GuillermoAladro/Alcoholimetro/historico/README.md

# Histórico

Documentos que ya no mandan. Se conservan porque tienen detalle que todavía sirve (hojas de datos leídas, respuestas a las auditorías, pruebas de banco) y porque otros documentos los citan.

| Documento | Qué era | Qué manda ahora |
|---|---|---|
| [MONTAJE-GENERAL.md](MONTAJE-GENERAL.md) | Cableado del diseño del 20-10-2026, con las figuras de [`montaje-general/`](../montaje-general/) | [CABLEADO.md](../CABLEADO.md) |
| [MONTAJE-PASO-A-PASO.md](MONTAJE-PASO-A-PASO.md) | Montaje por fases y pruebas de banco del diseño del 20-10-2026 | [CABLEADO.md](../CABLEADO.md) y la [revisión de componentes](../componentes/REVISION-13-11-2026.md), apartado 9. Sus pruebas siguen de referencia hasta que se rehaga sobre el diseño A |
| [LISTA-DE-COMPRA-20-10-2026.md](LISTA-DE-COMPRA-20-10-2026.md) | Lista de compra del diseño del 20-10-2026 | [LISTA-DE-COMPRA.md](../LISTA-DE-COMPRA.md) |

Movidos aquí el 13-11-2026 ([DECISIONES](../DECISIONES.md)).
