GuillermoAladro/Alcoholimetro/Animaciones 2D/revision/00032.2-revision.md

# 00032.2 · La guindilla

En los dos primeros mordiscos de Ander y en el último crujido, el tamaño de la guindilla y la posición de su mano cambian progresivamente. El rabito conserva la inclinación al quedar en el plato. Guillermo puede enseñar su guindilla y llevársela entera a la boca sin que se desprenda la mano del antebrazo.

El vaso de leche se ve desde el principio, delante de la manga de Ander. Se desliza por el borde delantero de la mesa, por delante del plato. La mano lo acelera y lo suelta sin el salto hacia atrás de unos 18 píxeles que se producía en el original. El vaso sigue con la velocidad que llevaba y se frena al llegar a Guillermo.

El pico de la jarra y el borde del vaso se apoyan en el labio. En el último trago de agua Guillermo inclina la cabeza para alcanzar el pico. Al devolver el vaso, acompaña el brazo con el torso y mantiene los pies apoyados. La secuencia de color de la cara, la llamarada, el bigote de leche y el último mordisco conservan el orden del guion. Se revisaron las poses con los dos avatares originales.

Las comprobaciones cubren 1.753 poses a 120 Hz, siete cambios de apoyo, los volúmenes de ambas bebidas y el giro de muñeca durante el trago. La vista previa tiene 876 fotogramas a 60 fps, en 1024 × 600, durante 14,6 segundos. Se probaron el rebobinado, las cadencias de reproducción, los extremos negros y la decodificación del MP4 completo. La reproducción se verificó en Canvas/Skia de Node. Quedan por probar los controles HTML en navegador y la Raspberry Pi física.
