GuillermoAladro/Alcoholimetro/carcasa/diseno-A/modelo/visor_plantilla.html

# Alcoholímetro · cajón de componentes

3D Frente Lado Arriba Detrás

## Mover

Sacar todoCerrar todo

Sacar cajón de pajitas ←0 mm

Abrir tapacerrada

Sacar tapa interior →puesta

Subir cajón de componentes ↑0 mm

## Transparencia

Carcasa transparente0 %

Cajón transparente0 %

Para sacar el cajón de componentes: se desenchufa, se abre la tapa, se saca la tapa interior deslizándola hacia la derecha por su ranura y se sueltan el puente de tierra y la antena. Para sacar el de pajitas se quitan antes los dos candados.

## Ver

Componentes eléctricos Cables y tubos Números de pieza Mostrar todo

Toca una pieza en el 3D o en la lista para ver su número, medidas, material y archivo de fabricación.
