GuillermoAladro/Alcoholimetro/carcasa/diseno-A/estudio-termico/Estudio_termico_alcoholimetro.pdf

ALCOHOLÍMETRO · DISEÑO A (COMPACTA) · REVISIÓN 2 · 13- 1 1 -2026

# Estudio térmico con el myPOS Sigma

## Qué cambia en el calor de la máquina al sustituir el SumUp Solo por un terminal de cobro para máquinas y pasar a una

fuente de 12 V.

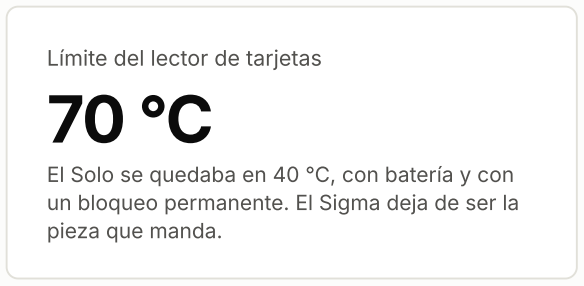
[picture p2: figure]
Límite del lector de tarjetas 70 °C; pieza que manda.

El Solo se quedaba en 40 °C, con batería y con un bloqueo permanente. El Sigma deja de ser la

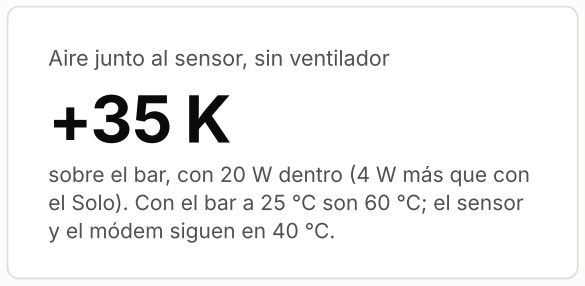
[picture p3: figure]
Aire junto al sensor, sin ventilador +35 K; y el módem siguen en 40 °C.

sobre el bar, con 20 W dentro (4 W más que con el Solo). Con el bar a 25 °C son 60 °C; el sensor

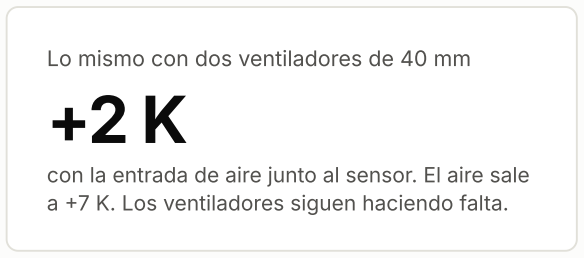
[picture p4: figure]
Lo mismo con dos ventiladores de 40 mm +2 K

con la entrada de aire junto al sensor. El aire sale a +7 K. Los ventiladores siguen haciendo falta.

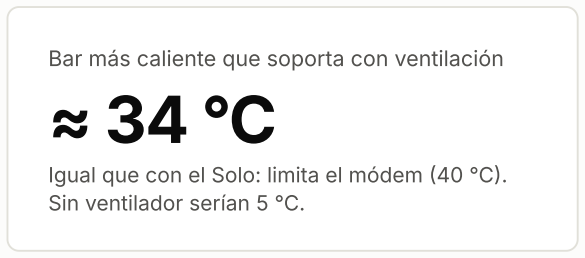
[picture p5: figure]
Sin ventilador serían 5 °C.

Bar más caliente que soporta con ventilación

Igual que con el Solo: limita el módem (40 °C).

Preparado para Guillermo Aladro Abad · cálculo de Claude sobre el CAD del 04-11-2026, las cargas de la revisión de componentes y la opción 3 del estudio de cobro (13-11-2026).
Todo es cálculo: no hay nada montado ni medido. El consumo del Sigma no está publicado y va estimado. Sustituye a la revisión 1 (con el Solo), que se conserva en historico-solo/.

Estudio térmico del alcoholímetro · diseño A · revisión 2 (myPOS Sigma) · 13-11-2026 | 2 / 35

# Resumen

Lectura que he tomado del encargo: rehacer el estudio térmico con lo que hablamos por voz, es decir, con el myPOS Sigma (la opción 3 del estudio de cobro) en lugar del SumUp Solo y con una fuente de 12 V. Como caso base pongo el Sigma en un hueco del frente, arriba a la derecha, una Mean Well LRS-50-12 en el sitio de la LRS-50-5 y un convertidor de 12 a 5 V para todo lo demás. El resto del diseño es el del CAD del 04-11-2026.

### Lo que sale del estudio

1. El Sigma quita de en medio la pieza más frágil. Trabaja de −20 a 70 °C, no lleva batería y no tiene el bloqueo permanente del Solo hoja . En ningún caso de este estudio se sale de su ficha.
2. Pero la máquina no se enfría: se calienta más. Pasa de 15,7 a 20 W. El Sigma es un terminal Android con pantalla propia y gasta unos 3 W estimación , frente a 1 W del Solo; y convertir de 12 a 5 V cuesta otros 2 W. En el mejor de los casos, con un Sigma de 1,5 W y la fuente que menos pierde, serían 16 W: lo mismo que con el Solo, no menos.
3. Dentro siguen dos piezas de 40 °C: el sensor y el módem. El sensor está arriba, a la misma altura que estaba el Solo. Sin ventilador, el aire a su lado queda a +35 K sobre el bar (entre +30 y +40 K en el 80 % de los casos); con el Solo eran +31 K.
4. Corrijo dos cosas que te adelanté por voz sin hacer la cuenta. Dije que el calor total apenas cambiaría y que, sin ventilación, el bar máximo subiría de 8 a unos 12 °C. Hecho el cálculo, el calor sube 4 W y el bar máximo sin ventilación baja de 8 a 5 °C. En el mejor caso serían 9 °C: prácticamente igual.
5. Los dos ventiladores de 40 mm siguen siendo imprescindibles, y siguen bastando. Con unos 5 m³/h reales el aire sale a +7,5 K (con el Solo, +6,3 K). El sensor ve +2 K y el módem +5 K. La máquina soporta bares de hasta unos 34 °C, lo mismo que con el Solo.
6. La entrada de aire cambia de sitio. Con el Solo iba arriba a la derecha, junto a él. Ahora el aire fresco hay que dárselo al sensor y al módem: entrada arriba a la izquierda, junto al sensor (apartado 8.3). El Sigma queda en la zona templada y le sobra margen.
7. Si la ventilación se para, el aire junto al sensor pasa de 40 °C en unos 9 minutos (bar a 25 °C) y se estabiliza en 59 °C. La diferencia es qué se pierde: con el Solo, un lector bloqueado para siempre; con el Sigma, nada irreversible. El sensor sale de su rango y la máquina debe dejar de vender pruebas hasta que baje.
8. La fuente se puede resolver de cuatro maneras y entre ellas hay menos de 2 W. La que menos calienta es dejar la LRS-50-5 como está y añadir una fuente pequeña de 12 V solo para el Sigma: 18,2 W en vez de
20,0 (apartado 3.2).
9. En el frente de hoy el Sigma no cabe de pie. Su marco mide 146 mm de alto y encima de la ventana de la pantalla quedan unos 120 mm. Tumbado cabe (101 mm). Es trabajo del bloque 3; para el calor da igual cómo vaya.
10. Nunca al sol directo, igual que antes. El Sigma lo aguantaría; la pantalla de 7″ (+46 K sobre el bar con ventiladores) y el sensor, no.

Estudio térmico del alcoholímetro · diseño A · revisión 2 (myPOS Sigma) · 13-11-2026 | 3 / 35

### Temperatura soportada, por configuración

Configuración (todas con el Sigma) | Calor dentro | Aire interior (media) | Aire junto al sensor | Aire junto al módem | Bar máximo con todo en ficha Pieza que limita
Sin ventilador (rejillas de hoy, cajón sin pintar) | 20,0 W | +29,7 K | +34,8 K | +30,8 K | 5 °C Sensor ZE29A
Sin ventilador, interior pintado | 20,0 W | +24,6 K | +28,8 K | +25,5 K | 11 °C Sensor ZE29A
1 ventilador de 40 × 10 mm | 20,7 W | +8,9 K | +2,7 K | +6,2 K | 33 °C Módem 4G
2 ventiladores de 40 × 10 mm | 20,7 W | +7,5 K | +2,2 K | +5,2 K | 34 °C Módem 4G
1 ventilador de 60 × 25 mm (no cabe en los laterales) | 21,4 W | +3,3 K | +1,0 K | +2,3 K | 37 °C Módem 4G

«Bar máximo» es la temperatura del aire del local con la que la primera pieza llega justo a su límite de ficha. Calentamientos cálculo con el modelo del apartado 5; límites hoja .

### Qué cambia respecto a la revisión 1, con el Solo

Punto | Con el SumUp Solo (revisión 1) | Con el myPOS Sigma (esta revisión)
Límite del lector | 0 a 40 °C; batería de litio; bloqueo permanente posible por calor | −20 a 70 °C; sin batería; se alimenta a 12–48 V
Calor dentro, sin ventiladores | 15,7 W | 20,0 W (de 15 a 27 W según lo que gaste el Sigma y el convertidor)
Sin ventilador: aire interior, media | +26,5 K | +29,7 K
Sin ventilador: aire junto a la pieza de 40 °C que está arriba | +31,1 K (Solo y sensor) | +34,8 K (sensor)
Sin ventilador: bar máximo con todo en ficha | 8 °C | 5 °C
Dos ventiladores: aire que sale | +6,3 K | +7,5 K
Dos ventiladores: entrada de aire | Arriba a la derecha, junto al Solo | Arriba a la izquierda, junto al sensor
Dos ventiladores: sensor y módem | +3,2 K y +5,4 K | +2,2 K y +5,2 K
Dos ventiladores: bar máximo con todo en ficha | 34 °C (limita el módem) | 34 °C (limita el módem)

Si se paran los dos ventiladores El Solo pasa de 40 °C en unos 12

| minutos y puede bloquearse para siempre | El sensor pasa de 40 °C en unos 9 minutos. Nada se rompe: se deja de vender hasta que baje
Vida a dos años | La batería del Solo, siempre cargada, es lo que antes envejece | Ya no hay batería. Mandan los condensadores de la fuente y la celda del sensor

Las dos columnas salen del mismo modelo y de las mismas cargas en 5 V. La de la izquierda repite los números de la revisión
1.

### Lo que haría, por orden

1. Mantener la decisión de la ventilación forzada. Cambiar el Solo por el Sigma no la ahorra.
2. Llevar al CAD el hueco del Sigma y la entrada de aire arriba a la izquierda, junto al sensor, y comprobar el fondo que queda detrás del terminal (apartados 2.3 y 8.3).
3. Poner la sonda de temperatura junto al sensor, no junto al lector, y que el programa deje de vender pruebas a 40 °C (apartado 13).

Estudio térmico del alcoholímetro · diseño A · revisión 2 (myPOS Sigma) · 13-11-2026 | 4 / 35
4. Medir en el banco lo que gasta el Sigma en reposo, con un vatímetro o una pinza en sus 12 V. Es la incógnita nueva: entre 1,5 y 6 W cambian 6 K sin ventilador.
5. Decidir la fuente con el bloque 1 delante. Por calor, la mejor es dejar los 5 V como están y dar los 12 V al Sigma con una fuente pequeña aparte.
6. Pintar el cajón y el interior de la carcasa: 6 K menos el día que falle la ventilación.

### Contenido

1 Alcance y método
2 El diseño visto como problema térmico 3 Cuánto calor hay que sacar
4 Qué temperatura aguanta cada pieza 5 Modelo de cálculo
6 Resultados sin ventilador
7 ¿Se arregla sin ventilador?
8 Ventilación forzada
9 Temperatura de cada pieza y del bar

10 Arranque, averías y cortes de luz 11 Sol, funda y frío
12 Calor y vida útil
13 Cambios recomendados
14 Plan de ensayo
15 Conclusiones
A Anexo: parámetros del modelo B Anexo: cómo repetir el cálculo Fuentes

# 1 Alcance y método

### 1.1 Qué versión he estudiado

Carcasa: diseño A (Compacta) del 04-11-2026, tal como lo generan los scripts de carcasa/diseno-A/modelo/: 220 × 100 × 442,5 mm, carcasa de chapa de 3 mm, cajón de componentes y tapa interior de 1,5 mm, dos policarbonatos de 5 mm en el frente y antena por dentro.
Cobro: myPOS Sigma, la opción 3 del estudio de alternativas de cobro del 13-11-2026, en lugar del SumUp Solo. Va en un hueco del frente con su cara al bar, no detrás del policarbonato. No está en el CAD ni en DECISIONES.md: es lo que planeas hacer, y lo calculo como si ya estuviera.
Fuente: una Mean Well LRS-50-12 (12 V) en el sitio de la LRS-50-5, que mide lo mismo, y un convertidor de 12 a 5 V para la Pi, la pantalla, el módem, el sensor y los ventiladores supuesto . En el apartado 3.2 comparo las otras tres formas de dar los 12 V.
Resto de la electrónica: las cargas en 5 V de la revisión de componentes (Bloque 1, 13-11-2026), sin el Solo. Acabado: carcasa con pintura en polvo por fuera. Del cajón de componentes ningún documento dice el acabado; como caso base lo tomo sin pintar o galvanizado supuesto , que es el peor para el calor, y calculo también el caso pintado.

### 1.2 Qué he hecho

1. Reunir los datos del Sigma que importan para el calor: medidas, hueco, alimentación y rango de temperatura hoja . Su consumo no está publicado.
2. Rehacer el inventario del calor: sale el Solo, entran el Sigma, la fuente de 12 V y el convertidor.
3. Añadir el terminal al modelo de la revisión 1 como un nodo más (58 en total): recibe sus vatios, da calor al aire del cajón por detrás y al bar por su cara.
4. Volver a resolver todos los casos: sin ventilador, pintado, con uno y dos ventiladores, averías, suciedad, arranque, corte de luz, sol, funda y frío.
5. Repetir los 1 500 casos al azar por configuración y la sensibilidad a cada parámetro, con el consumo del Sigma y el rendimiento del convertidor entre las incógnitas.
6. Recalcular con el mismo modelo la versión del Solo, para comparar las dos sin cambiar de regla.
7. Mirar en las cotas del CAD si el Sigma y la nueva entrada de aire caben.

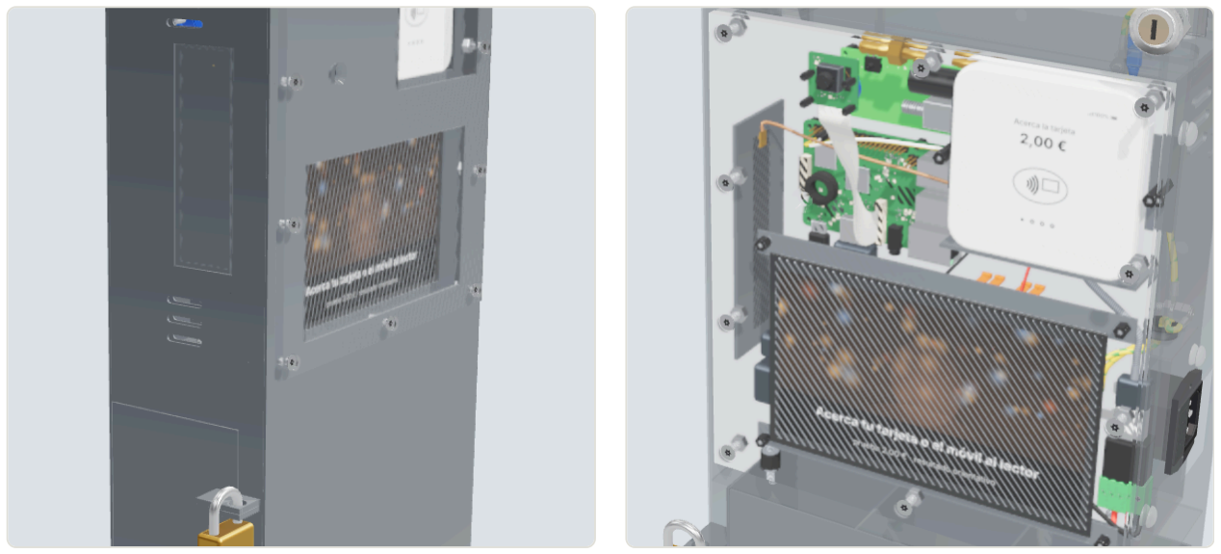
[picture p6: figure]

Estudio térmico del alcoholímetro · diseño A · revisión 2 (myPOS Sigma) · 13-11-2026 | 5 / 35

### 1.3 Cómo leer las cifras

hoja leído en la hoja de datos, en la ficha del repositorio o en la web del fabricante.
cálculo sale del modelo o de una cuenta que está en el informe. Se puede repetir con los scripts del anexo
B.
estimación cifra razonada, sin dato de fabricante.
supuesto lo doy por cierto sin poder comprobarlo.
dato general valor de manual o de práctica habitual.

Las diferencias de temperatura van en kelvin (K), que valen lo mismo que los grados: +10 K sobre un bar a 25 °C son 35 °C.

Lo que este estudio no es
No es una medida. El modelo acierta el orden de magnitud y el sentido de cada cambio. En el calentamiento sin ventilador la horquilla razonable es de ±5 K.
La potencia no está medida, y la del Sigma ni siquiera está publicada. Los 3 W que le pongo salen de lo que gasta un terminal de su clase. Sin ventilador, cada vatio de más son 1,5 K junto al sensor.
No hay plano del Sigma. myPOS publica las medidas exteriores y el hueco, no cuánto entra por detrás del panel. Lo estimo en unos 30 mm dentro del cajón.
No es una simulación de fluidos. El aire interior es un solo nodo con un reparto en altura supuesto. Los puntos calientes locales, como el chip de la Pi, van estimados aparte.

# 2 El diseño visto como problema térmico

Figura 1. El diseño A según el CAD del repositorio, que todavía lleva el Solo. A la izquierda, por fuera: en el lateral izquierdo se ven las dos rejillas de tres ranuras, los agujeros del escape del soplido y la ventana de la antena. A la derecha, el frente con el policarbonato: pantalla, Solo, cámara y, detrás, la Pi y el sensor. El Sigma iría donde está el Solo, atravesando el frente.

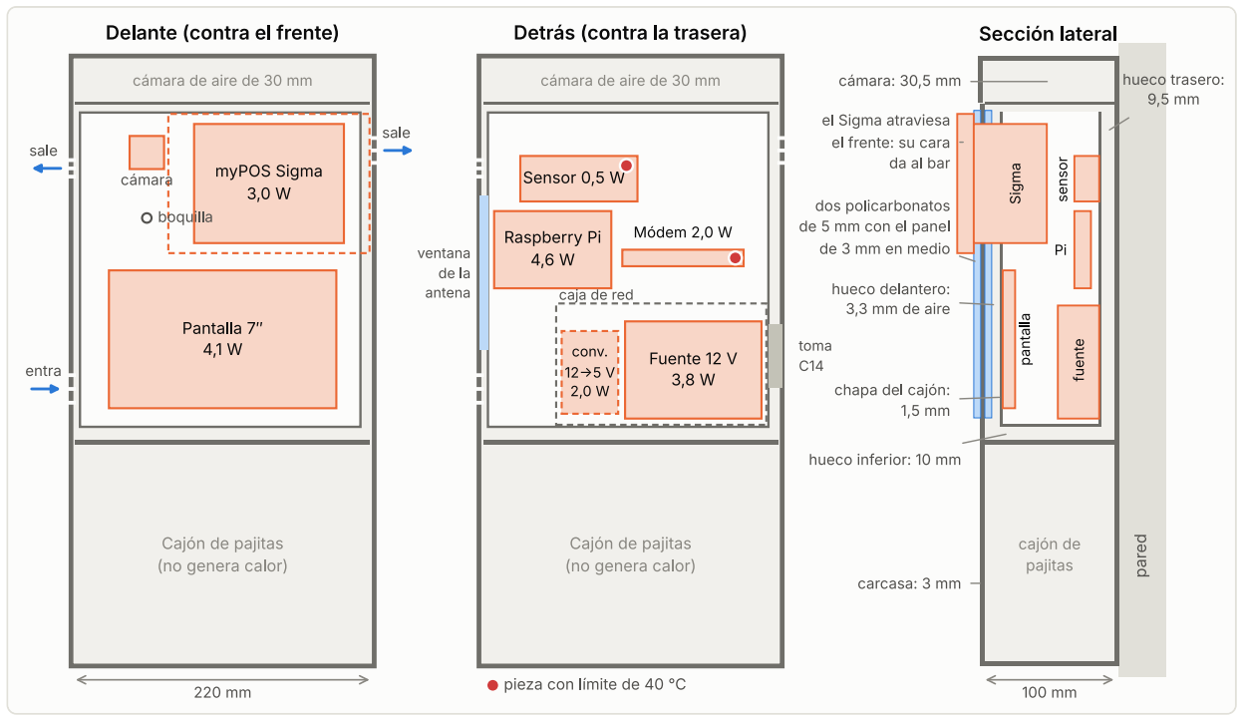
[picture p7: figure]

Estudio térmico del alcoholímetro · diseño A · revisión 2 (myPOS Sigma) · 13-11-2026 | 6 / 35

Figura 2. Lo que hay dentro y dónde, con el Sigma. Los rectángulos naranjas son las piezas que disipan, con su potencia de cálculo; el punto rojo marca las que tienen el límite en 40 °C. El Sigma va dibujado tumbado (en línea de trazos, su marco) y el convertidor, en un sitio supuesto de la caja de red. Las flechas azules son las rejillas actuales. A escala con las cotas del CAD.

### 2.1 Geometría que manda en el calor

Elemento | Medida | Por qué importa
Carcasa exterior | 220 × 100 × 442,5 mm, acero de 3 mm | Es la superficie que da calor al bar
Zona de componentes | Los 282 mm de arriba (desde la bandeja) | Todo el calor se genera aquí, en unos 3 litros de aire
Cajón de componentes | 203,5 × 73 × 228 mm, acero de 1,5 mm, abierto por arriba; 70 mm de fondo útil | Segunda pared entre la electrónica y la carcasa
Huecos cajón– carcasa | 3,5 mm (izquierda), 7 mm (derecha), 9,5 mm (detrás), 10 mm (debajo) | Capas de aire quieto: aíslan
Frente | Policarbonato de 5 mm + panel de 3 mm + policarbonato de 5 mm + 3,3 mm de aire | La cara más grande y despejada es la que peor conduce
Ventana de la pantalla | 159 × 91 mm: 145 cm² | Ahí no hay acero: policarbonato, aire y policarbonato
myPOS Sigma | 146 × 101 × 57 mm y 490 g; hueco de 108,7 × 86,4 mm hoja | Atraviesa el frente. Su cara, de 147 cm², da al bar sin policarbonato delante: es un camino de calor nuevo
Techo | Tapa interior de 1,5 mm, cámara de aire de 30,5 mm y tapa de 3 mm | Otra doble pared, justo encima de lo más caliente
Trasera | 220 × 440 mm contra la pared, con 18 tirafondos | No ve el aire; el calor sale por la pared
Rejillas | 3 rejillas de 3 ranuras de 22 × 4 mm: 2,5 cm² cada una, en la carcasa y repetidas en el cajón | Único paso de aire. Entrada a 201 mm de la base; salidas a 361 y 374 mm
Zona del cajón de pajitas | Los 160 mm de abajo, sin fuentes de calor | Hace de aleta: la chapa conduce calor hacia abajo y lo suelta

Medidas hoja del CAD (diseno.py, specs.py y geo.py) y de la ficha de myPOS.

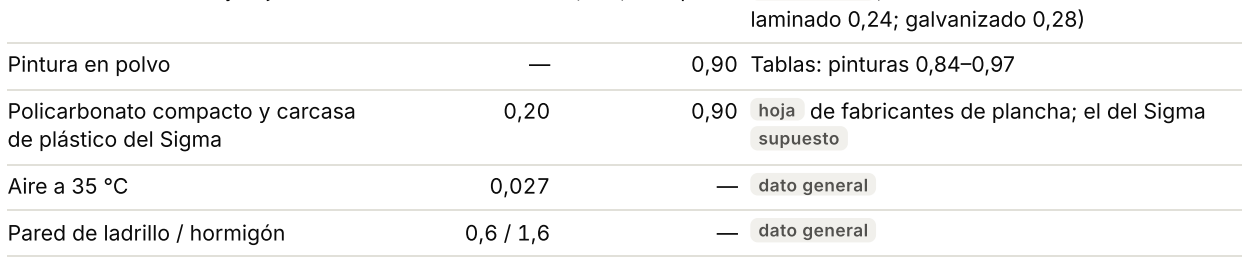
[picture p8: figure]
laminado 0,24; galvanizado 0,28); Pintura en polvo; 0,90 Tablas: pinturas 0,84–0,97; Policarbonato compacto y carcasa de plástico del Sigma; supuesto; Aire a 35 °C; — dato general; Pared de ladrillo / hormigón

Estudio térmico del alcoholímetro · diseño A · revisión 2 (myPOS Sigma) · 13-11-2026 | 7 / 35

### 2.2 Cinco rasgos que explican el resultado

1. Doble pared. El calor tiene que pasar del aire interior a la chapa del cajón, cruzar un hueco de aire y llegar a la carcasa antes de salir al bar. Son tres saltos de temperatura en serie donde un armario normal tiene uno.
2. Frente aislado, con una excepción nueva. El doble policarbonato deja pasar unos 3,4 W/m²K, frente a los 9 W/m²K de una chapa pintada al aire cálculo . El Sigma es lo único que cruza el frente: por su cara salen 2,9 W sin ventilador, casi tanto como gasta.
3. Lo delicado, arriba y a la izquierda. El sensor (40 °C) está en el tercio superior del cajón, detrás y a la izquierda. El módem (40 °C), a media altura, detrás. La Pi (50 °C), debajo del sensor. A la derecha quedan el Sigma y la fuente, que aguantan 70 °C.
4. Rejillas simbólicas. Tres ranuras de 22 × 4 mm en dos chapas seguidas dejan pasar 0,23 m³/h por tiro natural cálculo . Sacan 2,8 W de los 20.
5. Cajón sin acabado definido. Una chapa galvanizada o sin pintar emite y absorbe poca radiación (emisividad 0,2–0,3 frente a 0,9 de una pintada dato general ). En huecos tan estrechos, con las chapas pintadas la radiación lleva más de la mitad del calor; sin pintar, apenas un tercio.

### 2.3 Dónde cabe el Sigma

No es el objeto de este estudio, pero al situarlo para el cálculo salen tres cosas que el bloque 3 tiene que resolver:

Punto | Qué sale de las cotas | Consecuencia
De pie no cabe | El marco mide 146 mm de alto. Entre el borde de la ventana de la pantalla (a 282,5 mm de la base) y el borde de arriba de los policarbonatos (403 mm) hay 120 mm | O va tumbado (101 mm de alto, 146 de ancho), o baja la pantalla, o crece el frente. Así lo dibujo: tumbado, arriba a la derecha
El hueco crece | La ventana del Solo es de 85 × 85 mm en el panel y 81 × 81 mm en el cajón. El Sigma pide 108,7 × 86,4 mm | Hueco nuevo en el panel, en los dos policarbonatos y en el frente del cajón. Tumbado y arrimado al borde derecho, su marco queda a unos 10 mm de la boquilla
El fondo es justo | El Sigma tiene 57 mm de fondo total y el cajón, 70 mm útiles. Detrás, a esa altura, van el módem y un extremo de la Pi | Hay que comprobar con el aparato en la mano cuánto entra y cuánto piden sus conectores estimación . Si no cabe, el módem se va al montaje tras la ventana de la antena, que además le conviene (apartado 8.3)

Para el calor, que el Sigma vaya de pie o tumbado no cambia nada apreciable: cuentan su potencia, que su cara dé al bar y a qué altura queda.

### 2.4 Materiales

Material

Conductividad
W/m·K | Emisividad Origen
Acero DC01 (carcasa y cajón) | 50 0,2–0,3 sin pintar dato general ; emisividad de tablas (acero
0,20 | 0,90 | hoja de fabricantes de plancha; el del Sigma

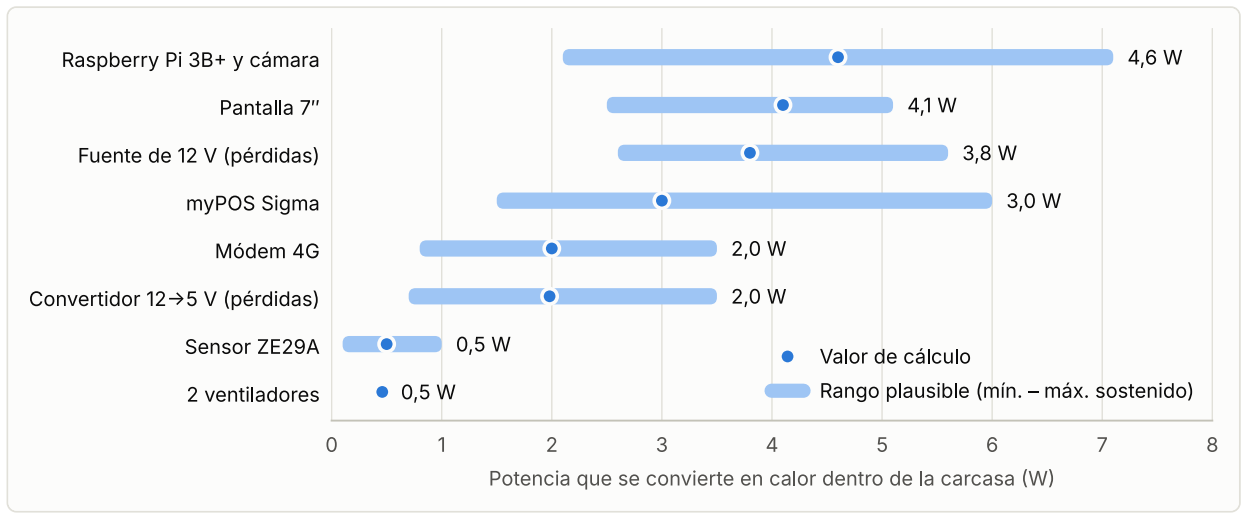
[picture p9: figure]

Estudio térmico del alcoholímetro · diseño A · revisión 2 (myPOS Sigma) · 13-11-2026 | 8 / 35

# 3 Cuánto calor hay que sacar

Todo lo que entra por el enchufe acaba como calor. Casi todo se queda dentro de la carcasa; una parte del que genera el Sigma sale directa al bar por su cara. Con el Sigma y la fuente de 12 V entran 20 W; con el Solo eran 15,7.

Figura 3. Calor que deja cada pieza. El punto es el valor de cálculo; la barra, lo que cabe esperar entre un reposo tranquilo y una carga alta sostenida. El Sigma tiene la barra más larga porque su consumo no está publicado.

### 3.1 Pieza a pieza

Pieza | Mínimo Cálculo Máximo De dónde sale

Raspberry Pi 3B+ y
cámara
| 2,1 W | 4,6 W | 7,1 W Raspberry Pi mide 1,9 W en reposo y 5,8 W a plena carga hoja . Reproducir vídeo queda entre los dos estimación
Pantalla de 7″ | 2,5 W | 4,1 W | 5,1 W 5 W según el anuncio; paneles parecidos, 2,4–2,6 W. Depende del brillo
Fuente de 12 V (pérdidas) | 2,6 W | 3,8 W | 5,6 W LRS-50-12: 86 % a plena carga hoja ; al 32 % de carga, 81 % estimación
myPOS Sigma | 1,5 W | 3,0 W | 6,0 W Sin dato de fabricante estimación . Es un terminal Android con pantalla de 5″, lector sin contacto y 4G. Un terminal de la misma clase, el PAX IM30, declara menos de 0,65 A a 12 V de pico, unos 8 W hoja
Módem 4G | 0,8 W | 2,0 W | 3,5 W Menos de 3,5 W hoja . Sube con mala cobertura
Convertidor de 12 a 5 V (pérdidas) | 0,7 W | 2,0 W | 3,5 W Mean Well RSD-30G-5, de 9–36 V a 5 V y 6 A: 84–85 % hoja . Un reductor no aislado llega al 90–93 % dato general
Sensor ZE29A | 0,1 W | 0,5 W | 1,0 W Menos de 500 mA de pico hoja ; reposo estimación
Dos ventiladores | 0,4 W | 0,5 W | 0,5 W 0,22 W típicos cada uno hoja

Total sin
ventiladores

≈ 15 W 20,0 W ≈ 27 W Suma, con la cadena de abajo

Total con dos ventiladores | | 20,7 W

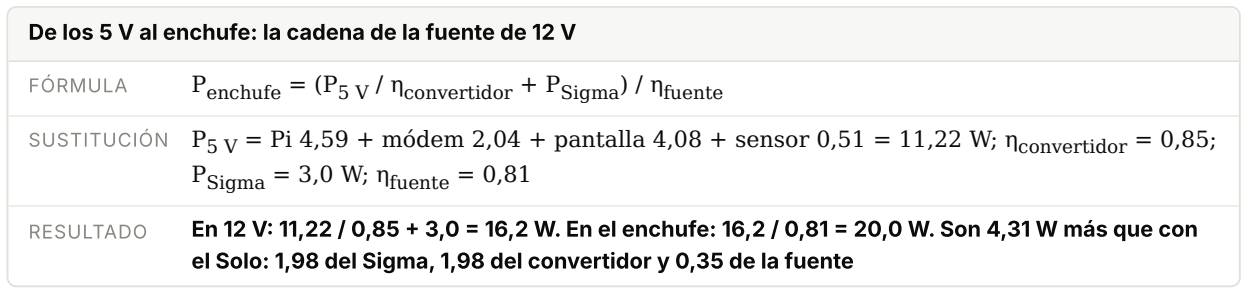
[picture p10: figure]
) / ηfuente; PSigma = 3,0 W; ηfuente = 0,81

Estudio térmico del alcoholímetro · diseño A · revisión 2 (myPOS Sigma) · 13-11-2026 | 9 / 35

De los 5 V al enchufe: la cadena de la fuente de 12 V

FÓRMULA | Penchufe = (P5 V / ηconvertidor + PSigma

SUSTITUCIÓN P5 V = Pi 4,59 + módem 2,04 + pantalla 4,08 + sensor 0,51 = 11,22 W; ηconvertidor = 0,85;

RESULTADO En 12 V: 11,22 / 0,85 + 3,0 = 16,2 W. En el enchufe: 16,2 / 0,81 = 20,0 W. Son 4,31 W más que con el Solo: 1,98 del Sigma, 1,98 del convertidor y 0,35 de la fuente

### 3.2 Qué fuente calienta menos

«Una fuente de 12 V» se puede montar de cuatro maneras. Para el calor cuentan las pérdidas de conversión:

Opción | Calor dentro

Sin ventilador:
junto al sensor

Dos ventiladores:
aire que sale Comentario

LRS-50-12 y
convertidor de 12 a 5 V
(caso base)
20,0 W | +34,8 K | +7,5 K Una sola fuente de red. Toda la parte de 5 V pasa por el convertidor, incluida la rama de la Pi que el Bloque 1 afinó

LRS-50-5, como hoy, y
una fuente pequeña de
12 V solo para el Sigma
18,2 W | +32,6 K | +6,9 K La que menos calienta y la que no toca los 5
V. Pide sitio y un fusible más en la caja de red

LRS-50-5 y un elevador
de 5 a 12 V para el
Sigma
18,8 W | +33,2 K | +7,1 K El cambio más pequeño: un módulo en la rama que hoy alimenta al Solo

Fuente de dos salidas
Mean Well RD-50A (5 V
y 12 V)
19,0 W | +33,5 K | +7,2 K Rinde un 78–79 % a plena carga y pide un mínimo de 0,3 A en cada salida hoja : el Sigma en reposo puede quedarse por debajo. Mide 99 × 97 × 36 mm, más que la LRS-50

Entre la mejor y la peor hay 1,8 W: 2 K sin ventilador y 0,6 K con ventiladores. La fuente se elige por fiabilidad, sitio y cableado; el calor solo desempata.
Sigo con la LRS-50-12 y el convertidor como caso base porque es lo que hablamos y porque es el caso más caliente de los cuatro: lo que cumpla con él cumple con los demás.
Rendimientos a carga parcial estimación : la hoja solo da el de plena carga, y a un tercio de la carga una fuente conmutada pierde unos 5 puntos.

### 3.3 Lo que hay que medir

El Sigma en reposo, lo primero. Entre 1,5 y 6 W, el aire junto al sensor sin ventilador va de +33 a +39 K, y con ventiladores el aire sale entre +7,0 y +8,5 K. Se mide con una pinza o un medidor en línea en sus 12 V. El terminal sabe dormirse. El Nexgo UN20, del que el Sigma parece ser la versión de myPOS (mismas medidas, hueco, alimentación y puertos), lleva sensores de proximidad y de luz que lo despiertan cuando alguien se acerca hoja . Si la app de myPOS lo aprovecha, el consumo medio estará en la parte baja del rango.
El total, con un vatímetro de enchufe. Con esa cifra, la figura 9 da el calentamiento sin más cuentas.
La Pi, la pantalla y las dos conversiones suman tres cuartas partes del calor, y todas están por debajo del sensor.

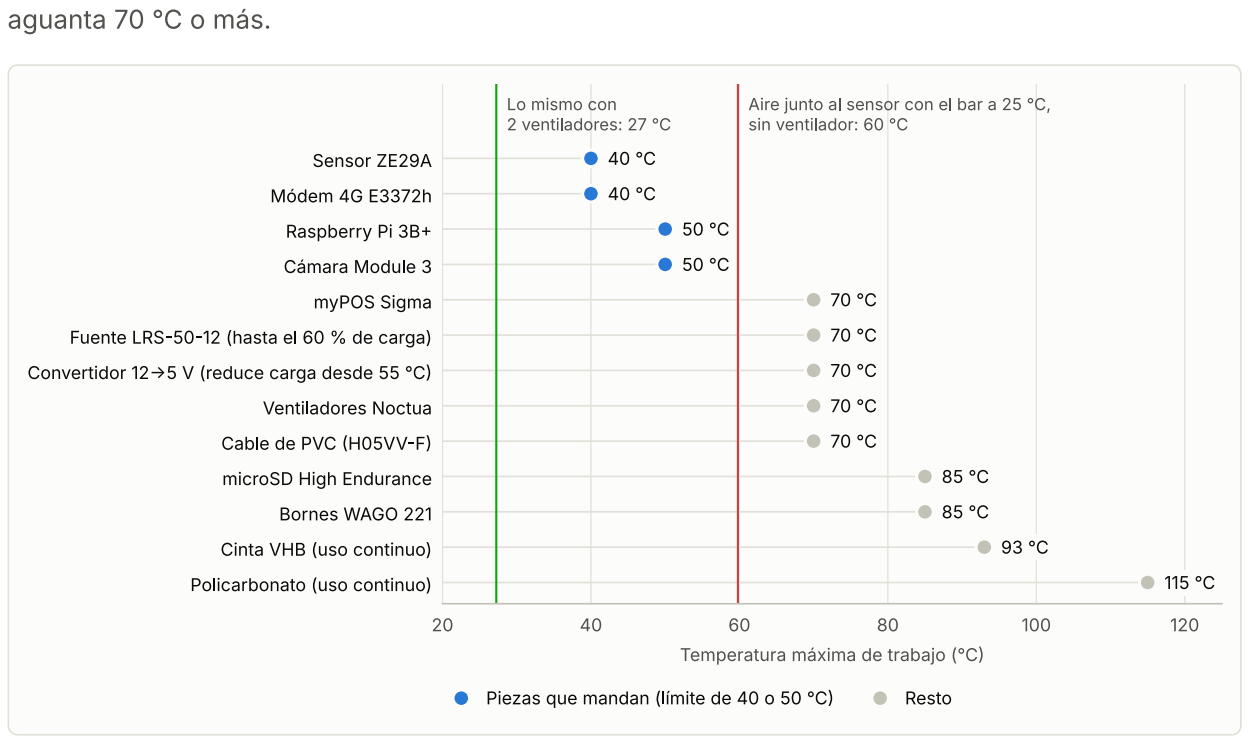
[picture p11: figure]
aguanta 70 °C o más.
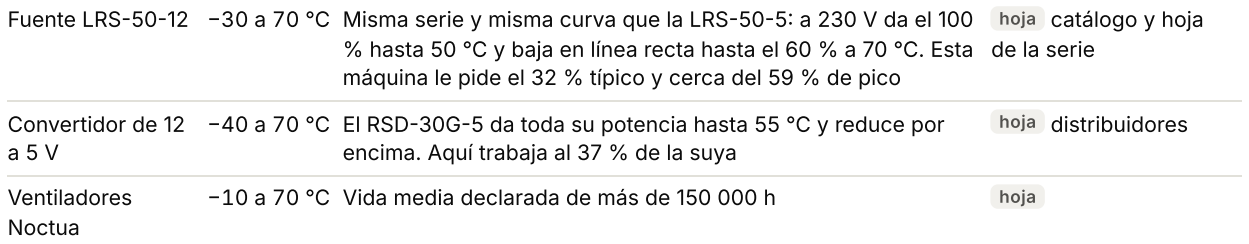
[picture p12: figure]
hoja catálogo y hoja de la serie; Convertidor de 12 a 5 V; encima. Aquí trabaja al 37 % de la suya; hoja distribuidores; Ventiladores Noctua

Estudio térmico del alcoholímetro · diseño A · revisión 2 (myPOS Sigma) · 13-11-2026 | 10 / 35

# 4 Qué temperatura aguanta cada pieza

Siguen los tres escalones, con una pieza menos en el primero: dos que no pueden pasar de 40 °C (sensor y módem), dos de 50 °C (Pi y cámara) y todo lo demás, ahora también el lector, que

Figura 4. Temperatura máxima de trabajo de cada pieza, según su hoja o su ficha. Las dos líneas verticales son la temperatura del aire junto al sensor que da el modelo con el bar a 25 °C.

Pieza | Trabajo | Qué pasa si se sale | Origen
myPOS Sigma | − | 20 a 70 °C Guardado, de −30 a 80 °C; humedad del 10 al 95 % sin
| | condensar; IP65 e IK08. Sin batería. Una tienda húngara lo cataloga como «interior, 10–40 °C»: conviene que myPOS confirme el rango por escrito al comprarlo | hoja ficha de myPOS; coincide con la del Nexgo UN20
Sensor ZE29A | 10 a 40 °C Fuera de rango la lectura deja de estar garantizada. El calor
| | acorta la vida de la celda electroquímica. Por abajo también tiene límite: 10 °C | hoja manual V1.1

Módem 4G
E3372h

− 10 a 40 °C Reinicios y caídas de conexión. Él mismo disipa hasta 3,5 W en un cuerpo muy pequeño

hoja ficha de Huawei

Raspberry Pi 3B+ | 0 a 50 °C | El procesador baja de 1,4 a 1,2 GHz al llegar a 60 °C y recorta más a partir de 80 °C. No se rompe, pero va lenta | hoja ficha de producto
Cámara Module 3 | 0 a 50 °C | Ruido en la imagen y enfoque menos fiable | hoja ficha de producto
Pantalla GeeekPi de 7″ | sin dato | El fabricante no publica la temperatura. Paneles parecidos dan 0–60 °C o −20–70 °C. Tomo 50 °C supuesto | Ficha del repositorio
Fuente LRS-50-12 − | 30 a 70 °C Misma serie y misma curva que la LRS-50-5: a 230 V da el 100
| | % hasta 50 °C y baja en línea recta hasta el 60 % a 70 °C. Esta máquina le pide el 32 % típico y cerca del 59 % de pico
− | 40 a 70 °C El RSD-30G-5 da toda su potencia hasta 55 °C y reduce por
− | 10 a 70 °C Vida media declarada de más de 150 000 h | hoja

Estudio térmico del alcoholímetro · diseño A · revisión 2 (myPOS Sigma) · 13-11-2026 | 11 / 35
Pieza | Trabajo | Qué pasa si se sale | Origen

microSD, bornes
WAGO, cable de
PVC
70 a 85 °C Ver la figura. No limitan | hoja y dato general

Lo que desaparece con el Solo
El límite de 40 °C del lector y el aviso de SumUp de que su bloqueo antimanipulación, que es permanente, puede saltar por calor.
La batería de litio siempre cargada, que a 60 °C se agota en meses y puede hincharse.
La prueba del pago a través del policarbonato y el arranque del lector tras un corte, que eran riesgos del Bloque 1 ajenos al calor.

### 4.1 La carcasa y los materiales

Material | Aguanta | Origen
Acero y pintura en polvo | Muy por encima de 100 °C. La pintura se cura a 180–200 °C | dato general
Policarbonato de 5 mm y de 2 mm | 115 °C en uso continuo y 135 °C en ratos cortos. Se deforma con carga a 135 °C | hoja de plancha extruida
Cinta VHB de la ventana de la antena | 93 °C a largo plazo y 149 °C en ratos cortos | hoja de 3M
Silentblocks, topes de goma, separadores de nailon, tubo de silicona | 70 °C o más | dato general

Conclusión: por temperatura, la estructura no es el problema en ningún caso de este estudio. El caso más caliente que calculo, con sol directo y el bar a 25 °C, deja la chapa a 52 °C.

### 4.2 Al tacto

La chapa exterior se queda a +8 K sobre el bar de media y a +11 K en su punto más caliente cálculo . Con el bar a 30 °C son 41 °C como mucho, y con ventiladores, 35 °C.
Por debajo de 44 °C un metal no quema aunque se toque durante horas, según los datos que recogen ASTM C1055 e ISO 13732-1. No hay riesgo de quemadura, salvo con sol directo (apartado 11).
La cara del Sigma, que es lo que toca el cliente, queda unos 13 K sobre el bar con ventiladores, templada, y unos 22 K sin ellos, caliente al tacto sin llegar a quemar estimación .
Consecuencia práctica: tocar la chapa por fuera no dice nada de lo que pasa dentro. Con el interior a 55 °C, la chapa está apenas templada.

# 5 Modelo de cálculo

Es el modelo de la revisión 1 con un nodo más. Una red de resistencias térmicas: cada chapa y cada masa de aire es un nodo con su temperatura, y entre nodos pasa calor por convección, radiación o conducción. Se resuelve el equilibrio de los 58 nodos a la vez.

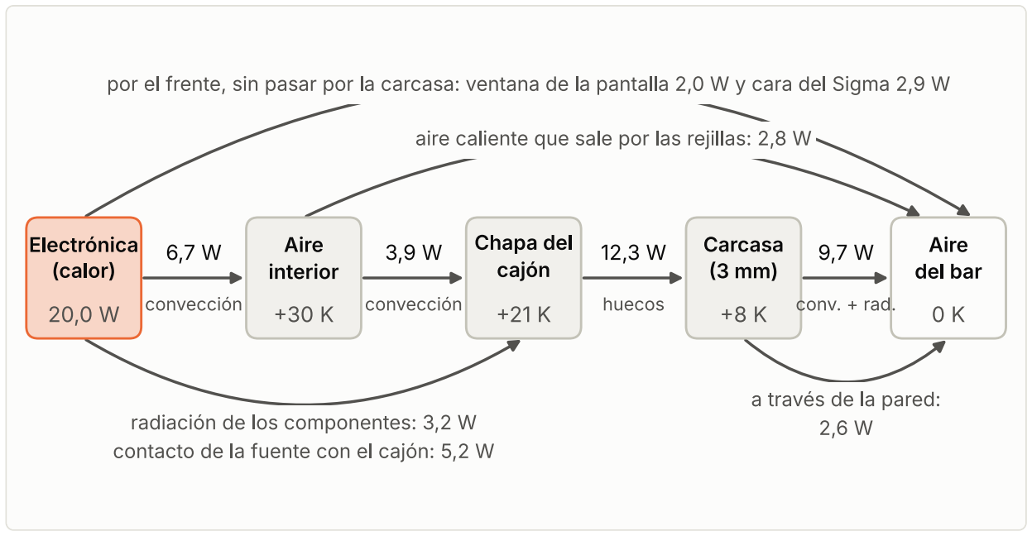
[picture p13: figure]
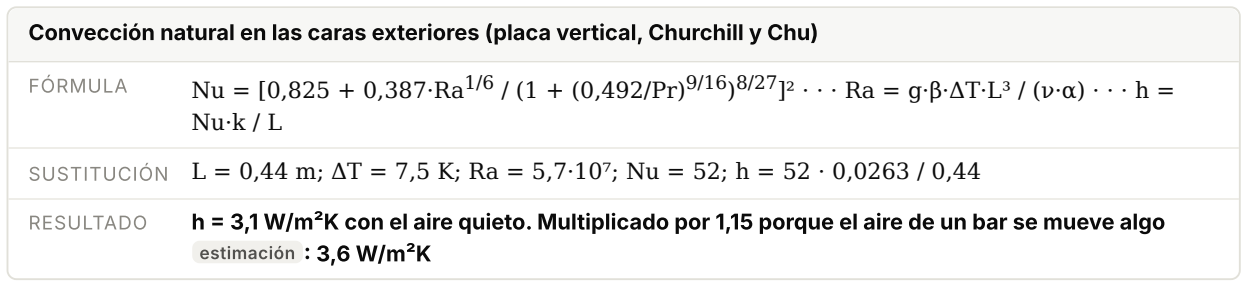
[picture p14: figure]
FÓRMULA; estimación : 3,6 W/m²K
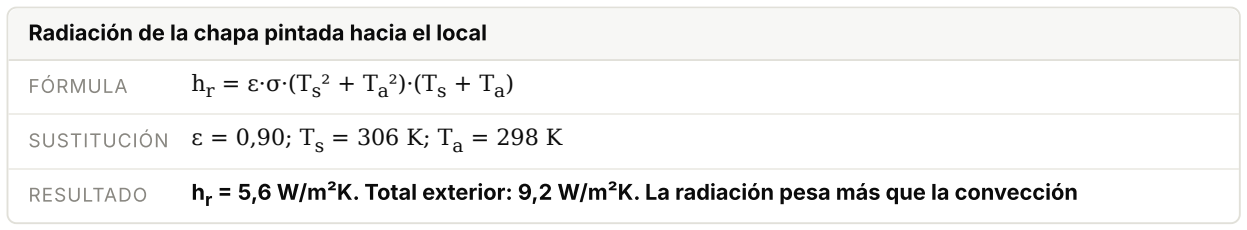
[picture p15: figure]
FÓRMULA

Estudio térmico del alcoholímetro · diseño A · revisión 2 (myPOS Sigma) · 13-11-2026 | 12 / 35

Figura 5. El camino del calor sin ventilador, con el resultado del caso base (bar a 25 °C, 20,0 W). Cada caja es un grupo de nodos con su calentamiento sobre el bar; sobre cada flecha, los vatios que pasan.

### 5.1 Qué nodos tiene

Dentro: el aire interior, las piezas que disipan (un nodo), la pantalla y la fuente con el convertidor y su caja de red.
El terminal: un nodo propio. Recibe sus 3 W, cede calor al aire del cajón por su parte trasera y al bar por su cara, y radia hacia las paredes del cajón.
Cajón de componentes: frente, laterales, trasera, base y la tapa interior, cada uno con su temperatura. Carcasa: cada una de las cuatro caras partida en 11 franjas de 40 mm de alto, más la tapa, el suelo y la bandeja. Así el modelo ve cómo baja el calor por la chapa hacia la zona del cajón de pajitas.
Fuera: el aire del bar y la pared.

### 5.2 Los coeficientes, paso a paso

Convección natural en las caras exteriores (placa vertical, Churchill y Chu)

]² · · · Ra = g·β·ΔT·L³ / (ν·α) · · · h =

SUSTITUCIÓN L = 0,44 m; ΔT = 7,5 K; Ra = 5,7·10⁷; Nu = 52; h = 52 · 0,0263 / 0,44

RESULTADO h = 3,1 W/m²K con el aire quieto. Multiplicado por 1,15 porque el aire de un bar se mueve algo

Radiación de la chapa pintada hacia el local

SUSTITUCIÓN ε = 0,90; Ts = 306 K; Ta = 298 K

RESULTADO hr = 5,6 W/m²K. Total exterior: 9,2 W/m²K. La radiación pesa más que la convección

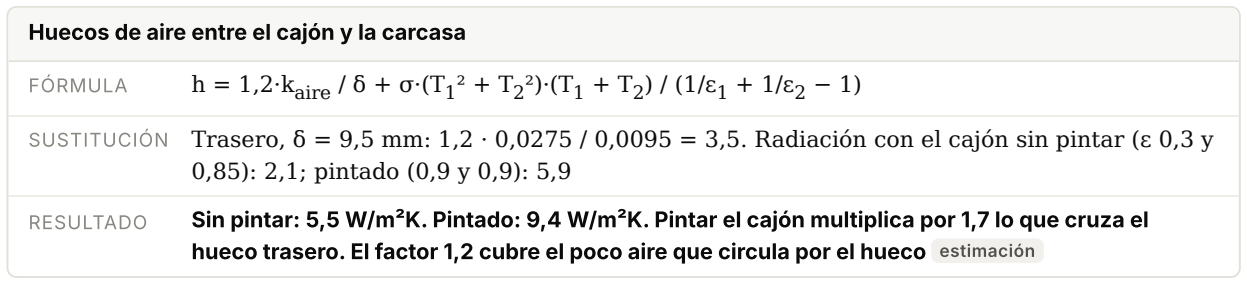
[picture p16: figure]
FÓRMULA; h = 1,2·kaire; 0,85): 2,1; pintado (0,9 y 0,9): 5,9
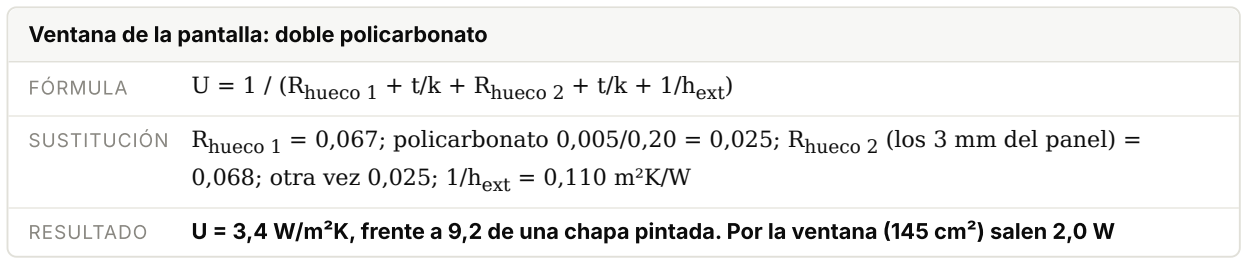
[picture p17: figure]
(los 3 mm del panel) =
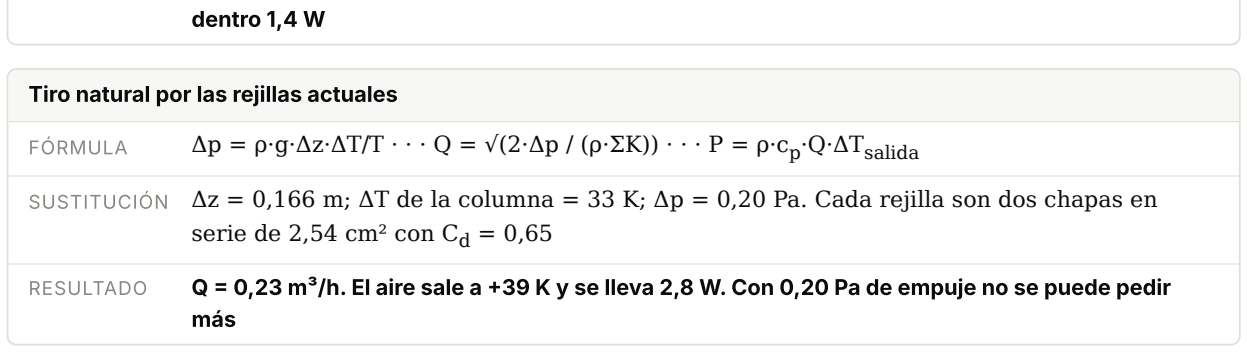
[picture p18: figure]
dentro 1,4 W; Tiro natural por las rejillas actuales; ·Q·ΔTsalida; serie de 2,54 cm² con Cd = 0,65; más
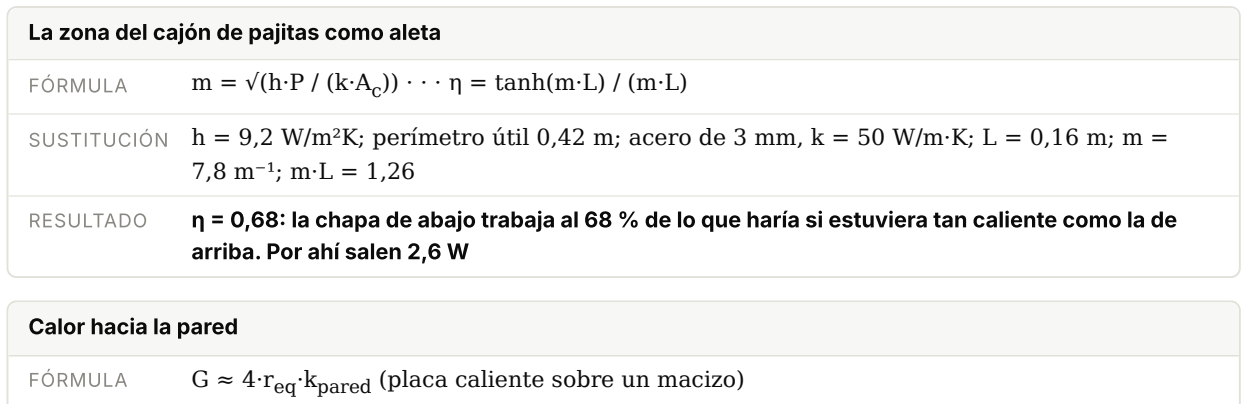
[picture p19: figure]
La zona del cajón de pajitas como aleta; FÓRMULA; )) · · · η = tanh(m·L) / (m·L); arriba. Por ahí salen 2,6 W; Calor hacia la pared; G ≈ 4·req; ·kpared; (placa caliente sobre un macizo)
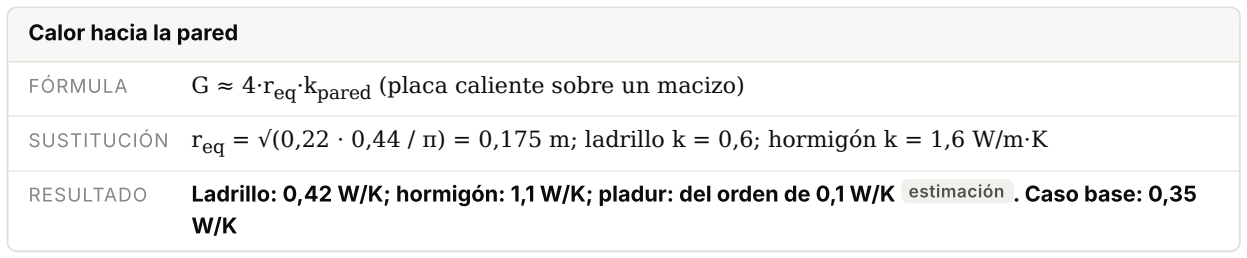
[picture p20: figure]

Estudio térmico del alcoholímetro · diseño A · revisión 2 (myPOS Sigma) · 13-11-2026 | 13 / 35

Huecos de aire entre el cajón y la carcasa

SUSTITUCIÓN Trasero, δ = 9,5 mm: 1,2 · 0,0275 / 0,0095 = 3,5. Radiación con el cajón sin pintar (ε 0,3 y

RESULTADO Sin pintar: 5,5 W/m²K. Pintado: 9,4 W/m²K. Pintar el cajón multiplica por 1,7 lo que cruza el hueco trasero. El factor 1,2 cubre el poco aire que circula por el hueco estimación

Ventana de la pantalla: doble policarbonato

FÓRMULA | U = 1 / (Rhueco 1 + t/k + Rhueco 2 + t/k + 1/hext

SUSTITUCIÓN Rhueco 1 = 0,067; policarbonato 0,005/0,20 = 0,025; Rhueco 2
| 0,068; otra vez 0,025; 1/hext = 0,110 m²K/W
RESULTADO | U = 3,4 W/m²K, frente a 9,2 de una chapa pintada. Por la ventana (145 cm²) salen 2,0 W

El terminal: cuánto de su calor sale por su cara y cuánto se queda dentro

FÓRMULA G = A / (Rint + 1/h) por cada lado · · · ΔTSigma ≈ (P + Gdentro ·ΔTaire ) / (Gdentro + Gfuera ) · · · Pfuera = Gfuera ·ΔTSigma

SUSTITUCIÓN Cara al bar: 146 × 101 mm = 147 cm², h = 9,1 W/m²K. Cuerpo dentro del cajón: 220 cm²,
| h = 6 W/m²K. Rint = 0,03 m²K/W por lado (3 mm de plástico y el aire de dentro) estimación . Gfuera = 0,105 y Gdentro = 0,112 W/K
RESULTADO | Sin ventilador (aire interior a +29,7 K): el Sigma queda a +28 K y echa al bar 2,9 W de sus 3: casi no calienta el cajón. Con ventiladores (aire a +7,5 K): queda a +16 K, echa fuera 1,6 W y deja
FÓRMULA | Δp = ρ·g·Δz·ΔT/T · · · Q = √(2·Δp / (ρ·ΣK)) · · · P = ρ·cp

SUSTITUCIÓN Δz = 0,166 m; ΔT de la columna = 33 K; Δp = 0,20 Pa. Cada rejilla son dos chapas en

RESULTADO Q = 0,23 m³/h. El aire sale a +39 K y se lleva 2,8 W. Con 0,20 Pa de empuje no se puede pedir

SUSTITUCIÓN h = 9,2 W/m²K; perímetro útil 0,42 m; acero de 3 mm, k = 50 W/m·K; L = 0,16 m; m =

RESULTADO η = 0,68: la chapa de abajo trabaja al 68 % de lo que haría si estuviera tan caliente como la de

SUSTITUCIÓN req = √(0,22 · 0,44 / π) = 0,175 m; ladrillo k = 0,6; hormigón k = 1,6 W/m·K

RESULTADO Ladrillo: 0,42 W/K; hormigón: 1,1 W/K; pladur: del orden de 0,1 W/K estimación . Caso base: 0,35

Estudio térmico del alcoholímetro · diseño A · revisión 2 (myPOS Sigma) · 13-11-2026 | 14 / 35

### 5.3 Comprobaciones del modelo

Comprobación | Resultado

Balance de energía: lo que sale por todos los caminos frente a lo
que se genera

20,00 W frente a 20,00 W

Independencia de la malla: 11, 22 y 44 franjas por cara | +29,67, +29,71 y +29,71 K
Contraste con la regla de los armarios eléctricos (k = | 5,5 W/m²K
sobre el área eficaz, montaje en pared), aplicada a la zona de
componentes. Lo hago con la versión del Solo, que es una caja
cerrada sin nada que cruce el frente
Regla: A = | 1,4·0,22·(0,282 + 0,10) + 1,8·0,10·0,282 =
0,168 m²; ΔT = | 15,7 / (5,5 · 0,168) = | +16,9 K. Modelo
con el cajón «transparente» (huecos muy conductores y todo pintado): +16,6 K

Lo que añade la doble pared con el cajón sin pintar, ya con el
Sigma

De +19,0 a +29,7 K: unos 11 K

La versión del Solo, recalculada con el código de esta revisión +26,5 K de media y +31,1 K junto al Solo: los mismos números de la revisión 1

La tercera fila es la que da confianza: quitando lo que este diseño tiene de particular, el modelo cae sobre la regla empírica que usa la industria para armarios de chapa pintada.

### 5.4 Dónde puede fallar

Convección dentro del cajón. Es el coeficiente peor conocido: 3,5 W/m²K entre el aire y las paredes (rango 2,5–5). Un cajón lleno de cables y placas no se parece a una placa lisa.
Reparto del aire en altura. Supongo que el aire de arriba está un 30 % más caliente que la media (rango 15– 45 %), del orden de lo que maneja la IEC TR 60890 para armarios cerrados. Hay que medirlo con tres sondas a distinta altura.
El terminal por dentro. No sé cómo reparte su calor entre la cara y la trasera. En los casos al azar varío su resistencia interior entre la mitad y el doble; eso mueve el aire interior 0,8 K sin ventilador.
La pared. Tomo una conductancia fija. Una pared real tarda horas en calentarse, así que las primeras horas se lleva algo más.
Con ventilador, el aire interior es un solo nodo bien mezclado. Lo que ve cada pieza depende de por dónde pase la corriente; lo trato con un factor por pieza (apartado 8.2).

# 6 Resultados sin ventilador

Caso base: bar a 25 °C, 20,0 W dentro, Sigma en el frente, rejillas actuales, carcasa pintada, cajón sin pintar y pared de ladrillo.

Punto | Sobre el bar Con el bar a 25 °C | Con el bar a 30 °C

Con el Solo
(revisión 1)
Chapa exterior, zona de componentes (media) | +7,5 K | 33 °C | 38 °C | +6,3 K
Chapa del cajón de componentes (media) | +20,6 K | 46 °C | 51 °C | +17,3 K
Aire interior, media | +29,7 K | 55 °C | 59 °C | +26,5 K
Aire junto al sensor | +34,8 K | 60 °C | 64 °C | +31,1 K
Aire junto a la Pi y al módem | +30,8 K | 56 °C | 61 °C | +27,5 K
Aire detrás del Sigma | +34,5 K | 60 °C | 64 °C | —
El Sigma por dentro | +28 K | 53 °C | 58 °C | —
Superficie de la pantalla | +41 K | 66 °C | 71 °C | +39 K

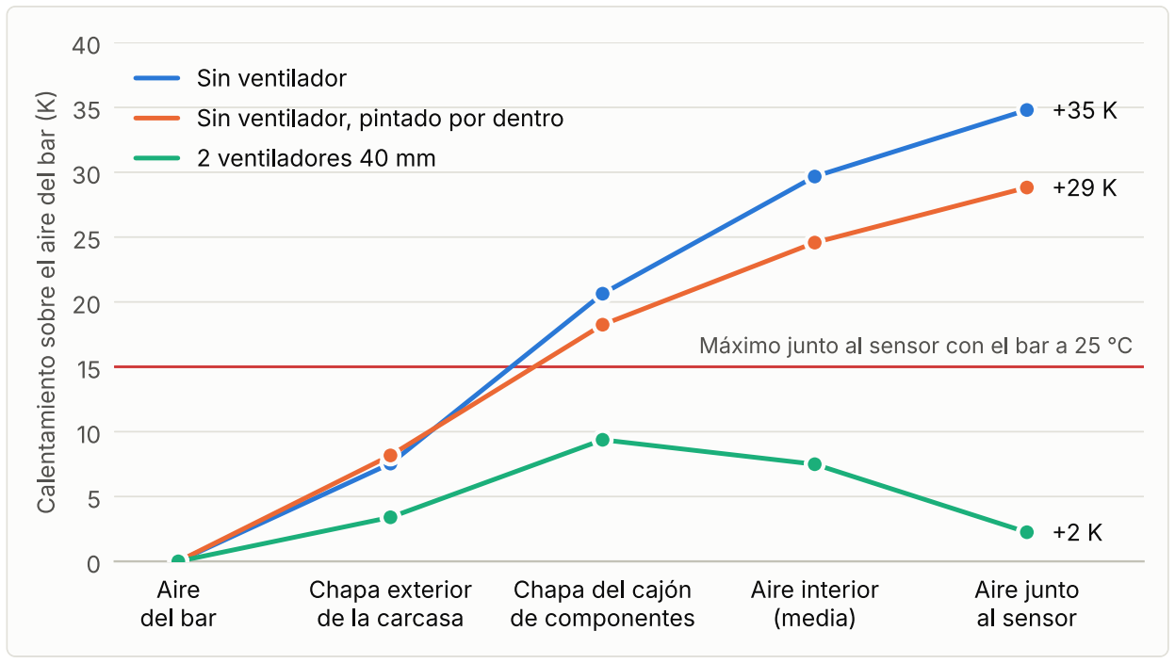
[picture p21: figure]
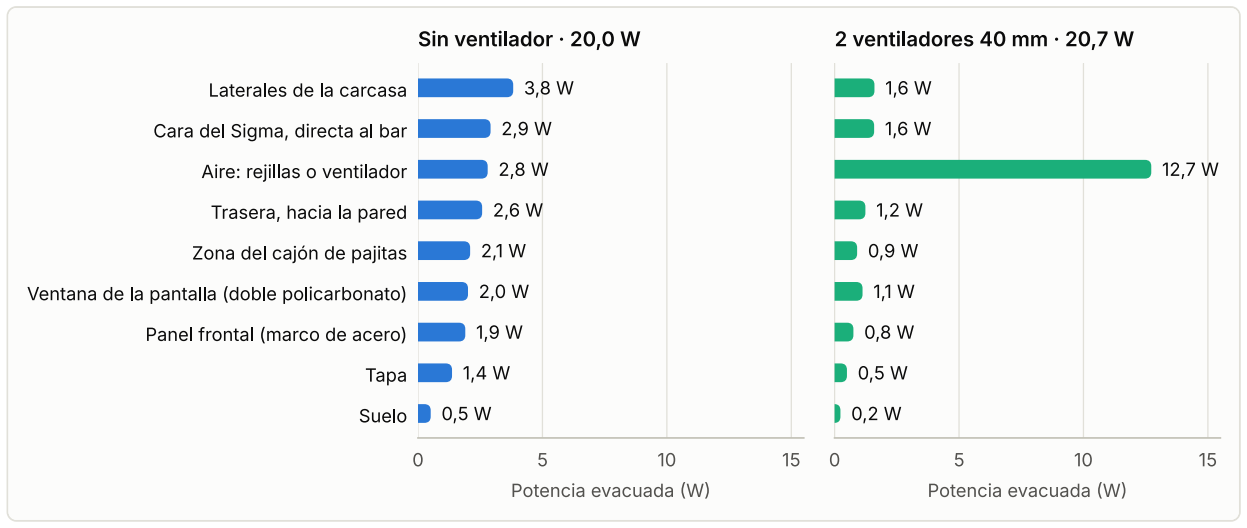
[picture p22: figure]

Estudio térmico del alcoholímetro · diseño A · revisión 2 (myPOS Sigma) · 13-11-2026 | 15 / 35

Figura 6. De fuera a dentro: cuánto sube la temperatura en cada salto. La chapa exterior apenas se entera (+8 K); los dos saltos grandes están dentro, entre la carcasa y el cajón y entre el cajón y el aire.

### 6.1 Dónde se pierde la temperatura

Del bar a la chapa exterior: +8 K. La carcasa de 3 mm reparte bien el calor y por fuera está casi fría. De la carcasa al cajón: +13 K. Es el precio de los huecos de aire.
Del cajón al aire interior: +9 K. Poca superficie (0,14 m²) y aire casi quieto.
De la media a la zona del sensor: +5 K. El aire caliente sube.
Con el interior pintado, el segundo y el tercer salto se reducen y el total baja 6 K.
Respecto al Solo, todo sube unos 3 K. Entran 4,3 W más, pero 2,9 W salen directos por la cara del Sigma. Por las paredes del cajón tienen que salir 12,3 W, frente a 10,5 W con el Solo.

### 6.2 Por dónde sale el calor

Figura 7. Reparto de la potencia por camino de salida. A la izquierda, sin ventilador: ningún camino destaca, todos son malos; la cara del Sigma es el segundo. A la derecha, con dos ventiladores: seis de cada diez vatios se van con el aire.

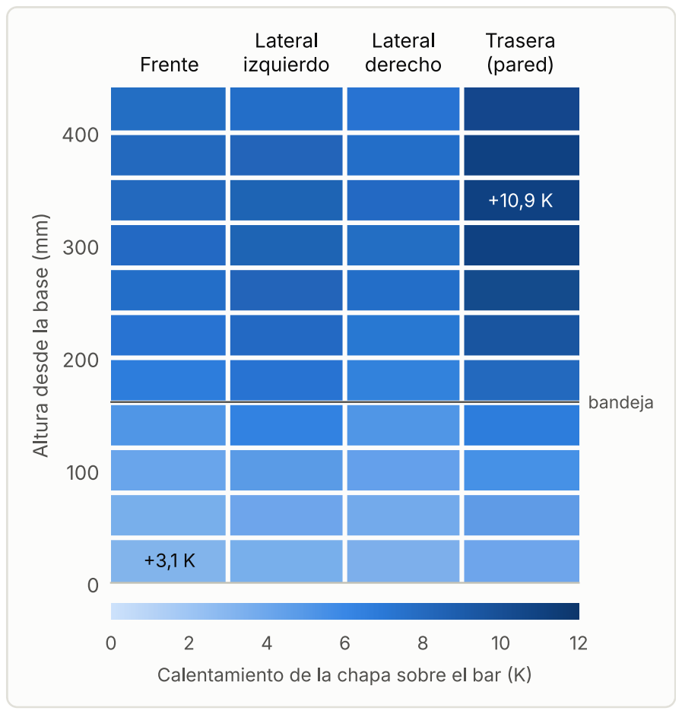
[picture p23: figure]
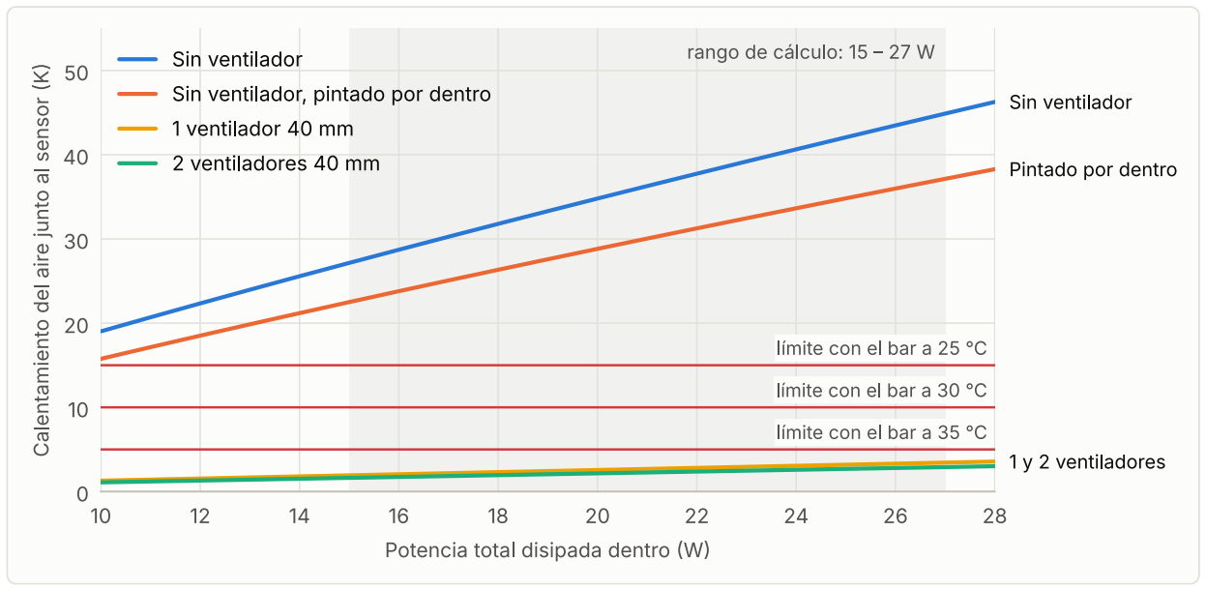
[picture p24: figure]

Estudio térmico del alcoholímetro · diseño A · revisión 2 (myPOS Sigma) · 13-11-2026 | 16 / 35

Los laterales son la mejor superficie, pero son estrechos: 3,8 W.
La cara del Sigma saca 2,9 W con 147 cm²: más que la ventana de la pantalla y el marco de acero del frente, que suman 3,9 W.
La pared se lleva 2,6 W. En pladur baja a la cuarta parte.
La zona del cajón de pajitas y el suelo, que no generan calor, sacan 2,6 W gracias a la chapa de
3 mm.
La tapa, con su cámara de aire, solo 1,4 W.

Figura 8. Calentamiento de la chapa exterior por cara y altura, sin ventilador. La trasera es la más caliente porque detrás van la fuente y la Pi y porque la pared evacua poco.

### 6.3 Con otra potencia

Figura 9. Calentamiento del aire junto al sensor según la potencia. Las líneas rojas marcan cuánto puede calentarse como mucho para no pasar de 40 °C con el bar a 25, 30 y 35 °C. Sin ventilador se pasa siempre; con ventilador sobra margen en todo el rango.

Sin ventilador, cada vatio de más son 1,5 K junto al sensor. Con ventiladores, 0,11 K.
Para cumplir sin ventilador con el bar a 25 °C habría que disipar menos de 7 W. No es realista: solo la pantalla y la Pi en reposo ya suman 4,5 W, sin contar el Sigma ni la fuente.
Aunque el Sigma gastara 1,5 W y se montara la fuente que menos pierde, quedarían 16,3 W y +30 K junto al sensor: prácticamente lo mismo que con el Solo (+31 K).

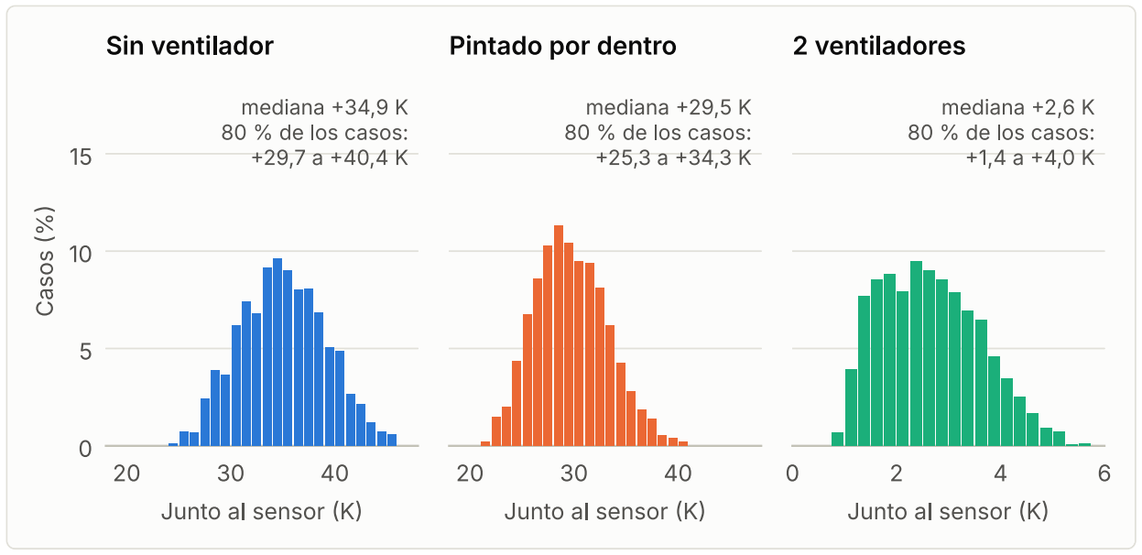
[picture p25: figure]
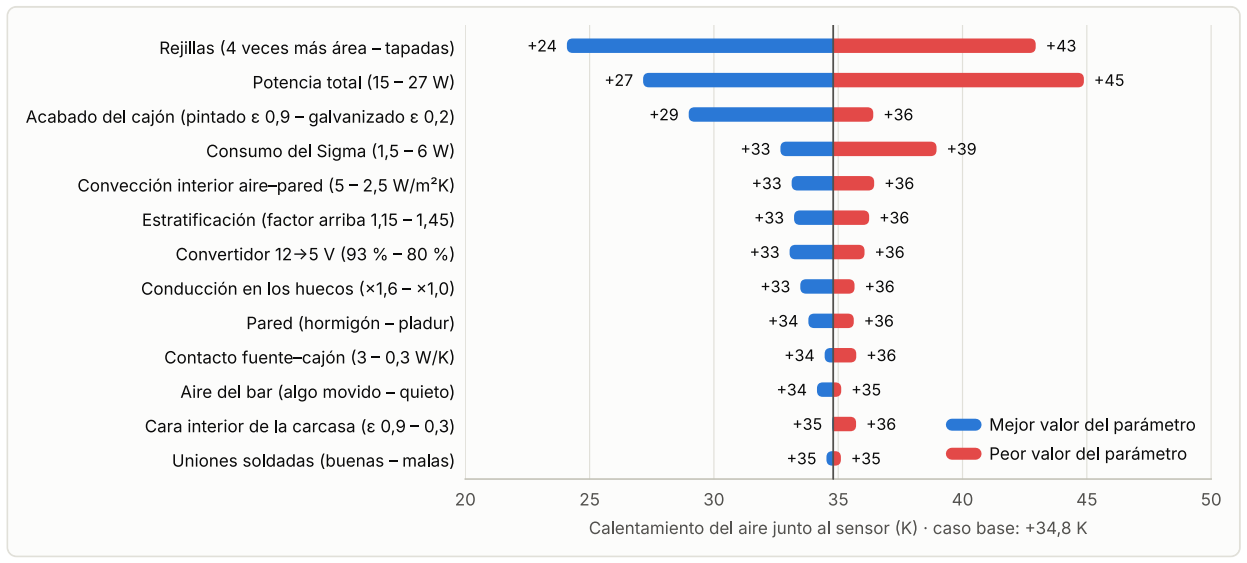
[picture p26: figure]

Estudio térmico del alcoholímetro · diseño A · revisión 2 (myPOS Sigma) · 13-11-2026 | 17 / 35

### 6.4 Cuánto me puedo estar equivocando

He repetido el cálculo 1 500 veces por configuración, sacando cada parámetro incierto de su rango (anexo A): potencia entre 15 y 27 W, convección interior, emisividades, tipo de pared, aire del bar, calidad de las soldaduras, fugas, reparto en altura y resistencia interior del terminal.

Figura 10. Resultado de los 1 500 casos por configuración. Sin ventilador, ningún caso baja de +24 K; con ventiladores, ningún caso pasa de +7 K junto al sensor.

Figura 11. Efecto de cada parámetro por separado, sin ventilador. Lo que más mueve el resultado es lo que se puede decidir o medir: las rejillas, la potencia, el acabado del cajón y el consumo del Sigma. Lo que no se controla (pared, aire del bar, soldaduras) apenas pesa.

Lectura
Sin ventilador, el aire junto al sensor queda entre +30 y +40 K sobre el bar en el 80 % de los casos, con mediana de +35 K.
Para no pasar de 40 °C con el bar a 25 °C harían falta menos de +15 K. No lo cumple ninguno de los 1 500 casos. La conclusión no depende de cómo afine los parámetros ni de lo que acabe gastando el Sigma.

Estudio térmico del alcoholímetro · diseño A · revisión 2 (myPOS Sigma) · 13-11-2026 | 18 / 35

# 7 ¿Se arregla sin ventilador?

Era la pregunta natural al cambiar de lector: si el Sigma aguanta 70 °C, quizá sobren los ventiladores. No sobran, porque el sensor y el módem siguen dentro.

Medida pasiva | Aire junto al sensor Bar máximo para el sensor Pega
Sigma, rejillas de hoy, cajón sin pintar | +34,8 K | 5 °C
Pintar el cajón y el interior de la carcasa (mate, cualquier color) | +28,8 K | 11 °C Ninguna. Hay que hacerlo de
todos modos
Rejillas 4 veces mayores (10 cm² cada una) | +24,1 K | 15 °C 12 ranuras por rejilla
Rejillas 16 veces mayores (40 cm² cada una) | +12,9 K | 27 °C Medio lateral abierto: entran
líquidos, dedos y palillos
Las dos cosas: 40 cm² por rejilla e interior pintado | +11,6 K | 28 °C Lo mismo, y aun así se queda
corta en verano
La fuente que menos pierde (LRS-50- 5 y una pequeña de 12 V) | +32,6 K | 7 °C Ayuda poco

Un Sigma que gaste 1,5 W en vez de

3 | +32,7 K | 7 °C No se elige: es lo que gaste

Con el tiro natural no hay fuerza: 17 cm de desnivel y 33 K de diferencia dan 0,20 Pa. Un ventilador de 40 mm da 17 Pa, casi cien veces más.
La única pasiva que llegaría es abrir del orden de 40 a 80 cm² arriba y otro tanto abajo. En una máquina de bar «a prueba de balas» eso es peor que un ventilador.
Sacar de la caja lo que queda de 40 °C es la otra salida, y con el Sigma ya solo son dos piezas. El módem se puede cambiar por uno de rango industrial, que los hay hasta 70 °C o más dato general ; el sensor, no: tiene que estar donde llega el soplido. Mientras el sensor esté dentro, hace falta aire.
Las medidas pasivas sí valen como red de seguridad: con el interior pintado, una avería de los ventiladores deja la máquina 6 K más fría.

# 8 Ventilación forzada

Los ventiladores son los mismos de la revisión 1: dos Noctua NF-A4x10 5V, uno metiendo aire y otro sacándolo. Cambian dos cosas: hay más calor que sacar y el aire fresco ya no hay que dárselo al lector, sino al sensor y al módem.

### 8.1 Cuánto aire mueven

Punto de trabajo: curva del ventilador contra la resistencia de las aberturas

FÓRMULA | n·Δpmáx

·(1 − Q/Qmáx

) = K·(ρ/2)·(Q/A)²

SUSTITUCIÓN NF-A4x10 5V: Qmáx = 8,2 m³/h y Δpmáx = 1,78 mm H₂O = 17,5 Pa. Abertura de Ø38 mm: A = 11,3 cm². K = 14. Con dos en serie (n = 2) y Q = 5,2 m³/h: velocidad 1,27 m/s; lado derecho 14 · 0,93 = 13,1 Pa; lado izquierdo 2 · 17,5 · (1 − 5,2/8,2) = 12,8 Pa

RESULTADO Un ventilador: 4,2 m³/h (51 % de su caudal libre). Dos en serie: 5,2 m³/h (63 %)

K es la suma de las pérdidas de todo el recorrido, referida a la abertura de Ø38: dos mallas de protección (unas 3 cada una), dos entradas y salidas bruscas (1,5 cada una), el paso por las dos chapas y los

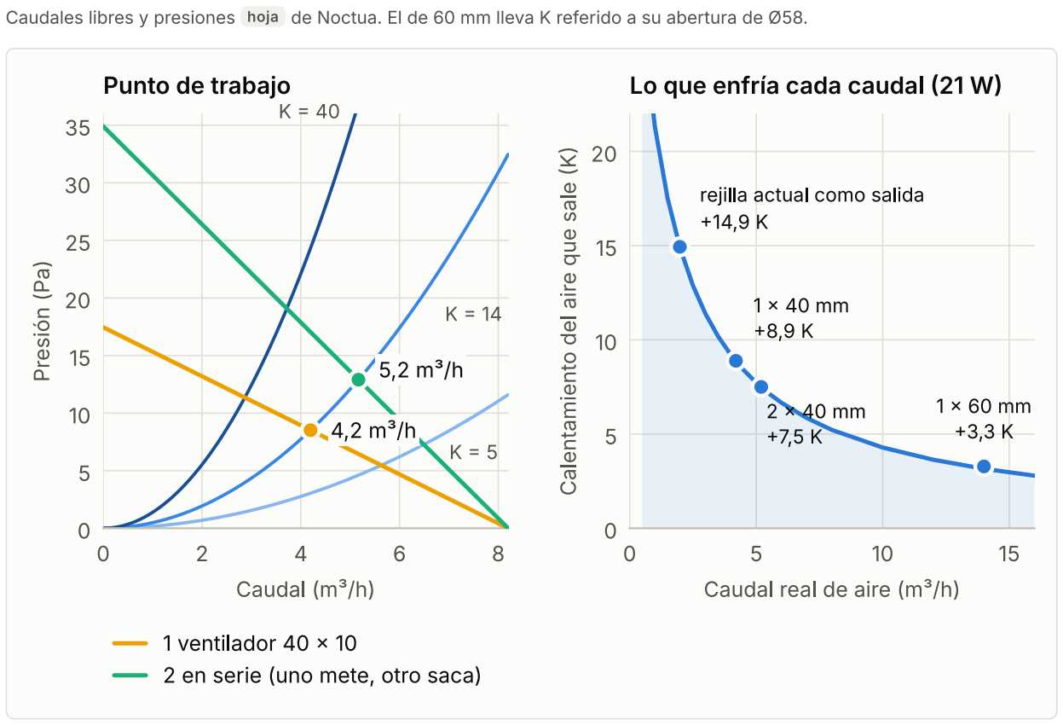
[picture p27: figure]
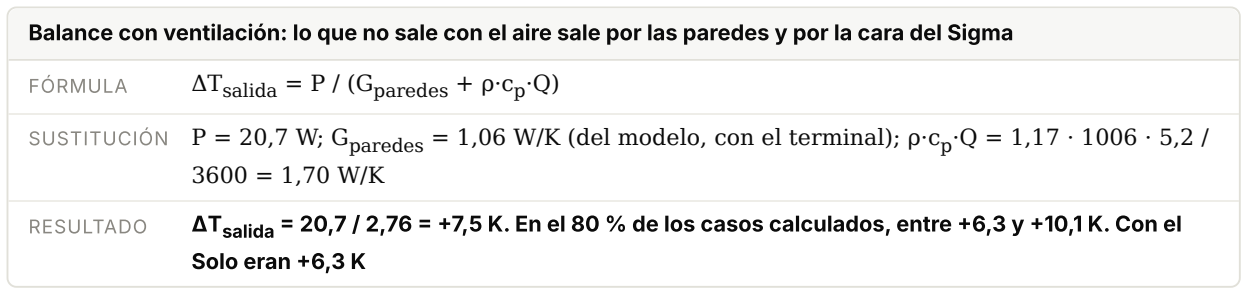
[picture p28: figure]
FÓRMULA; ΔTsalida = P / (Gparedes + ρ·cp; Solo eran +6,3 K

Estudio térmico del alcoholímetro · diseño A · revisión 2 (myPOS Sigma) · 13-11-2026 | 19 / 35

obstáculos de dentro (de 3 a 5). En total, entre 10 y 20; tomo 14 estimación . Con el cuerpo del Sigma dentro del cajón hay un obstáculo más; cabe en ese margen.
La curva del ventilador la tomo recta entre sus dos datos de catálogo estimación . La real tiene una panza a medio caudal, así que estos caudales son algo optimistas.
Con 12 V en la máquina se podría montar la versión de 12 V del mismo ventilador. Mueve el mismo aire; no cambia nada de lo que sigue.
Caudal real (m³/h) según lo limpio que sea el paso | K = | 10 | K = 20 | K = 40 | K = 80 | Catálogo, caudal libre
1 × 40 × 10 mm | | 4,7 | 3,7 | 2,9 | 2,2 | 8,2
2 × 40 × 10 en serie mm | | 5,6 | 4,7 | 3,7 | 2,9 | 8,2
2 × 40 × 20 en serie mm | | 6,4 | 5,3 | 4,2 | 3,2 | 9,4
1 × 60 × 25 mm | 13,5 | 10,4 | 7,8 | 5,8 | 29,2

Caudales libres y presiones hoja de Noctua. El de 60 mm lleva K referido a su abertura de Ø58.

Figura 12. Izquierda: curvas de uno y de dos ventiladores de 40 × 10 mm contra tres resistencias del recorrido; los puntos son el caso de cálculo. Derecha: calentamiento del aire que sale según el caudal real, con 21 W dentro.

### 8.2 Cuánto enfría

Balance con ventilación: lo que no sale con el aire sale por las paredes y por la cara del Sigma

SUSTITUCIÓN P = 20,7 W; Gparedes = 1,06 W/K (del modelo, con el terminal); ρ·cp

RESULTADO ΔTsalida = 20,7 / 2,76 = +7,5 K. En el 80 % de los casos calculados, entre +6,3 y +10,1 K. Con el

Estudio térmico del alcoholímetro · diseño A · revisión 2 (myPOS Sigma) · 13-11-2026 | 20 / 35

Lo que ve cada pieza depende de dónde esté respecto a la corriente. Con la entrada arriba a la izquierda, junto al sensor, y la salida abajo:

Pieza

Fracción del calentamiento de salida que ve Aire a su lado Por qué

Sensor ZE29A | 0,30 (0,15–0,50) | +2,2 K Recibe el chorro de entrada, apenas mezclado
Cámara | 0,45 | +3,4 K Arriba a la izquierda, al lado del chorro
Módem 4G | 0,70 (0,50–0,90) | +5,2 K A media altura, en el camino de bajada del aire
Raspberry Pi | 0,75 | +5,6 K Debajo del sensor, con el aire ya algo calentado
Pantalla | 1,00 | +7,5 K Abajo, hacia la salida
myPOS Sigma (por detrás) | 1,00 | +7,5 K Arriba a la derecha, fuera de la corriente
Fuente y convertidor | 1,00 más 6 K | +13,5 K Dentro de la caja de red, sin corriente directa

Fracciones estimación ; son lo que el ensayo del apartado 14 tiene que confirmar con una sonda en cada punto.

### 8.3 Dónde van la entrada y la salida

El principio no cambia: el aire fresco entra por donde está lo que menos aguanta. Lo que cambia es qué es lo que menos aguanta. Con el Solo era el lector, arriba a la derecha. Con el Sigma, todo lo delicado queda en la mitad izquierda y detrás: el sensor arriba, la Pi debajo y el módem a media altura. A la derecha quedan el Sigma y la fuente, que aguantan 70 °C.

Punto | Qué he comprobado en el CAD | Qué propongo
Entrada | En el lateral izquierdo, encima de la ventana de la antena, está
hoy la rejilla de arriba (a 351–371 mm de la base). Entre la placa de la antena, que llega a 349 mm, y el borde del cajón, a 401 mm, quedan 52 mm de alto, y hay 49 mm de fondo entre pestañas. El sensor empieza a unos 20 mm del lateral del cajón

Entrada ahí, soplando hacia el sensor. Cabe un 40 × 10 mm, justo; hay que mover los dos topes de goma de arriba a la izquierda. A confirmar en el bloque 3

Salida | Como en la revisión 1: junto a la toma C14 no cabe una abertura
de Ø38 (quedan 33 mm) y las 4 ranuras de la caja de red (3,1 cm²) bajarían el caudal de 5,2 a 3,6 m³/h

Salida abajo a la izquierda, donde hoy está la rejilla de entrada: 49 mm de fondo y 46 mm de alto bajo la placa de la antena. El aire baja por el lado de la Pi y el módem

El módem Hoy va en el USB de abajo de la Pi, detrás y hacia el centro, a media altura. Es la pieza que limita con ventilación. Además está justo detrás de donde entraría el cuerpo del Sigma

Pasarlo al montaje (b) del Bloque 1, tras la ventana de la antena: queda debajo de la entrada de aire y libera el fondo detrás del Sigma. El bar máximo sube de 34 a
36 °C estimación

El lado
derecho

Con entrada y salida a la izquierda, el Sigma y la fuente quedan en la zona menos barrida

No importa: los dos admiten 70 °C y el Sigma echa parte de su calor por la cara. Sí conviene abrir 10 cm² o más de ranuras en la caja de red para que la fuente y el convertidor respiren

Ventilador
de 60 mm

En los laterales hay 49 mm de fondo entre las pestañas del cajón: un 60 mm no cabe

Dos de 40 mm. Si el fondo interior lo permite, el de salida de 40 × 20 mm

Si la entrada se quedara donde iba con el Solo (arriba a la derecha), el aire fresco se lo llevaría el Sigma, que no lo necesita: el sensor vería +3,7 K, el módem +6,4 K y el bar máximo bajaría a 33 °C estimación . Funciona, pero desperdicia el mejor sitio.
Las rejillas actuales no valen como salida de un ventilador. Tres ranuras en dos chapas son un K de 94: el caudal se queda en 2,0 m³/h. Hacen falta aberturas de verdad, de Ø38 o equivalentes.
Burlete entre cajón y carcasa en cada abertura, como ya dice el Bloque 1. Sin él, el ventilador de entrada sopla al hueco entre las dos chapas y el aire vuelve a salir sin pasar por dentro.

Estudio térmico del alcoholímetro · diseño A · revisión 2 (myPOS Sigma) · 13-11-2026 | 21 / 35

Aberturas con lamas hacia abajo o con un deflector por dentro, para que una copa tirada de lado no entre. Esa protección es parte del K = 14.
El hueco del Sigma no es una entrada de aire. El terminal es IP65 por delante; el marco tiene que sellar contra el frente con su junta para que no entre líquido ni se escape el aire de los ventiladores.

### 8.4 Averías y suciedad

Situación | Caudal | Aire que sale | Junto al sensor, bar a 30 °C | Junto al módem, bar a 30 °C Valoración
Dos ventiladores, mallas limpias | 5,2 m³/h | +7,5 K | 32 °C | 35 °C Normal
Un ventilador parado (el otro tira a través de él) | 3,9 m³/h | +9,5 K | 34 °C | 37 °C Sigue en ficha. Avisar y cambiarlo en la siguiente visita
Mallas tapadas al 50 % | 4,2 m³/h | +8,9 K | 33 °C | 36 °C Sigue en ficha
Mallas tapadas al 75 % | 2,6 m³/h | +12,5 K | 36 °C | 40 °C El módem, en su límite. La sonda lo ve; los tacómetros no
Mallas tapadas al 90 %, o una funda encima | 1,2 m³/h | +19,6 K | 44 °C | 48 °C Fuera de ficha
Los dos parados | tiro natural +29 K de media | 64 °C | 60 °C Como sin ventilador. Hay
| | | | que dejar de vender pruebas

Con poco caudal la corriente deja de barrer y cada pieza ve una fracción mayor del calentamiento; por eso en las filas degradadas uso fracciones de 0,35 a 0,7 para el sensor y de 0,72 a 0,9 para el módem estimación .

### 8.5 Los ventiladores siguen siendo una pieza crítica, pero menos

Con el Solo, quedarse sin ventilación podía costar un lector. Con el Sigma no se rompe nada: el sensor y el módem trabajan fuera de rango y la máquina tiene que dejar de vender hasta que se enfríe. Sigue siendo una avería que hay que detectar; ya no es una que no tenga vuelta atrás.
Hoy los dos ventiladores cuelgan del mismo fusible (W31 del Bloque 1, MINI de 2 A). Un fusible, un empalme o un cable dejan la máquina sin ventilación de golpe. Sigo proponiendo un fusible por ventilador. Los tacómetros no bastan. Un ventilador puede girar a sus vueltas con la malla tapada o con una funda encima. Hace falta una sonda de temperatura junto al sensor (una DS18B20 al GPIO4, unos 3 €), que mide lo que de verdad importa. En la revisión 1 iba junto al Solo.
Dos fuentes de temperatura para el programa: la sonda y la del procesador de la Pi (vcgencmd measure_temp). La battery_temperature del Solo desaparece con él. Umbrales en el apartado 13. Dejar de vender exige poder parar el cobro. Con la app Pulse el Sigma cobra por su cuenta y manda un pulso; la Pi no interviene. La documentación de myPOS describe tres entradas para señales de la máquina hoja , y el estudio de cobro habla de «opciones de inhibición», pero en la página de Pulse que he leído esas entradas solo aparecen como señales de confirmación: hay que preguntárselo a myPOS. Si no se puede, se le cortan los 12 V con un transistor.
Polvo. Malla metálica y no filtro de espuma. Con malla, lo que se tapa se ve desde fuera y se limpia con la mano.

# 9 Temperatura de cada pieza y del bar

Las dos tablas dan la temperatura del aire junto a cada pieza según la temperatura del bar. Verde: dentro de ficha con 5 K o más de margen. Amarillo: dentro, con menos de 5 K. Rojo: fuera.

Estudio térmico del alcoholímetro · diseño A · revisión 2 (myPOS Sigma) · 13-11-2026 | 22 / 35

### 9.1 Sin ventilador

Pieza | Límite Bar a 15 °C Bar a 20 °C Bar a 25 °C Bar a 27 °C Bar a 30 °C Bar a 35 °C Bar a 40 °C
Sensor ZE29A | 40 °C | ✗ 50 | ✗ 55 | ✗ 60 | ✗ 62 | ✗ 64 | ✗ 69 | ✗ 74
Módem 4G | 40 °C | ✗ 46 | ✗ 51 | ✗ 56 | ✗ 58 | ✗ 61 | ✗ 65 | ✗ 70
Cámara | 50 °C | ✗ 52 | ✗ 57 | ✗ 61 | ✗ 63 | ✗ 66 | ✗ 71 | ✗ 75
Raspberry Pi 3B+ | 50 °C | ! 46 | ✗ 51 | ✗ 56 | ✗ 58 | ✗ 60 | ✗ 65 | ✗ 70
Pantalla 7″ | 50 °C | ✓ 41 | ! 46 | ✗ 51 | ✗ 53 | ✗ 55 | ✗ 60 | ✗ 65
myPOS Sigma | 70 °C | ✓ 50 | ✓ 55 | ✓ 60 | ✓ 61 | ✓ 64 | ! 69 | ✗ 73
Convertidor 12→5 V 70 °C | ✓ 46 | ✓ 51 | ✓ 55 | ✓ 57 | ✓ 60 | ✓ 65 | ! 70
Fuente LRS-50-12 | 70 °C | ✓ 46 | ✓ 51 | ✓ 55 | ✓ 57 | ✓ 60 | ✓ 65 | ! 70

### 9.2 Con dos ventiladores de 40 mm

Pieza | Límite Bar a 15 °C Bar a 20 °C Bar a 25 °C Bar a 27 °C Bar a 30 °C Bar a 35 °C Bar a 40 °C
Sensor ZE29A | 40 °C | ✓ 17 | ✓ 22 | ✓ 27 | ✓ 29 | ✓ 32 | ! 37 | ✗ 42
Módem 4G | 40 °C | ✓ 20 | ✓ 25 | ✓ 30 | ✓ 32 | ! 35 | ✗ 40 | ✗ 45
Cámara | 50 °C | ✓ 18 | ✓ 23 | ✓ 28 | ✓ 30 | ✓ 33 | ✓ 38 | ✓ 43
Raspberry Pi 3B+ | 50 °C | ✓ 21 | ✓ 26 | ✓ 31 | ✓ 33 | ✓ 36 | ✓ 41 | ! 46
Pantalla 7″ | 50 °C | ✓ 22 | ✓ 27 | ✓ 32 | ✓ 35 | ✓ 38 | ✓ 43 | ! 48
myPOS Sigma | 70 °C | ✓ 22 | ✓ 27 | ✓ 32 | ✓ 35 | ✓ 38 | ✓ 43 | ✓ 48
Convertidor 12→5 V 70 °C | ✓ 28 | ✓ 33 | ✓ 38 | ✓ 41 | ✓ 44 | ✓ 49 | ✓ 54
Fuente LRS-50-12 | 70 °C | ✓ 28 | ✓ 33 | ✓ 38 | ✓ 41 | ✓ 44 | ✓ 49 | ✓ 54
✓ en ficha, | margen ≥ 5 K | ! en ficha, | margen < 5 K | ✗ fuera de ficha | Temperaturas en °C cálculo | . Pantalla: límite de
50 °C supuesto | . Fuente y convertidor: aire dentro de la caja de red.

### 9.3 Temperatura máxima del bar, pieza a pieza

Pieza | Sin ventilador | Interior pintado | 1 ventilador | 2 ventiladores
Sensor ZE29A (40 °C) | 5 °C | 11 °C | 37 °C | 37 °C
Módem 4G (40 °C) | 9 °C | 14 °C | 33 °C | 34 °C
Cámara (50 °C) | 13 °C | 19 °C | 46 °C | 46 °C
Raspberry Pi 3B+ (50 °C) | 19 °C | 24 °C | 43 °C | 44 °C
Pantalla 7″ (50 °C) | 24 °C | 28 °C | 41 °C | 42 °C
myPOS Sigma (70 °C) | 35 °C | 41 °C | 61 °C | 62 °C
Convertidor 12→5 V (70 °C) | 39 °C | 43 °C | 55 °C | 56 °C
Fuente LRS-50-12 (70 °C) | 39 °C | 43 °C | 55 °C | 56 °C
Todo en ficha | 5 °C | 11 °C | 33 °C | 34 °C
Todo en ficha, con el Solo (revisión 1) | 8 °C | 14 °C | 33 °C | 34 °C

Sin ventilador el Sigma aguantaría un bar a 35 °C; el sensor, uno a 5 °C. El cambio de lector quita un límite de la lista, no el primero.
Con ventilación limita el módem, igual que antes: 40 °C y a media altura. En el 80 % de los casos calculados el bar máximo queda entre 32 y 36 °C. Con el módem tras la ventana de la antena, bajo la entrada de aire, sube a unos 36 °C.

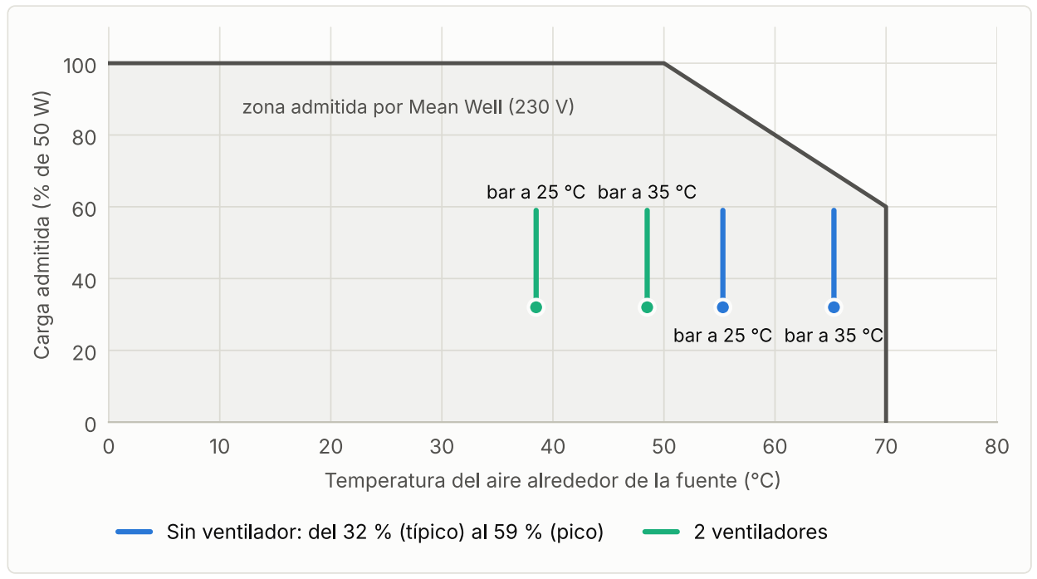
[picture p29: figure]

Estudio térmico del alcoholímetro · diseño A · revisión 2 (myPOS Sigma) · 13-11-2026 | 23 / 35

Un bar climatizado está entre 21 y 26 °C: el reglamento español de instalaciones térmicas no deja calentar por encima de 21 °C ni enfriar por debajo de 26 °C. Con ventilación quedan de 9 a 14 K de margen. Un bar sin aire acondicionado en agosto puede pasar de 30 °C, y ahí el margen es de 5 K.

### 9.4 La Pi por dentro

El límite de 50 °C es del aire que la rodea. Lo que la frena es el procesador: a 60 °C baja de 1,4 a 1,2 GHz y a partir de 80 °C recorta más hoja .
En las pruebas publicadas, la 3B+ gasta 1,9 W en reposo y 5,8 W a plena carga, y a plena carga llega enseguida a sus 60 °C en una mesa. De ahí saco unos 9–11 K por vatio entre el procesador y el aire

estimación .
Con unos 3 W reproduciendo vídeo, el procesador va de 27 a 33 K por encima del aire que lo rodea:
Caso | Aire junto a la Pi | Procesador (estimado) Efecto
Sin ventilador, bar a 25 °C | 56 °C | 83–89 °C Recorte fuerte: vídeo a saltos
Dos ventiladores, bar a 25 °C | 31 °C | 58–64 °C En el umbral de los 60 °C
Dos ventiladores, bar a 35 °C | 41 °C | 68–74 °C A 1,2 GHz casi siempre

Dos medidas baratas: un disipador de aluminio pegado al procesador (unos 3 €; de 5 a 10 K menos estimación ) y temp_soft_limit=70 en config.txt, que sube el primer umbral de 60 a 70 °C y es el máximo que admite ese ajuste.
Con el cobro por pulsos la Pi trabaja menos: ya no pregunta a SumUp cada 3 segundos ni hace de punto de acceso Wi-Fi para el lector. Algo bajará su consumo; no lo descuento estimación .

### 9.5 La fuente y el convertidor

Figura 13. Curva de reducción de carga de la serie LRS-50 a 230 V, leída en la hoja de Mean Well, con los puntos de trabajo de la LRS-50-12 en esta máquina. Cada trazo vertical va del consumo típico (32 %) al pico (59 %). La fuente queda dentro de su zona en todos los casos.

La LRS-50-12 no limita. A 12 V la máquina le pide 16 W de sus 50: un tercio. El pico, con la Pi, el módem, la pantalla y el Sigma a tope a la vez, ronda el 59 % estimación .

Estudio térmico del alcoholímetro · diseño A · revisión 2 (myPOS Sigma) · 13-11-2026 | 24 / 35

Sin ventilador y con el bar a 35 °C el aire de la caja de red llega a 65 °C. La fuente lo admite hasta el 69 % de carga; el convertidor ya estaría reduciendo. Es otro motivo para ventilar.
Con ventiladores y el bar a 35 °C son 48 °C: los dos trabajan sin reducción.
Lo que sí cambia con el calor es su vida (apartado 12).

### 9.6 El Sigma por dentro

Los 70 °C son del aire que lo rodea. Aquí tiene dos aires: el del bar por delante y el del cajón por detrás. Como criterio prudente comparo sus 70 °C con el aire de detrás.
Con ventiladores el aire de detrás va +7 K sobre el bar y el terminal, por dentro, unos +16 K cálculo . Con el bar a 35 °C son 42 °C alrededor y unos 51 °C dentro. Le sobran más de 25 K.
Sin ventiladores el aire de detrás va +35 K sobre el bar: llega a 70 °C con el bar a 35 °C. Es el único caso en el que el Sigma se acerca a su límite, y antes ya han fallado el sensor, el módem, la Pi y la pantalla.
Si gasta 6 W en vez de 3, por dentro sube a +28 K con ventiladores. Sigue holgado.

Respuesta a «qué temperatura soporta», con el Sigma
La carcasa, los materiales y ahora también el lector: 70 °C o más. No limitan.
La máquina sin ventilador: un bar a 5 °C con todo en ficha. En un bar normal, a 22–26 °C, el sensor trabajaría a 57–61 °C.
La máquina con dos ventiladores: hasta unos 34 °C de bar con todo en ficha, y 37 °C si solo se mira el sensor. Mantengo la especificación de instalación de la revisión 1: bares de 10 a 32 °C.
Por abajo: 10 °C en el sensor. Con los ventiladores parados en frío, la máquina se calienta sola y admite bares de hasta unos 0 °C (apartado 11).
Al sol directo: no, en ningún caso.

# 10 Arranque, averías y cortes de luz

El mismo modelo, ahora con la masa de cada pieza: la máquina almacena unos 6,9 kJ por kelvin, casi todo en la chapa.

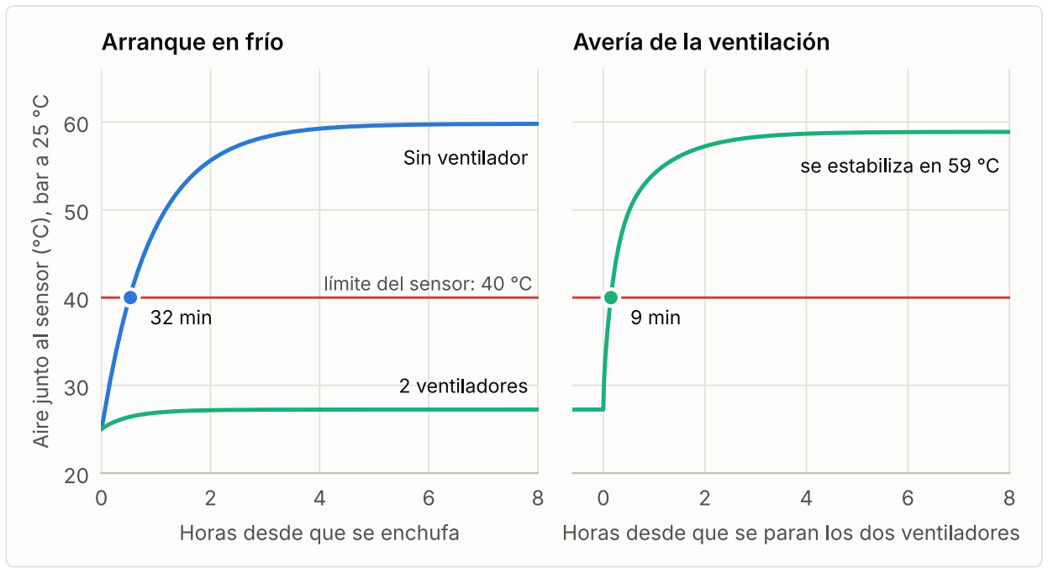
[picture p30: figure]

Estudio térmico del alcoholímetro · diseño A · revisión 2 (myPOS Sigma) · 13-11-2026 | 25 / 35

Figura 14. Temperatura del aire junto al sensor con el bar a 25 °C. Izquierda: desde que se enchufa en frío. Derecha: desde que se paran los dos ventiladores estando en régimen.

### 10.1 Arranque en frío

Sin ventilador: el aire junto al sensor pasa de 40 °C a los 32 minutos de enchufar. Llega al 63 % de su subida en 56 minutos y al 95 % en 2,9 horas.
Con ventiladores: se estabiliza en menos de 1,7 horas, a 27 °C.
El aire interior responde rápido porque dentro hay poca masa: placas, cables y un cajón de 1,9 kg. La chapa exterior tarda más, pero solo aporta 8 de los 35 K.
Para el ensayo, 4 horas bastan: a las 4 h el modelo está al 98 % del valor final.

### 10.2 Avería de la ventilación

Si se paran los dos ventiladores con el bar a 25 °C, el aire junto al sensor pasa de 27 a 40 °C en unos 9 minutos y se estabiliza en 59 °C. Junto al módem, que parte de 30 °C, son unos 6 minutos.
Con el bar a 30 °C son unos 4 minutos para el sensor y 1 para el módem.
La subida es tan rápida porque las piezas ya están calientes: con ventilación la Pi y la pantalla trabajan de 25 a 35 K por encima del bar y es el aire quien las enfría. Al pararse el aire, ese calor se queda dentro en minutos. El modelo supone que el aire caliente tarda unos 10 minutos en acumularse arriba supuesto .
Qué se pierde: con el Solo, a partir de 40 °C empezaba el riesgo de un bloqueo sin vuelta atrás. Con el Sigma, el aire de detrás del terminal se estabiliza en 59 °C con el bar a 25 °C y en 69 °C con el bar a 35 °C: dentro de sus 70 °C, justo en el segundo caso. El sensor y el módem trabajan fuera de ficha mientras dure, y se recuperan al enfriarse.
Consecuencia: el programa sigue teniendo minutos, no horas. Tiene que leer la sonda cada pocos segundos, bajar el consumo en el primer umbral y dejar de vender pruebas en el segundo. Lo que cambia es que llegar tarde ya no cuesta un aparato.

### 10.3 Corte de luz nocturno

Apagada, la máquina se enfría sola: en 3,6 horas el aire interior está a menos de 2 K del bar.
Un corte de 7 horas la deja a la temperatura del local. Cada mañana arranca en frío y repite la curva de la figura.

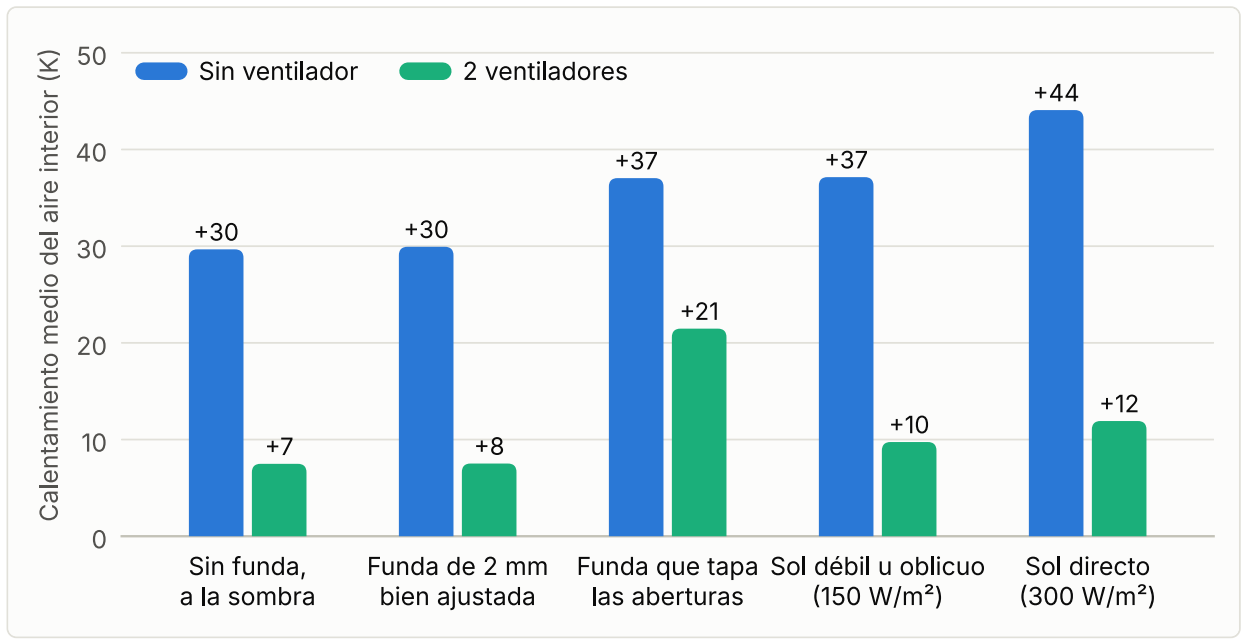
[picture p31: figure]
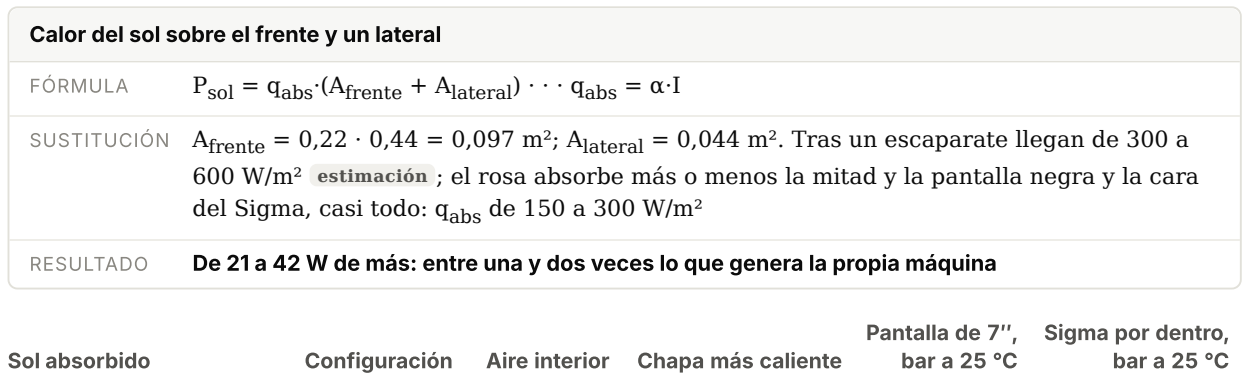
[picture p32: figure]
FÓRMULA; Psol = qabs; ·(Afrente + Alateral; ) · · · qabs = α·I; Sol absorbido; Configuración; Aire interior Chapa más caliente; Pantalla de 7″, bar a 25 °C; Sigma por dentro, bar a 25 °C

Estudio térmico del alcoholímetro · diseño A · revisión 2 (myPOS Sigma) · 13-11-2026 | 26 / 35

Para el calor esto es bueno: las noches apagada son horas a temperatura ambiente para los condensadores de la fuente y para el sensor.
El arranque del Solo tras un corte era la prueba A1 del Bloque 1. Con el Sigma hay que comprobar lo equivalente en el banco: que al volver la corriente arranque solo y vuelva a la app Pulse sin que nadie lo toque.

# 11 Sol,funda y frío

Figura 15. Calentamiento medio del aire interior en cinco situaciones. «Funda que tapa las aberturas»: sin ventilador equivale a sellar las rejillas; con ventiladores supongo que el caudal cae a 1 m³/h.

### 11.1 Sol directo

Calor del sol sobre el frente y un lateral

SUSTITUCIÓN Afrente = 0,22 · 0,44 = 0,097 m²; Alateral = 0,044 m². Tras un escaparate llegan de 300 a 600 W/m² estimación ; el rosa absorbe más o menos la mitad y la pantalla negra y la cara del Sigma, casi todo: qabs de 150 a 300 W/m²

RESULTADO | De 21 a 42 W de más: entre una y dos veces lo que genera la propia máquina
150 W/m² (débil u oblicuo) | Sin ventilador | +37 K | +18 K | 81 °C | 64 °C
| 2 ventiladores | +10 K | +13 K | 60 °C | 49 °C
300 W/m² (directo) | Sin ventilador | +44 K | +27 K | 96 °C | 74 °C
| 2 ventiladores | +12 K | +21 K | 71 °C | 57 °C

El Sigma aguanta el sol; la pantalla de 7″, no. El terminal está hecho para ir a la intemperie y da su calor al bar por la cara. La pantalla sigue detrás de dos policarbonatos que no dejan salir lo que entra: 71 °C con ventiladores, la zona en la que un LCD empieza a oscurecerse dato general .

Estudio térmico del alcoholímetro · diseño A · revisión 2 (myPOS Sigma) · 13-11-2026 | 27 / 35

Con sol directo y ventiladores el aire interior sube a +12 K: el módem pasaría de 40 °C con el bar a 31 °C. La chapa llega a 52 °C: por encima del umbral de quemadura por contacto prolongado.
Regla de instalación, la misma: ninguna hora de sol directo sobre la máquina, tampoco a través de un cristal. Si un local solo tiene ese sitio, no se instala.

### 11.2 La funda de plástico

Bien hecha no molesta. Una funda de 2 mm ajustada a los laterales y la tapa añade unos 0,02 m²K/W: +0,3 K sin ventilador y nada apreciable con ventiladores. Por la chapa sale poco calor; taparla cambia poco. Mal hecha es una avería. Si tapa las aberturas, la máquina ventilada se va a +21 K. La funda tiene que dejar libres la entrada, la salida, la rejilla que quede y la ventana de la antena, con margen alrededor.
Y ahora, la cara del Sigma. No puede quedar detrás de ningún plástico: es por donde se paga y por donde el terminal echa su calor.
Material. El PLA de impresión 3D empieza a ablandarse hacia 55–60 °C dato general . En condiciones normales la chapa no llega, pero con sol sí. Mejor PETG o ABS.

### 11.3 Fuentes de calor cercanas

El modelo toma como «bar» el aire que rodea la máquina, no el del termostato del local.
Encima de un radiador, junto a la salida de aire de un botellero o una nevera, al lado de la cafetera o bajo un foco halógeno, ese aire puede estar de 5 a 15 K por encima del resto estimación . Cada kelvin ahí es un kelvin dentro.
Regla de instalación: a más de un metro de cualquier salida de aire caliente y nunca encima de un radiador.

### 11.4 Frío

Bar | Sensor, ventiladores en marcha Sensor, ventiladores parados Aire detrás del Sigma, ventiladores en marcha
0 °C | 2 °C (bajo su mínimo de 10 °C) | 36 °C | 7 °C
5 °C | 7 °C (bajo su mínimo de 10 °C) | 41 °C | 12 °C
10 °C | 12 °C | 46 °C | 17 °C
15 °C | 17 °C | 50 °C | 22 °C

Con los ventiladores siempre en marcha, el sensor baja de sus 10 °C cuando el bar baja de unos 7 °C. Con los ventiladores parados, la máquina se calienta sola y el sensor está a más de 30 °C aunque el bar esté a 0 °C.
El Sigma trabaja desde −20 °C: el frío no le afecta en ningún local.
Propuesta, la de la revisión 1: que los ventiladores no giren siempre. Parados por debajo de unos 25 °C en la sonda interior y en marcha por encima de 30 °C. Hace falta un transistor o un relé en su rama, o la versión PWM del mismo ventilador.
Ventajas: el sensor trabaja templado, que es como mejor mide y como menos condensa el aliento en el tubo; los ventiladores duran más; y entra menos polvo.
Tras una noche apagada en un local frío, la máquina arranca a la temperatura del bar. Si está por debajo de 10 °C, el programa tiene que esperar a que la sonda suba antes de dar una prueba por válida.

# 12 Calor y vida útil

Estar dentro de ficha no basta para dos años. Con el Solo, la pieza que antes envejecía era su batería. Con el Sigma esa preocupación desaparece y quedan dos: los condensadores de la fuente y la celda del sensor.

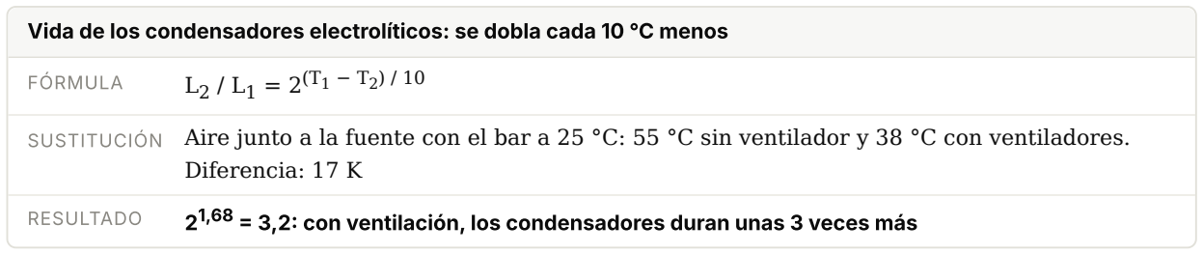
[picture p33: figure]
FÓRMULA; Diferencia: 17 K; RESULTADO

Estudio térmico del alcoholímetro · diseño A · revisión 2 (myPOS Sigma) · 13-11-2026 | 28 / 35

### 12.1 Lo que ya no envejece: la batería del lector

Temperatura de una batería de litio siempre al 100 % de carga | Capacidad que queda al cabo de un año
25 °C | 80 %
40 °C | 65 %
60 °C | 60 % a los 3 meses

Datos de Battery University para celdas de litio corrientes hoja . Era el caso del Solo, siempre enchufado.

En la revisión 1 esta tabla decidía la visita de los dos años: el Solo era una pieza que había que cambiar, y sin ventilación su batería se agotaba en meses.
El Sigma se alimenta de la máquina y no lleva batería. Esa partida sale del mantenimiento.

### 12.2 Condensadores de la fuente y del convertidor

Vida de los condensadores electrolíticos: se dobla cada 10 °C menos

SUSTITUCIÓN Aire junto a la fuente con el bar a 25 °C: 55 °C sin ventilador y 38 °C con ventiladores.

1,68 = 3,2: con ventilación, los condensadores duran unas 3 veces más

Los electrolíticos son la única pieza de una fuente que se desgasta, y su vida depende casi solo de la temperatura dato general .
Ahora hay dos aparatos con electrolíticos en la caja de red, la fuente y el convertidor, y disipan entre los dos 5,8 W en vez de 3,5. Es el argumento de vida útil a favor de dejar la LRS-50-5 y añadir una fuente pequeña: menos calor en el rincón sin corriente.
Con ventiladores la caja de red queda a 38 °C con el bar a 25 °C: temperatura cómoda para cualquier fuente industrial.

### 12.3 El resto

Pieza | Qué le hace el calor | Qué hacer

Sensor ZE29A Las celdas electroquímicas pierden electrolito más deprisa

| con calor y aire seco dato general . El manual no da vida. Pasa a ser la pieza que más sufre el calor | Tenerlo entre 15 y 35 °C: en el chorro de entrada en verano y con los ventiladores parados en invierno
Pantalla de 7″ | La retroiluminación pierde brillo antes cuanto más caliente trabaja. Paneles parecidos dan 20 000 h a mitad de brillo; dos años encendida son 17 500 h | Brillo al mínimo útil y apagarla en las horas de cierre: menos calor y menos horas

myPOS Sigma Su pantalla envejece como cualquier LCD. Trabaja unos 41 °C

| por dentro con el bar a 25 °C, lejos de su límite | Si la app lo permite, que apague la pantalla cuando no haya nadie delante
Ventiladores | Más de 150 000 h de vida media declarada y trabajo hasta 70 °C hoja . Dos años son 17 500 h | No giran siempre (apartado 11.4)
microSD, Pi, módem | Dentro de ficha no hay un mecanismo de desgaste claro | —

Estudio térmico del alcoholímetro · diseño A · revisión 2 (myPOS Sigma) · 13-11-2026 | 29 / 35

# 13 Cambios recomendados

Por orden de importancia. Los cuatro primeros son los que cambian el resultado; el resto son baratos y quitan riesgos. Lo que cambia respecto a la revisión 1 va marcado como nuevo.

N.º Cambio | Efecto | Coste | Dónde se hace
1 | Ventilación forzada con dos
ventiladores de 40 mm. Nuevo: la entrada va arriba a la izquierda, junto al sensor; la salida, abajo a la izquierda. Aberturas de Ø38 con malla y lamas, y burlete entre cajón y carcasa | Aire junto al sensor de +35 a +2 K. Bar máximo de 5 a 34 °C | Unos 40 € por máquina | CAD (bloque 3) y compras
2 | Nuevo: hueco del Sigma en el frente,
de 108,7 × 86,4 mm, con su junta. Tumbado, o recolocando la pantalla. Comprobar el fondo con el aparato en la mano

Es la condición del cambio de lector. De paso, su cara saca de 1,6 a 2,9 W directos al bar

El del terminal | CAD (bloque 3)
3 | Sonda de temperatura (DS18B20).
Nuevo: junto al sensor, no junto al lector. Umbrales en el programa: a 36 °C baja el brillo y avisa; a 38 °C avisa como avería; a 40 °C deja de vender pruebas hasta que baje de 37 °C

La máquina se protege sola en los minutos que tiene. Detecta mallas tapadas, fundas y sol, que los tacómetros no ven

Unos 3 € | Compras y
programa (bloque 4)

4 Nuevo: poder parar el cobro desde la Pi. Preguntar a myPOS si una entrada del Sigma lo inhibe; si no, cortarle los 12 V con un transistor

Sin esto, el Sigma seguiría cobrando pruebas que la máquina no puede dar

Un transistor Cableado (bloque 1) y programa

5 Un fusible por ventilador en vez de uno para los dos

Un fallo eléctrico ya no deja la máquina sin ventilación

Un
portafusibles

Tabla de cableado
(W31)

6 Nuevo: módem tras la ventana de la antena (montaje (b) del Bloque 1)

Queda bajo la entrada de aire: bar máximo de 34 a unos 36 °C. Libera el fondo detrás del Sigma

Un alargador
USB

CAD y cableado

7 Nuevo: decidir la fuente. Por calor, dejar la LRS-50-5 y añadir una fuente pequeña de 12 V solo para el Sigma

1,8 W menos que con LRS-50-12 y convertidor, y los 5 V del Bloque 1 no se tocan

Parecido | Bloque 1
8 | Cajón de componentes e interior de la carcasa pintados en mate, de cualquier color. Nunca galvanizado brillante sin pintar

6 K menos cuando la ventilación falla. De paso resuelve el óxido del cajón

El de pintar por
dentro

Pedido al taller

9 Ventiladores con control: parados por debajo de 25 °C en la sonda, en marcha por encima de 30 °C

Sensor templado en invierno, menos polvo y más vida

Un transistor, o
la versión PWM

Cableado y
programa

10 Reglas de instalación: nunca al sol, a más de un metro de salidas de aire caliente, bares de 10 a 32 °C, aberturas y cara del Sigma despejadas

Evita los casos que ningún ventilador arregla

Ninguno | Hoja de instalación
11 | Medir el consumo real. Nuevo: el del
Sigma en sus 12 V, en reposo y cobrando; y el total en el enchufe

Sustituye las dos mayores
incógnitas del estudio por datos
Unos 15 € | Banco
12 | Disipador en el procesador de la Pi y
temp_soft_limit=70

La Pi no baja de velocidad en verano

Unos 3 € | Compras y sistema
13 | Más ranuras en la caja de red (10 cm² o
más entre frente y base)

La fuente y el convertidor respiran aunque no reciban corriente directa

Ninguno | CAD

Estudio térmico del alcoholímetro · diseño A · revisión 2 (myPOS Sigma) · 13-11-2026 | 30 / 35
N.º Cambio | Efecto | Coste | Dónde se hace
14 | Menos vatios: brillo al mínimo útil,
pantalla apagada en el cierre, módem fijado en 4G y, si la app lo permite, el Sigma en reposo cuando no hay nadie | De 1 a 4 W menos. Con ventilación son décimas de kelvin, pero dan margen si falla | Ninguno | Programa

Lo que no cambiaría
Los ventiladores. Es la tentación al cambiar de lector, y el cálculo dice que no: sin ellos el sensor queda a +35 K.
La doble pared y el cajón extraíble. Cuestan unos 11 K sin ventilación, pero con ventilación dejan de importar: el calor se va con el aire.
El doble policarbonato de la pantalla. Aísla el frente, pero protege lo más frágil que queda a la vista y con ventilación tampoco limita.
La chapa de 3 mm. Reparte muy bien el calor: la zona del cajón de pajitas saca 2,6 W sin generar ninguno.

# 14 Plan de ensayo

Es el ensayo E1 del Bloque 1, ampliado para que además diga si este modelo acierta. Necesita una carcasa de prototipo con el cajón montado y el Sigma puesto en su hueco.

### 14.1 Instrumentación

Sonda | Dónde | Para qué
T0 | Aire de la sala, a 1 m de la máquina y a su altura, a la sombra | Referencia
T1 | Aire junto al sensor ZE29A | El dato que decide
T2 | Aire junto al módem | Segunda pieza de 40 °C; la que limita con ventilación
T3 | Aire a 1 cm de la trasera del Sigma | Comprobar que el terminal va holgado
T4, T5, T6 | Aire en el eje del cajón, a 20, 110 y 210 mm de su base | Media y reparto en altura
T7 | Aire dentro de la caja de red | Fuente y convertidor
T8 | Chapa exterior, centro del lateral derecho, pegada con cinta | Comprobar que por fuera apenas se nota
T9 | Aire en la boca de salida | Caudal real, por balance
— | vcgencmd measure_temp, registrada cada minuto | Procesador de la Pi
— | Vatímetro de enchufe y un medidor en los 12 V del Sigma Potencia real, total y del terminal

Valen termopares tipo K con un registrador o diez DS18B20 en un mismo bus leídas por la propia Pi.

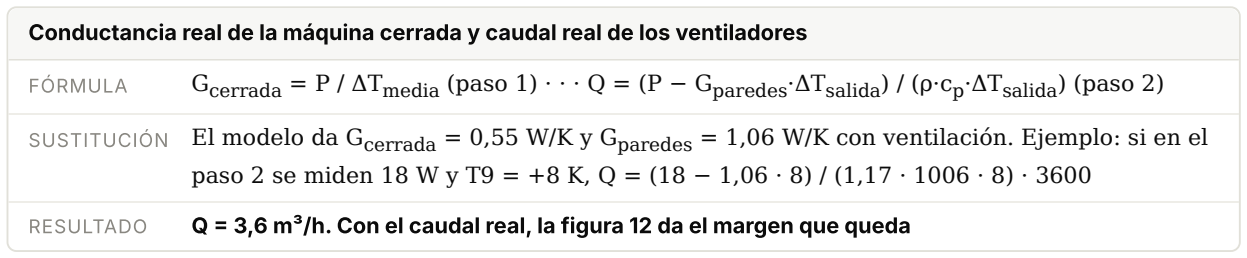
[picture p34: figure]
FÓRMULA; Gcerrada = P / ΔTmedia; (paso 1) · · · Q = (P − Gparedes; ·ΔTsalida; ) (paso 2)

Estudio térmico del alcoholímetro · diseño A · revisión 2 (myPOS Sigma) · 13-11-2026 | 31 / 35

### 14.2 Pasos

Paso Qué se hace | Duración Lo que predice el modelo (sobre T0)
1 | Máquina cerrada en la pared, programa en espera con vídeo, Sigma encendido, ventiladores parados y todas las aberturas tapadas con cinta. Sin el sensor ni el módem: en su sitio, resistencias de 0,5 y 2 W. Son las dos piezas a las que este paso sacaría de ficha | 3 h | T1 ≈ +43 K; media de T4–T6 ≈ +37 K; T3 ≈ +43 K; T8 ≈ +9 K. Parar si T3 pasa de 65 °C: con la sala a más de 22 °C ocurrirá antes de estabilizar, y vale igual
2 | Quitar la cinta, poner el sensor y el módem, ventiladores en marcha | 2 h | T9 ≈ +7 K (de +6 a +10); T1 ≈ +2 K; T2 ≈ +5 K; T3 ≈ +7 K
3 | Desenchufar un ventilador | 1 h | T9 ≈ +9 K
4 | Tapar media malla de entrada y media de salida | 1 h | T9 ≈ +9 K
5 | Parar los dos ventiladores con las aberturas libres y cronometrar | 30 min | T1 llega a T0 + 15 K en unos 9 minutos
6 | Cobros reales de prueba con el Sigma cada 2 minutos durante 30 minutos, anotando lo que gasta | 30 min | Sin cambio apreciable sobre el paso 2

### 14.3 Criterio de aceptación

Paso 2: T1 a menos de 5 K sobre la sala y T2 a menos de 8 K. Es el criterio del Bloque 1, con el módem añadido y sin el lector, que ya no decide.
Paso 3: T1 a menos de 8 K sobre la sala con un ventilador parado.
Procesador de la Pi por debajo de 70 °C en el paso 2 con la sala a 25 °C.
Sigma: T3 a menos de 15 K sobre la sala en el paso 2.
Si el paso 2 no cumple: revisar el burlete y las mallas antes que nada. Después, ventilador de salida de 40 ×
| 20 mm.

### 14.4 Cómo corregir el modelo con las medidas

Conductancia real de la máquina cerrada y caudal real de los ventiladores

SUSTITUCIÓN El modelo da Gcerrada = 0,55 W/K y Gparedes = 1,06 W/K con ventilación. Ejemplo: si en el paso 2 se miden 18 W y T9 = +8 K, Q = (18 − 1,06 · 8) / (1,17 · 1006 · 8) · 3600

RESULTADO Q = 3,6 m³/h. Con el caudal real, la figura 12 da el margen que queda

Con la potencia medida y esos dos números se rehacen las tablas del apartado 9 en una tarde. Los scripts están preparados para ello (anexo B).

# 15 Conclusiones

1. Cambiar el Solo por el Sigma es una buena decisión para el calor, pero no por lo que parece. No enfría la máquina: la calienta unos 4 W más. Lo que hace es sacar de la lista la pieza que se rompía para siempre.
2. El problema térmico de fondo sigue igual. Doble pared, frente aislado, rejillas mínimas y dos piezas de 40 °C dentro, una de ellas arriba. Sin ventilador el sensor queda unos 35 K por encima del bar, y eso aguanta cualquier combinación razonable de parámetros.
3. La ventilación forzada lo sigue resolviendo: 5 m³/h dejan el sensor a +2 K, el módem a +5 K y el aire de salida a +7 K, con la entrada junto al sensor.
4. La temperatura que soporta la máquina ventilada no cambia: bares de 10 a 32 °C como especificación, con el límite real hacia 34 °C. Ahora mandan el módem y el sensor; el lector, con 70 °C, ya no.

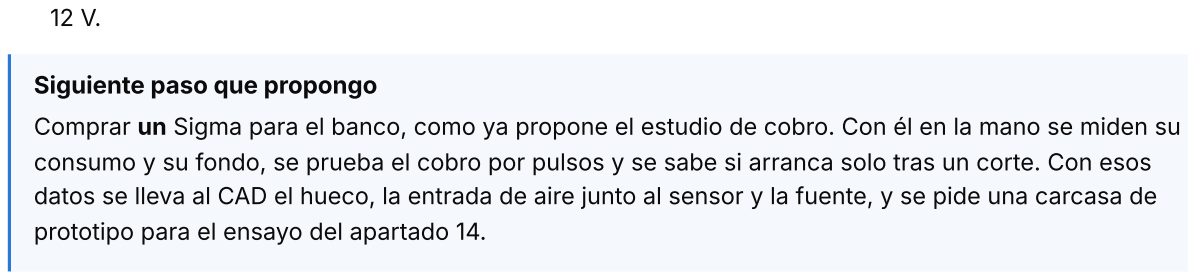
[picture p35: figure]
Siguiente paso que propongo

Estudio térmico del alcoholímetro · diseño A · revisión 2 (myPOS Sigma) · 13-11-2026 | 32 / 35
5. Una avería de la ventilación deja de ser irreversible. Sigue habiendo unos 9 minutos antes de que el sensor salga de rango, y el programa tiene que dejar de vender; pero nada se pierde.
6. Aparecen tres trabajos nuevos fuera del calor: el hueco del Sigma, que no cabe de pie en el frente de hoy; la fuente; y cómo para la Pi un cobro que ya no controla.
7. Y una incógnita nueva: lo que gasta el Sigma. Se resuelve con el aparato en el banco y un medidor en sus

Comprar un Sigma para el banco, como ya propone el estudio de cobro. Con él en la mano se miden su consumo y su fondo, se prueba el cobro por pulsos y se sabe si arranca solo tras un corte. Con esos datos se lleva al CAD el hueco, la entrada de aire junto al sensor y la fuente, y se pide una carcasa de prototipo para el ensayo del apartado 14.

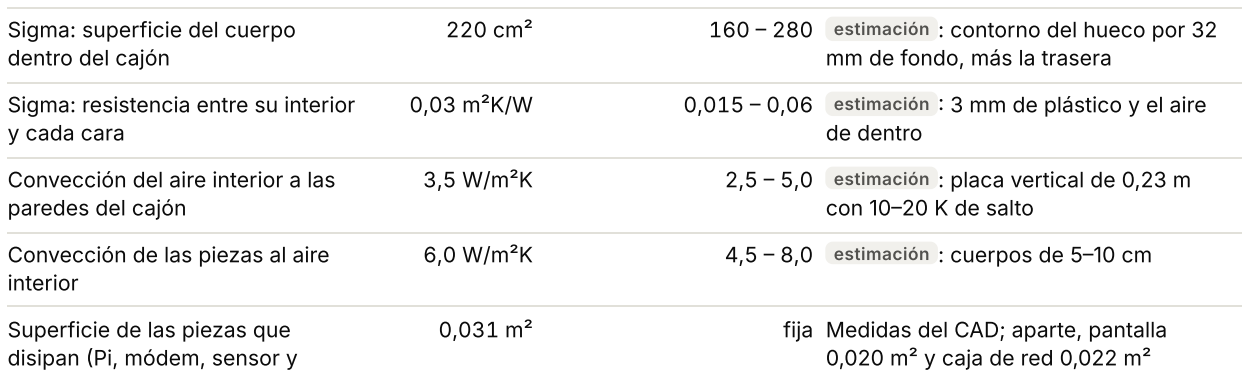
[picture p36: figure]
Sigma: superficie del cuerpo dentro del cajón; mm de fondo, más la trasera; Sigma: resistencia entre su interior y cada cara; de dentro; Convección del aire interior a las paredes del cajón; con 10–20 K de salto; Convección de las piezas al aire interior; Superficie de las piezas que disipan (Pi, módem, sensor y; 0,020 m² y caja de red 0,022 m²

Estudio térmico del alcoholímetro · diseño A · revisión 2 (myPOS Sigma) · 13-11-2026 | 33 / 35

# A Anexo: parámetros del modelo

Parámetro | Caso base Rango en los 1 500 casos Origen

Potencia total sin ventiladores
(con dos ventiladores, 0,7 W más)
20,0 W | 15 – | 27 W Apartado 3; reparto: fuente y
convertidor 5,78, pantalla 4,08, Pi, módem y sensor 7,14 y Sigma 3,00 W
220 cm² | 160 – | 280 | estimación : contorno del hueco por 32
0,03 m²K/W | 0,015 – | 0,06 | estimación : 3 mm de plástico y el aire
3,5 W/m²K | 2,5 – | 5,0 | estimación : placa vertical de 0,23 m
6,0 W/m²K | 4,5 – | 8,0 | estimación : cuerpos de 5–10 cm

cámara)

0,031 m² | fija Medidas del CAD; aparte, pantalla

Factor de visión de las piezas hacia las paredes

0,7 | 0,5 – | 0,9 | estimación

Emisividad exterior (pintura en polvo y policarbonato)

0,90 | 0,85 – | 0,95 Tablas de emisividad

Emisividad de la cara interior de la carcasa

0,85 | 0,60 – | 0,92 | supuesto : la pintura entra en la carcasa
abierta
Emisividad del cajón, sin pintar | 0,30 | 0,20 – | 0,45 Tablas: acero laminado 0,24;
galvanizado 0,28
Emisividad del cajón, pintado | 0,90 | 0,80 – | 0,95 Tablas

Conducción en los huecos de aire
(multiplicador)
1,2 | 1,0 – | 1,6 | estimación : 1,0 es aire quieto

Convección exterior (multiplicador
por el aire del bar)
1,15 | 1,0 – | 1,5 | estimación
Conductancia hacia la pared | 0,35 W/K | 0,1 – | 1,0 | cálculo : pladur, ladrillo y hormigón

Conductividad del acero y calidad
térmica de las uniones por puntos
50 W/m·K; 0,5 | 45 – | 55; 0,3 – | 1,0 | dato general ; estimación : 1 sería chapa
continua

Contacto de la fuente con la trasera del cajón

1,0 W/K | 0,3 – | 3,0 | estimación : 81 cm² de contacto seco

Contacto de la tapa y de la tapa interior con la carcasa

0,10 W/K | 0,03 – | 0,30 | estimación

Rejillas: área de cada una y coeficiente de descarga

2,54 cm²; 0,65 | 0,55 – | 0,75 CAD; dato general

Fugas de aire por arriba (holgura de la tapa interior)

0,5 cm² | 0 – | 2 cm² estimación

Reparto en altura: aire de arriba respecto a la media

1,30 | 1,15 – | 1,45 | estimación ; a la altura del sensor
resulta 1,17

Caudal con dos ventiladores, y mejora de la convección interior con aire forzado

5,2 m³/h; × 1,25 | 3,5 – | 6,5; fija cálculo , apartado 8.1; estimación

Fracción del calentamiento de salida que ven el sensor y el módem

0,30 y 0,70 | 0,15 – | 0,50 y 0,50 – | 0,90 | estimación

Estudio térmico del alcoholímetro · diseño A · revisión 2 (myPOS Sigma) · 13-11-2026 | 34 / 35

# B Anexo: cómo repetir el cálculo

Todo el estudio sale de unos scripts de Python (NumPy y Matplotlib). Están en el repositorio, en carcasa/diseno-A/estudio-termico/codigo/.

Archivo | Qué hace
termico.py | El modelo: propiedades del aire, correlaciones, la red de nodos, el estado estacionario y el transitorio. Todos los parámetros están en la clase P. Con sigma=True añade el terminal; con sigma=False es el modelo de la revisión 1
analisis_conf.py | Las cargas y las configuraciones: con el Sigma (sin ventilador, pintado, sellado y las tres con ventilador), las cuatro fuentes y la versión del Solo para comparar
analisis.py | Corre todos los casos: configuraciones, potencia, caudal, sensibilidad, los 1 500 casos al azar, márgenes, sol, funda, frío y transitorios. Escribe resultados.json
calc.py | Las cuentas paso a paso que aparecen en los recuadros
fig_*.py, estilo.py | Las figuras
informe.py, estilo.css | Montan este documento con los números de resultados.json

Para rehacerlo con datos medidos basta cambiar en analisis_conf.py el consumo del Sigma (P_SIGMA), las cargas en 5 V (C5), los rendimientos y el caudal (Q_fan), y en termico.py los coeficientes que el ensayo corrija. Después: python3 analisis.py, python3 calc.py, los fig_*.py y python3 informe.py.

Si cambia la geometría (aberturas, huecos, espesores, posición del Sigma), las cotas están al principio de la clase P, con los mismos valores que en carcasa/diseno-A/modelo/diseno.py.

La revisión 1, con el Solo, está en historico-solo/: su informe en PDF y la referencia al commit con su código y sus resultados.

# Fuentes

### Del proyecto

CAD del diseño A (04-11-2026): carcasa/diseno-A/modelo/diseno.py, specs.py, geo.py y comp.py; carcasa/diseno-A/README.md; vistas de carcasa/diseno-A/FreeCAD/.
Alternativas al SumUp Solo para el cobro (13-11-2026): componentes/alternativas-cobro/ en la rama claude/alternativas-cobro (PR n.º 3), opción 3, myPOS Sigma.
Revisión de componentes eléctricos, Bloque 1 (13-11-2026): componentes/REVISION-13-11-2026.md y componentes/cuentas.py.
DECISIONES.md, entradas del 27-10 al 13-11-2026.
Fichas de componentes/: Winsen ZE29A, módem Huawei E3372h, Raspberry Pi 3B+, Camera Module 3, pantalla GeeekPi, Mean Well LRS-50-5 y SumUp Solo.
Revisión 1 de este estudio, con el Solo: historico-solo/.

### Del Sigma y de las fuentes, consultadas el 13-11-2026

myPOS, ficha del Sigma (12–48 V en continua; 146 × 101 × 57 mm; hueco de 108,7 × 86,4 mm; 490 g; de −20 a 70 °C; IP65 e IK08): mypos.com/en-gb/buy-card-machine/unattended-payment-solution; folleto: merkato.com, Sigma Device Brochure (https://merkato.com/wp-content/uploads/2024/07/Sigma-Device-Brochure-EN.pdf)
myPOS Developers, comunicación por pulsos (patillas de alimentación, salidas de pulso y entradas): developers.mypos.com/in-person-payments/unattended-solutions/pulse-communication
Nexgo UN20, hoja de producto (mismas medidas, hueco, alimentación y puertos que el Sigma; sensores de proximidad y de luz): nexgoglobal.com, UN20 versión 5.2; (https://www.nexgoglobal.com/static/upload/file/20240516/1715846950543668.pdf) reposo hasta que se acerca alguien: paytec.ch/en/products/unattended-payment-terminals/un20 (https://www.paytec.ch/en/products/unattended-payment-terminals/un20)

Estudio térmico del alcoholímetro · diseño A · revisión 2 (myPOS Sigma) · 13-11-2026 | 35 / 35

Tienda que cataloga el Sigma como «interior, 10–40 °C»: kiosk.novoparts.hu (https://kiosk.novoparts.hu/en/spd/MyPOS_SIGMA/MyPOS-Sigma-unattenden-POS-terminal-with-MDB-inter)
PAX IM30, consumo de un terminal de la misma clase (menos de 650 mA de pico a 12 V): computop.com/en/point-of-sale/im30-pos-terminal (https://computop.com/en/point-of-sale/im30-pos-terminal/)
Mean Well, catálogo de la serie LRS (LRS-50-5: 83 %; LRS-50-12: 86 %; de −30 a 70 °C): meanwell.com/catalog, página
4 (https://www.meanwell.com/catalog/product/files/basic-html/page4.html)
Mean Well RD-50A (5 V y 6 A, 12 V y 2 A; 79 %; 99 × 97 × 36 mm): meanwellaustralia.com.au/products/RD-50; carga mínima de 0,3 A por salida: communica.co.za/products/rd-50a
Mean Well RSD-30G-5 (de 9–36 V a 5 V y 6 A; 84–85 %; sin reducción de − 40 a 55 °C): farnell.com, RSD-30G-5 (https://jp.farnell.com/en-JP/mean-well/rsd-30g-5/dc-dc-converter-5v-6a/dp/2816113) y cpc.farnell.com, RSD-30G-5 (https://cpc.farnell.com/mean-well/rsd-30g-5/dc-dc-converter-5v-6a/dp/PW05417)

### De fabricantes y normas, las de la revisión 1

SumUp, información de seguridad del Solo (rango de trabajo de 0 a 40 °C): manualslib.com/manual/3046632/Sumup-Solo.html; (https://www.manualslib.com/manual/3046632/Sumup-Solo.html?page=12) «Avoid blocked readers» (bloqueo permanente): help.sumup.com/en-IE/articles/1fH1DQy2SCfsXvrdb76MS0 Noctua, especificaciones del NF-A4x10 5V, NF-A4x20 5V y NF-A6x25 5V: noctua.at/en/nf-a4x10-5v/specification, noctua.at/en/nf-a4x20-5v/specification, noctua.at/en/nf-a6x25-5v/specification
Raspberry Pi, «Thermal testing Raspberry Pi 4» (consumo de la 3B+ en reposo y en carga): raspberrypi.com/blog/thermal-testing-raspberry-pi-4
Raspberry Pi, documentación de gestión térmica (límite blando de 60 °C y temp_soft_limit): github.com/raspberrypi/documentation/pull/1348; valor máximo de 70 °C: brainboxes.com/?p=2381
Rittal, catálogo técnico de climatización de armarios (k = 5,5 W/m²K para chapa de acero en interior): rittal.com/imf/none/3_8419; (https://www.rittal.com/imf/none/3_8419/3312800_Documentaci_oacute_n_t_eacute_cnica_EN) fórmula del área eficaz para montaje contra pared: storage.electrika.com/flips/0700-univ-encl-15 (https://storage.electrika.com/flips/0700-univ-encl-15/files/assets/basic-html/page-521.html)
IEC TR 60890:2022, método de cálculo del calentamiento del aire en envolventes: standards.iteh.ai (IEC TR 60890:2022) (https://standards.iteh.ai/catalog/standards/iec/7a954d7c-2b57-4c93-8b3b-f930bc8b227c/iec-tr-60890-2022) Plancha de policarbonato extruido, datos técnicos (0,2 W/m·K; 115 °C en uso continuo): Impex, guía de producto 08-2022 (https://cdn.shopify.com/s/files/1/0468/4742/6721/files/EN_IMPEX_ProductGuide_08-2022.pdf) 3M, cinta VHB 4949 (93 °C a largo plazo, 149 °C a corto): 3m.com/3M/en_US/p/d/b40072029
Battery University, BU-808 (capacidad tras un año según temperatura y carga): batteryuniversity.com/article/how-to-prolong-lithium-based-batteries (https://batteryuniversity.com/article/how-to-prolong-lithium-based-batteries)
XP Power y TDK, vida de los condensadores electrolíticos (se dobla cada 10 °C menos): xppower.com/resources/blog/electrolytic-capacitor-lifetime-in-power-supplies, product.tdk.com/en/contact/faq/power-supplies-0018.html (https://product.tdk.com/en/contact/faq/power-supplies-0018.html)
Tablas de emisividad: blog.thermoworks.com/emissivity
Umbral de quemadura por contacto con metal (ASTM C1055 e ISO 13732-1, citadas en un trabajo de NACE): Insulative Coating Evaluation, NACE (https://www.electro-tech-online.com/custompdfs/2013/09/Insulative_Coating_Evaluation_NACE.pdf)
Real Decreto 1826/2009, que modifica el RITE (IT 3.8.2: 21 °C en calefacción y 26 °C en refrigeración): boe.es/eli/es/rd/2009/11/27/1826/con

### De manual

Convección natural en placa vertical: correlación de Churchill y Chu (1975). Capa de aire horizontal calentada por abajo: Hollands y otros (1976). Placas horizontales, aletas y radiación entre superficies grises: como las recoge cualquier texto de transmisión de calor (por ejemplo, Incropera y DeWitt).
