GuillermoAladro/Alcoholimetro/carcasa/diseno-A/calculo-anclajes/Informe_anclajes_alcoholimetro.pdf

Alcoholímetro · diseño A · optimización del patrón de anclaje a pared | pág. 1

# Patrón de anclaje a pared del alcoholímetro

Investigación matemática, computacional y estructural · diseño A, rama programa-raspberry · 04/11/2026

Recomendación. Fabricar la trasera con el patrón Óptimo P18-3: 18 agujeros Ø6,5 en las coordenadas de la tabla 5 (x desde el eje, z desde la base). En el modelo de elementos finitos (chapa flexible + contacto con la pared, envolvente de bordes) su factor de carga frente a la envolvente de diseño es λ = 10,56, frente a 5,79 del patrón anterior de 3 × 6 (C), 6,33 del A y 6,00 del B: 82 % más capacidad que el anterior con el mismo número de tornillos, sin tocar la electrónica, pestañas, soldaduras ni cajones. La mejora sale de llevar los tornillos junto a las partes rígidas de la caja (pliegues laterales, pestaña de la bandeja y canto superior) en vez de repartirlos por el centro de la chapa, que aun con 3 mm es flexible y hace palanca contra la pared. Es simétrico, así que se replantea y se comprueba fácil. Es el mejor patrón encontrado por una búsqueda heurística reproducible; no está demostrado que sea el óptimo global.

| C (3 × 6, anterior) | A (algebraico
| | anterior) | B (P18 anterior) | Óptimo P18-3
Tornillos / separación mínima (mm) | 18 / 50,0 | 18 / 46,5 | 18 / 55,0 | 18 / 50,0
λ envolvente (FEM, hormigón) | 5,79 | 6,33 | 6,00 | 10,56
Caso que gobierna | Tirón normal 500 N
| TR | Tirón normal 500 N
| | TR | Tirón normal 500 N
| | | TR | Cuelgue 80 kg ×2 en
| | | | el borde delantero

F máx. tornillo, tirón 300 N esquina sup.
dcha. (N) | 149 | 136 | 143 | 79
Ídem esquina sup. izqda. (N) | 94 | 105 | 102 | 54

Tirón admisible esq. sup. dcha. — hormigón
(N) | 3.020 | 3.265 | 3.114 | 5.997
Ídem — ladrillo macizo Mz 12 (N) | 1.600 | 1.731 | 1.650 | 3.187
Ídem — ladrillo perforado HLz 12 (N) | 789 | 854 | 814 | 1.582

Tirón en esq. sup. dcha. con 1.ª
plastificación local de la chapa (Re 140 MPa) (N) | 1.257 | 1.205 | 1.187 | 1.775
Capacidad que queda sin los 2 tornillos peores | 69 % | 61 % | 63 % | 67 %

Tabla 1. Resumen. λ = F
rec

/ (fuerza máxima en un tornillo) para el peor caso de la envolvente (tirones de 500 N en esquinas, centro, base, oblicuos y laterales, y una persona de 80 kg colgada con factor dinámico 2, todo con un peso propio de cálculo de 18 kg). Los tirones admisibles se calculan con el peso fijo y la carga recomendada de fischer de un taco SX Plus 8×65 (que ya incluye sus coeficientes de seguridad). No son cargas certificadas del conjunto.

### Lo que cambia respecto al cálculo con chapa de 2 mm (03-11-2026)

- Chapa: la trasera pasa de 2 a 3 mm (rigidez a flexión × 3,4) y el cajón de componentes y la tapa interior, de 2 a 1,5 mm. La masa de cálculo sube de 15 a 18 kg (12,5 kg de acero, 15,5 kg estimados con todo).
- Geometría: las guías traseras ya no son angulares sino pletinas planas de 12 mm en x = ±70, y el apoyo

trasero de la tapa interior es una pletina plana soldada con MIG por su canto (z = 404,5–407,5). Las zonas para taladrar cambian (§1) y los agujeros de x = ±85 de A, B y C quedan pegados a las guías nuevas (la arandela toca su canto): esos tres patrones ya no se podrían taladrar tal cual; se calculan sólo como referencia.
- Búsqueda: se repite sólo para n = 18 (el número de tornillos no cambia), con 7 recocidos y el óptimo de 2 mm (P18-O) como candidato. Ahora gana un patrón simétrico: llega al 96 % del mejor libre con la malla fina, por encima del 95 % que se pedía para preferirlo.
- Con chapa flexible, el patrón C da 149 N en el tornillo más cargado con 300 N en la esquina derecha y 94 N en la izquierda; con chapa rígida, 68 N. La chapa de 3 mm sigue sin comportarse como rígida (§2.2 y §6).
- La caja no es simétrica: bajo z = 150 el lateral izquierdo no existe (hueco del cajón de pajitas) y el suelo plegado sólo está unido a la caja por la esquina derecha. Por eso el tirón en la esquina superior derecha gobierna en C, A y B; en el ganador gobierna «Cuelgue 80 kg ×2 en el borde delantero».
- En hormigón la chapa de 3 mm todavía se deforma de forma permanente junto a las arandelas superiores antes de que mande el taco: a ≈ 1.775 N de tirón en la esquina con el ganador (1.257 N con C), frente a 5.997 N que admitirían los tacos. Con 2 mm pasaba a ≈ 900 N con el P18-O. Se arregla con una pletina local, no moviendo tornillos (§6).
- El tipo de pared manda más que el patrón: el mismo patrón admite tirones unas 4 veces menores en ladrillo perforado que en hormigón, y en ladrillo hueco horizontal y en pladur fischer no da valores para este taco (§5).

Alcoholímetro · diseño A · optimización del patrón de anclaje a pared | pág. 2

## 1. Datos de partida: comprobados, de fabricante, estimados e hipótesis

Dato | Valor | Estado / fuente
Carcasa (ancho × fondo × alto) | 220 × 100 × 442,5 mm | Comprobado en diseno.py / specs.py (W, D, Hw + T)
Trasera: alto de chapa | 439,5 mm (Hw = 407,5 + 1,5 + 30,5) | Comprobado: Ktop = 401,5; zi0 = 407,5; TK = 1,5;
BANDA = 30,5

Chapa

DC01; trasera y caja de 3 mm, cajón de componentes y tapa interior de 1,5 mm; pliegues 90°, radio interior = espesor

Comprobado (T = 3,0, TK = 1,5; Lista_de_piezas.xlsx del 04-11-2026)

Masa de chapa | 12,52 kg | Calculado: suma de las 29 piezas de acero de la lista
(24 de 3 mm y 5 de 1,5 mm)
Chapa + policarbonato | 13,09 kg | Calculado: + 4 piezas de PC (0,57 kg)
Masa con electrónica y herrajes | ≈ 15,5 kg | Estimado (tabla 2); cálculo con 18 kg
Centro de gravedad | x ≈ 0; z ≈ 210 mm; a unos 50 mm de la
pared

Estimado por reparto de masas; cálculo a 55 mm (sensibilidad 45–65)

Patrón anterior (C) | x = −85, 0, 85; z = 25, 75, 125, 205, 295,
391,5

Comprobado: fijaciones_pared(W, Ktop − 10) hasta el 03-11-2026

Agujeros / taco / tornillo / arandela

Ø6,5 / SX Plus 8×65 / DIN 571 6×80 / DIN
9021 M6 (Ø18) | Comprobado (ANCLAJE-PARED-8x65.md)

SX Plus 8×65: taladro, h1, hef,
tornillo | Ø8; ≥ 75 mm; 65 mm; Ø4,5–6,0 | Fischer (ficha técnica SX Plus, 16/05/2023)
SX Plus 8×65: cmin en hormigón | 50 mm | Fischer (tabla de cargas SX Plus)

SX Plus 8×65: separación mínima
smin
no publicada | Hipótesis: 50 mm (= cmin); variante con 100 mm en
§3.3b

Carga recomendada F
rec (tracción, cortante y combinada) | ver tabla 3 | Fischer; incluye coef. de seguridad; un solo taco

Rigidez axial del anclaje k
a
2000 N/mm (500–10 000) | Hipótesis (fischer no la publica); sensibilidad en §2.4

Rigidez de contacto pared k
w
50 N/mm³ (5–500) | Hipótesis (Winkler); sensibilidad en §2.4
DC01: límite elástico | Re ≤ 280 MPa; mínimo de cálculo 140 MPa;
Rm 270–410 | Hoja de material thyssenkrupp (EN 10130)

Tabla 1b. Datos de partida.

### Masa estimada con electrónica (tabla 2)

Grupo | Masa (kg) | Base de la estimación

Chapa DC01: 24 piezas de 3 mm (10,67 kg) y
5 de 1,5 mm (1,85 kg) | 12,52 | Lista_de_piezas.xlsx del 04-11-2026 (dato del repositorio)
Policarbonatos (4 piezas) | 0,57 | Lista_de_piezas.xlsx (dato del repositorio)

Pantalla 7", SumUp Solo, Pi 3B+, cámara,

módem 4G, fuente LRS-50-5, sensor ZE29A | 0,88 | Estimación por componente: 0,30 + 0,20 + 0,05 + 0,005 + 0,04 + 0,18
| | + 0,10

Toma C14, WAGO, fusibles, bornes, antena,
tubos y latón | 0,19 | Estimación

Cableado (HDMI, USB, manguera 3G1,5,
2×0,75) | 0,25 | Estimación

Herrajes: bisagra, 2 candados ABUS 65/30,
cerradura, silentblocks, topes, tornillería | 0,48 | Estimación
Pintura en polvo | 0,13 | Calculado: ≈ 1,25 m² × 70 µm × 1,5 g/cm³
Pajitas y consumibles en el cajón | 0,50 | Hipótesis
Total estimado | 15,52 | Se calcula con 18 kg (≈ +16 % de margen)
Tabla 2. Las masas de chapa y policarbonato son datos del repositorio; el resto son estimaciones de orden de magnitud (no proceden de fichas técnicas) y deberían sustituirse por la pesada del primer prototipo.

Alcoholímetro · diseño A · optimización del patrón de anclaje a pared | pág. 3

### Cargas recomendadas de fischer para un SX Plus 8×65 con tornillo de Ø6 (tabla

3)

Material de la pared | Frec
(kN) | Observaciones del fabricante
Hormigón ≥ C20/25 | 1,50 | cmin = 50 mm a cantos de la pared
Ladrillo macizo ≥ Mz 12 | 0,80
Silicocalcáreo macizo ≥ KS 12 | 1,50
Silicocalcáreo perforado ≥ KSL 12 | 0,80
Ladrillo perforado vertical ≥ HLz 12 | 0,40 | También Doppio UNI 19. Taladrar sin percusión
Bloque hueco de hormigón ligero (enlucido) | 0,30 | Sepa Parpaing; carga determinada en pared enlucida
Hormigón celular ≥ AAC 4 | 0,40
Hormigón celular ≥ AAC 2 | 0,15
Ladrillo hueco horizontal (Forato F8) | — | Sin valor para 8×65 (para 8×40: 0,10 kN, pared enlucida)
Placa de yeso (pladur) | — | La ficha la cita como soporte, pero la tabla de cargas no da valor
Tabla 3. Valores para un taco aislado, en material seco, hasta +24 °C (+40 °C corto plazo), válidos para tracción, cortante y combinada, con los coeficientes de seguridad ya incluidos. No se colocan en juntas de mortero; en ladrillo hueco, taladrar sin percusión. Fischer no publica el coeficiente global aplicado, ni la separación mínima entre tacos, ni la rigidez.

### Zonas donde se puede taladrar

Se ha recorrido la geometría de diseno.py para dejar libres todas las piezas que tocan la trasera por dentro. El centro de cada agujero debe quedar a ≥ 11 mm (radio de la arandela + 2 mm) de cualquier pestaña o soldadura y en la parte plana:
- Z1 (detrás del cajón de pajitas): x ∈ [−93, 93], z ∈ [20, 139,5]. Debajo, el pliegue del suelo (radio 3); encima, la pestaña de 13 mm de la bandeja soldada a la trasera (z = 150,5–163,5). Las cabezas (≈ 5,6 mm con la arandela) caben en los 8 mm libres detrás del cajón (quedan 3,4 mm).
- Z2 (detrás del cajón de componentes): x ∈ [−93, 93], z ∈ [174,5, 393,5], excepto |x| entre 54 y 86 mm a la altura de las guías traseras (pletinas planas de 12 mm soldadas por puntos en x = ±64…76, z = 173,5–391,5) y un círculo de 16 mm alrededor del espárrago de tierra (50; 376,5). Arriba, el apoyo trasero de la tapa interior (pletina de 3 mm en z = 404,5–407,5, soldada con MIG por su canto). Holgura cabeza–cajón: 3,9 mm.
- Z3 (franja superior, encima del cordón del apoyo de la tapa interior): z ∈ [420,5, 429,5]. Accesible con la tapa abierta; el canto superior es libre (la tapa sólo apoya). Distancia al canto ≥ 10 mm = 1,5 d0
- |x| ≤ 93: la cara interior de los laterales está en ±107 y el pliegue (radio 3) termina en ±104; con la arandela de Ø18 y una llave de vaso o de estrella de 10 mm no conviene acercarse más.
- Para llegar a los agujeros hay que sacar los dos cajones (el procedimiento de montaje ya lo exige).

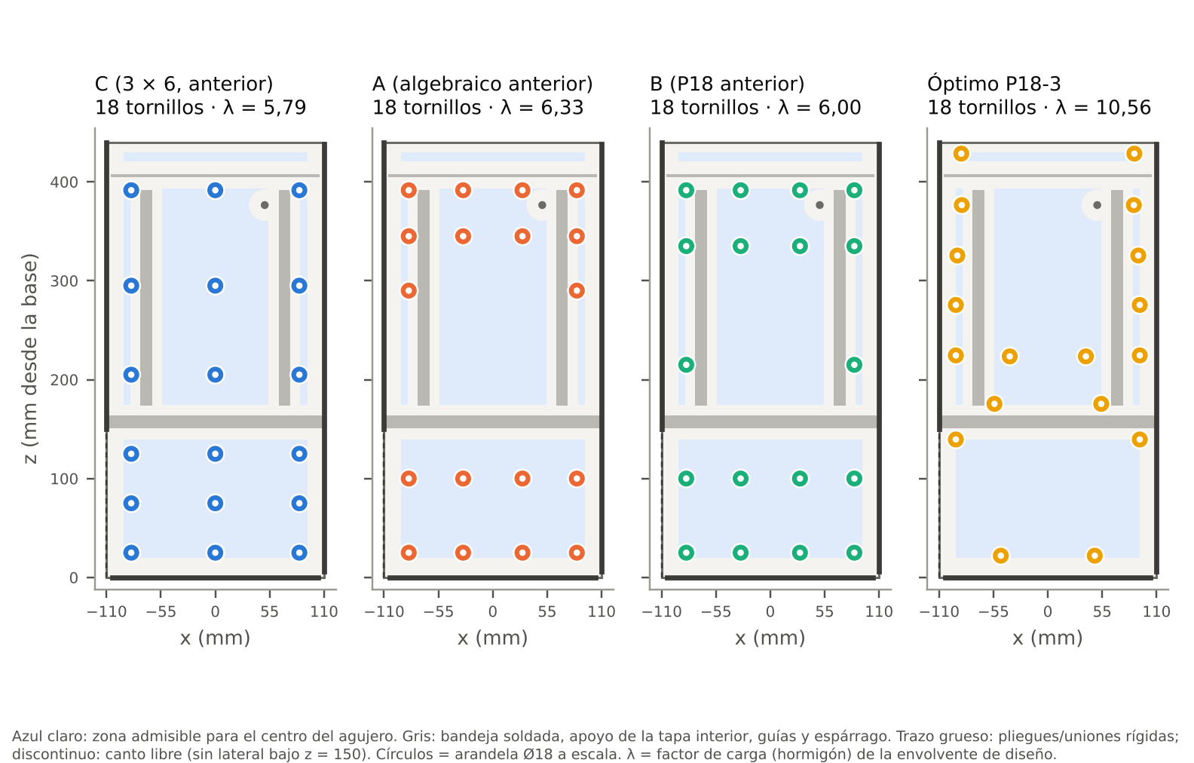
[picture p37: figure]

Alcoholímetro · diseño A · optimización del patrón de anclaje a pared | pág. 4

Figura 1. Los cuatro patrones a la misma escala sobre la trasera vista desde delante.

Alcoholímetro · diseño A · optimización del patrón de anclaje a pared | pág. 5

## 2. Modelos de cálculo e hipótesis

Ejes: x horizontal en la pared (+ derecha, mirando la máquina), z vertical desde la base, n normal a la pared (+ hacia fuera). Toda fuerza se expresa en newtons: una masa m produce F = m·g = m·9,81 N. Una fuerza aplicada a una distancia n de la pared o desplazada del eje genera momentos M = F·e que se reparten entre tracciones de anclajes y compresión de la chapa contra la pared.

Acciones generalizadas sobre la caja: Qn
= ΣF
n

; Mvuelco = Σ(z·F
n

− n·F
z

); Mvertical = Σ(x·F
n

− n·F
x

); y en el plano
Vx

, Vz

y el torsor T = Σ(z·F
x

− x·F
z

). Ejemplo: peso propio de cálculo 18 kg → F = 177 N a 55 mm → M = 177 × 0,055 = 9,7 N·m.

### 2.1 Modelo de elementos finitos (resultados «FEM»)

- Chapa trasera de 3 mm como placa delgada de Kirchhoff con elementos rectangulares ACM de 12 GDL (malla de 2,5 a 20 mm). Verificación: placa cuadrada apoyada con carga central, error 0,2 % con 32×32 elementos frente a Timoshenko (0,0116·P·a²/D).
- La caja (laterales, frontal, bandeja, tapa) es un sólido rígido unido a la chapa en las líneas reales: pliegue derecho (z = 6–438), pliegue izquierdo sólo en z = 150–439,5, franja de la pestaña soldada de la bandeja (z = 150,5–163,5). El suelo plegado es una viga rígida en su plano unida a la caja sólo en la esquina derecha (puede girar). Canto superior y canto izquierdo bajo z = 150: libres.
- Bordes laterales: dos hipótesis extremas — apoyado (el pliegue gira libre) y empotrado (el lateral, soldado al frontal, impide el giro). Todos los resultados de diseño toman el peor de los dos.
- Cada tornillo: muelle axial solo-tracción k
a

unido a una arandela rígida de Ø18. Contacto chapa–pared: muelles Winkler solo-compresión en todos los nudos (iteración de conjunto activo hasta que no cambia ningún estado).
- Cortante en el plano: chapa rígida en su plano, reparto elástico por traslación + torsión polar entre todos los

tornillos (holgura del agujero 0,25 mm radial; se supone que todos colaboran). Sin rozamiento y sin precarga del apriete (conservador).
- Combinación por tornillo: F = √(N² + V²) ≤ F
rec

, porque fischer da un único valor para cualquier dirección.

### 2.2 Modelo analítico de chapa rígida («rígido») y método clásico

Misma física con la chapa infinitamente rígida: 3 GDL (traslación normal y dos giros), anclajes solo-tracción y contacto unilateral sobre toda la trasera. Es la generalización correcta de la fórmula de libro. Como «clásico» se reproducen además las fórmulas de pivote en el canto inferior y de Navier biaxial respecto al centroide, que es lo que suele hacerse a mano. Ninguno de los dos detecta el efecto palanca de la chapa delgada.

Tirón normal 300 N
(sin peso) | Patrón | FEM (peor
| | borde) | Rígido | Pivote
| | | | inferior | Pivote inf. +
| | | | | lateral | Navier
Esquina sup. izqda. | C (3 × 6, anterior) | 94,2 | 68,3 | 56,9 | 99,2 | 103,6
Esquina sup. izqda. | A (algebraico anterior) | 105,5 | 54,5 | 40,0 | 83,3 | 79,6
Esquina sup. izqda. | B (P18 anterior) | 101,5 | 57,2 | 43,4 | 86,7 | 84,3
Esquina sup. izqda. | Óptimo P18-3 | 53,9 | 53,6 | 43,2 | 82,7 | 86,6
Esquina sup. dcha. | C (3 × 6, anterior) | 148,6 | 68,3 | 56,9 | 99,2 | 103,6
Esquina sup. dcha. | A (algebraico anterior) | 136,1 | 54,5 | 40,0 | 83,3 | 79,6
Esquina sup. dcha. | B (P18 anterior) | 143,5 | 57,2 | 43,4 | 86,7 | 84,3
Esquina sup. dcha. | Óptimo P18-3 | 79,0 | 53,6 | 43,2 | 82,7 | 86,6
Tabla 4. Tracción máxima en un tornillo (N) con los tres niveles de modelo. La tracción máxima del FEM es entre 1,0 y 2,5 veces la del modelo rígido (con 2 mm, entre 1,4 y 3): incluso con 3 mm la chapa no se comporta como rígida. La chapa se curva entre las líneas rígidas y los tornillos, y la parte de chapa que queda más allá de cada tornillo empuja contra la pared (efecto palanca): la suma de tracciones supera la fuerza aplicada y la diferencia la devuelve la pared en compresión.

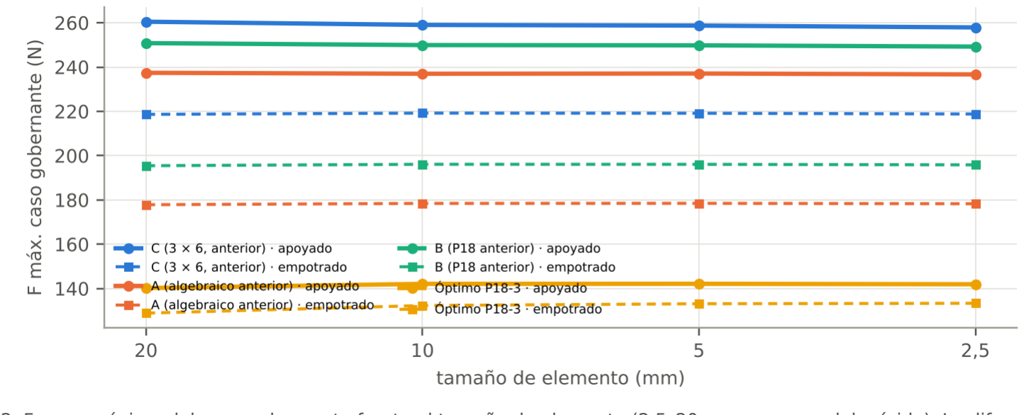
[picture p38: figure]

Alcoholímetro · diseño A · optimización del patrón de anclaje a pared | pág. 6

### 2.3 Convergencia de malla

Figura 2. Fuerza máxima del caso gobernante frente al tamaño de elemento (2,5–20 mm, con arandela rígida). La diferencia entre 5 y 2,5 mm es del 0,2 % en el ganador. Diseño y tablas: malla de 10 mm; búsqueda: malla de 20 mm sin arandela (≈ 5 % por debajo, mismo orden de patrones).

### 2.4 Sensibilidad a las hipótesis

Variante | C (3 × 6, anterior) | A (algebraico
| | anterior) | B (P18 anterior) | Óptimo P18-3
ka = 500 N/mm | 7,35 | 8,44 | 7,93 | 11,48
ka = 2000 N/mm (base) | 5,79 | 6,33 | 6,00 | 10,56
ka = 10000 N/mm | 4,66 | 4,82 | 4,69 | 9,22
kw = 5 N/mm³ | 5,37 | 6,03 | 5,68 | 9,69
kw = 500 N/mm³ | 6,00 | 6,47 | 6,16 | 10,96
CdG a 45 mm de la pared | 5,84 | 6,38 | 6,05 | 10,62
CdG a 65 mm de la pared | 5,75 | 6,28 | 5,96 | 10,50
Tabla 5a. λ de la envolvente al variar la rigidez del anclaje, la del contacto y la posición del CdG. La rigidez de los tacos es la hipótesis más influyente (tacos más rígidos atraen más carga y aumentan la palanca), pero el ganador es el mejor en todas las variantes, con entre 1,4 y 1,9 veces la λ del mejor de los otros tres.

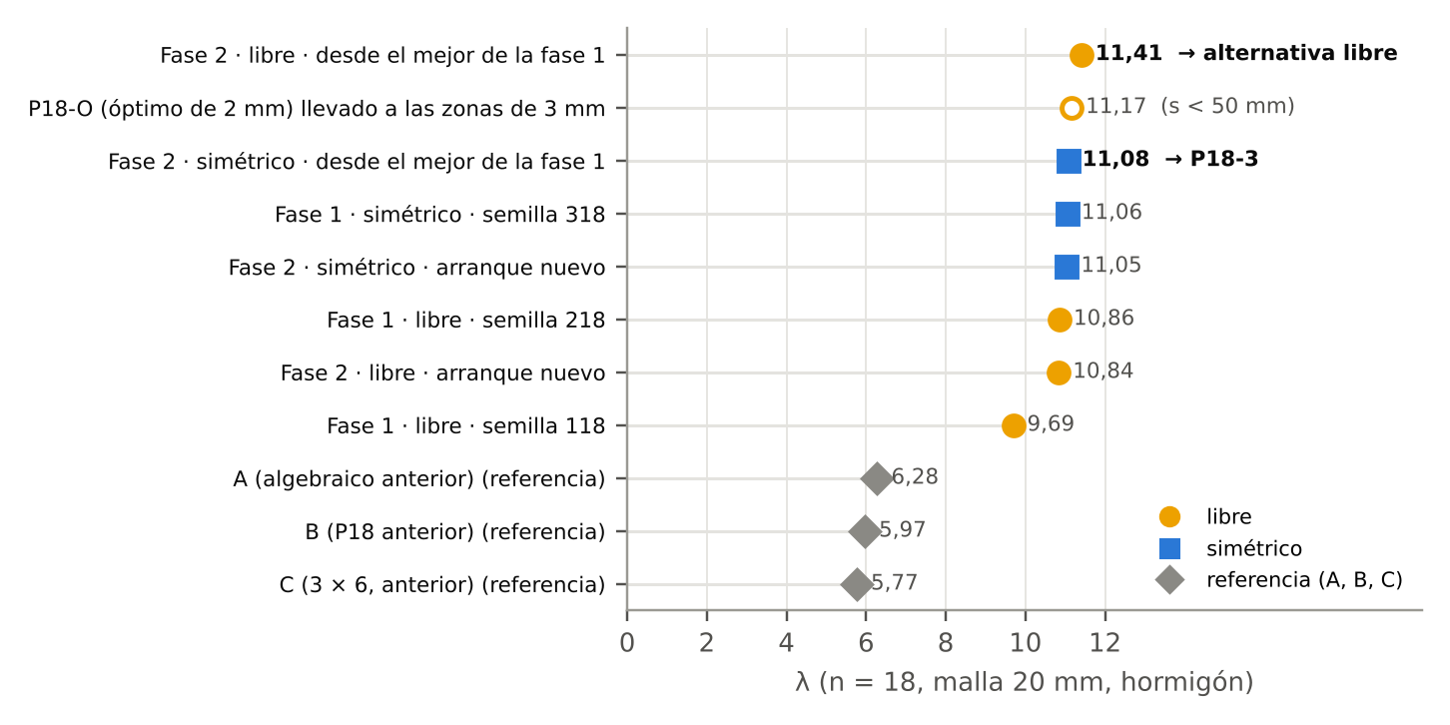
[picture p39: figure]

Alcoholímetro · diseño A · optimización del patrón de anclaje a pared | pág. 7

## 3. Optimización

### 3.1 Método

- Variables: coordenadas (x, z) de cada tornillo, continuas, proyectadas siempre a las zonas Z1–Z3; separación ≥ 50 mm como penalización. Patrones libres (asimétricos) y simétricos respecto a x = 0.
- Objetivo: maximizar λ = mín sobre 9 casos de diseño × 2 hipótesis de borde de F
rec

/Fmáx. No se optimiza
solo la tracción: la resultante incluye el cortante y entran casos de cuelgue y laterales.
- Algoritmo: recocido simulado con pulido final por coordenadas, sólo para n = 18. Primera fase: 2 arranques libres y 1 simétrico de 2000 iteraciones; además, el óptimo de 2 mm (P18-O) llevado a las zonas nuevas como candidato. Segunda fase: 4 recocidos de 4000 iteraciones (2 desde las mejores soluciones, libre y simétrica, y 2 desde arranques nuevos). Cada evaluación resuelve 18 problemas de contacto FEM (malla 20 mm, Cholesky en banda + Schur).
- Es un método heurístico. La dispersión entre arranques (figura 3) indica que no se puede afirmar que el resultado sea el óptimo global; sí que es claramente mejor que los tres candidatos previos con cualquiera de las hipótesis ensayadas.

Figura 3. λ de cada arranque de la búsqueda con n = 18 (malla de búsqueda de 20 mm, sin arandela) y de los patrones de referencia con la misma malla. El P18-O de 2 mm, llevado a las zonas de 3 mm, deja dos pares de agujeros a menos de 50 mm (48,4 y 49,5) y queda descartado. Con 3 mm no se ha repetido el barrido de 6 a 17 tornillos del estudio de 2 mm.

### 3.2 Lo que ha aprendido la búsqueda

- Los tornillos útiles son los que están pegados a las partes rígidas: columnas a ±87…93 mm (junto a los pliegues laterales), filas justo por encima y por debajo de la pestaña de la bandeja, y la franja Z3 bajo el canto superior (mayor brazo de palanca y menos chapa en voladizo). Es la misma lección que con 2 mm.
- La columna central x = 0 del patrón C trabaja muy poco en los tirones: la chapa entre los pliegues se curva y

en el centro aprieta contra la pared (figura 5).
- Con 3 mm, el mejor simétrico se acerca más al mejor libre que con 2 mm (96 % frente a 90 %); probablemente porque la chapa más rígida reparte mejor y la asimetría de la caja pesa menos. El límite |x| ≤ 93 sigue activo.

Alcoholímetro · diseño A · optimización del patrón de anclaje a pared | pág. 8

### 3.3 Patrón ganador: Óptimo P18-3

Nº x (mm, desde el
eje)

z (mm, desde la
base)

x desde el canto izqdo.
(mm) | Zona | F en tirón 500 N dcha. (N)
1 | -87,5 | 428,5 | 22,5 | Z3 | 86
2 | 87,5 | 428,5 | 197,5 | Z3 | 138
3 | -87,0 | 376,5 | 23,0 | Z2 | 70
4 | 87,0 | 376,5 | 197,0 | Z2 | 125
5 | -91,5 | 325,5 | 18,5 | Z2 | 61
6 | 91,5 | 325,5 | 201,5 | Z2 | 126
7 | -93,0 | 275,5 | 17,0 | Z2 | 42
8 | 93,0 | 275,5 | 203,0 | Z2 | 112
9 | -93,0 | 224,5 | 17,0 | Z2 | 23
10 | 93,0 | 224,5 | 203,0 | Z2 | 98
11 | -38,5 | 223,5 | 71,5 | Z2 | 13
12 | 38,5 | 223,5 | 148,5 | Z2 | 25
13 | -54,0 | 175,5 | 56,0 | Z2 | 21
14 | 54,0 | 175,5 | 164,0 | Z2 | 72
15 | -93,0 | 139,5 | 17,0 | Z1 | 0
16 | 93,0 | 139,5 | 203,0 | Z1 | 76
17 | -47,5 | 22,0 | 62,5 | Z1 | 13
18 | 47,5 | 22,0 | 157,5 | Z1 | 5
Tabla 5. Coordenadas exactas (también en el CSV adjunto). Taladro Ø6,5 en la chapa; origen de x en el eje vertical de la máquina, z desde la cara inferior; trasera vista desde delante.

### 3.3b Alternativas: versión libre y versión para mampostería

Patrón | n | smín (mm) | λ (FEM) | Tirón adm. dcha. hormigón /
HLz 12 (N)

Ladrillo 24×11,5×5: P(≥ 1 en junta) / máx. por pieza

Óptimo P18-3 | 18 | 50,0 | 10,56 | 5.997 / 1.582 | 100 % / 4
Libre (alternativa) | 18 | 50,0 | 10,94 | 6.216 / 1.641 | 100 % / 3
Mampostería n=12 (s ≥ 100) | 12 | 100,1 | 6,24 | 3.236 / 846 | 100 % / 2
Tabla 5b. La alternativa libre (asimétrica) rinde algo más, pero no llega al 5 % de ventaja que se pedía para renunciar a la simetría, que facilita replantear y comprobar los agujeros. La versión para mampostería separa los tacos ≥ 100 mm para que haya menos por pieza de ladrillo; con esa separación sólo caben 12 sin penalización en las zonas, así que tiene bastante menos capacidad en hormigón. Coordenadas de ambas en el anexo.

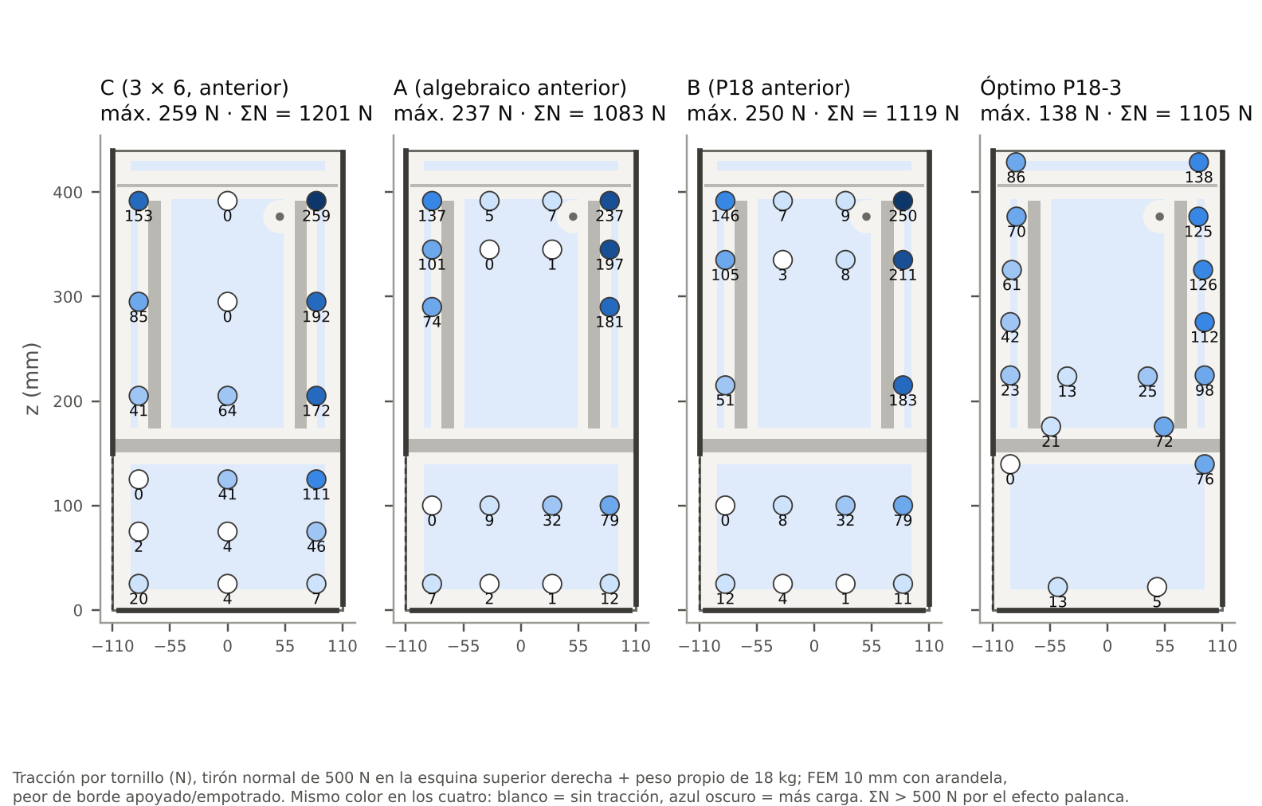
[picture p40: figure]
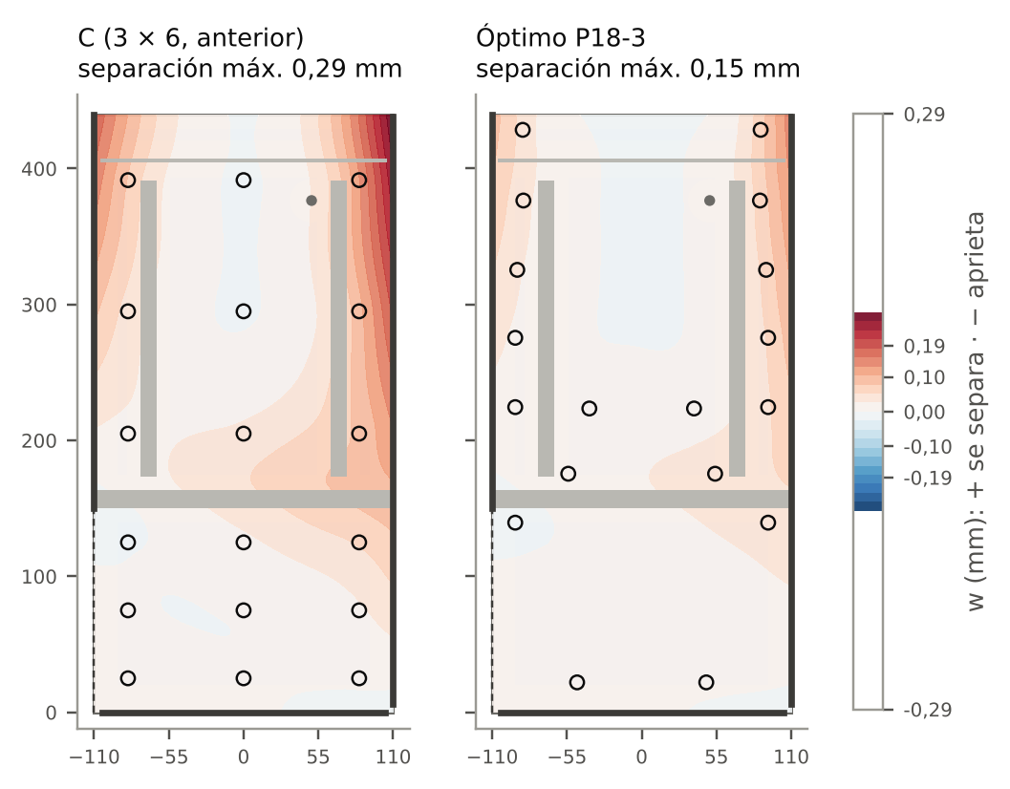
[picture p41: figure]

Alcoholímetro · diseño A · optimización del patrón de anclaje a pared | pág. 9

### 3.4 Distribución de fuerzas

Figura 4. Tracción por tornillo con el tirón que gobierna.

Concentración en las filas superiores (tirón de 500 N en la esquina derecha): fracción de la tracción total que llevan los tornillos con z ≥ 300 mm — C (3 × 6, anterior): 34 %; A (algebraico anterior): 63 %; B (P18 anterior): 66 %; Óptimo P18-3: 55 %. Los tres tornillos más cargados llevan 52 %; 57 %; 58 %; 35 % respectivamente.

Figura 5. Desplazamiento normal de la chapa (FEM 5 mm) con 500 N en la esquina superior derecha + peso. Rojo: se separa; azul: aprieta contra la pared (zonas de palanca).

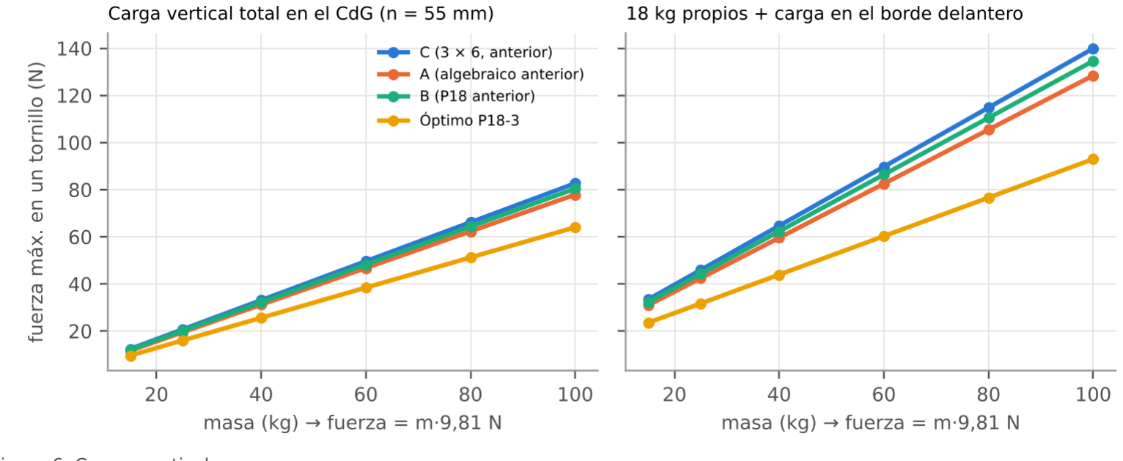
[picture p42: figure]

Alcoholímetro · diseño A · optimización del patrón de anclaje a pared | pág. 10

## 4. Simulación de situaciones reales (mismas condiciones para los cuatro)

### 4.1 Cargas verticales

Masa (kg) → F (N) | C (3 × 6, anterior): CdG / borde | A (algebraico anterior): CdG / borde | B (P18 anterior): CdG / borde | Óptimo P18-3: CdG / borde
15 → 147 | 12 / 33 | 12 / 31 | 12 / 32 | 10 / 24
25 → 245 | 21 / 46 | 19 / 42 | 20 / 44 | 16 / 32
40 → 392 | 33 / 65 | 31 / 60 | 32 / 62 | 26 / 44
60 → 589 | 50 / 90 | 47 / 83 | 48 / 86 | 38 / 60
80 → 785 | 66 / 115 | 62 / 105 | 64 / 110 | 51 / 77
100 → 981 | 83 / 140 | 78 / 128 | 80 / 135 | 64 / 93
Tabla 6. Fuerza máxima en un tornillo (N). «CdG»: toda la carga en el centro de gravedad (equivale a una máquina de esa masa). «Borde»: 18 kg propios + esa masa colgada del borde delantero superior (n = 100 mm). Incluye el cortante.

Figura 6. Cargas verticales.

### 4.2 Tirones horizontales (normales a la pared) de 100, 200, 300 y 500 N

Punto de tirón | F (N) | C (3 × 6, anterior) | A (algebraico
| | | anterior) | B (P18 anterior) | Óptimo P18-3
Esquina sup. izqda. | 100 | 39 | 40 | 39 | 23
| 200 | 69 | 75 | 73 | 40
| 300 | 100 | 110 | 106 | 58
| 500 | 163 | 180 | 174 | 94
Esquina sup. dcha. | 100 | 61 | 56 | 59 | 34
| 200 | 111 | 101 | 107 | 59
| 300 | 160 | 146 | 154 | 86
| 500 | 259 | 237 | 250 | 138
Centro | 100 | 26 | 23 | 25 | 16
| 200 | 37 | 36 | 37 | 21
| 300 | 49 | 50 | 50 | 27
| 500 | 76 | 77 | 81 | 47
Parte inferior | 100 | 19 | 25 | 23 | 21
| 200 | 40 | 57 | 51 | 45
| 300 | 62 | 89 | 81 | 69
| 500 | 106 | 155 | 139 | 119
Tabla 7. Fuerza máxima en un tornillo (N), con peso propio. Comparar con F
rec

: 1500 N hormigón, 800 N ladrillo macizo, 400 N ladrillo perforado HLz 12, 300 N bloque hueco.

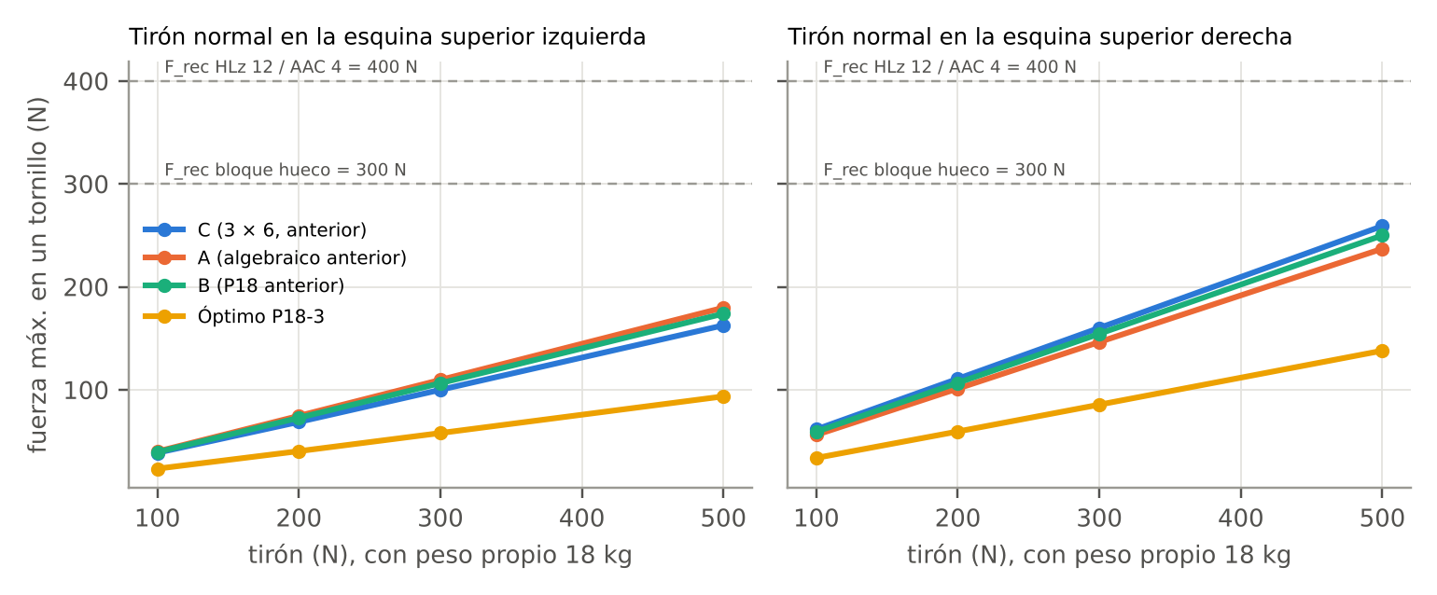
[picture p43: figure]

Alcoholímetro · diseño A · optimización del patrón de anclaje a pared | pág. 11

Figura 7. Tirones en las esquinas superiores.

### 4.3 Tirones laterales y oblicuos, personas y golpes

Situación | C (3 × 6,
| anterior) | A (algebraico
| | anterior) | B (P18 anterior) | Óptimo P18-3

Tirón lateral 300 N arriba (torsión + vuelco
lateral) | 69 | 57 | 57 | 53
Tirón oblicuo 45° 300 N esquina dcha. | 109 | 95 | 101 | 65

Tirón lateral 500 N arriba (torsión + vuelco
lateral) | 114 | 94 | 96 | 86
Tirón oblicuo 45° 500 N esquina dcha. | 174 | 151 | 160 | 103

Persona apoyada (300 N abajo + 300 N contra la
pared) | 27 | 27 | 27 | 27
Persona de 80 kg colgada del borde (estático) | 115 | 105 | 110 | 77
Ídem, se deja caer (factor dinámico 2) | 215 | 197 | 207 | 142

Golpe frontal 2000 N hacia la pared (centro /
esquina) | 27 / 111 | 16 / 133 | 16 / 126 | 17 / 114

Golpe lateral en esquina sup., 10 J: F equivalente
(N) | 993 | 994 | 994 | 995
→ fuerza máx. en un tornillo (N) | 222 | 189 | 189 | 170
(impactador rígido, cota superior: F equivalente) | 8.517 | 9.486 | 9.354 | 10.160

Golpe lateral en esquina sup., 30 J: F equivalente
(N) | 1.720 | 1.723 | 1.722 | 1.724
→ fuerza máx. en un tornillo (N) | 386 | 328 | 329 | 296
(impactador rígido, cota superior: F equivalente) | 14.751 | 16.431 | 16.202 | 17.597
Tabla 8. Fuerza máxima en un tornillo (N). Golpe frontal: centrado, empuja la chapa contra la pared y los anclajes apenas trabajan (sólo el peso); en una esquina, la caja bascula sobre la chapa flexible y aparecen tracciones del orden de las de un tirón de 300 N. El riesgo del golpe frontal está más en el panel frontal y la pantalla que en el anclaje. Golpe lateral: método energético F = √(2·E·kef): toda la energía se almacena elásticamente; kef = rigidez lateral del conjunto (vuelco del FEM + cortante con 1000 N/mm por taco, hipótesis) en serie con la del cuerpo que golpea (50 N/mm, hipótesis). Sin amortiguamiento ni abolladura local, así que es conservador; con impactador rígido la fuerza sería varias veces mayor (fila entre paréntesis), lo que no es realista para un pie o un puño. 30 J ≈ 5 kg a 3,5 m/s.

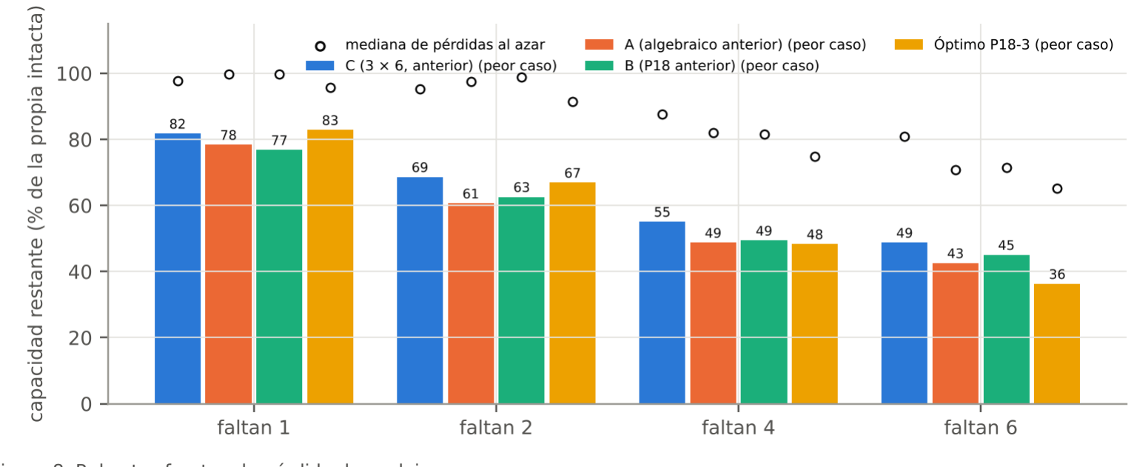
[picture p44: figure]

Alcoholímetro · diseño A · optimización del patrón de anclaje a pared | pág. 12

### 4.4 Pérdida de anclajes y fallo progresivo

Escenario | C (3 × 6, anterior) A (algebraico
| | anterior) | B (P18 anterior) | Óptimo P18-3
Intacto: λ (malla 20 mm) | 5,77 | 6,28 | 5,97 | 11,07
Faltan 1, peor combinación: λ (% del intacto) | 4,72 (82 %) | 4,92 (78 %) | 4,59 (77 %) | 9,17 (83 %)
Faltan 1 al azar: mediana / percentil 10 (%) | 98 / 82 % | 100 / 85 % | 100 / 85 % | 96 / 88 %
Faltan 2, peor combinación: λ (% del intacto) | 3,96 (69 %) | 3,81 (61 %) | 3,74 (63 %) | 7,41 (67 %)
Faltan 2 al azar: mediana / percentil 10 (%) | 95 / 82 % | 98 / 78 % | 99 / 78 % | 91 / 85 %
Faltan 4, peor combinación: λ (% del intacto) | 3,18 (55 %) | 3,06 (49 %) | 2,95 (49 %) | 5,35 (48 %)
Faltan 4 al azar: mediana / percentil 10 (%) | 88 / 71 % | 82 / 61 % | 82 / 63 % | 75 / 65 %
Faltan 6, peor combinación: λ (% del intacto) | 2,81 (49 %) | 2,67 (43 %) | 2,69 (45 %) | 4,02 (36 %)
Faltan 6 al azar: mediana / percentil 10 (%) | 81 / 64 % | 71 / 57 % | 71 / 58 % | 65 / 56 %
Colapso progresivo / primera rotura | 1,00 | 1,00 | 1,00 | 1,00
Tabla 9. Capacidad tras perder tornillos (malla de búsqueda, envolvente de casos). «Peor combinación»: se eliminan, uno a uno, los tornillos cuya falta más perjudica. «Al azar»: 40 combinaciones. El ganador pierde más en porcentaje (cada tornillo suyo trabaja más) pero conserva más capacidad absoluta que los otros tres en todos los escenarios. La última fila es el cociente entre la carga que agota el último equilibrio posible eliminando cada vez el tornillo que rompe y la carga de la primera rotura (> 1: hay reserva tras la primera rotura; = 1: rotura en cadena).

Figura 8. Robustez frente a la pérdida de anclajes.

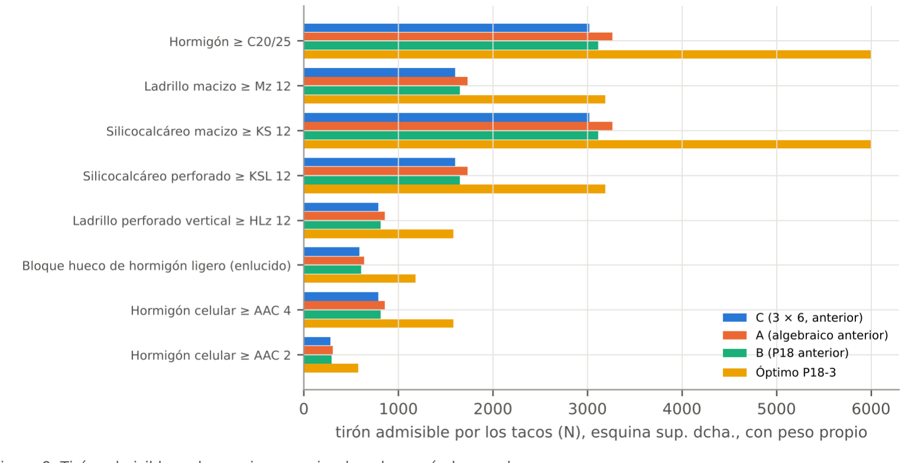
[picture p45: figure]

Alcoholímetro · diseño A · optimización del patrón de anclaje a pared | pág. 13

## 5. Sensibilidad al tipo de pared

Pared (Frec

) | Acción | C (3 × 6,
anterior)

A (algebraico
anterior)

B (P18
| | | anterior) | Óptimo P18-3
Hormigón ≥ C20/25 | Tirón esquina sup.
dcha. | 3.020 | 3.265 | 3.114 | 5.997

Peso colgado en el
borde | 11.667 | 12.635 | 12.091 | 18.376
Ladrillo macizo ≥ Mz 12 | Tirón esquina sup.
dcha. | 1.600 | 1.731 | 1.650 | 3.187

Peso colgado en el
borde | 6.170 | 6.685 | 6.396 | 9.738
Silicocalcáreo macizo ≥ KS 12 | Tirón esquina sup.
dcha. | 3.020 | 3.265 | 3.114 | 5.997

Peso colgado en el
borde | 11.667 | 12.635 | 12.091 | 18.376
Silicocalcáreo perforado ≥ KSL 12 | Tirón esquina sup.
dcha. | 1.600 | 1.731 | 1.650 | 3.187

Peso colgado en el
borde | 6.170 | 6.685 | 6.396 | 9.738
Ladrillo perforado vertical ≥ HLz 12 | Tirón esquina sup.
dcha. | 789 | 854 | 814 | 1.582

Peso colgado en el
borde | 3.029 | 3.285 | 3.141 | 4.802

Bloque hueco de hormigón ligero (enlucido)

Tirón esquina sup.
dcha. | 586 | 635 | 605 | 1.180

Peso colgado en el
borde | 2.243 | 2.435 | 2.327 | 3.567
Hormigón celular ≥ AAC 4 | Tirón esquina sup.
dcha. | 789 | 854 | 814 | 1.582

Peso colgado en el
borde | 3.029 | 3.285 | 3.141 | 4.802
Hormigón celular ≥ AAC 2 | Tirón esquina sup.
dcha. | 281 | 306 | 291 | 578

Peso colgado en el
borde | 1.065 | 1.160 | 1.107 | 1.716

Tabla 10. Acción admisible de diseño (N) con el peso propio fijo, hasta que el tornillo más cargado alcanza la carga recomendada de fischer para ese soporte. 785 N = una persona de 80 kg colgada sin impulso. Sólo se comprueban los tacos: con pesos colgados tan grandes mandarían antes la chapa, las soldaduras o la propia caja, que no se calculan aquí.

Figura 9. Tirón admisible en la esquina superior derecha según la pared.

Alcoholímetro · diseño A · optimización del patrón de anclaje a pared | pág. 14

### 5.1 Juntas y piezas de mampostería (Monte Carlo)

Formato | Patrón | En junta
| | (media /
| | máx.) | Máx. por
| | | pieza | λ sin ajuste:
| | | | mediana / p05 | λ con ajuste de
| | | | | altura: mediana /
| | | | | p05

Ladrillo macizo/perforado
24x11,5x5 | C (3 × 6, anterior) | 6,7 / 12 | 3 | 4,2 / 2,7 | 5,8 / 4,7
| A (algebraico anterior) | 6,8 / 14 | 4 | 4,5 / 2,3 | 6,3 / 4,7
| B (P18 anterior) | 7,1 / 18 | 4 | 4,1 / 0,3 | 6,0 / 4,8
| Óptimo P18-3 | 6,3 / 12 | 4 | 6,8 / 4,6 | 9,3 / 7,1
| Libre (alternativa) | 6,1 / 13 | 3 | 6,9 / 2,3 | 10,2 / 8,3
| Mampostería n=12 (s ≥
| 100) | 4,2 / 7 | 2 | 4,4 / 2,7 | 5,5 / 3,7

Ladrillo perforado
24x11,5x7 | C (3 × 6, anterior) | 5,5 / 11 | 6 | 4,4 / 2,7 | 5,8 / 4,4
| A (algebraico anterior) | 5,5 / 14 | 8 | 4,5 / 2,1 | 6,3 / 5,1
| B (P18 anterior) | 5,2 / 13 | 8 | 4,1 / 3,2 | 6,0 / 4,9
| Óptimo P18-3 | 5,2 / 10 | 6 | 7,5 / 5,1 | 10,7 / 8,8
| Libre (alternativa) | 5,0 / 9 | 4 | 7,8 / 4,8 | 9,9 / 8,1
| Mampostería n=12 (s ≥
| 100) | 3,3 / 7 | 3 | 4,5 / 2,7 | 6,2 / 4,8

Ladrillo hueco doble
24x11,5x8 | C (3 × 6, anterior) | 3,8 / 15 | 6 | 5,7 / 1,1 | 5,8 / 4,4
| A (algebraico anterior) | 4,3 / 11 | 8 | 4,7 / 3,1 | 6,3 / 5,2
| B (P18 anterior) | 4,5 / 12 | 8 | 4,6 / 3,0 | 6,0 / 4,4
| Óptimo P18-3 | 4,7 / 11 | 6 | 8,1 / 5,9 | 9,9 / 7,6
| Libre (alternativa) | 4,7 / 9 | 5 | 8,0 / 5,4 | 9,4 / 7,9
| Mampostería n=12 (s ≥
| 100) | 3,0 / 6 | 3 | 4,8 / 3,1 | 6,2 / 4,9

Bloque de hormigón
40x20x20 | C (3 × 6, anterior) | 2,4 / 8 | 12 | 5,7 / 4,1 | 5,8 / 4,7
| A (algebraico anterior) | 2,4 / 7 | 10 | 6,3 / 4,2 | 6,3 / 6,1
| B (P18 anterior) | 2,4 / 7 | 10 | 5,9 / 4,0 | 6,0 / 5,1
| Óptimo P18-3 | 2,5 / 9 | 10 | 9,6 / 6,2 | 11,1 / 10,0
| Libre (alternativa) | 2,3 / 6 | 9 | 10,0 / 5,8 | 11,4 / 9,9
| Mampostería n=12 (s ≥
| 100) | 1,6 / 5 | 6 | 6,0 / 3,7 | 6,2 / 5,6

Tabla 11. Aparejo a soga con junta de 10 mm y desfase aleatorio respecto a la máquina (120 posiciones; 40 con ajuste). Un tornillo cuenta como «en junta» si el taladro de Ø8 toca la junta (fischer: no anclar en juntas) y entonces se omite. λ en las mismas unidades que la figura 3 (F
| rec

de hormigón; para otra pared, multiplicar por F
| | | | rec

/1500). «Con ajuste»: el instalador sube o baja la máquina dentro de una hilada (pasos de 10 mm) hasta la posición que deja más capacidad. p05 = percentil 5 (1 de cada 20 instalaciones queda por debajo).

### 5.2 Qué patrón usar en cada pared

- Hormigón ≥ C20/25 y silicocalcáreo macizo KS 12 (F
| | | rec

1,5 kN): el patrón ganador tal cual. La interacción entre tacos no limita: con hef = 65 mm, el cono de hormigón fisurado de un taco aislado da ≈ 20 kN (k = 7,7 del método de EN 1992-4) y, aun repartiendo el área de conos solapados de 9 tacos a 50 mm, quedan ≈ 5 kN por taco, más de 3 veces F
| | rec

. Respetar cmin = 50 mm a cantos y huecos de la pared.
- Ladrillo macizo Mz 12 (0,8 kN) y perforado KSL/HLz (0,8 / 0,4 kN): con juntas cada 6–8 cm es casi seguro que varios agujeros caigan en junta (tabla 11), y los del ganador que están a la misma altura (franja superior) caen juntos. Regla de montaje: localizar las juntas (o hacer un taladro piloto de Ø4 en los agujeros de la franja superior) y subir o bajar la máquina hasta que esa fila caiga en ladrillo; los tacos que aun así caigan en junta se omiten. Con esa regla el ganador conserva, en el percentil 5, entre 1,5 y 2,1 veces la capacidad del patrón C. Incluso sin ajustar, en ladrillo de 5 cm su percentil 5 es 4,6 frente a 2,7 del C. Taladrar sin percusión en perforado. La capacidad de cada pieza de ladrillo frente a extracción no la da fischer: no más de 2–3 tacos por pieza si se puede elegir.
- Ladrillo hueco horizontal (tabiques de hueco doble/sencillo, «Forato»): fischer no da carga para el 8×65 (para el 8×40, 0,10 kN en pared enlucida). No es un soporte válido para esta máquina con estos tacos: usar anclaje químico con tamiz o pasante con contraplaca, con datos del fabricante y ensayo in situ.
- Bloque hueco de hormigón (0,30 kN, enlucido): capacidad algo menor que HLz y hasta 10 tacos en el mismo bloque de 40×20; se recomienda anclaje químico con tamiz.
- Hormigón celular (0,15–0,40 kN): sólo con anclajes específicos para celular.

Alcoholímetro · diseño A · optimización del patrón de anclaje a pared | pág. 15
- Pladur: el SX Plus no tiene valor de carga en placa. La máquina debe ir a un refuerzo (tablero o pletina atornillada a los montantes) diseñado y verificado aparte; no se cuantifica aquí.
- En todos los casos, la carga recomendada es de un taco aislado: no se multiplica por el número de tacos; el reparto real lo da el modelo y gobierna el más cargado.

## 6. Chapa trasera: tensiones, separación y contacto

Chapa trasera | C (3 × 6,
| anterior) | A (algebraico
| | anterior) | B (P18
| | | anterior) | Óptimo P18-3

Tensión de flexión máx. con 500 N en la esquina dcha.
(MPa, von Mises de cara) | 56 | 58 | 59 | 39

Tirón en esquina dcha. con primera plastificación local,
Re = 140 / 280 MPa (N) | 1.257 / 2.513 | 1.205 / 2.411 | 1.187 / 2.375 | 1.775 / 3.550

Tirón admisible por los tacos en hormigón, para
comparar (N) | 3.020 | 3.265 | 3.114 | 5.997

Separación máx. chapa–pared a la carga admisible del
caso gobernante (mm) | 1,66 | 1,76 | 1,73 | 1,18
Pico de presión de contacto, ídem (MPa) | 4,1 | 4,2 | 4,2 | 10,7

ΣN / 500 N con el tirón de 500 N en la esquina dcha.
(efecto palanca) | 2,40 | 2,17 | 2,24 | 2,21
Momento de vuelco admisible puro (N·m) | 1.301 | 1.454 | 1.368 | 2.408
Momento admisible alrededor del eje vertical (N·m) | 1.586 | 1.456 | 1.349 | 1.576
Torsor admisible en el plano de la pared (N·m) | 2.537 | 3.324 | 3.335 | 2.399
Tabla 12. Tensiones elásticas de flexión (placa lineal); el pico está en el borde de la arandela de un tornillo superior. DC01: Re ≤ 280 MPa sin mínimo garantizado, 140 MPa como mínimo de cálculo. En hormigón y ladrillo macizo la chapa de 3 mm plastifica localmente antes de que el taco llegue a su carga recomendada: deformación permanente alrededor de la arandela, no rotura (el arrancamiento de la arandela de Ø18 a través de 3 mm exige del orden de π·18·3·0,6·270 ≈ 27 kN). Con 2 mm la plastificación empezaba a la mitad de carga, más o menos. El pico de presión es local, en la línea de un pliegue, y depende de la rigidez de contacto supuesta.

Si se quiere que en hormigón mande el taco y no la chapa, la medida eficaz es local: una pletina de 4–5 mm soldada por dentro bajo la franja superior y bajo la fila de la bandeja (o arandelas de mayor diámetro), sin cambiar el espesor general. En ladrillo perforado, bloque o celular manda el taco y la chapa no limita.

La hipótesis de chapa rígida no se cumple: con los mismos tornillos, la fuerza máxima del FEM es entre 1,4 y 3 veces la del modelo rígido y la suma de tracciones llega a ser más del doble de la carga aplicada. Por eso el patrón óptimo con chapa flexible (tornillos junto a las líneas rígidas) es muy distinto del que sale con chapa rígida (tornillos lo más arriba y lejos del pivote posible).

## 7. Carga máxima teórica frente a carga admisible de diseño

Concepto (tirón en la esquina sup. dcha., hormigón) | C (3 × 6,
| anterior) | A (algebraico
| | anterior) | B (P18
| | | anterior) | Óptimo P18-3

Tirón admisible de diseño: primer tornillo a F
rec

= 1,5 kN
(N) | 3.020 | 3.265 | 3.114 | 5.997

Primera rotura si el taco rompe a γ·F
rec

, con γ = 3
ilustrativo (N) | 9.061 | 9.794 | 9.341 | 17.990
Carga de colapso del modelo / primera rotura | 1,00 | 1,00 | 1,00 | 1,00
Tabla 13. La carga admisible de diseño es la única con respaldo de fabricante. La carga máxima teórica depende del margen real entre rotura y F
rec

(γ), que fischer no publica para el SX Plus; γ = 3 es sólo un ejemplo para mostrar el orden de magnitud. Ninguna de las dos es una resistencia certificada del conjunto: eso requiere ensayo.

## 8. Conclusión y verificaciones antes de fabricar

Elegiría Óptimo P18-3 para fabricar la carcasa: es el que más carga admite en el caso que gobierna (λ = 10,56 frente a 5,79 del anterior), mantiene la ventaja con todas las hipótesis de rigidez probadas, es también el que más capacidad absoluta conserva si fallan los 2 tornillos peores y respeta todas las holguras de la geometría (separación mínima 50,0 mm). En hormigón admite del orden de 5.997 N de tirón en la esquina más desfavorable con el criterio de fischer; en ladrillo perforado HLz 12, unos 1.582 N.

- Para bares (instalación habitual): hormigón, ladrillo macizo o perforado. Se taladran los 18 agujeros en la chapa. En hormigón se colocan todos. En ladrillo se aplica la regla de montaje de §5.2 (ajustar la altura para que la franja superior caiga en ladrillo, omitir los que caigan en junta) y no se deja sin tornillo ninguno de la franja superior (Z3).

Alcoholímetro · diseño A · optimización del patrón de anclaje a pared | pág. 16
- No instalar sobre ladrillo hueco horizontal, pladur o revestimientos sin un anclaje distinto (químico con tamiz, pasante con contraplaca o refuerzo detrás del pladur).
- Una persona de 80 kg que se deja caer colgada del borde (1570 N con factor 2) queda cubierta por los cuatro patrones en todas las paredes con dato de fischer salvo hormigón celular AAC 2, donde sólo la cubre el ganador (tabla 10).
- En hormigón, el límite práctico lo pone la chapa de 3 mm, que plastifica localmente junto a las arandelas superiores a partir de ≈ 1.775 N de tirón en la esquina con el ganador (≈ 1.257 N con el patrón C), bastante antes que los tacos. No es una rotura, pero sí una deformación permanente; ver §6 para reforzarla localmente.
- Si se quiere más margen frente a golpes (tabla 8), el siguiente paso no es mover tornillos sino cambiar de anclaje (metálico con evaluación técnica) o añadir rigidez a la trasera (pliegues o un perfil soldado entre los pliegues laterales).

### Verificaciones pendientes antes de fabricar

- Hecho (04-11-2026): el P18-3 está en el CAD (diseno.py → FIJACIONES_PARED), con 0 choques entre piezas y

barridos de los cajones limpios; DXF A-C02, STEP, planos y lista regenerados.
- Pesar el primer prototipo completo y medir su centro de gravedad; repetir el cálculo si supera 18 kg o 65

mm de la pared.
- Ensayo de arrancamiento in situ (tracción sobre 3–5 tacos de prueba) en cada tipo de pared nueva, y uno del conjunto con la máquina montada (tirón lateral y en esquina) para validar el modelo de chapa flexible.
- Confirmar con el taller el radio de plegado y la soldadura de la pestaña de la bandeja (el modelo la trata como unión rígida).
- Comprobar el acceso con llave de 10 mm a los agujeros de ±93 mm (14 mm de la cara interior del lateral) y

a la franja Z3 con la tapa abierta.
- Pedir a fischer la separación mínima entre tacos y, si es posible, la curva carga–desplazamiento del SX Plus

8×65.

### Anexo. Coordenadas de las alternativas (x desde el eje, z desde la base, mm)

Libre (alternativa) (18 agujeros): (-92,5, 429,5); (85,5, 427,5); (-93,0, 375,5); (86,0, 368,5); (-93,0, 325,5); (91,0, 318,5); (4,5, 309,0); (93,0, 268,5); (-91,0, 256,0); (93,0, 213,0); (3,5, 178,5); (53,5, 178,0); (-29,0, 132,5); (24,0, 132,5); (91,0, 103,5); (-78,0, 71,0); (45,5, 33,0); (-62,0, 22,5)

Mampostería n=12 (s ≥ 100) (12 agujeros): (-93,0, 429,5); (26,5, 428,5); (86,0, 348,0); (-93,0, 329,0); (0,5, 287,0); (93,0, 248,0); (-93,0, 228,0); (4,0, 186,0); (93,0, 139,5); (2,5, 85,0); (-87,0, 35,0); (93,0, 29,5)

## 9. Referencias y archivos entregados

- fischer, tabla de cargas Expansion plug SX Plus (cargas recomendadas, cmin; notas 1–3):

fiproductmedia.azureedge.net/media/Load Tables/Load Tables fischer/LT_SX-PLUS_EN_T1.pdf
- fischer, ficha técnica Cheville SX PLUS (16/05/2023): taladro, h1, hef, tornillo, no anclar en juntas.
- fischer España, ficha de producto SX Plus 8×65 (567857): Ø8, h1 ≥ 75 mm, tornillo Ø4,5–6,0.
- thyssenkrupp Materials Services, Werkstoffdatenblatt DC01–DC07 (EN 10130): Re ≤ 280 MPa, Rm 270–410 MPa, mín. de cálculo 140 MPa.
- S. Timoshenko, S. Woinowsky-Krieger, Theory of Plates and Shells (verificación del elemento de placa).
- Repositorio GuillermoAladro/Alcoholimetro, rama programa-raspberry (04-11-2026):

carcasa/diseno-A/modelo/diseno.py, specs.py, Lista_de_piezas.xlsx, ANCLAJE-PARED-8x65.md.
- Carpeta carcasa/diseno-A/calculo-anclajes/: patron_ganador.csv (coordenadas), codigo/ (todo el cálculo), resultados/ (JSON de esta ejecución), figuras/ y, en historico-2mm/, el estudio con la trasera de 2 mm.
