GuillermoAladro/Alcoholimetro/carcasa/diseno-A/estudio-termico/historico-solo/Estudio_termico_alcoholimetro_Solo.pdf

ALCOHOLÍMETRO · DISEÑO A (COMPACTA) · 13- 1 1 -2026

# Estudio térmico del diseño

## Cuánto se calienta por dentro, qué temperatura aguanta cada pieza y qué hay que cambiar para que trabaje dos

años sin visitas.

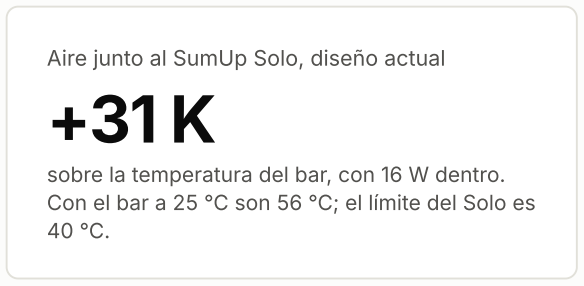
[picture p46: figure]
Aire junto al SumUp Solo, diseño actual +31 K

sobre la temperatura del bar, con 16 W dentro. Con el bar a 25 °C son 56 °C; el límite del Solo es

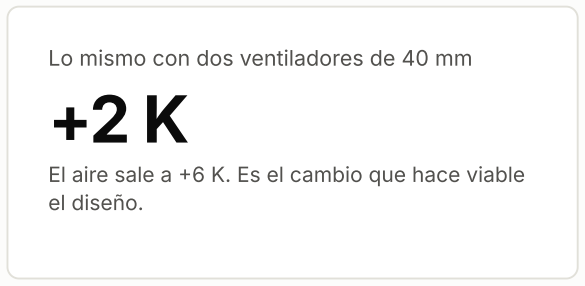
[picture p47: figure]
Lo mismo con dos ventiladores de 40 mm +2 K; el diseño.

El aire sale a +6 K. Es el cambio que hace viable

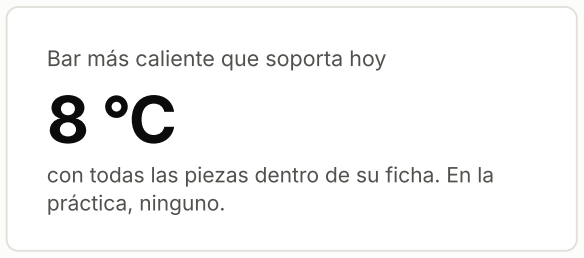
[picture p48: figure]
Bar más caliente que soporta hoy 8 °C; práctica, ninguno.

con todas las piezas dentro de su ficha. En la

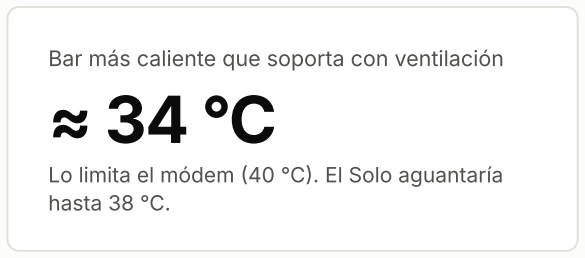
[picture p49: figure]
hasta 38 °C.

Bar más caliente que soporta con ventilación

Lo limita el módem (40 °C). El Solo aguantaría

Preparado para Guillermo Aladro Abad · cálculo de Claude sobre el CAD del 04-11-2026 y las cargas del Bloque 1
(13-11-2026).
Todo es cálculo: no hay nada montado ni medido. Cada cifra lleva su margen y se valida con el ensayo del apartado 14.

Estudio térmico del alcoholímetro · diseño A · 13-11-2026 | 2 / 31

# Resumen

Lectura que he tomado del encargo: estudiar a fondo cómo se comporta el diseño A con el calor y decir qué temperatura soporta. Lo separo en dos preguntas, cuánto se calienta la máquina por dentro y cuánto aguanta cada pieza, y de las dos sale la respuesta práctica: en qué bares puede trabajar.

### Lo que sale del estudio

1. Tal como está dibujada hoy, la máquina se calienta bastante más de lo que se había supuesto. Con 16 W dentro, el aire interior queda +26,5 K por encima del bar de media y +31 K junto al Solo y el sensor (en el 80 % de los casos calculados, entre +26 y +36 K).
2. La frase que me pasas se queda corta. «Con el bar a 30 °C, dentro habría unos 38–42 °C» sale de suponer +8 a +12 K. El modelo da 56 °C de media y 61 °C junto al Solo.
3. La causa está en el propio diseño: una caja dentro de otra con aire en medio, el frente tapado por dos policarbonatos (aísla como un doble acristalamiento), rejillas de 2,5 cm² y las piezas más delicadas arriba, donde se acumula el aire caliente.
4. La carcasa aguanta de sobra; lo que no aguanta es lo que lleva dentro. Acero, pintura, policarbonato, cinta y cables soportan 70 °C o más. El Solo, el sensor y el módem tienen el límite en 40 °C; la Pi y la cámara, en
50 °C.
5. Sin ventilación forzada no hay bar en el que todo quede dentro de su ficha: haría falta un bar a 8 °C. Pintar el interior y agrandar las rejillas ayuda (de 6 a 10 K menos), pero no llega.
6. Con dos ventiladores de 40 mm (unos 5 m³/h reales) el aire sale a +6 K y el Solo ve +2 K. Así la máquina soporta bares de hasta unos 34 °C con todo en ficha. Confirmo la decisión del Bloque 1 y la afino (apartado
8).
7. Si la ventilación se para, el aire junto al Solo pasa de 40 °C en unos 12 minutos (bar a 25 °C) y se estabiliza en 55 °C. Los ventiladores pasan a ser una pieza crítica y necesitan vigilancia y corte por programa.
8. Nunca al sol directo. Con sol fuerte en el frente la chapa sube +22 K y la pantalla +45 K sobre el bar, también con ventiladores.

### Temperatura soportada, por configuración

Configuración | Calor dentro | Aire interior (media) | Aire junto al Solo | Bar máximo para el Solo | Bar máximo con todo en ficha Pieza que limita
Diseño actual (rejillas de hoy, cajón sin pintar) | 15,7 W | +26,5 K | +31,1 K | 8 °C | 8 °C Sensor ZE29A
Actual con el interior pintado | 15,7 W | +21,7 K | +25,4 K | 14 °C | 14 °C Sensor ZE29A
1 ventilador de 40 × 10 mm | 16,3 W | +7,5 K | +2,2 K | 37 °C | 33 °C Módem 4G
2 ventiladores de 40 × 10 mm | 16,3 W | +6,3 K | +1,9 K | 38 °C | 34 °C Módem 4G
1 ventilador de 60 × 25 mm (no cabe en los laterales) | 16,9 W | +2,8 K | +0,8 K | 39 °C | 37 °C Módem 4G

«Bar máximo» es la temperatura del aire del local con la que la pieza llega justo a su límite de ficha. Calentamientos cálculo con el modelo del apartado 5; límites hoja .

Estudio térmico del alcoholímetro · diseño A · 13-11-2026 | 3 / 31

### Qué cambia respecto a lo que ya estaba escrito

Documento | Calor dentro Calentamiento sin ventilador | Con dos ventiladores
Verificación del 12-11-2026 13–15 W | +8 a +12 K (estimación rápida) | —
Bloque 1 del 13-11-2026 | 16 W (13–21) | +17 K (una pared) a +24 K (doble pared) +8 K
Este estudio | 16 W (13–21) | +26,5 K de media y +31 K junto al Solo | +6 K a la salida y +2 K junto al Solo

### Lo que haría, por orden

1. Dar por decidida la ventilación forzada y llevarla al CAD: entrada arriba a la derecha, junto al Solo, y salida abajo a la izquierda (apartado 8.3).
2. Pintar el cajón de componentes y el interior de la carcasa, o al menos no dejarlos galvanizados brillantes: 6 K menos el día que falle la ventilación.
3. Poner un fusible por ventilador y una sonda de temperatura junto al Solo, con umbrales en el programa (apartado 13).
4. Añadir tres reglas de instalación: nunca al sol, nunca junto a una fuente de calor y bares de 10 a 32 °C.
5. Antes de pedir chapa en serie, hacer el ensayo del apartado 14 con una carcasa de prototipo. Son tres horas y dice si el modelo acierta.

### Contenido

1 Alcance y método
2 El diseño visto como problema térmico 3 Cuánto calor hay que sacar
4 Qué temperatura aguanta cada pieza 5 Modelo de cálculo
6 Resultados del diseño actual
7 ¿Se arregla sin ventilador?
8 Ventilación forzada
9 Temperatura de cada pieza y del bar

10 Arranque, averías y cortes de luz 11 Sol, funda y frío
12 Calor y vida útil
13 Cambios recomendados
14 Plan de ensayo
15 Conclusiones
A Anexo: parámetros del modelo B Anexo: cómo repetir el cálculo Fuentes

# 1 Alcance y método

### 1.1 Qué versión he estudiado

Carcasa: diseño A (Compacta) del 04-11-2026, tal como lo generan los scripts de carcasa/diseno-A/modelo/: 220 × 100 × 442,5 mm, carcasa de chapa de 3 mm, cajón de componentes y tapa interior de 1,5 mm, dos policarbonatos de 5 mm en el frente y antena por dentro.
Electrónica y cargas: las del Bloque 1 (13-11-2026): 2,5 A típicos en 5 V, fuente a 5,10 V y la propuesta de dos ventiladores Noctua NF-A4x10 5V, que todavía no está en el CAD.
Acabado: carcasa con pintura en polvo por fuera. Del cajón de componentes ningún documento dice el acabado; como caso base lo tomo sin pintar o galvanizado supuesto , que es el peor para el calor, y calculo también el caso pintado.

### 1.2 Qué he hecho

1. Sacar del CAD la geometría que importa para el calor: superficies, huecos entre chapas, rejillas y dónde va cada pieza.
2. Hacer el inventario del calor que se genera dentro, con su rango.

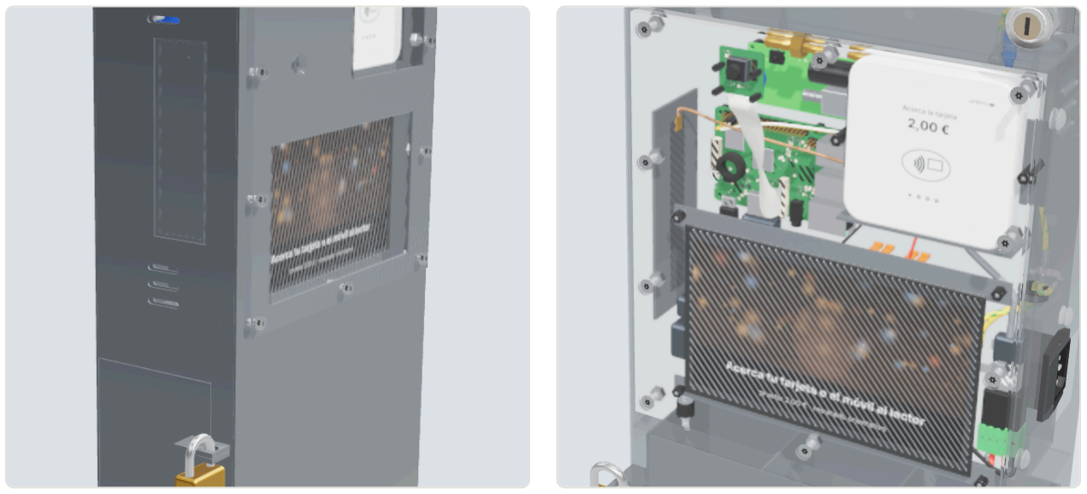
[picture p50: figure]

Estudio térmico del alcoholímetro · diseño A · 13-11-2026 | 4 / 31
3. Reunir el límite de temperatura de cada pieza, de su hoja de datos o de su ficha en componentes/.
4. Construir un modelo de red térmica de 57 nodos y resolverlo para el diseño actual y para las variantes.
5. Medir la incertidumbre con 1 500 casos al azar por configuración, y la sensibilidad a cada parámetro.
6. Calcular la ventilación forzada: punto de trabajo del ventilador, averías, suciedad y disposición.
7. Simular el arranque, la avería de los ventiladores y el corte de luz nocturno.
8. Estudiar el sol, la funda de plástico y el frío.

### 1.3 Cómo leer las cifras

hoja leído en la hoja de datos, en la ficha del repositorio o en la web del fabricante.
cálculo sale del modelo o de una cuenta que está en el informe. Se puede repetir con los scripts del anexo
B.
estimación cifra razonada, sin dato de fabricante.
supuesto lo doy por cierto sin poder comprobarlo.
dato general valor de manual o de práctica habitual.

Las diferencias de temperatura van en kelvin (K), que valen lo mismo que los grados: +10 K sobre un bar a 25 °C son 35 °C.

Lo que este estudio no es
No es una medida. El modelo acierta el orden de magnitud y el sentido de cada cambio. En el calentamiento del diseño actual la horquilla razonable es de ±5 K.
La potencia no está medida. Los 16 W salen de consumos típicos estimados. El calentamiento sin ventilador es casi proporcional a la potencia: 1,7 K por cada vatio.
No es una simulación de fluidos. El aire interior es un solo nodo con un reparto en altura supuesto. Los puntos calientes locales, como el chip de la Pi, van estimados aparte.

# 2 El diseño visto como problema térmico

Figura 1. El diseño A según el CAD del repositorio. A la izquierda, por fuera: en el lateral izquierdo se ven las dos rejillas de tres ranuras, los agujeros del escape del soplido y la ventana de la antena. A la derecha, el frente con el policarbonato: pantalla, Solo, cámara y, detrás, la Pi y el sensor.

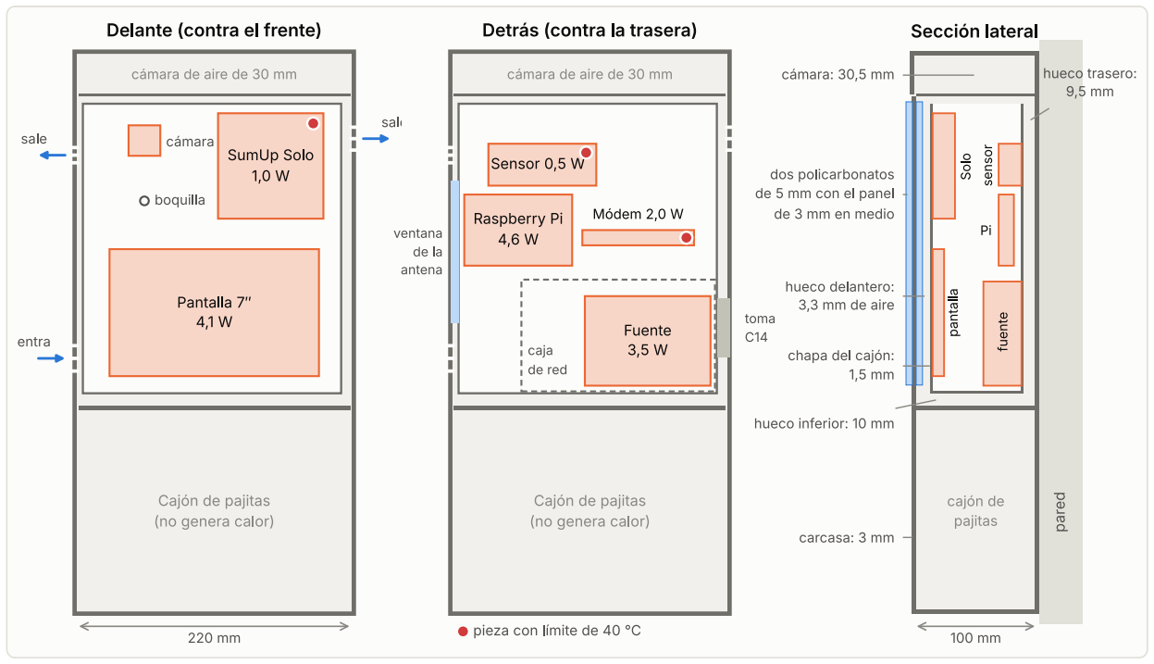
[picture p51: figure]

Estudio térmico del alcoholímetro · diseño A · 13-11-2026 | 5 / 31

Figura 2. Lo que hay dentro y dónde. Los rectángulos naranjas son las piezas que disipan, con su potencia típica; el punto rojo marca las que tienen el límite en 40 °C. Las flechas azules son las rejillas actuales: una de entrada abajo y dos de salida arriba, de tres ranuras de 22 × 4 mm cada una. Dibujado a escala con las cotas del CAD.

### 2.1 Geometría que manda en el calor

Elemento | Medida | Por qué importa
Carcasa exterior | 220 × 100 × 442,5 mm, acero de 3 mm | Es la única superficie que da calor al bar
Zona de componentes | Los 282 mm de arriba (desde la bandeja) | Todo el calor se genera aquí, en unos 3 litros de aire
Cajón de componentes | 203,5 × 73 × 228 mm, acero de 1,5 mm, abierto por arriba | Segunda pared entre la electrónica y la carcasa
Huecos cajón– carcasa | 3,5 mm (izquierda), 7 mm (derecha), 9,5 mm (detrás), 10 mm (debajo) | Capas de aire quieto: aíslan
Frente | Policarbonato de 5 mm + panel de 3 mm + policarbonato de 5 mm + 3,3 mm de aire | La cara más grande y despejada es la que peor conduce

Ventanas del frente Pantalla 159 × 91 mm y Solo 85 × 85 mm: 217 cm², el

| 47 % del frente del cajón | Ahí no hay acero: policarbonato, aire y policarbonato
Techo | Tapa interior de 1,5 mm, cámara de aire de 30,5 mm y tapa de 3 mm | Otra doble pared, justo encima de lo más caliente
Trasera | 220 × 440 mm contra la pared, con 18 tirafondos | No ve el aire; el calor sale por la pared
Rejillas | 3 rejillas de 3 ranuras de 22 × 4 mm: 2,5 cm² cada una, en la carcasa y repetidas en el cajón | Único paso de aire. Entrada a 201 mm de la base; salidas a 361 y 374 mm
Zona del cajón de pajitas | Los 160 mm de abajo, sin fuentes de calor | Hace de aleta: la chapa conduce calor hacia abajo y lo suelta

Medidas hoja del CAD (diseno.py, specs.py y geo.py). El número de ranuras lo he recalculado con la función vent_slots_x y coincide con la vista del visor.

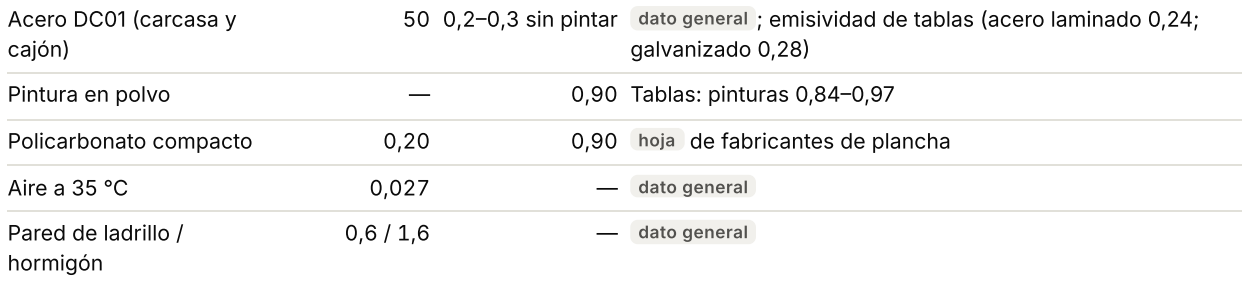
[picture p52: figure]
Acero DC01 (carcasa y cajón); galvanizado 0,28); Pintura en polvo; 0,90 Tablas: pinturas 0,84–0,97; Policarbonato compacto; hoja de fabricantes de plancha; Aire a 35 °C; — dato general; Pared de ladrillo / hormigón
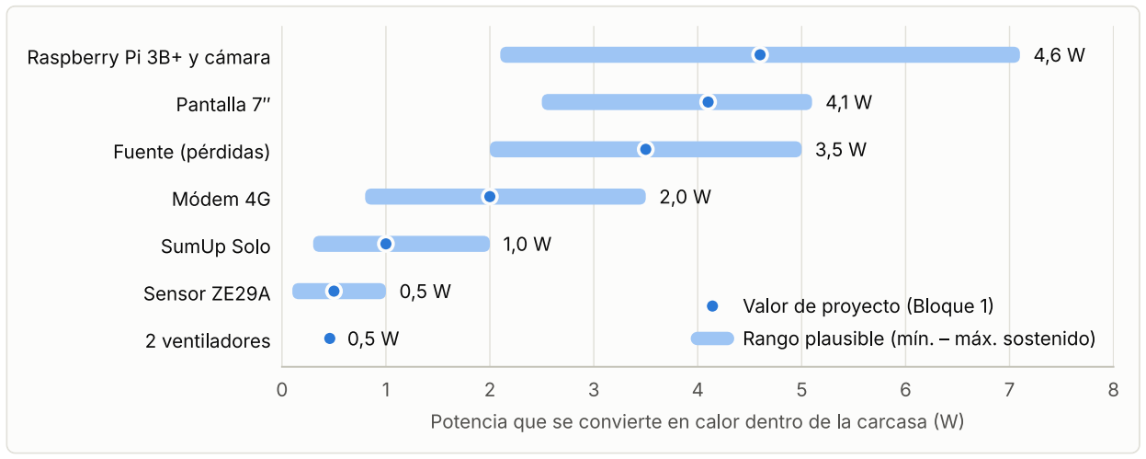
[picture p53: figure]

Estudio térmico del alcoholímetro · diseño A · 13-11-2026 | 6 / 31

### 2.2 Cinco rasgos que explican el resultado

1. Doble pared. El calor tiene que pasar del aire interior a la chapa del cajón, cruzar un hueco de aire y llegar a la carcasa antes de salir al bar. Son tres saltos de temperatura en serie donde un armario normal tiene uno.
2. Frente aislado. El doble policarbonato deja pasar unos 3,3 W/m²K, frente a los 9 W/m²K de una chapa pintada al aire cálculo . El frente es casi la mitad de la superficie libre.
3. Lo delicado, arriba. El Solo y el sensor (40 °C) están en el tercio superior del cajón, por encima de la fuente, la pantalla y la Pi. Con convección natural el aire caliente se acumula justo ahí.
4. Rejillas simbólicas. Tres ranuras de 22 × 4 mm en dos chapas seguidas dejan pasar 0,22 m³/h por tiro natural cálculo . Sacan 2,4 W de los 16.
5. Cajón sin acabado definido. Una chapa galvanizada o sin pintar emite y absorbe poca radiación (emisividad 0,2–0,3 frente a 0,9 de una pintada dato general ). En huecos tan estrechos, con las chapas pintadas la radiación lleva más de la mitad del calor; sin pintar, apenas un tercio.

### 2.3 Materiales

Material

Conductividad
W/m·K | Emisividad Origen

50 0,2–0,3 sin pintar dato general ; emisividad de tablas (acero laminado 0,24;

# 3 Cuánto calor hay que sacar

Todo lo que entra por el enchufe acaba como calor dentro de la carcasa. Solo se escapa la luz de la pantalla, que son décimas de vatio.

Figura 3. Calor que deja cada pieza. El punto es el valor que usa el proyecto (Bloque 1); la barra, lo que cabe esperar entre un reposo tranquilo y una carga alta sostenida.

Estudio térmico del alcoholímetro · diseño A · 13-11-2026 | 7 / 31
Pieza | Mínimo Proyecto Máximo De dónde sale

Raspberry Pi 3B+
y cámara
| 2,1 W | 4,6 W | 7,1 W Raspberry Pi mide 1,9 W en reposo y 5,8 W a plena carga hoja . Reproducir vídeo queda entre los dos estimación . La cámara solo gasta durante la prueba
Pantalla de 7″ | 2,5 W | 4,1 W | 5,1 W 5 W según el anuncio; paneles parecidos, 2,4–2,6 W. Depende del brillo
Fuente (pérdidas) | 2,0 W | 3,5 W | 5,0 W Rendimiento del 83 % a plena carga hoja ; al 25 % de carga, 78 %
Módem 4G | 0,8 W | 2,0 W | 3,5 W Menos de 3,5 W hoja . Sube con mala cobertura
SumUp Solo | 0,3 W | 1,0 W | 2,0 W Sin dato oficial estimación . Tras un corte carga a 7,5 W unas dos horas, pero casi todo se queda en la batería
Sensor ZE29A | 0,1 W | 0,5 W | 1,0 W Menos de 500 mA de pico hoja ; reposo estimación
Dos ventiladores | 0,4 W | 0,5 W | 0,5 W 0,22 W típicos cada uno hoja

Total sin
ventiladores
≈ 8 W | 15,7 W ≈ 24 W Suma
Total con dos ventiladores | | 16,3 W | Coincide con los «unos 16 W, entre 13 y 21» del Bloque 1

Uso el valor de proyecto, 16 W, como caso nominal para que este estudio se pueda comparar con el Bloque 1.
Mi impresión es que la media real será algo menor, de 12 a 14 W estimación : los 4,6 W de la Pi son casi su consumo a plena carga y el módem en reposo gasta menos de 2 W. No cambia ninguna conclusión; cambia cuántos kelvin sobran.
Es lo primero que hay que medir. Un vatímetro de enchufe entre la pared y la máquina da la cifra en un minuto. Con ella, la figura 9 da el calentamiento sin más cuentas.
La fuente, la pantalla y la Pi suman tres cuartas partes del calor, y las tres están por debajo del Solo y del sensor.

# 4 Qué temperatura aguanta cada pieza

Hay tres escalones: tres piezas que no pueden pasar de 40 °C, dos de 50 °C y todo lo demás, que aguanta 70 °C o más. El diseño térmico se decide en el primer escalón.

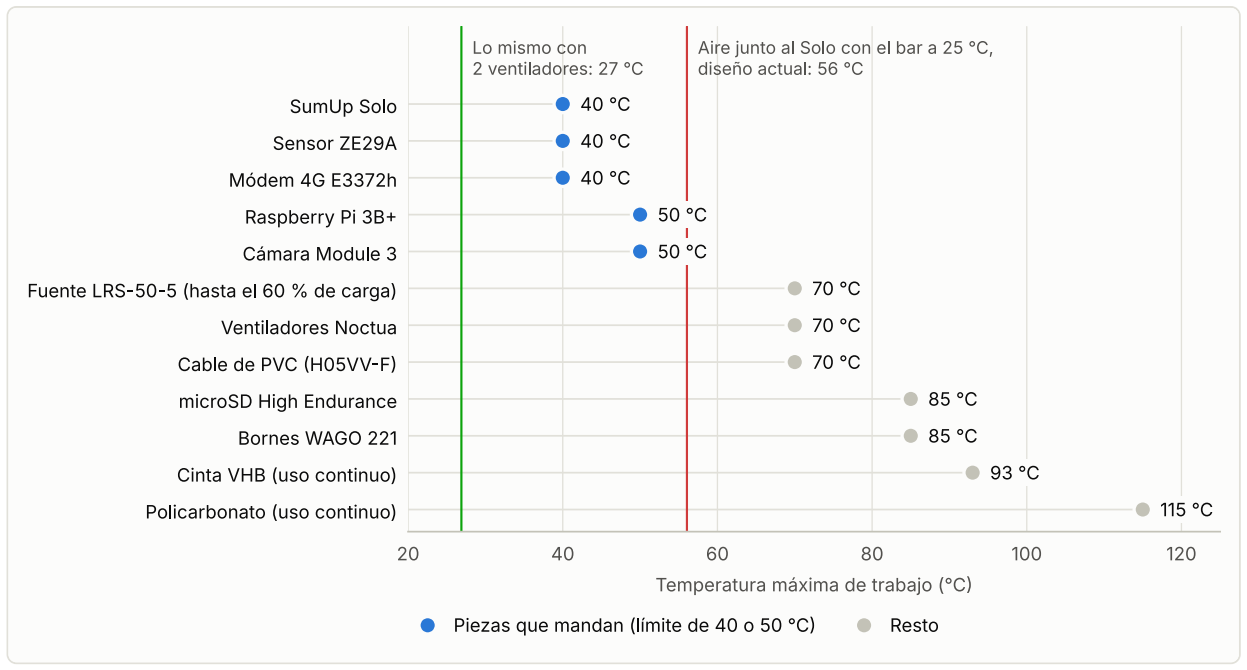
[picture p54: figure]

Estudio térmico del alcoholímetro · diseño A · 13-11-2026 | 8 / 31

Figura 4. Temperatura máxima de trabajo de cada pieza, según su hoja o su ficha. Las dos líneas verticales son la temperatura del aire junto al Solo que da el modelo con el bar a 25 °C.

Pieza | Trabajo | Qué pasa si se sale | Origen
SumUp Solo | 0 a 40 °C | El manual avisa de que fuera de ese rango puede dañarse. Además, SumUp dice que su bloqueo antimanipulación, que es permanente, puede saltar por condiciones extremas y pide evitar más de 40 °C. Lleva una batería de litio siempre cargada | hoja manual y ayuda de SumUp
Sensor ZE29A | 10 a 40 °C Fuera de rango la lectura deja de estar garantizada. El calor acorta la
vida de la celda electroquímica. Por abajo también tiene límite: 10 °C

hoja manual V1.1

Módem 4G
E3372h

− 10 a 40 °C Reinicios y caídas de conexión. Él mismo disipa hasta 3,5 W en un cuerpo muy pequeño

hoja ficha de
Huawei
Raspberry Pi 3B+ | 0 a 50 °C | El procesador baja de 1,4 a 1,2 GHz al llegar a 60 °C y recorta más a partir de 80 °C. No se rompe, pero va lenta | hoja ficha de producto
Cámara Module 3 | 0 a 50 °C | Ruido en la imagen y enfoque menos fiable | hoja ficha de producto
Pantalla GeeekPi de 7″ | sin dato | El fabricante no publica la temperatura. Paneles parecidos dan 0–60 °C o −20–70 °C. Tomo 50 °C supuesto | Ficha del repositorio
Fuente LRS-50-5 | − | 30 a 70 °C A 230 V da el 100 % hasta 50 °C y baja en línea recta hasta el 60 %
| | a 70 °C. Esta máquina pide el 25 % típico y el 52 % de pico | hoja curva de la hoja, leída en la figura
− | 10 a 70 °C Vida media declarada de más de 150 000 h | hoja
70 a 85 °C Ver la figura. No limitan | hoja y

Estudio térmico del alcoholímetro · diseño A · 13-11-2026 | 9 / 31

### 4.1 La carcasa y los materiales

Material | Aguanta | Origen
Acero y pintura en polvo | Muy por encima de 100 °C. La pintura se cura a 180–200 °C | dato general
Policarbonato de 5 mm y de 2 mm | 115 °C en uso continuo y 135 °C en ratos cortos. Se deforma con carga a 135 °C | hoja de plancha extruida
Cinta VHB de la ventana de la antena | 93 °C a largo plazo y 149 °C en ratos cortos | hoja de 3M
Silentblocks, topes de goma, separadores de nailon, tubo de silicona | 70 °C o más | dato general

Conclusión: por temperatura, la estructura no es el problema en ningún caso de este estudio. El caso más caliente que calculo, con sol directo y el bar a 25 °C, deja la chapa a 52 °C.

### 4.2 Al tacto

La chapa exterior se queda a +6 K sobre el bar de media y a +9 K en su punto más caliente cálculo . Con el bar a 30 °C son 39 °C como mucho, y con ventiladores, 34 °C.
Por debajo de 44 °C un metal no quema aunque se toque durante horas, según los datos que recogen ASTM C1055 e ISO 13732-1. No hay riesgo de quemadura, salvo con sol directo (apartado 11). Consecuencia práctica: tocar la chapa por fuera no dice nada de lo que pasa dentro. Con el interior a 55 °C, la chapa está apenas templada.

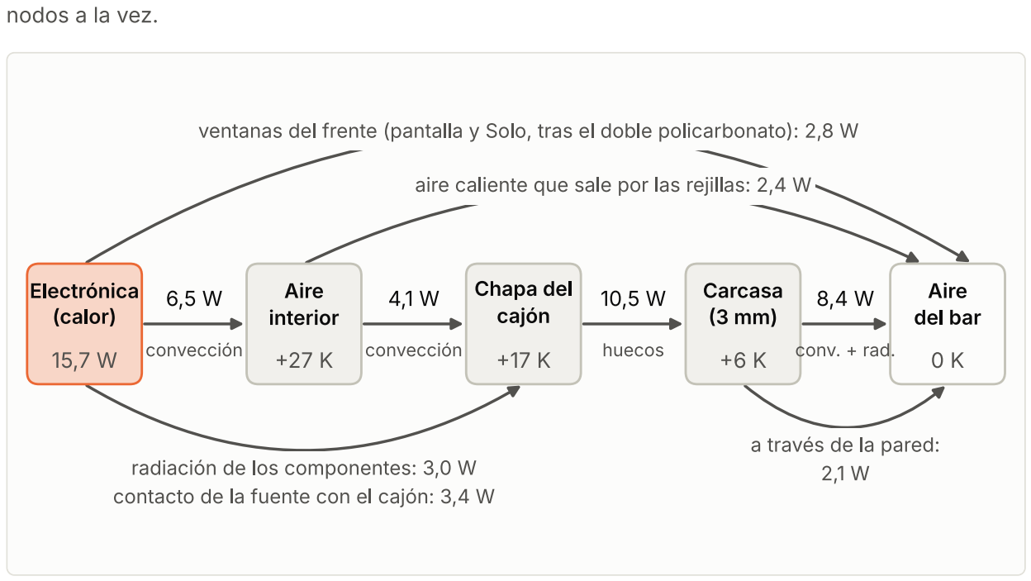
[picture p55: figure]
nodos a la vez.
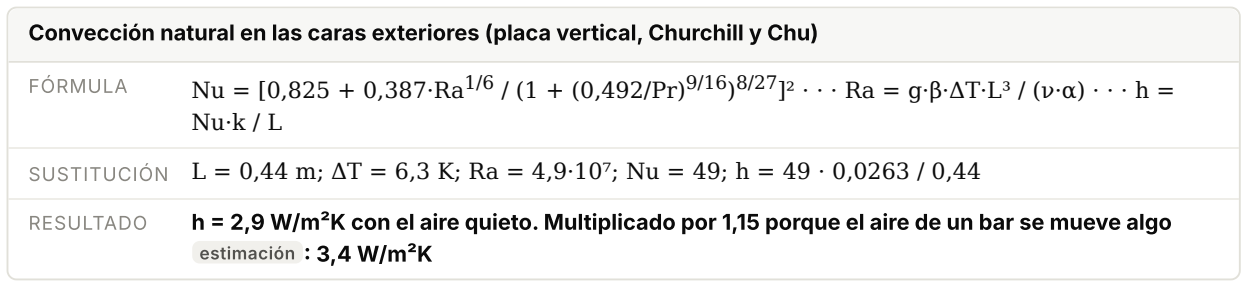
[picture p56: figure]
FÓRMULA; estimación : 3,4 W/m²K
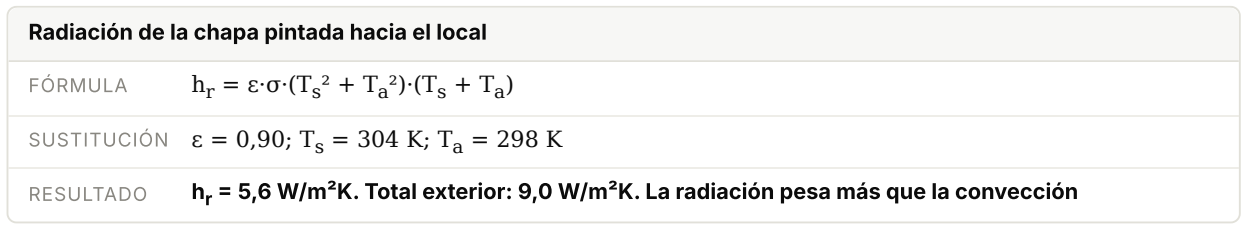
[picture p57: figure]
FÓRMULA

Estudio térmico del alcoholímetro · diseño A · 13-11-2026 | 10 / 31

# 5 Modelo de cálculo

Una red de resistencias térmicas: cada chapa y cada masa de aire es un nodo con su temperatura, y entre nodos pasa calor por convección, radiación o conducción. Se resuelve el equilibrio de los 57

Figura 5. El camino del calor en el diseño actual, con el resultado del caso base (bar a 25 °C, 15,7 W). Cada caja es un grupo de nodos con su calentamiento sobre el bar; sobre cada flecha, los vatios que pasan.

### 5.1 Qué nodos tiene

Dentro: el aire interior, las piezas que disipan (un nodo), la pantalla y la fuente con su caja de red. Cajón de componentes: frente, laterales, trasera, base y la tapa interior, cada uno con su temperatura. Carcasa: cada una de las cuatro caras partida en 11 franjas de 40 mm de alto, más la tapa, el suelo y la bandeja. Así el modelo ve cómo baja el calor por la chapa hacia la zona del cajón de pajitas.
Fuera: el aire del bar y la pared.

### 5.2 Los coeficientes, paso a paso

Convección natural en las caras exteriores (placa vertical, Churchill y Chu)

]² · · · Ra = g·β·ΔT·L³ / (ν·α) · · · h =

SUSTITUCIÓN L = 0,44 m; ΔT = 6,3 K; Ra = 4,9·10⁷; Nu = 49; h = 49 · 0,0263 / 0,44

RESULTADO h = 2,9 W/m²K con el aire quieto. Multiplicado por 1,15 porque el aire de un bar se mueve algo

Radiación de la chapa pintada hacia el local

SUSTITUCIÓN ε = 0,90; Ts = 304 K; Ta = 298 K

RESULTADO hr = 5,6 W/m²K. Total exterior: 9,0 W/m²K. La radiación pesa más que la convección

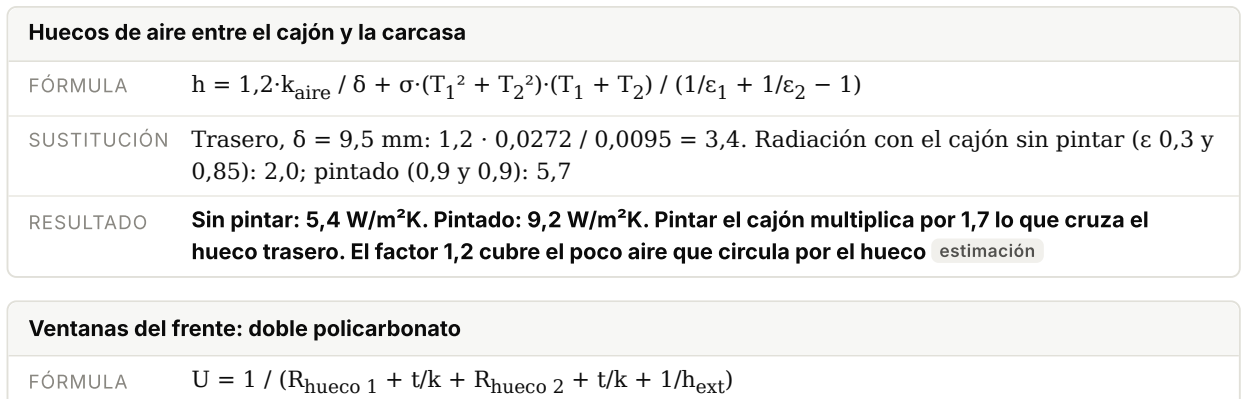
[picture p58: figure]
FÓRMULA; h = 1,2·kaire; 0,85): 2,0; pintado (0,9 y 0,9): 5,7; Ventanas del frente: doble policarbonato
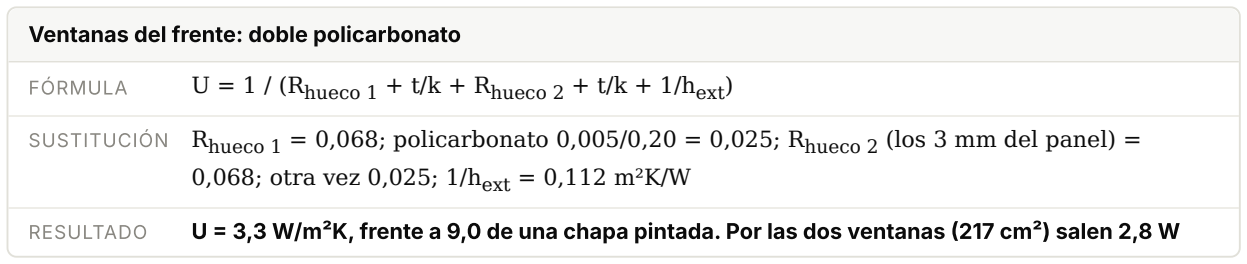
[picture p59: figure]
(los 3 mm del panel) =
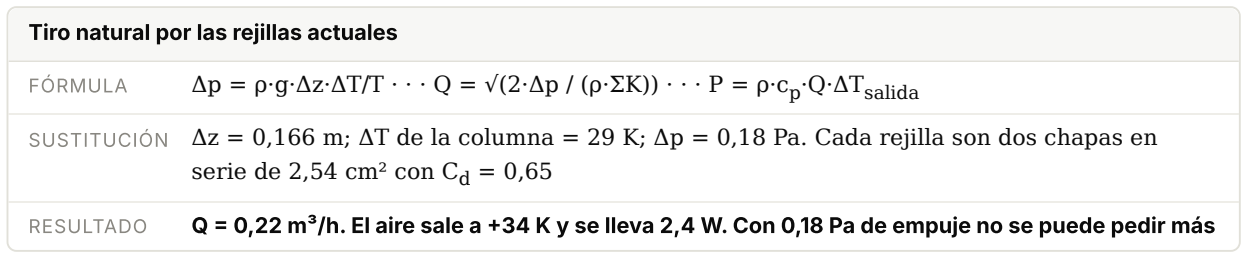
[picture p60: figure]
Tiro natural por las rejillas actuales; ·Q·ΔTsalida; serie de 2,54 cm² con Cd = 0,65
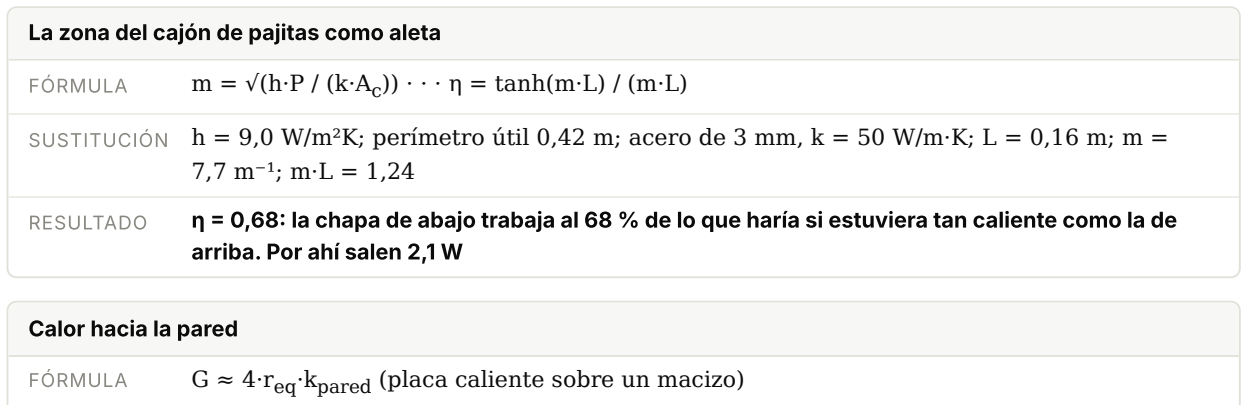
[picture p61: figure]
La zona del cajón de pajitas como aleta; FÓRMULA; )) · · · η = tanh(m·L) / (m·L); arriba. Por ahí salen 2,1 W; Calor hacia la pared; G ≈ 4·req; ·kpared; (placa caliente sobre un macizo)
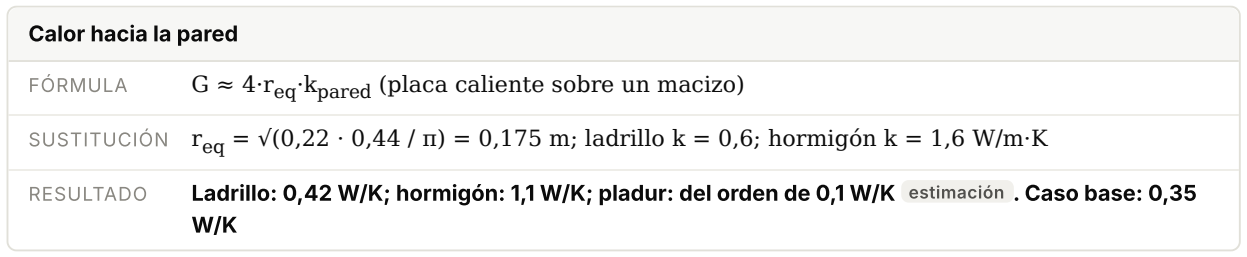
[picture p62: figure]

Estudio térmico del alcoholímetro · diseño A · 13-11-2026 | 11 / 31

Huecos de aire entre el cajón y la carcasa

SUSTITUCIÓN Trasero, δ = 9,5 mm: 1,2 · 0,0272 / 0,0095 = 3,4. Radiación con el cajón sin pintar (ε 0,3 y

RESULTADO | Sin pintar: 5,4 W/m²K. Pintado: 9,2 W/m²K. Pintar el cajón multiplica por 1,7 lo que cruza el hueco trasero. El factor 1,2 cubre el poco aire que circula por el hueco estimación
FÓRMULA | U = 1 / (Rhueco 1 + t/k + Rhueco 2 + t/k + 1/hext

SUSTITUCIÓN Rhueco 1 = 0,068; policarbonato 0,005/0,20 = 0,025; Rhueco 2
0,068; otra vez 0,025; 1/hext = 0,112 m²K/W
RESULTADO | U = 3,3 W/m²K, frente a 9,0 de una chapa pintada. Por las dos ventanas (217 cm²) salen 2,8 W
FÓRMULA | Δp = ρ·g·Δz·ΔT/T · · · Q = √(2·Δp / (ρ·ΣK)) · · · P = ρ·cp

SUSTITUCIÓN Δz = 0,166 m; ΔT de la columna = 29 K; Δp = 0,18 Pa. Cada rejilla son dos chapas en

RESULTADO Q = 0,22 m³/h. El aire sale a +34 K y se lleva 2,4 W. Con 0,18 Pa de empuje no se puede pedir más

SUSTITUCIÓN h = 9,0 W/m²K; perímetro útil 0,42 m; acero de 3 mm, k = 50 W/m·K; L = 0,16 m; m =

RESULTADO η = 0,68: la chapa de abajo trabaja al 68 % de lo que haría si estuviera tan caliente como la de

SUSTITUCIÓN req = √(0,22 · 0,44 / π) = 0,175 m; ladrillo k = 0,6; hormigón k = 1,6 W/m·K

RESULTADO Ladrillo: 0,42 W/K; hormigón: 1,1 W/K; pladur: del orden de 0,1 W/K estimación . Caso base: 0,35

### 5.3 Comprobaciones del modelo

Comprobación | Resultado

Balance de energía: lo que sale por todos los
caminos frente a lo que se genera

15,69 W frente a 15,69 W

Independencia de la malla: 11, 22 y 44 franjas por cara

+26,51, +26,54 y +26,55 K

Contraste con la regla de los armarios eléctricos (k = 5,5 W/m²K sobre el área eficaz, montaje en pared), aplicada a la zona de componentes

Regla: A = | 1,4·0,22·(0,282 + 0,10) + 1,8·0,10·0,282 = | 0,168 m²; ΔT =
15,7 / (5,5 · 0,168) = | +16,9 K. Modelo con el cajón «transparente»
(huecos muy conductores y todo pintado): +16,6 K

Lo que añade la doble pared con el cajón sin pintar De +16,6 a +26,5 K: unos 10 K

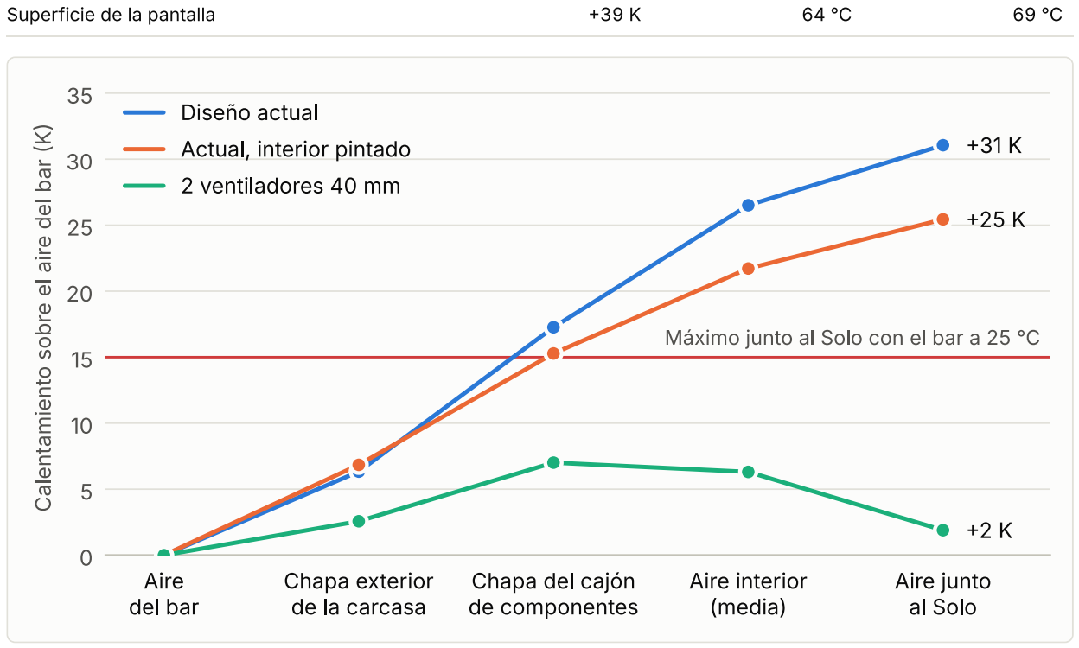
[picture p63: figure]
Superficie de la pantalla

Estudio térmico del alcoholímetro · diseño A · 13-11-2026 | 12 / 31

La tercera fila es la que da confianza: quitando lo que este diseño tiene de particular, el modelo cae sobre la regla empírica que usa la industria para armarios de chapa pintada.

### 5.4 Dónde puede fallar

Convección dentro del cajón. Es el coeficiente peor conocido: 3,5 W/m²K entre el aire y las paredes (rango 2,5–5). Un cajón lleno de cables y placas no se parece a una placa lisa.
Reparto del aire en altura. Supongo que el aire de arriba está un 30 % más caliente que la media (rango 15– 45 %), del orden de lo que maneja la IEC TR 60890 para armarios cerrados. Hay que medirlo con tres sondas a distinta altura.
La pared. Tomo una conductancia fija. Una pared real tarda horas en calentarse, así que las primeras horas se lleva algo más.
Con ventilador, el aire interior es un solo nodo bien mezclado. Lo que ve cada pieza depende de por dónde pase la corriente; lo trato con un factor por pieza (apartado 8.2).

# 6 Resultados del diseño actual

Caso base: bar a 25 °C, 15,7 W dentro, rejillas actuales, carcasa pintada, cajón sin pintar y pared de ladrillo.

Punto | Sobre el bar | Con el bar a 25 °C | Con el bar a 30 °C
Chapa exterior, zona de componentes (media) | +6,3 K | 31 °C | 36 °C
Chapa del cajón de componentes (media) | +17,3 K | 42 °C | 47 °C
Aire interior, media | +26,5 K | 52 °C | 56 °C
Aire junto al Solo y al sensor | +31,1 K | 56 °C | 61 °C
Aire junto a la Pi y al módem | +27,5 K | 52 °C | 57 °C

Figura 6. De fuera a dentro: cuánto sube la temperatura en cada salto. La chapa exterior apenas se entera (+6 K); los dos saltos grandes están dentro, entre la carcasa y el cajón y entre el cajón y el aire.

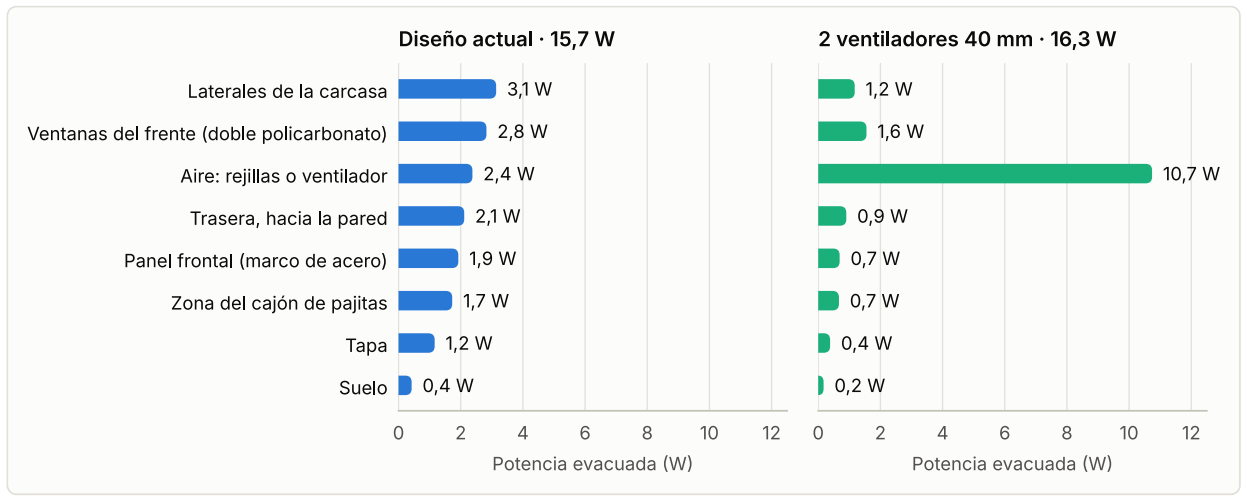
[picture p64: figure]
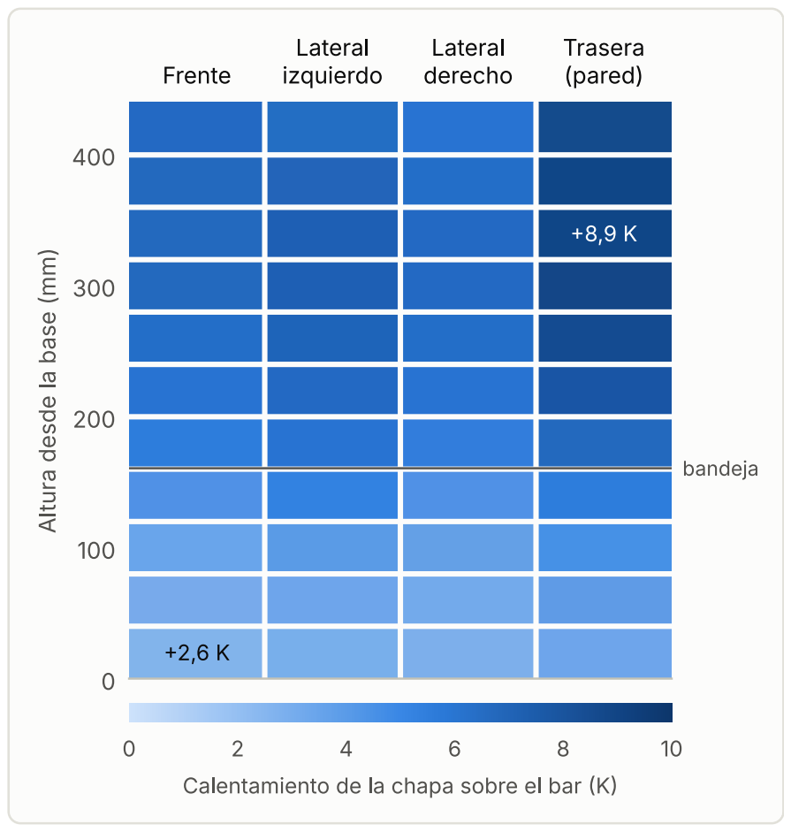
[picture p65: figure]

Estudio térmico del alcoholímetro · diseño A · 13-11-2026 | 13 / 31

### 6.1 Dónde se pierde la temperatura

Del bar a la chapa exterior: +6 K. La carcasa de 3 mm reparte bien el calor y por fuera está casi fría. De la carcasa al cajón: +11 K. Es el precio de los huecos de aire.
Del cajón al aire interior: +9 K. Poca superficie (0,14 m²) y aire casi quieto.
De la media a la zona del Solo: +5 K. El aire caliente sube.
Con el interior pintado, el segundo y el tercer salto se reducen y el total baja 6 K.

### 6.2 Por dónde sale el calor

Figura 7. Reparto de la potencia por camino de salida. A la izquierda, el diseño actual: ningún camino destaca, todos son malos. A la derecha, con dos ventiladores: dos tercios del calor se van con el aire.

Los laterales son la mejor superficie, pero son
estrechos: 3,1 W.
El frente entero, entre ventanas y marco, evacua
4,8 W, pese a ser la cara más grande.
La pared se lleva 2,1 W. En pladur baja a la cuarta parte.
La zona del cajón de pajitas y el suelo, que no generan calor, sacan 2,1 W gracias a la chapa de 3 mm.
La tapa, con su cámara de aire, solo 1,2 W.

Figura 8. Calentamiento de la chapa exterior por cara y altura (diseño actual). La trasera es la más caliente porque detrás van la fuente y la Pi y porque la pared evacua poco.

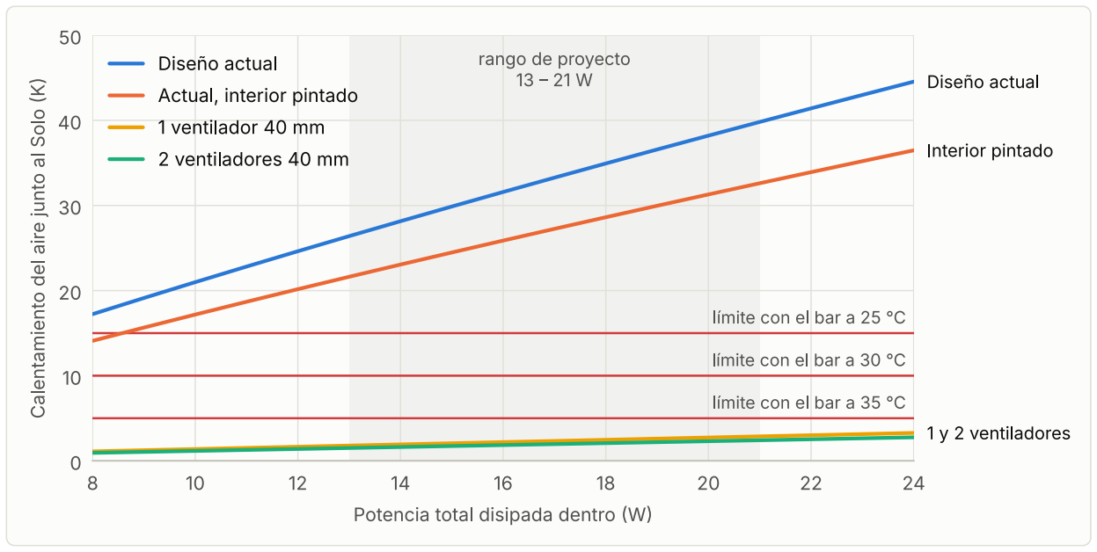
[picture p66: figure]
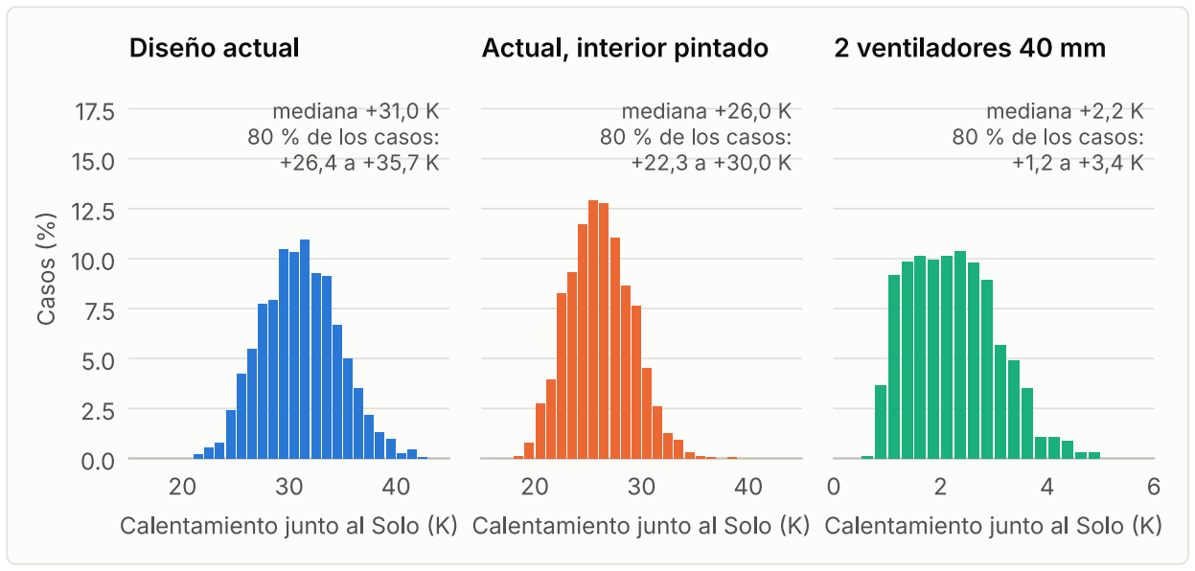
[picture p67: figure]

Estudio térmico del alcoholímetro · diseño A · 13-11-2026 | 14 / 31

### 6.3 Con otra potencia

Figura 9. Calentamiento del aire junto al Solo según la potencia. Las líneas rojas marcan cuánto puede calentarse como mucho para no pasar de 40 °C con el bar a 25, 30 y 35 °C. Sin ventilador se pasa siempre; con ventilador sobra margen en todo el rango.

Sin ventilador, cada vatio de más son 1,7 K junto al Solo. Con ventiladores, 0,11 K.
Para que el diseño actual cumpliera con el bar a 25 °C tendría que disipar menos de 7 W. No es realista: solo la pantalla y la Pi en reposo ya suman 4,5 W, sin contar la fuente.

### 6.4 Cuánto me puedo estar equivocando

He repetido el cálculo 1 500 veces por configuración, sacando cada parámetro incierto de su rango (anexo A): potencia entre 12 y 21 W, convección interior, emisividades, tipo de pared, aire del bar, calidad de las soldaduras, fugas y reparto en altura.

Figura 10. Resultado de los 1 500 casos por configuración. Ningún caso del diseño actual baja de +21 K; ningún caso con ventiladores pasa de +5 K.

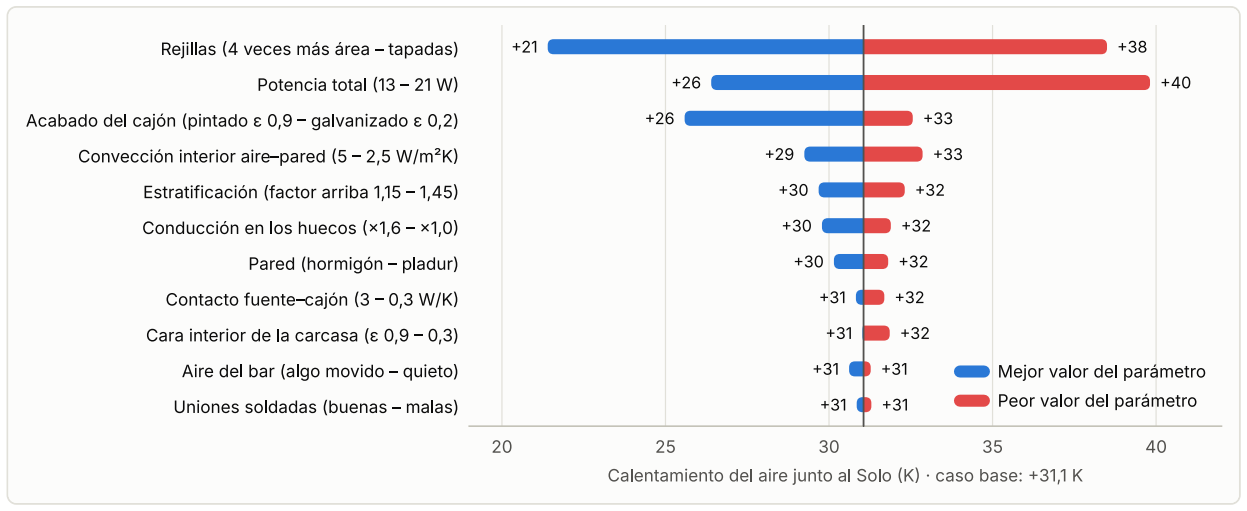
[picture p68: figure]
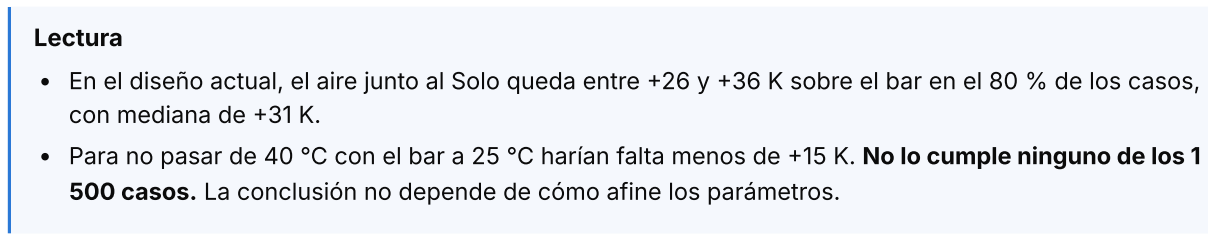
[picture p69: figure]
Lectura; con mediana de +31 K.

Estudio térmico del alcoholímetro · diseño A · 13-11-2026 | 15 / 31

Figura 11. Efecto de cada parámetro por separado sobre el diseño actual. Lo que más mueve el resultado es lo que se puede decidir: las rejillas, la potencia y el acabado del cajón. Lo que no se controla (pared, aire del bar, soldaduras) apenas pesa.

En el diseño actual, el aire junto al Solo queda entre +26 y +36 K sobre el bar en el 80 % de los casos,

Para no pasar de 40 °C con el bar a 25 °C harían falta menos de +15 K. No lo cumple ninguno de los 1 500 casos. La conclusión no depende de cómo afine los parámetros.

### 6.5 Por qué sale más que en el Bloque 1

Punto | Bloque 1 | Este estudio | Efecto
Paredes | Regla de armarios: 5,5 W/m²K sobre 0,15 m², con un 40 % menos por la doble pared: 0,50 W/K | Red de nodos con cada hueco, el frente de policarbonato, la pared y la zona de abajo: 0,50 W/K, contando las ventanas | parecido
Rejillas | 4 W por tiro natural, con una chapa | 2,4 W: el aire cruza dos chapas seguidas en cada
rejilla

+3 K

Acabado del
cajón
No lo distingue | Sin pintar como caso base; pintado baja a +21,7 K | ±5 K

Dónde se
mide
Media del aire interior: +24 K | Media +26,5 K, y además la zona del Solo: +31 K | +5 K

En la media los dos cálculos casi coinciden. Lo nuevo es el reparto en altura: las piezas de 40 °C están en la zona más caliente, y esa es la cifra que hay que comparar con su límite.

# 7 ¿Se arregla sin ventilador?

Lo he intentado antes de dar por buena la ventilación forzada, porque un ventilador es una pieza que se mueve y una abertura por la que entra una copa. La respuesta es que no.

Estudio térmico del alcoholímetro · diseño A · 13-11-2026 | 16 / 31
Medida pasiva | Aire junto al Solo Bar máximo para el Solo Pega
Diseño actual | +31,1 K | 8 °C
Pintar el cajón y el interior de la carcasa (mate, cualquier color) | +25,4 K | 14 °C Ninguna. Hay que hacerlo de
todos modos
Rejillas 4 veces mayores (10 cm² cada una) | +21,4 K | 18 °C 12 ranuras por rejilla
Rejillas 16 veces mayores (40 cm² cada una) | +11,4 K | 28 °C Medio lateral abierto: entran
líquidos, dedos y palillos
Las dos cosas: 40 cm² por rejilla e interior pintado | +10,2 K | 29 °C Lo mismo, y aun así se queda
corta en verano
Bajar la potencia a 12 W (pantalla de 2,4 W, brillo bajo) | +25 K | 15 °C Ayuda, pero sola no basta

Con el tiro natural no hay fuerza: 17 cm de desnivel y 30 K de diferencia dan 0,18 Pa. Un ventilador de 40 mm da 17 Pa, cien veces más.
La única pasiva que llegaría es abrir del orden de 40 a 80 cm² arriba y otro tanto abajo. En una máquina de bar «a prueba de balas» eso es peor que un ventilador.
Otra vía sería rehacer la arquitectura: quitar la doble pared, o atornillar la fuente y la Pi directamente a la carcasa para que la chapa de 3 mm haga de disipador. Choca con el cajón extraíble sobre silentblocks, que es una decisión tomada por otros motivos. No la propongo.
Las medidas pasivas sí valen como red de seguridad: con el interior pintado, una avería de los ventiladores deja la máquina 6 K más fría.

# 8 Ventilación forzada

El Bloque 1 propone dos Noctua NF-A4x10 5V, uno metiendo aire y otro sacándolo. Aquí compruebo cuánto aire mueven de verdad, cuánto enfría, dónde tienen que ir y qué pasa cuando fallan.

### 8.1 Cuánto aire mueven

Punto de trabajo: curva del ventilador contra la resistencia de las aberturas

FÓRMULA | n·Δpmáx

·(1 − Q/Qmáx

) = K·(ρ/2)·(Q/A)²

SUSTITUCIÓN NF-A4x10 5V: Qmáx = 8,2 m³/h y Δpmáx = 1,78 mm H₂O = 17,5 Pa. Abertura de Ø38 mm: A = 11,3 cm². K = 14. Con dos en serie (n = 2) y Q = 5,2 m³/h: velocidad 1,27 m/s; lado derecho 14 · 0,93 = 13,1 Pa; lado izquierdo 2 · 17,5 · (1 − 5,2/8,2) = 12,8 Pa

RESULTADO Un ventilador: 4,2 m³/h (51 % de su caudal libre). Dos en serie: 5,2 m³/h (63 %)

K es la suma de las pérdidas de todo el recorrido, referida a la abertura de Ø38: dos mallas de protección (unas 3 cada una), dos entradas y salidas bruscas (1,5 cada una), el paso por las dos chapas y los obstáculos de dentro (de 3 a 5). En total, entre 10 y 20; tomo 14 estimación .
La curva del ventilador la tomo recta entre sus dos datos de catálogo estimación . La real tiene una panza a medio caudal, así que estos caudales son algo optimistas: por eso el Bloque 1 usó 4,5 m³/h y aquí uso 5,2 con K holgado. La diferencia entre los dos son 0,7 K.
El empuje del aire caliente (0,04 Pa) no cuenta frente al ventilador: el sentido de la corriente se elige.

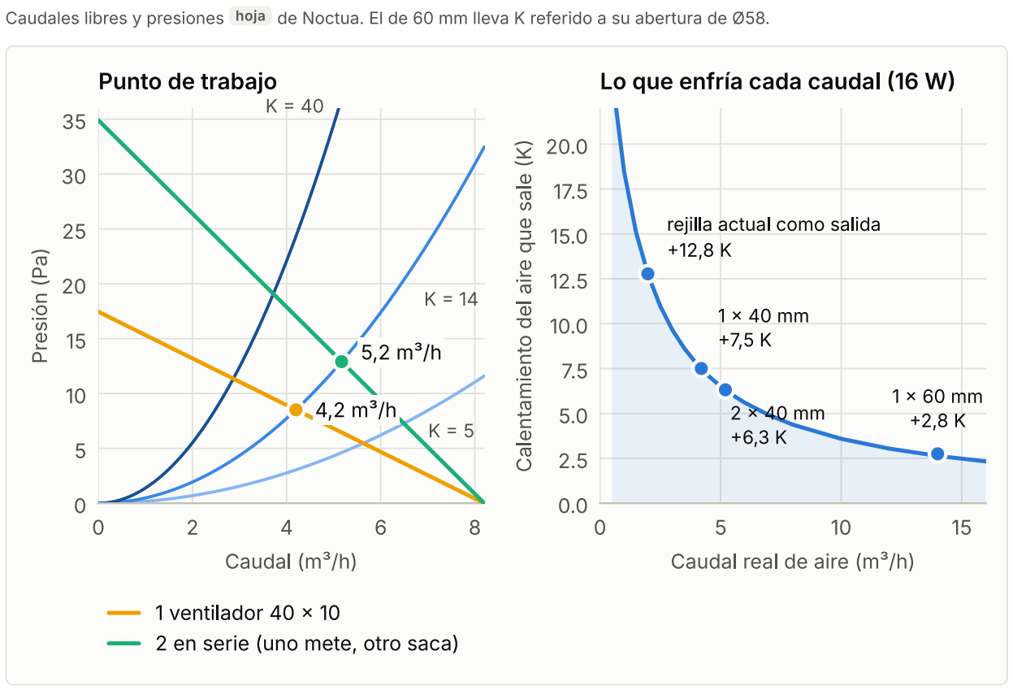
[picture p70: figure]
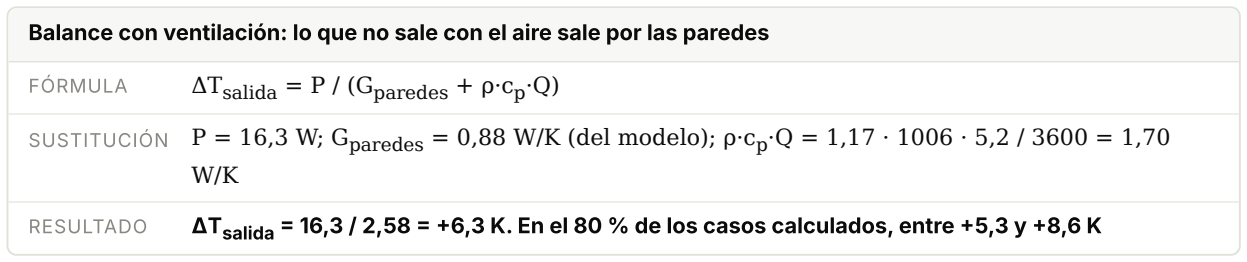
[picture p71: figure]
FÓRMULA; ΔTsalida = P / (Gparedes + ρ·cp

Estudio térmico del alcoholímetro · diseño A · 13-11-2026 | 17 / 31
Caudal real (m³/h) según lo limpio que sea el paso | K = | 10 | K = 20 | K = 40 | K = 80 | Catálogo, caudal libre
1 × 40 × 10 mm | | 4,7 | 3,7 | 2,9 | 2,2 | 8,2
2 × 40 × 10 en serie mm | | 5,6 | 4,7 | 3,7 | 2,9 | 8,2
2 × 40 × 20 en serie mm | | 6,4 | 5,3 | 4,2 | 3,2 | 9,4
1 × 60 × 25 mm | 13,5 | 10,4 | 7,8 | 5,8 | 29,2

Caudales libres y presiones hoja de Noctua. El de 60 mm lleva K referido a su abertura de Ø58.

Figura 12. Izquierda: curvas de uno y de dos ventiladores de 40 × 10 mm contra tres resistencias del recorrido; los puntos son el caso de cálculo. Derecha: calentamiento del aire que sale según el caudal real, con 16 W dentro.

### 8.2 Cuánto enfría

Balance con ventilación: lo que no sale con el aire sale por las paredes

SUSTITUCIÓN P = 16,3 W; Gparedes = 0,88 W/K (del modelo); ρ·cp

RESULTADO ΔTsalida = 16,3 / 2,58 = +6,3 K. En el 80 % de los casos calculados, entre +5,3 y +8,6 K

Lo que ve cada pieza depende de dónde esté respecto a la corriente. Con la entrada junto al Solo y la salida abajo:

Estudio térmico del alcoholímetro · diseño A · 13-11-2026 | 18 / 31

Pieza

Fracción del calentamiento de salida que ve Aire a su lado Por qué

SumUp Solo | 0,30 (0,15–0,50) | +1,9 K Recibe el chorro de entrada, apenas mezclado
Cámara | 0,40 | +2,5 K Arriba, cerca de la entrada
Sensor ZE29A | 0,50 (0,30–0,80) | +3,2 K Arriba pero en el lado contrario: aire a medio mezclar
Pi y módem | 0,85 | +5,4 K A media altura, con el aire ya calentado
Pantalla | 1,00 | +6,3 K Junto a la salida
Fuente | 1,00 más 6 K | +12,3 K Dentro de la caja de red, sin corriente directa

Fracciones estimación ; son lo que el ensayo del apartado 14 tiene que confirmar con una sonda en cada punto.

### 8.3 Dónde van la entrada y la salida

El principio del Bloque 1 es el correcto: el aire fresco entra por donde está lo que menos aguanta y sale por donde está lo que más calienta. Al llevarlo a las cotas del CAD salen cuatro cosas:

Punto | Qué he comprobado en el CAD | Qué propongo
Entrada | En el lateral derecho, arriba (donde hoy está la rejilla, a
unos 345–390 mm de la base), el Solo queda a unos 12 mm
del lateral del cajón. Un ventilador de 10 mm de grueso
| cabe, muy justo | Entrada ahí, soplando hacia el Solo. A confirmar en el bloque 3

Salida «por
la caja de
red»

A la altura de la caja de red, el lateral derecho lo ocupa la toma C14 (de 49 a 87 mm de fondo). Delante quedan 33 mm: una abertura de Ø38 no cabe. Además, el frente de la caja de red solo tiene 4 ranuras de 20 × 4 mm (3,1 cm²): si todo el aire pasa por ahí, el caudal baja de 5,2 a 3,6 m³/h

Salida abajo a la izquierda, donde hoy está la rejilla de entrada: hay 49 mm de fondo entre pestañas y 46 mm de alto bajo la placa de la antena. Cabe un 40 mm, justo; hay que mover los dos topes de goma de esa zona

La fuente Con la salida a la izquierda, la fuente queda en un rincón sin corriente

No importa: admite 70 °C y pasa su calor a la trasera del cajón. Sí conviene abrir 10 cm² o más de ranuras en la caja de red para que respire

Ventilador
de 60 mm

El Bloque 1 lo dejaba abierto «si cabe». En los laterales hay 49 mm de fondo entre las pestañas del cajón: un 60 mm no cabe

Dos de 40 mm. Si el fondo interior lo permite, el de salida de 40 × 20 mm

Las rejillas actuales no valen como salida de un ventilador. Tres ranuras en dos chapas son un K de 94: el caudal se queda en 2,0 m³/h y el aire sale a +12,8 K. Hacen falta aberturas de verdad, de Ø38 o equivalentes.
El sensor queda a media corriente. Para darle también aire fresco, dejaría abierta la rejilla de arriba a la izquierda y pondría a la salida el ventilador más fuerte: con la caja en ligera depresión, esa rejilla aspira aire del bar justo al lado del sensor estimación .
Burlete entre cajón y carcasa en cada abertura, como ya dice el Bloque 1. Sin él, el ventilador de entrada sopla al hueco entre las dos chapas y el aire vuelve a salir sin pasar por dentro.
Aberturas con lamas hacia abajo o con un deflector por dentro, para que una copa tirada de lado no entre. Esa protección es parte del K = 14.

Estudio térmico del alcoholímetro · diseño A · 13-11-2026 | 19 / 31

### 8.4 Averías y suciedad

Situación | | | Caudal | Aire que sale | Junto al Solo,
bar a 30 °C Valoración
Dos ventiladores, mallas limpias | 5,2 m³/h | +6,3 K | 32 °C Normal

Un ventilador parado (el otro tira a
través de él)
3,9 m³/h | +8,0 K | 33 °C Sigue en ficha. Avisar y cambiarlo en la
| | | | | | siguiente visita
Mallas tapadas al 50 % | 4,2 m³/h | +7,5 K | 33 °C Sigue en ficha
Mallas tapadas al 75 % | 2,6 m³/h | +10,6 K | 35 °C Al límite en verano. La sonda lo ve; los
| | | | | | tacómetros no

Mallas tapadas al 90 %, o una
funda encima
1,2 m³/h | +17,0 K | 42 °C Fuera de ficha
Los dos parados | tiro natural +26 K de media | 60 °C Como el diseño actual. Hay que dejar
| | | | | | de cobrar

Con poco caudal la corriente deja de barrer y el Solo ve una fracción mayor del calentamiento; por eso en las filas degradadas uso fracciones de 0,35 a 0,7 estimación .

### 8.5 Los ventiladores pasan a ser una pieza crítica

Hoy los dos cuelgan del mismo fusible (W31 del Bloque 1, MINI de 2 A). Un fusible, un empalme o un cable dejan la máquina sin ventilación de golpe. Propongo un fusible por ventilador: son dos portafusibles en vez de uno.
Los tacómetros no bastan. Un ventilador puede girar a sus vueltas con la malla tapada o con una funda encima. Hace falta una sonda de temperatura junto al Solo (una DS18B20 al GPIO4, unos 3 €), que mide lo que de verdad importa.
Tres fuentes de temperatura para el programa: la sonda, la battery_temperature que da la API de SumUp y la del procesador de la Pi (vcgencmd measure_temp). Umbrales en el apartado 13.
Polvo. De acuerdo con el Bloque 1: malla metálica y no filtro de espuma. Con malla, lo que se tapa se ve desde fuera y se limpia con la mano.

# 9 Temperatura de cada pieza y del bar

Las dos tablas dan la temperatura del aire junto a cada pieza según la temperatura del bar. Verde: dentro de ficha con 5 K o más de margen. Amarillo: dentro, con menos de 5 K. Rojo: fuera.

### 9.1 Diseño actual

Pieza | Límite Bar a 15 °C Bar a 20 °C Bar a 25 °C Bar a 27 °C Bar a 30 °C Bar a 35 °C Bar a 40 °C
SumUp Solo | 40 °C | ✗ 47 | ✗ 51 | ✗ 56 | ✗ 58 | ✗ 61 | ✗ 65 | ✗ 70
Sensor ZE29A | 40 °C | ✗ 47 | ✗ 51 | ✗ 56 | ✗ 58 | ✗ 61 | ✗ 65 | ✗ 70
Módem 4G | 40 °C | ✗ 43 | ✗ 48 | ✗ 53 | ✗ 54 | ✗ 57 | ✗ 62 | ✗ 67
Cámara | 50 °C | ! 48 | ✗ 53 | ✗ 57 | ✗ 59 | ✗ 62 | ✗ 67 | ✗ 71
Raspberry Pi 3B+ | 50 °C | ✓ 43 | ! 48 | ✗ 52 | ✗ 54 | ✗ 57 | ✗ 62 | ✗ 67
Pantalla 7″ | 50 °C | ✓ 38 | ✓ 43 | ! 48 | ! 50 | ✗ 53 | ✗ 57 | ✗ 62
Fuente LRS-50-5 | 70 °C | ✓ 43 | ✓ 48 | ✓ 53 | ✓ 55 | ✓ 58 | ✓ 62 | ! 67

Estudio térmico del alcoholímetro · diseño A · 13-11-2026 | 20 / 31

### 9.2 Con dos ventiladores de 40 mm

Pieza | Límite Bar a 15 °C Bar a 20 °C Bar a 25 °C Bar a 27 °C Bar a 30 °C Bar a 35 °C Bar a 40 °C
SumUp Solo | 40 °C | ✓ 17 | ✓ 22 | ✓ 27 | ✓ 29 | ✓ 32 | ! 37 | ✗ 42
Sensor ZE29A | 40 °C | ✓ 18 | ✓ 23 | ✓ 28 | ✓ 30 | ✓ 33 | ! 38 | ✗ 43
Módem 4G | 40 °C | ✓ 20 | ✓ 25 | ✓ 30 | ✓ 32 | ! 35 | ✗ 40 | ✗ 45
Cámara | 50 °C | ✓ 17 | ✓ 23 | ✓ 28 | ✓ 30 | ✓ 33 | ✓ 38 | ✓ 43
Raspberry Pi 3B+ | 50 °C | ✓ 20 | ✓ 25 | ✓ 30 | ✓ 32 | ✓ 35 | ✓ 40 | ! 45
Pantalla 7″ | 50 °C | ✓ 21 | ✓ 26 | ✓ 31 | ✓ 33 | ✓ 36 | ✓ 41 | ! 46
Fuente LRS-50-5 | 70 °C | ✓ 27 | ✓ 32 | ✓ 37 | ✓ 39 | ✓ 42 | ✓ 47 | ✓ 52
✓ en ficha, | margen ≥ 5 K | ! en ficha, | margen < 5 K | ✗ fuera de ficha | Temperaturas en °C cálculo | . Pantalla: límite de
50 °C supuesto | . Fuente: aire dentro de la caja de red.

### 9.3 Temperatura máxima del bar, pieza a pieza

Pieza | | | Diseño actual | | Interior pintado | 1 ventilador | | 2 ventiladores
SumUp Solo (40 °C) | 8 °C | 14 °C | 37 °C | 38 °C
Sensor ZE29A (40 °C) | 8 °C | 14 °C | 36 °C | 36 °C
Módem 4G (40 °C) | 12 °C | 17 °C | 33 °C | 34 °C
Cámara (50 °C) | 17 °C | 23 °C | 47 °C | 47 °C
Raspberry Pi 3B+ (50 °C) | 22 °C | 27 °C | 43 °C | 44 °C
Pantalla 7″ (50 °C) | 27 °C | 31 °C | 42 °C | 43 °C
Fuente LRS-50-5 (70 °C) | 42 °C | 46 °C | 56 °C | 57 °C
Todo en ficha | 8 °C | 14 °C | 33 °C | 34 °C

Con ventilación, quien limita ya no es el Solo sino el módem: tiene el mismo límite de 40 °C y está a media altura, donde el aire ya va calentado. Si gana el montaje (b) del Bloque 1, con el módem tras la ventana de la antena, conviene que quede en la corriente de entrada.
Un bar climatizado está entre 21 y 26 °C: el reglamento español de instalaciones térmicas no deja calentar por encima de 21 °C ni enfriar por debajo de 26 °C. Con ventilación quedan de 8 a 13 K de margen. Un bar sin aire acondicionado en agosto puede pasar de 30 °C, y ahí el margen es de 4 K.

### 9.4 La Pi por dentro

El límite de 50 °C es del aire que la rodea. Lo que la frena es el procesador: a 60 °C baja de 1,4 a 1,2 GHz y a partir de 80 °C recorta más hoja .
En las pruebas publicadas, la 3B+ gasta 1,9 W en reposo y 5,8 W a plena carga, y a plena carga llega enseguida a sus 60 °C en una mesa. De ahí saco unos 9–11 K por vatio entre el procesador y el aire

estimación .
Con unos 3 W reproduciendo vídeo, el procesador va de 27 a 33 K por encima del aire que lo rodea:
Caso | Aire junto a la Pi | Procesador (estimado) Efecto
Diseño actual, bar a 25 °C | 52 °C | 79–85 °C Recorte fuerte: vídeo a saltos
Dos ventiladores, bar a 25 °C | 30 °C | 57–63 °C En el umbral de los 60 °C
Dos ventiladores, bar a 35 °C | 40 °C | 67–73 °C A 1,2 GHz casi siempre

Dos medidas baratas: un disipador de aluminio pegado al procesador (unos 3 €; de 5 a 10 K menos estimación ) y temp_soft_limit=70 en config.txt, que sube el primer umbral de 60 a 70 °C y es el

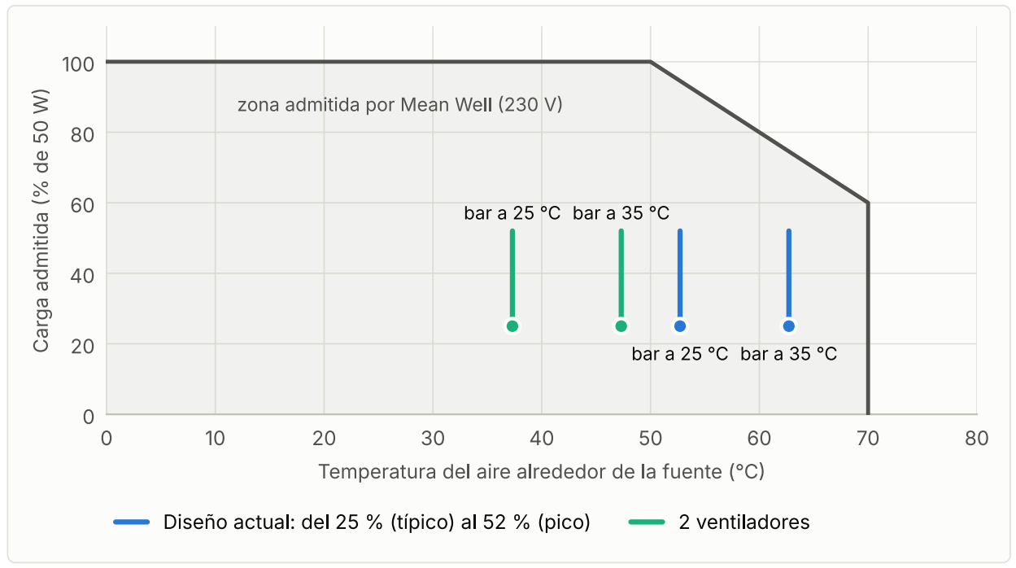
[picture p72: figure]

Estudio térmico del alcoholímetro · diseño A · 13-11-2026 | 21 / 31

máximo que admite ese ajuste.
Esto refuerza la prueba C1 del Bloque 1: los vídeos hay que probarlos con la caja cerrada y caliente, no sobre la mesa.

### 9.5 La fuente

Figura 13. Curva de reducción de carga de la LRS-50-5 a 230 V, leída en la hoja de Mean Well, con los puntos de trabajo de la máquina. Cada trazo vertical va del consumo típico (25 %) al pico (52 %). La fuente queda dentro de su zona en todos los casos.

La ficha del repositorio dejaba esta curva como «ilegible». En la figura de la hoja se lee bien: 100 % hasta 50 °C y bajada recta hasta el 60 % a 70 °C, a 230 V hoja .
La fuente no limita. Lo que sí cambia con el calor es su vida (apartado 12).

### 9.6 El Solo por dentro

Los 40 °C son del aire que lo rodea. Su batería irá de 3 a 5 K por encima mientras no cargue, y más cuando cargue tras un corte estimación .
Las guías de carga de las baterías de litio (JEITA) reducen la carga por encima de 45 °C y la cortan entre 50 y 60 °C dato general . En el diseño actual, con el bar a 25 °C, la batería del Solo estaría a unos 60 °C: probablemente ni cargaría.

Respuesta a «qué temperatura soporta»
La carcasa y los materiales: más de 70 °C en continuo. No limitan.
La máquina tal como está dibujada: un bar a 8 °C con todo en ficha. En un bar normal, a 22–26 °C, el Solo y el sensor trabajarían a 53–57 °C.
La máquina con dos ventiladores: hasta unos 34 °C de bar con todo en ficha, y 38 °C si solo se mira el Solo. Como especificación de instalación propongo bares de 10 a 32 °C, que deja 2 K para lo que el modelo no ve.
Por abajo: 10 °C en el sensor. Con los ventiladores parados en frío, la máquina se calienta sola y admite bares de hasta unos 0 °C (apartado 11).
Al sol directo: no, en ningún caso.

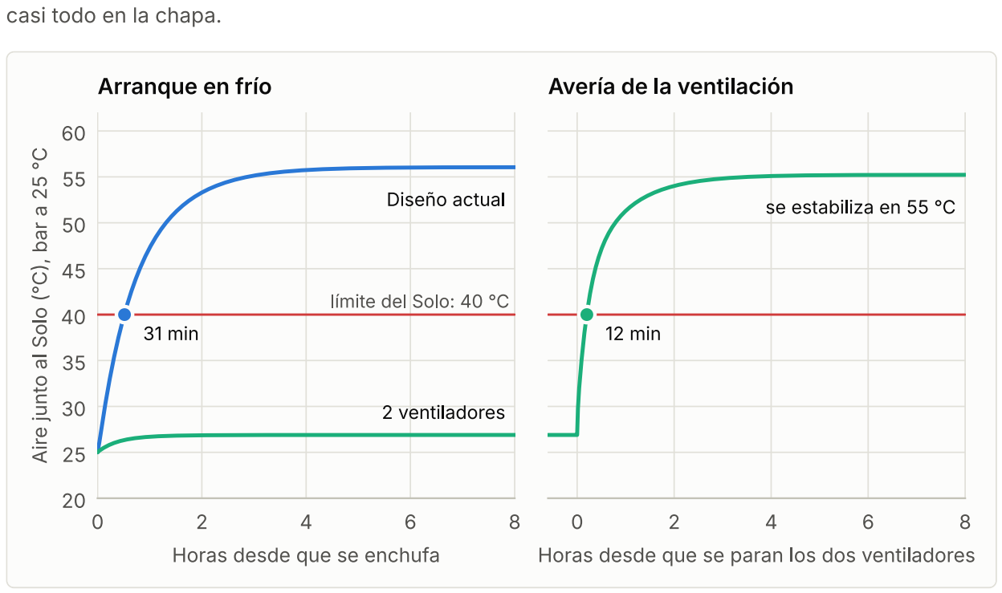
[picture p73: figure]
casi todo en la chapa.

Estudio térmico del alcoholímetro · diseño A · 13-11-2026 | 22 / 31

# 10 Arranque, averías y cortes de luz

El mismo modelo, ahora con la masa de cada pieza: la máquina almacena unos 6,5 kJ por kelvin,

Figura 14. Temperatura del aire junto al Solo con el bar a 25 °C. Izquierda: desde que se enchufa en frío. Derecha: desde que se paran los dos ventiladores estando en régimen.

### 10.1 Arranque en frío

Diseño actual: el aire junto al Solo pasa de 40 °C a los 31 minutos de enchufar. Llega al 63 % de su subida en 47 minutos y al 95 % en 2,5 horas.
Con ventiladores: se estabiliza en menos de 1,4 horas, a 27 °C.
El aire interior responde rápido porque dentro hay poca masa: placas, cables y un cajón de 1,9 kg. La chapa exterior tarda más, pero solo aporta 6 de los 31 K.
Para el ensayo E1 del Bloque 1, 4 horas bastan: a las 4 h el modelo está al 99 % del valor final.

### 10.2 Avería de la ventilación

Si se paran los dos ventiladores con el bar a 25 °C, el aire junto al Solo pasa de 27 a 40 °C en unos 12 minutos y se estabiliza en 55 °C.
Con el bar a 30 °C son unos 6 minutos; a 35 °C, menos de 3.
La subida es tan rápida porque las piezas ya están calientes: con ventilación la Pi y la pantalla trabajan unos 23 K por encima del bar y es el aire quien las enfría. Al pararse el aire, ese calor se queda dentro en minutos. El modelo supone que el aire caliente tarda unos 10 minutos en acumularse arriba supuesto . Consecuencia: el programa no tiene horas para reaccionar, tiene minutos. Tiene que leer la sonda cada pocos segundos, bajar el consumo en cuanto vea el primer umbral y dejar de cobrar en el segundo.

### 10.3 Corte de luz nocturno

Apagada, la máquina se enfría sola: en 3,0 horas el aire interior está a menos de 2 K del bar.
Un corte de 7 horas la deja a la temperatura del local. Cada mañana arranca en frío y repite la curva de la figura.

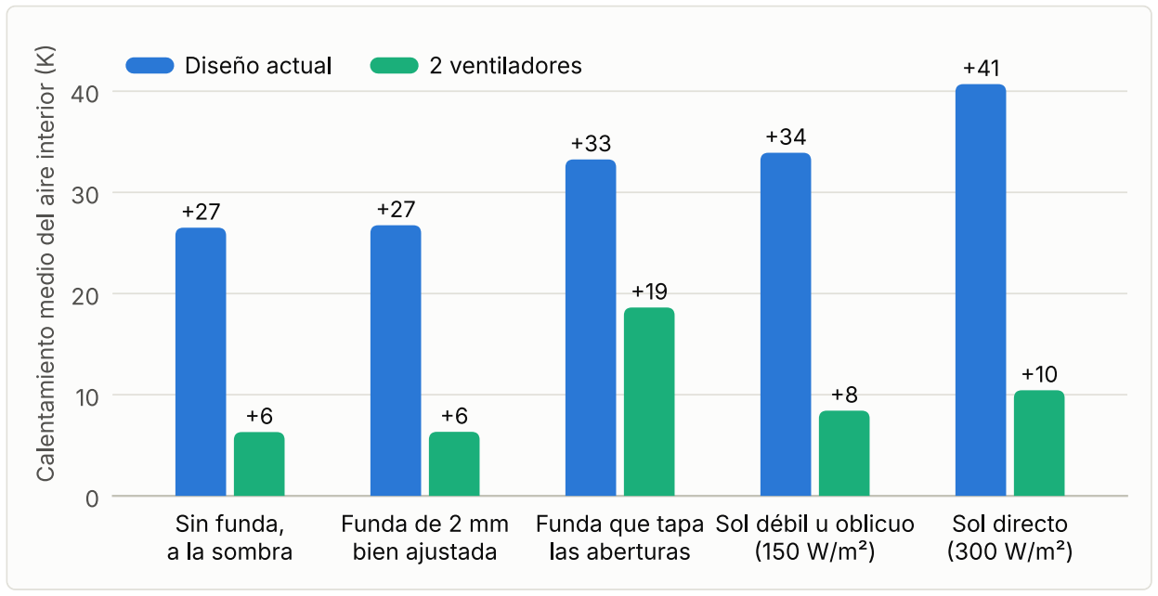
[picture p74: figure]
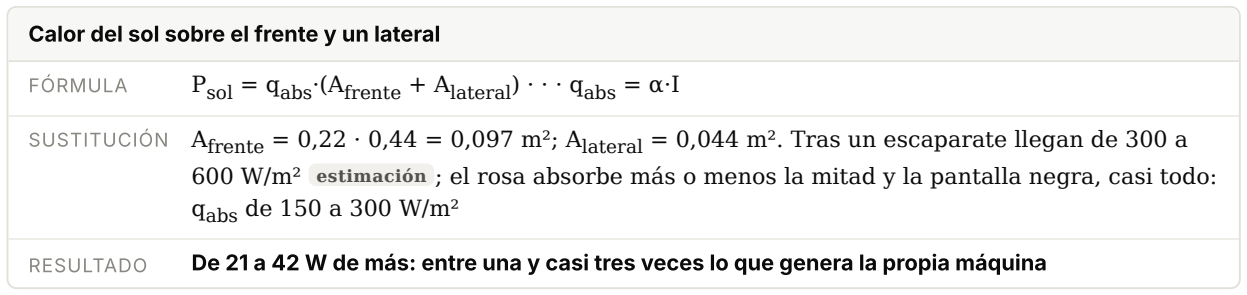
[picture p75: figure]
FÓRMULA; Psol = qabs; ·(Afrente + Alateral; ) · · · qabs = α·I; qabs de 150 a 300 W/m²

Estudio térmico del alcoholímetro · diseño A · 13-11-2026 | 23 / 31

Para el calor esto es bueno: las noches apagada son horas a temperatura ambiente para la batería del Solo y para los condensadores de la fuente.
Para el Solo es su prueba difícil por otro motivo, que ya está en el Bloque 1 (prueba A1): que arranque solo.

# 11 Sol,funda y frío

Figura 15. Calentamiento medio del aire interior en cinco situaciones. «Funda que tapa las aberturas»: en el diseño actual equivale a sellar las rejillas; con ventiladores supongo que el caudal cae a 1 m³/h.

### 11.1 Sol directo

Calor del sol sobre el frente y un lateral

SUSTITUCIÓN Afrente = 0,22 · 0,44 = 0,097 m²; Alateral = 0,044 m². Tras un escaparate llegan de 300 a 600 W/m² estimación ; el rosa absorbe más o menos la mitad y la pantalla negra, casi todo:

RESULTADO | De 21 a 42 W de más: entre una y casi tres veces lo que genera la propia máquina
Sol absorbido | Configuración Aire interior Chapa más caliente Pantalla Pantalla con el bar a 25 °C
150 W/m² (débil u oblicuo) | Diseño actual | +34 K | +17 K | +54 K | 79 °C
| 2 ventiladores | +8 K | +13 K | +34 K | 59 °C
300 W/m² (directo) | Diseño actual | +41 K | +27 K | +68 K | 93 °C
| 2 ventiladores | +10 K | +22 K | +45 K | 70 °C

Los ventiladores salvan el aire interior, pero no salvan la pantalla ni el Solo: el sol entra por las ventanas del frente y los calienta directamente, detrás de dos policarbonatos que no dejan salir ese calor.
Una pantalla a 70 °C está en la zona en la que un LCD empieza a oscurecerse dato general , y el Solo recibe lo mismo en su cara.
Con sol directo la chapa llega a 52 °C: por encima del umbral de quemadura por contacto prolongado.

Estudio térmico del alcoholímetro · diseño A · 13-11-2026 | 24 / 31

Regla de instalación: ninguna hora de sol directo sobre la máquina, tampoco a través de un cristal. Si un local solo tiene ese sitio, no se instala.

### 11.2 La funda de plástico

Bien hecha no molesta. Una funda de 2 mm ajustada a los laterales y la tapa añade unos 0,02 m²K/W: +0,2 K en el diseño actual y nada apreciable con ventiladores. Por la chapa sale poco calor; taparla cambia poco. Mal hecha es una avería. Si tapa las aberturas, la máquina ventilada se va a +19 K. La funda tiene que dejar libres la entrada, la salida, la rejilla que quede y la ventana de la antena, con margen alrededor.
Material. El PLA de impresión 3D empieza a ablandarse hacia 55–60 °C dato general . En condiciones normales la chapa no llega, pero con sol sí. Mejor PETG o ABS.
La funda no puede ir por delante: el frente ya es la cara peor.

### 11.3 Fuentes de calor cercanas

El modelo toma como «bar» el aire que rodea la máquina, no el del termostato del local.
Encima de un radiador, junto a la salida de aire de un botellero o una nevera, al lado de la cafetera o bajo un foco halógeno, ese aire puede estar de 5 a 15 K por encima del resto estimación . Cada kelvin ahí es un kelvin dentro.
Regla de instalación: a más de un metro de cualquier salida de aire caliente y nunca encima de un radiador.

### 11.4 Frío

Bar | Sensor, ventiladores en marcha | Sensor, ventiladores parados | Solo, ventiladores en marcha
0 °C | 3 °C (bajo su mínimo de 10 °C) | 32 °C | 2 °C
5 °C | 8 °C (bajo su mínimo de 10 °C) | 37 °C | 7 °C
10 °C | 13 °C | 42 °C | 12 °C
15 °C | 18 °C | 47 °C | 17 °C

Con los ventiladores siempre en marcha, el sensor baja de sus 10 °C cuando el bar baja de unos 7 °C. Con los ventiladores parados, la máquina se calienta sola y el sensor está a más de 30 °C aunque el bar esté a 0 °C.
Propuesta: que los ventiladores no giren siempre. Parados por debajo de unos 25 °C en la sonda interior y en marcha por encima de 30 °C. Hace falta un transistor o un relé en su rama, o la versión PWM del mismo ventilador.
Ventajas: el sensor trabaja templado, que es como mejor mide y como menos condensa el aliento en el tubo; los ventiladores duran más; y entra menos polvo.
Tras una noche apagada en un local frío, la máquina arranca a la temperatura del bar. Si está por debajo de 10 °C, el programa tiene que esperar a que la sonda suba antes de dar una prueba por válida.

# 12 Calor y vida útil

Estar dentro de ficha no basta para dos años. Tres piezas envejecen según la temperatura a la que pasen el tiempo, y en las tres la ventilación cambia el resultado.

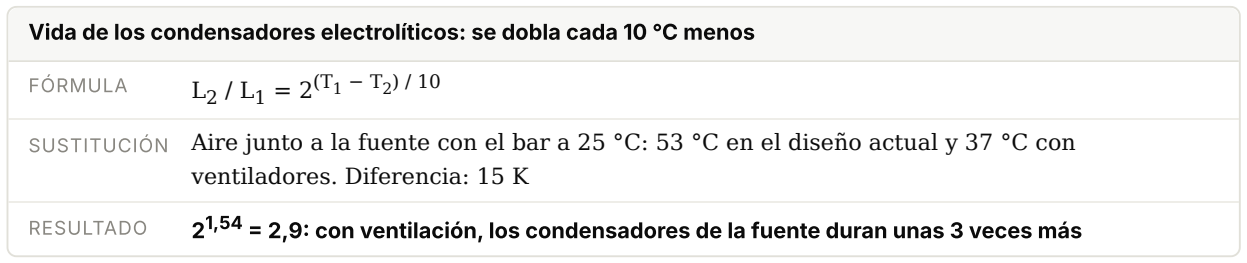
[picture p76: figure]
FÓRMULA; ventiladores. Diferencia: 15 K; RESULTADO

Estudio térmico del alcoholímetro · diseño A · 13-11-2026 | 25 / 31

### 12.1 Batería del Solo

Temperatura de la batería, siempre al 100 % de carga | Capacidad que queda al cabo de un año
0 °C | 94 %
25 °C | 80 %
40 °C | 65 %
60 °C | 60 % a los 3 meses

Datos de Battery University para celdas de litio corrientes hoja . El Solo va siempre enchufado: es exactamente este caso.

Diseño actual, bar a 25 °C: batería a unos 60 °C. Es la última fila: una batería agotada en meses, con riesgo de que se hinche.
Con ventiladores, bar a 25 °C: batería a unos 30–32 °C. Entre la segunda y la tercera fila: del orden del 75 % al año y algo más de la mitad a los dos años estimación .
Como va enchufado, perder capacidad no le impide cobrar. Lo que importa es que no se hinche y que aguante encendido un corte corto. A dos años con ventilación es razonable; sin ella, no.
Coincido con el Bloque 1: el Solo es una pieza que se cambia en la visita de los dos años.

### 12.2 Condensadores de la fuente

Vida de los condensadores electrolíticos: se dobla cada 10 °C menos

SUSTITUCIÓN Aire junto a la fuente con el bar a 25 °C: 53 °C en el diseño actual y 37 °C con

1,54 = 2,9: con ventilación, los condensadores de la fuente duran unas 3 veces más

Los electrolíticos son la única pieza de una fuente que se desgasta, y su vida depende casi solo de la temperatura dato general .
La hoja de la LRS-50 no da horas de vida, solo un MTBF de 561 600 h a 25 °C. Ese dato es estadístico y a 55 °C vale bastante menos.

### 12.3 El resto

Pieza | Qué le hace el calor | Qué hacer
Pantalla | La retroiluminación pierde brillo antes cuanto más caliente trabaja. Paneles parecidos dan 20 000 h a mitad de brillo; dos años encendida son 17 500 h | Brillo al mínimo útil y apagarla en las horas de cierre: menos calor y menos horas

Sensor ZE29A Las celdas electroquímicas pierden electrolito más deprisa con

| calor y aire seco dato general . El manual no da vida | Tenerlo entre 15 y 35 °C: ni en el punto caliente ni en el chorro frío de invierno
Ventiladores | Más de 150 000 h de vida media declarada y trabajo hasta 70 °C hoja . Dos años son 17 500 h | No giran siempre (apartado 11.4)
microSD, Pi, módem | Dentro de ficha no hay un mecanismo de desgaste claro | —

Estudio térmico del alcoholímetro · diseño A · 13-11-2026 | 26 / 31

# 13 Cambios recomendados

Por orden de importancia. Los tres primeros son los que cambian el resultado; el resto son baratos y quitan riesgos.

N.º Cambio | Efecto | Coste | Dónde se hace
1 | Ventilación forzada con dos
ventiladores de 40 mm: entrada arriba a la derecha junto al Solo, salida abajo a la izquierda. Aberturas de Ø38 con malla y lamas, y burlete entre cajón y carcasa | Aire junto al Solo de +31 a +2 K. Bar máximo de 8 a 34 °C | Unos 40 € por máquina | CAD (bloque 3) y compras
2 | Un fusible por ventilador en vez de uno
para los dos

Un fallo eléctrico ya no deja la máquina sin ventilación

Un
portafusibles

Tabla de cableado
(W31)

3 Sonda de temperatura junto al Solo (DS18B20) y umbrales en el programa: a 36 °C baja el brillo y avisa; a 38 °C avisa como avería; a 40 °C deja de cobrar hasta que baje de 37 °C

La máquina se protege sola en los minutos que tiene. Detecta mallas tapadas, fundas y sol, que los tacómetros no ven

Unos 3 € | Compras y
programa (bloque 4)

4 Cajón de componentes e interior de la carcasa pintados en mate, de cualquier color. Nunca galvanizado brillante sin pintar

6 K menos cuando la ventilación falla. De paso resuelve el óxido del cajón

El de pintar por
dentro

Pedido al taller

5 Ventiladores con control: parados por debajo de 25 °C en la sonda, en marcha por encima de 30 °C

Sensor templado en invierno, menos polvo y más vida

Un transistor, o
la versión PWM

Cableado y
programa

6 Reglas de instalación: nunca al sol, a más de un metro de salidas de aire caliente, bares de 10 a 32 °C, aberturas despejadas

Evita los casos que ningún ventilador arregla

Ninguno | Hoja de instalación
7 | Disipador en el procesador de la Pi y
temp_soft_limit=70

La Pi no baja de velocidad en verano

Unos 3 € | Compras y sistema
8 | Más ranuras en la caja de red (10 cm² o
más entre frente y base)

La fuente respira aunque no reciba corriente directa

Ninguno | CAD
9 | Menos vatios: brillo al mínimo útil,
pantalla apagada en el cierre y módem fijado en 4G

De 1 a 3 W menos. Con ventilación son décimas de kelvin, pero alargan la vida de la pantalla y dan margen si falla

Ninguno | Programa
10 | Funda que deje libres las aberturas y la
antena, en PETG o ABS

No convierte un accesorio en una avería

Ninguno | Diseño de la funda
11 | Medir el consumo real con un vatímetro
de enchufe en cuanto haya banco

Sustituye la mayor incógnita del estudio por un dato

Unos 15 € | Banco

Lo que no cambiaría
La doble pared y el cajón extraíble. Cuestan unos 10 K sin ventilación, pero con ventilación dejan de importar: el calor se va con el aire.
El doble policarbonato. Aísla el frente, pero protege lo más caro y con ventilación tampoco limita. La fuente. Trabaja holgada en todos los casos.
La chapa de 3 mm. Reparte muy bien el calor: la zona del cajón de pajitas saca 2,1 W sin generar ninguno.

Estudio térmico del alcoholímetro · diseño A · 13-11-2026 | 27 / 31

# 14 Plan de ensayo

Es el ensayo E1 del Bloque 1, ampliado para que además diga si este modelo acierta. Necesita una carcasa de prototipo con el cajón montado; no hace falta que cobre.

### 14.1 Instrumentación

Sonda | Dónde | Para qué
T0 | Aire de la sala, a 1 m de la máquina y a su altura, a la sombra | Referencia
T1 | Aire a 1 cm del canto superior del Solo | El dato que decide
T2 | Aire junto al sensor ZE29A | Segunda pieza de 40 °C
T3 | Aire junto al módem | Tercera pieza de 40 °C
T4, T5, T6 | Aire en el eje del cajón, a 20, 110 y 210 mm de su base | Media y reparto en altura
T7 | Aire dentro de la caja de red | Fuente
T8 | Chapa exterior, centro del lateral derecho, pegada con cinta | Comprobar que por fuera apenas se nota
T9 | Aire en la boca de salida | Caudal real, por balance
— | vcgencmd measure_temp y battery_temperature del Solo, registradas cada minuto | Procesador y batería
— | Vatímetro de enchufe | Potencia real

Valen termopares tipo K con un registrador o diez DS18B20 en un mismo bus leídas por la propia Pi.

### 14.2 Pasos

Paso Qué se hace | Duración

Lo que predice el modelo
(sobre T0)
1 | Máquina cerrada en la pared, programa en espera con vídeo, ventiladores parados y sus aberturas tapadas con cinta. Sin el Solo: en su sitio, una resistencia de 1 W. Es el paso que lo pondría en riesgo | 3 h | T1 ≈ +38 K; media de T4–T6 ≈ +33 K; T8 ≈ +7 K. Parar si T1 pasa de 65 °C
2 | Quitar la cinta, ventiladores en marcha | 2 h | T9 ≈ +6 K (de +5 a +9); T1 ≈ +2 K; T2 ≈ +3 K; T3 ≈ +5 K
3 | Desenchufar un ventilador | 1 h | T9 ≈ +8 K
4 | Tapar media malla de entrada y media de salida | 1 h | T9 ≈ +7 K
5 | Parar los dos ventiladores con las aberturas libres y cronometrar | 30 min | T1 llega a T0 + 15 K en unos 12 minutos
6 | Prueba completa con cobro simulado cada 2 minutos durante 30 minutos | 30 min | Sin cambio apreciable sobre el paso 2

### 14.3 Criterio de aceptación

Paso 2: T1 y T2 a menos de 5 K sobre la sala y T3 a menos de 8 K. Es el criterio del Bloque 1, con el módem añadido.
Paso 3: T1 a menos de 8 K sobre la sala con un ventilador parado.
Procesador de la Pi por debajo de 70 °C en el paso 2 con la sala a 25 °C.
Si el paso 2 no cumple: revisar el burlete y las mallas antes que nada. Después, ventilador de salida de 40 ×
| 20 mm.

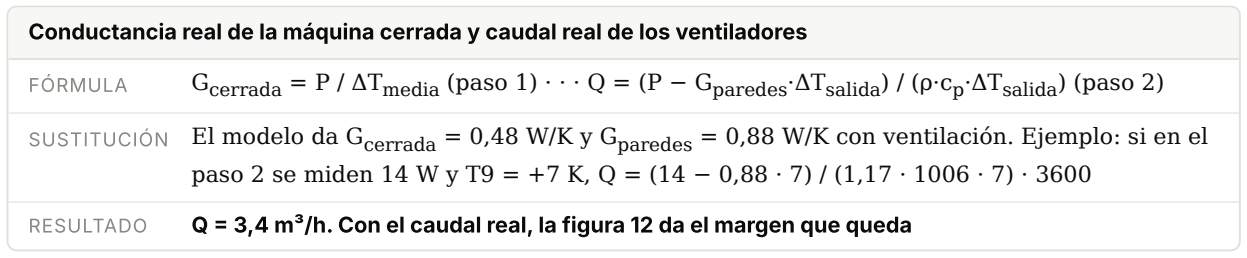
[picture p77: figure]
FÓRMULA; Gcerrada = P / ΔTmedia; (paso 1) · · · Q = (P − Gparedes; ·ΔTsalida; ) (paso 2)

Estudio térmico del alcoholímetro · diseño A · 13-11-2026 | 28 / 31

### 14.4 Cómo corregir el modelo con las medidas

Conductancia real de la máquina cerrada y caudal real de los ventiladores

SUSTITUCIÓN El modelo da Gcerrada = 0,48 W/K y Gparedes = 0,88 W/K con ventilación. Ejemplo: si en el paso 2 se miden 14 W y T9 = +7 K, Q = (14 − 0,88 · 7) / (1,17 · 1006 · 7) · 3600

RESULTADO Q = 3,4 m³/h. Con el caudal real, la figura 12 da el margen que queda

Con la potencia medida y esos dos números se rehacen las tablas del apartado 9 en una tarde. Los scripts están preparados para ello (anexo B).

# 15 Conclusiones

1. El diseño A, tal como está en el CAD, no es viable térmicamente. El aire junto al Solo y al sensor queda unos 31 K por encima del bar, y esas piezas tienen el límite en 40 °C. El resultado aguanta cualquier combinación razonable de parámetros.
2. No es un fallo de una pieza sino de la arquitectura: doble pared, frente aislado, rejillas mínimas y lo delicado arriba. Las medidas pasivas razonables dan de 6 a 10 K y hacen falta más de 20 para un verano.
3. La ventilación forzada lo resuelve con mucho margen: 5 m³/h bastan para dejar el Solo a +2 K y el aire de salida a +6 K. Dos ventiladores de 40 mm los dan con holgura y con redundancia.
4. La temperatura que soporta la máquina ventilada es un bar de 10 a 32 °C como especificación, con el límite real hacia 34 °C. La carcasa en sí aguanta mucho más; mandan el Solo, el sensor y el módem.
5. La ventilación pasa a ser crítica y hay que tratarla como tal: fusibles separados, tacómetros, sonda de temperatura y corte del cobro por programa. Si se para, hay unos 12 minutos.
6. Hay tres casos que ningún ventilador arregla y van a la hoja de instalación: sol directo, fuentes de calor cercanas y aberturas tapadas.
7. Para los dos años sin visitas, el calor deja de ser el problema principal si se hace lo anterior. Quedan los que ya señala el Bloque 1: el arranque del Solo tras un corte, el pago a través del frente y la cobertura.

Llevar al CAD las dos aberturas y los dos ventiladores en las posiciones del apartado 8.3, comprobar que caben y pedir una carcasa de prototipo. Con ella, el ensayo del apartado 14 dura una tarde y cierra el tema

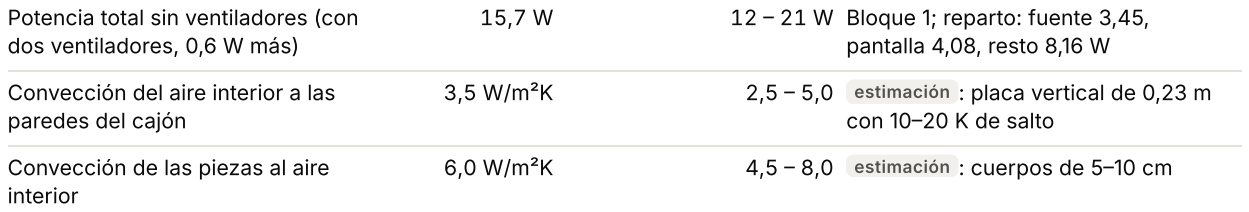
[picture p78: figure]
Potencia total sin ventiladores (con dos ventiladores, 0,6 W más); pantalla 4,08, resto 8,16 W; Convección del aire interior a las paredes del cajón; con 10–20 K de salto; Convección de las piezas al aire interior

Estudio térmico del alcoholímetro · diseño A · 13-11-2026 | 29 / 31

# A Anexo: parámetros del modelo

Parámetro | Caso base Rango en los 1 500 casos Origen
15,7 W | 12 – | 21 W Bloque 1; reparto: fuente 3,45,
| 3,5 W/m²K | 2,5 – | 5,0 | estimación : placa vertical de 0,23 m
| 6,0 W/m²K | 4,5 – | 8,0 | estimación : cuerpos de 5–10 cm
Superficie de las piezas que disipan | 0,050 m² | fija Medidas del CAD; aparte, pantalla
| | | | 0,020 m² y caja de red 0,022 m²
Factor de visión de las piezas hacia las paredes | 0,7 | 0,5 – | 0,9 | estimación

Emisividad exterior (pintura en polvo
y policarbonato)
0,90 | 0,85 – | 0,95 Tablas de emisividad

Emisividad de la cara interior de la carcasa

0,85 | 0,60 – | 0,92 | supuesto : la pintura entra en la
| | | | carcasa abierta
Emisividad del cajón, sin pintar | 0,30 | 0,20 – | 0,45 Tablas: acero laminado 0,24;
| | | | galvanizado 0,28
Emisividad del cajón, pintado | 0,90 | 0,80 – | 0,95 Tablas
Conducción en los huecos de aire (multiplicador) | 1,2 | 1,0 – | 1,6 | estimación : 1,0 es aire quieto
Convección exterior (multiplicador por el aire del bar) | 1,15 | 1,0 – | 1,5 | estimación
Conductancia hacia la pared | 0,35 W/K | 0,1 – | 1,0 | cálculo : pladur, ladrillo y hormigón
Contacto de la trasera con la pared | 30 W/m²K | fijo estimación : medio milímetro de aire
| | | | de media
Calidad térmica de las uniones por puntos | 0,5 | 0,3 – | 1,0 | estimación : 1 sería chapa continua
Conductividad del acero | 50 W/m·K | 45 – | 55 | dato general
Contacto de la fuente con la trasera del cajón | 1,0 W/K | 0,3 – | 3,0 | estimación : 81 cm² de contacto seco

Contacto de la tapa y de la tapa
interior con la carcasa
0,10 W/K | 0,03 – | 0,30 | estimación

Rejillas: área de cada una y coeficiente de descarga

2,54 cm²; 0,65 | 0,55 – | 0,75 CAD; dato general

Fugas de aire por arriba (holgura de la tapa interior)

0,5 cm² | 0 – | 2 cm² estimación

Reparto en altura: aire de arriba respecto a la media

1,30 | 1,15 – | 1,45 | estimación ; a la altura del Solo
| | | | resulta 1,17
Caudal con dos ventiladores | 5,2 m³/h | 3,5 – | 6,5 | cálculo , apartado 8.1

Fracción del calentamiento de salida
que ve el Solo
0,30 | 0,15 – | 0,50 | estimación

Mejora de la convección interior con aire forzado

× 1,25 | fija estimación

Estudio térmico del alcoholímetro · diseño A · 13-11-2026 | 30 / 31

# B Anexo: cómo repetir el cálculo

Todo el estudio sale de unos scripts de Python (NumPy y Matplotlib). Están en el repositorio, en carcasa/diseno-A/estudio-termico/codigo/.

Archivo | Qué hace
termico.py | El modelo: propiedades del aire, correlaciones, la red de 57 nodos, el estado estacionario y el transitorio. Todos los parámetros están en la clase P
analisis_conf.py | Las configuraciones estudiadas: actual, pintado, sellado y las tres con ventilador
analisis.py | Corre todos los casos: configuraciones, potencia, caudal, sensibilidad, los 1 500 casos al azar, márgenes, sol, funda, frío y transitorios. Escribe resultados.json
calc.py | Las cuentas paso a paso que aparecen en los recuadros

fig_*.py, estilo.py Las figuras

informe.py, estilo.css | Montan este documento con los números de resultados.json

Para rehacerlo con datos medidos basta cambiar en analisis_conf.py la potencia (P_psu, P_scr, P_rest) y el caudal (Q_fan), y en termico.py los coeficientes que el ensayo corrija. Después: python3 analisis.py, python3 calc.py, los fig_*.py y python3 informe.py.

Si cambia la geometría (aberturas, huecos, espesores), las cotas están al principio de la clase P, con los mismos nombres y valores que en carcasa/diseno-A/modelo/diseno.py.

Estudio térmico del alcoholímetro · diseño A · 13-11-2026 | 31 / 31

# Fuentes

### Del proyecto

CAD del diseño A (04-11-2026): carcasa/diseno-A/modelo/diseno.py, specs.py, geo.py y comp.py; carcasa/diseno-A/README.md; vistas de carcasa/diseno-A/FreeCAD/.
DECISIONES.md, entradas del 27-10 al 04-11-2026.
Bloque 1 · Componentes eléctricos (13-11-2026) y bloque1/cuentas.py; Verificación del diseño (12-11-2026).
Fichas de componentes/: SumUp Solo, Winsen ZE29A, módem Huawei E3372h, Raspberry Pi 3B+, Camera Module 3, pantalla GeeekPi, Mean Well LRS-50-5, SanDisk High Endurance y WAGO 221.
Hojas de datos en copia local: Mean Well LRS-50 (edición 2025-04-07, curva de la página 3), manual del ZE29A V1.1, ficha de la Raspberry Pi 3B+ y ficha de la Touch Display 2.

### De fabricantes y normas, consultadas el 13-11-2026

SumUp, información de seguridad del Solo (rango de trabajo de 0 a 40 °C): manualslib.com/manual/3046632/Sumup-Solo.html (https://www.manualslib.com/manual/3046632/Sumup-Solo.html?page=12) y fcc.report/FCC-ID/2A39U-PRIN001/6289620.pdf
SumUp, «Avoid blocked readers» (bloqueo permanente; evitar más de 40 °C y menos de 0 °C): help.sumup.com/en-IE/articles/1fH1DQy2SCfsXvrdb76MS0 (https://help.sumup.com/en-IE/articles/1fH1DQy2SCfsXvrdb76MS0)
Noctua, especificaciones del NF-A4x10 5V, NF-A4x20 5V y NF-A6x25 5V: noctua.at/en/nf-a4x10-5v/specification, noctua.at/en/nf-a4x20-5v/specification, noctua.at/en/nf-a6x25-5v/specification
Raspberry Pi, «Thermal testing Raspberry Pi 4» (consumo de la 3B+ en reposo y en carga): raspberrypi.com/blog/thermal-testing-raspberry-pi-4
Raspberry Pi, documentación de gestión térmica (límite blando de 60 °C y temp_soft_limit): github.com/raspberrypi/documentation/pull/1348; valor máximo de 70 °C: brainboxes.com/?p=2381
Rittal, catálogo técnico de climatización de armarios (k = 5,5 W/m²K para chapa de acero en interior): rittal.com/imf/none/3_8419; (https://www.rittal.com/imf/none/3_8419/3312800_Documentaci_oacute_n_t_eacute_cnica_EN) fórmula del área eficaz para montaje contra pared: storage.electrika.com/flips/0700-univ-encl-15 (https://storage.electrika.com/flips/0700-univ-encl-15/files/assets/basic-html/page-521.html)
IEC TR 60890:2022, método de cálculo del calentamiento del aire en envolventes: standards.iteh.ai (IEC TR 60890:2022) (https://standards.iteh.ai/catalog/standards/iec/7a954d7c-2b57-4c93-8b3b-f930bc8b227c/iec-tr-60890-2022) Plancha de policarbonato extruido, datos técnicos (0,2 W/m·K; 115 °C en uso continuo): Impex, guía de producto 08-2022 (https://cdn.shopify.com/s/files/1/0468/4742/6721/files/EN_IMPEX_ProductGuide_08-2022.pdf) 3M, cinta VHB 4949 (93 °C a largo plazo, 149 °C a corto): 3m.com/3M/en_US/p/d/b40072029
Battery University, BU-808 (capacidad tras un año según temperatura y carga): batteryuniversity.com/article/how-to-prolong-lithium-based-batteries (https://batteryuniversity.com/article/how-to-prolong-lithium-based-batteries)
Texas Instruments, SLYT365 (guías JEITA de carga de baterías de litio): ti.com/lit/pdf/slyt365
XP Power y TDK, vida de los condensadores electrolíticos (se dobla cada 10 °C menos): xppower.com/resources/blog/electrolytic-capacitor-lifetime-in-power-supplies, product.tdk.com/en/contact/faq/power-supplies-0018.html (https://product.tdk.com/en/contact/faq/power-supplies-0018.html)
Tablas de emisividad: blog.thermoworks.com/emissivity
Umbral de quemadura por contacto con metal (ASTM C1055 e ISO 13732-1, citadas en un trabajo de NACE): Insulative Coating Evaluation, NACE (https://www.electro-tech-online.com/custompdfs/2013/09/Insulative_Coating_Evaluation_NACE.pdf)
Real Decreto 1826/2009, que modifica el RITE (IT 3.8.2: 21 °C en calefacción y 26 °C en refrigeración): boe.es/eli/es/rd/2009/11/27/1826/con

### De manual

Convección natural en placa vertical: correlación de Churchill y Chu (1975). Capa de aire horizontal calentada por abajo: Hollands y otros (1976). Placas horizontales, aletas y radiación entre superficies grises: como las recoge cualquier texto de transmisión de calor (por ejemplo, Incropera y DeWitt).
