GuillermoAladro/Alcoholimetro/Avatares 2D/README.md

# Avatares 2D

**Un único diseño por persona.** Estilo basado en las elecciones del usuario: **Guillermo Aladro 03** y **Ander 04**. Las alternativas y sus comparativas se han retirado de esta carpeta.

Cada PNG contiene el cuerpo completo y un retrato ampliado del mismo diseño. Se conservan los rasgos, peinado, ropa y accesorios de cada persona a partir de sus SVG.

Colección completa: **14 personas, 14 PNG**.

| Persona | Archivo único | Estado |
|---|---|---|
| [Guillermo Aladro](Guillermo-Aladro/) | [PNG](Guillermo-Aladro/Guillermo-Aladro-2D.png) | Elegido por el usuario |
| [Ander](Ander/) | [PNG](Ander/Ander-2D.png) | Elegido por el usuario |
| [Carla](Carla/) | [PNG](Carla/Carla-2D.png) | Versión única |
| [Dari](Dari/) | [PNG](Dari/Dari-2D.png) | Versión única |
| [Deivi](Deivi/) | [PNG](Deivi/Deivi-2D.png) | Versión única |
| [Gabacho](Gabacho/) | [PNG](Gabacho/Gabacho-2D.png) | Versión única |
| [Kiriku](Kiriku/) | [PNG](Kiriku/Kiriku-2D.png) | Versión única |
| [Laura](Laura/) | [PNG](Laura/Laura-2D.png) | Versión única |
| [Marcos Bombero](Marcos-Bombero/) | [PNG](Marcos-Bombero/Marcos-Bombero-2D.png) | Versión única |
| [Marta](Marta/) | [PNG](Marta/Marta-2D.png) | Versión única |
| [Paradigma](Paradigma/) | [PNG](Paradigma/Paradigma-2D.png) | Versión única |
| [Rodri](Rodri/) | [PNG](Rodri/Rodri-2D.png) | Versión única |
| [Sara Sáez](Sara-Saez/) | [PNG](Sara-Saez/Sara-Saez-2D.png) | Versión única |
| [Yorgi](Yorgi/) | [PNG](Yorgi/Yorgi-2D.png) | Versión única |

## Galería

| Guillermo Aladro | Ander |
|---|---|
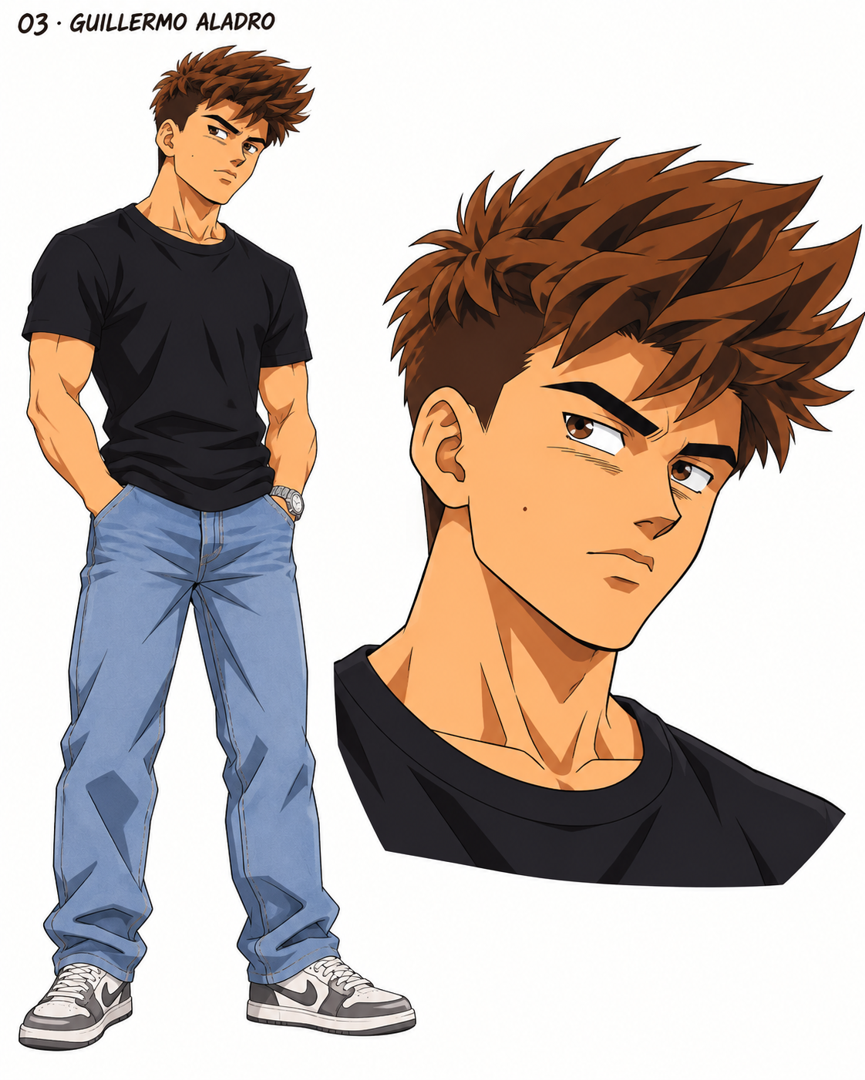
[picture p120: Avatares 2D/Guillermo-Aladro/Guillermo-Aladro-2D.png]
Guillermo Aladro
|  | Ander |

| Carla | Dari |
|---|---|
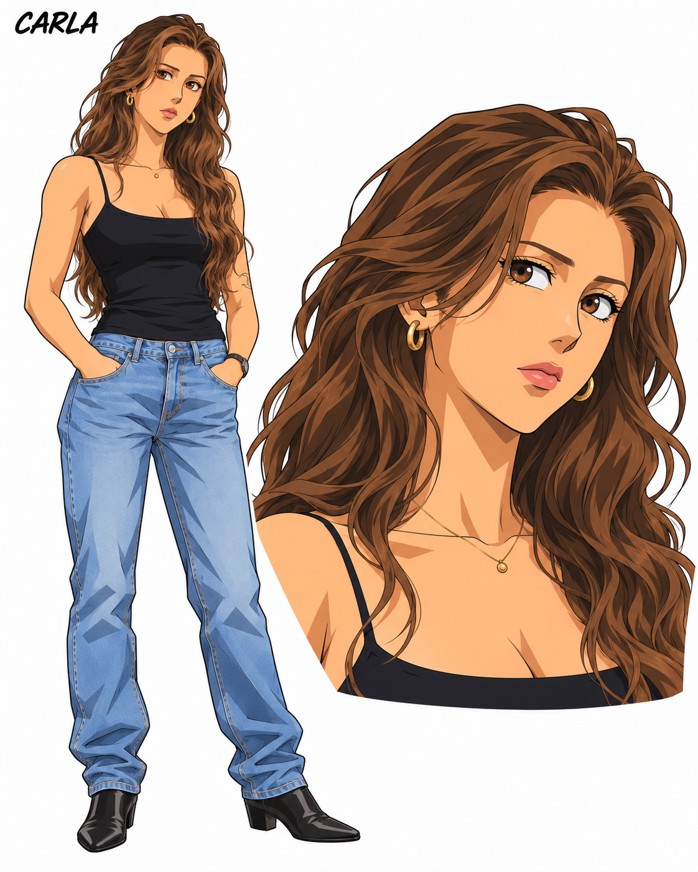
[picture p121: Avatares 2D/Carla/Carla-2D.png]
Carla
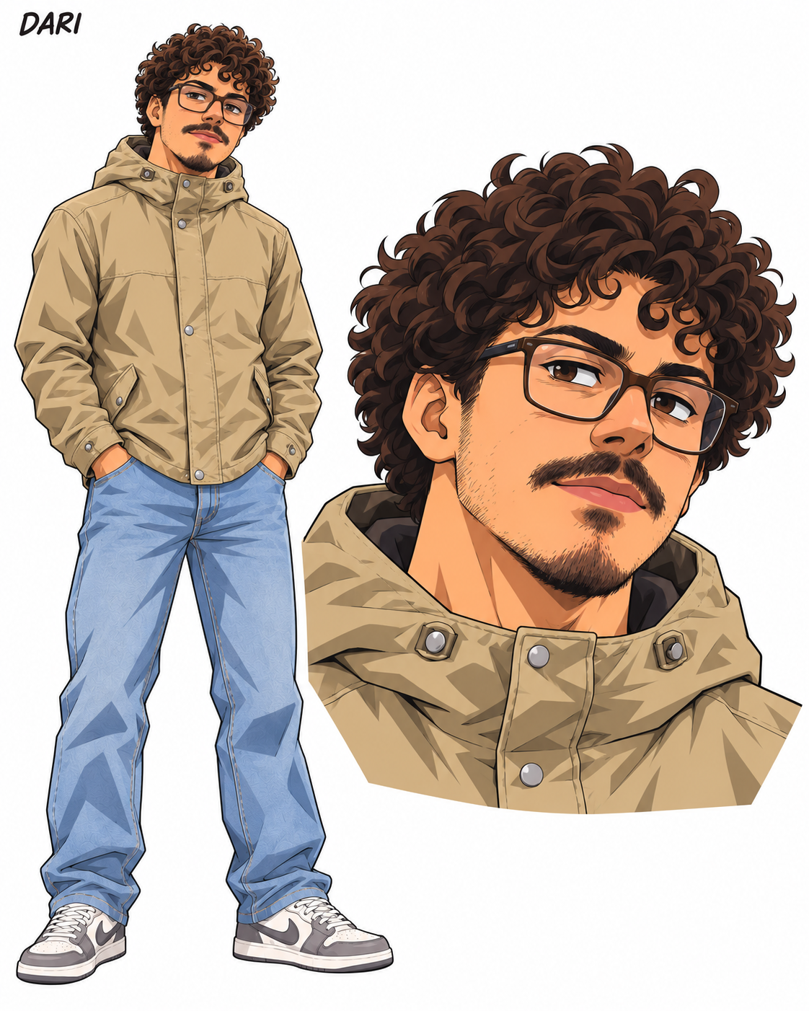
[picture p122: Avatares 2D/Dari/Dari-2D.png]
Dari
|  |  |

| Deivi | Gabacho |
|---|---|
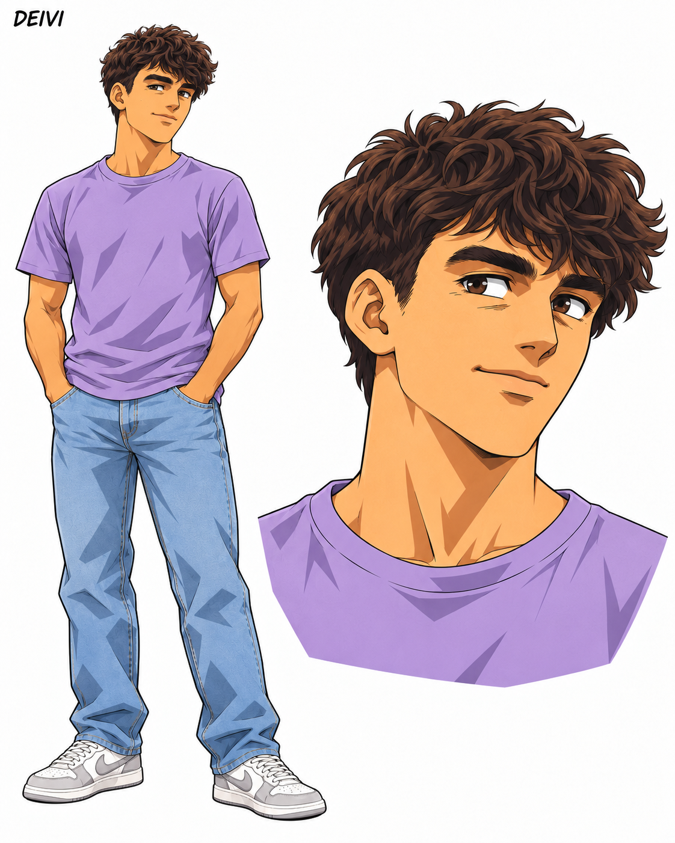
[picture p123: Avatares 2D/Deivi/Deivi-2D.png]
Deivi
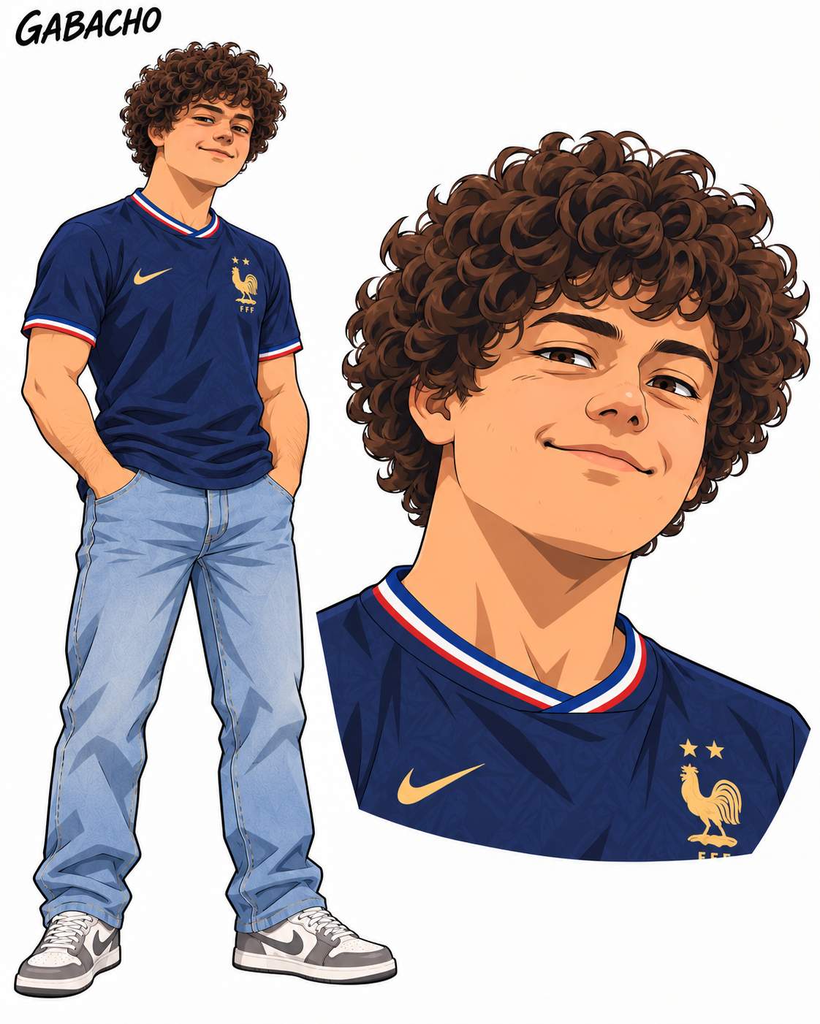
[picture p124: Avatares 2D/Gabacho/Gabacho-2D.png]
Gabacho
|  |  |

| Kiriku | Laura |
|---|---|
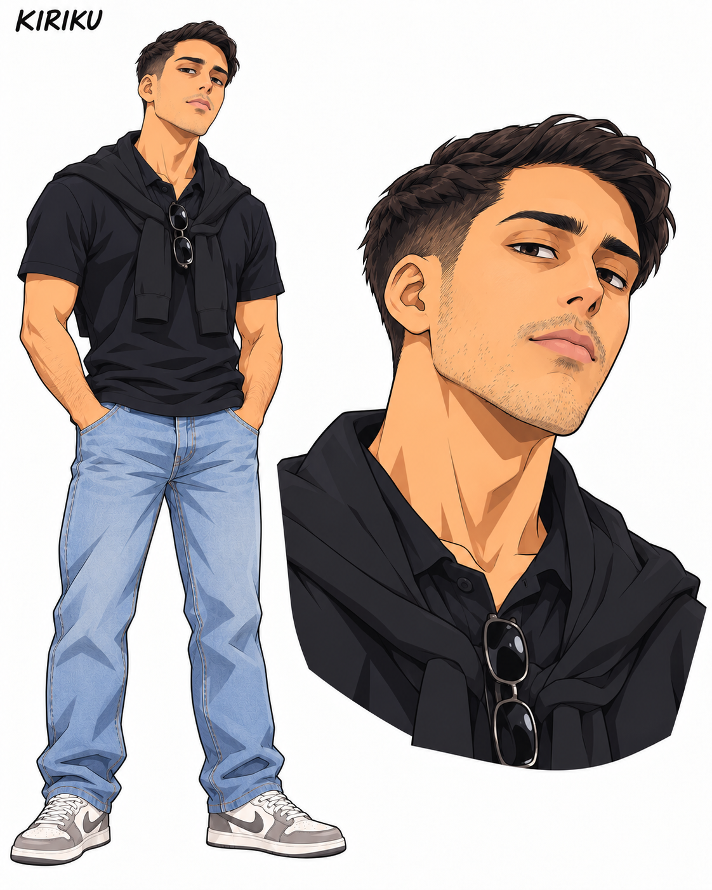
[picture p125: Avatares 2D/Kiriku/Kiriku-2D.png]
Kiriku
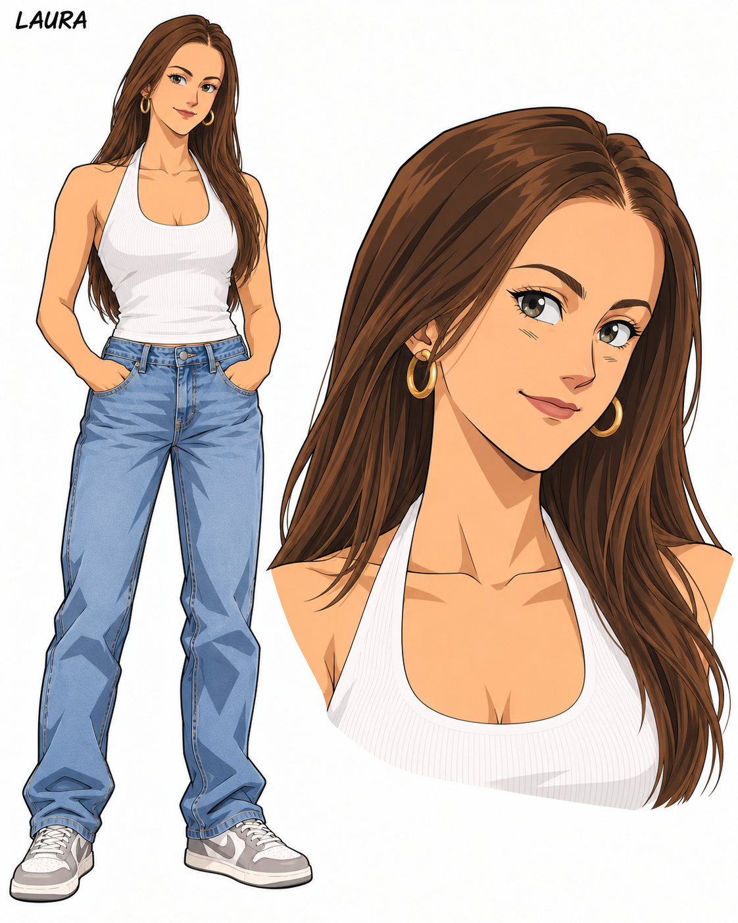
[picture p126: Avatares 2D/Laura/Laura-2D.png]
Laura
|  |  |

| Marcos Bombero | Marta |
|---|---|
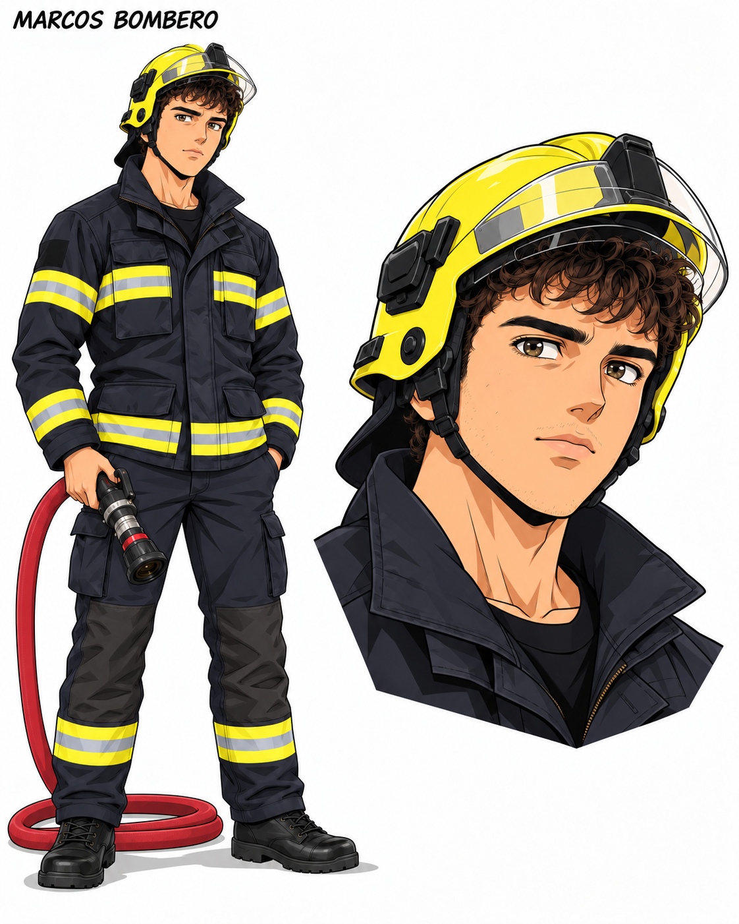
[picture p127: Avatares 2D/Marcos-Bombero/Marcos-Bombero-2D.png]
Marcos Bombero
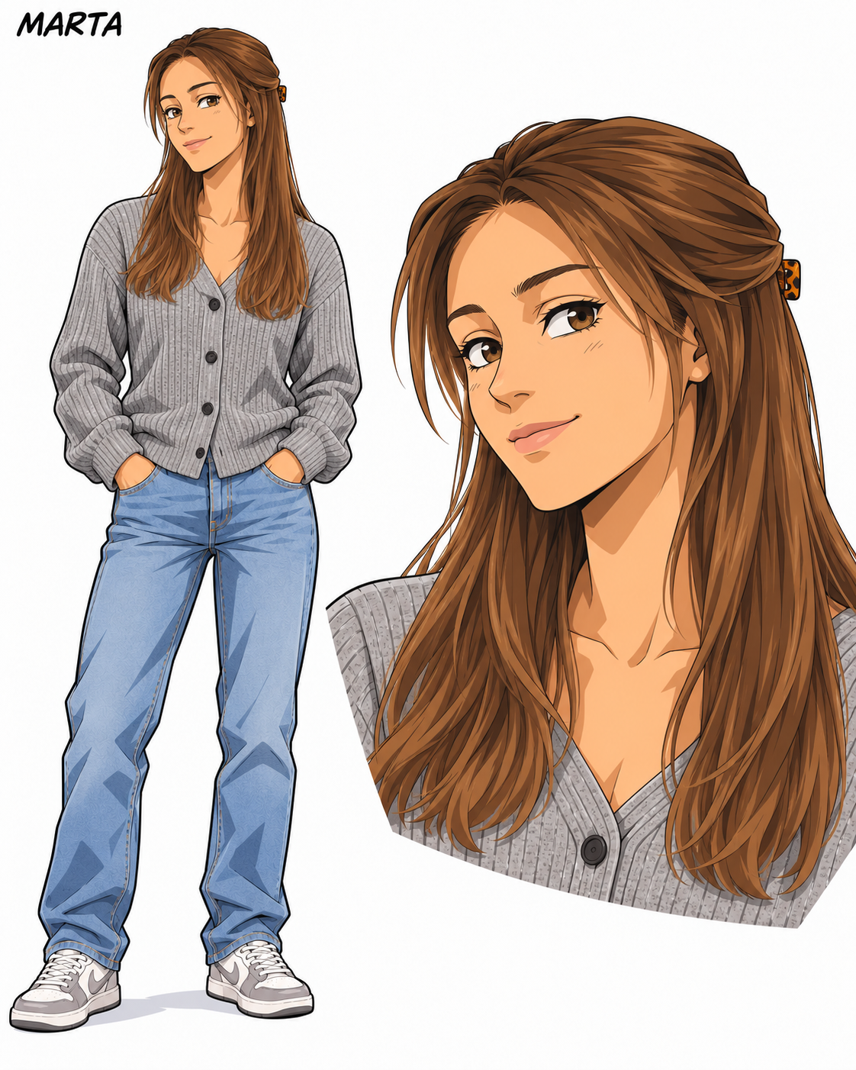
[picture p128: Avatares 2D/Marta/Marta-2D.png]
Marta
|  |  |

| Paradigma | Rodri |
|---|---|
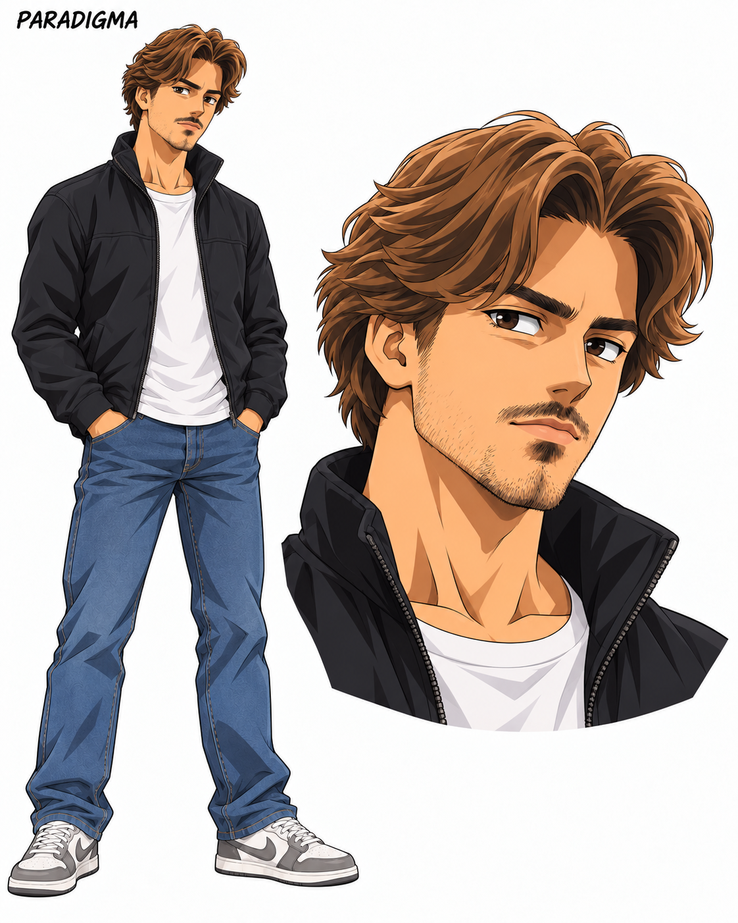
[picture p129: Avatares 2D/Paradigma/Paradigma-2D.png]
Paradigma
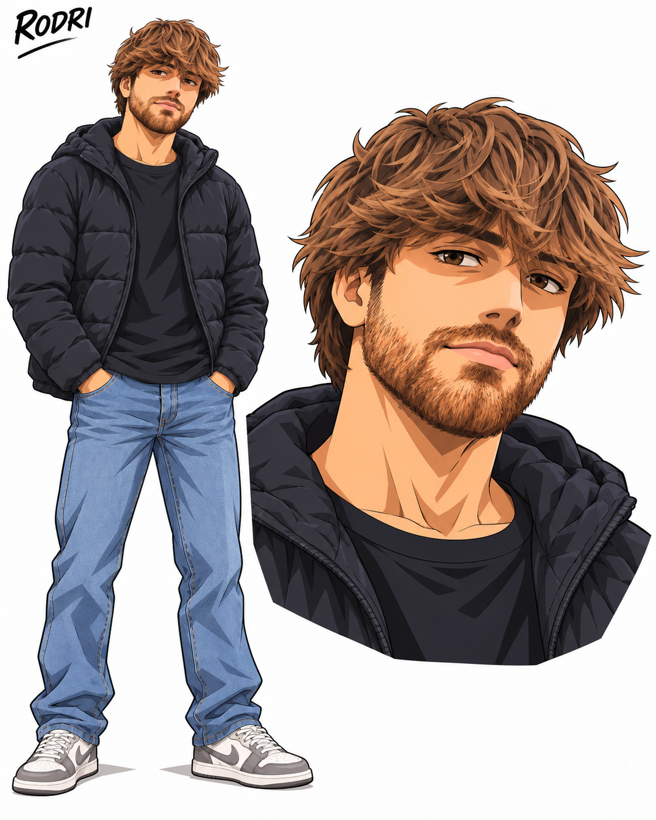
[picture p130: Avatares 2D/Rodri/Rodri-2D.png]
Rodri
|  |  |

| Sara Sáez | Yorgi |
|---|---|
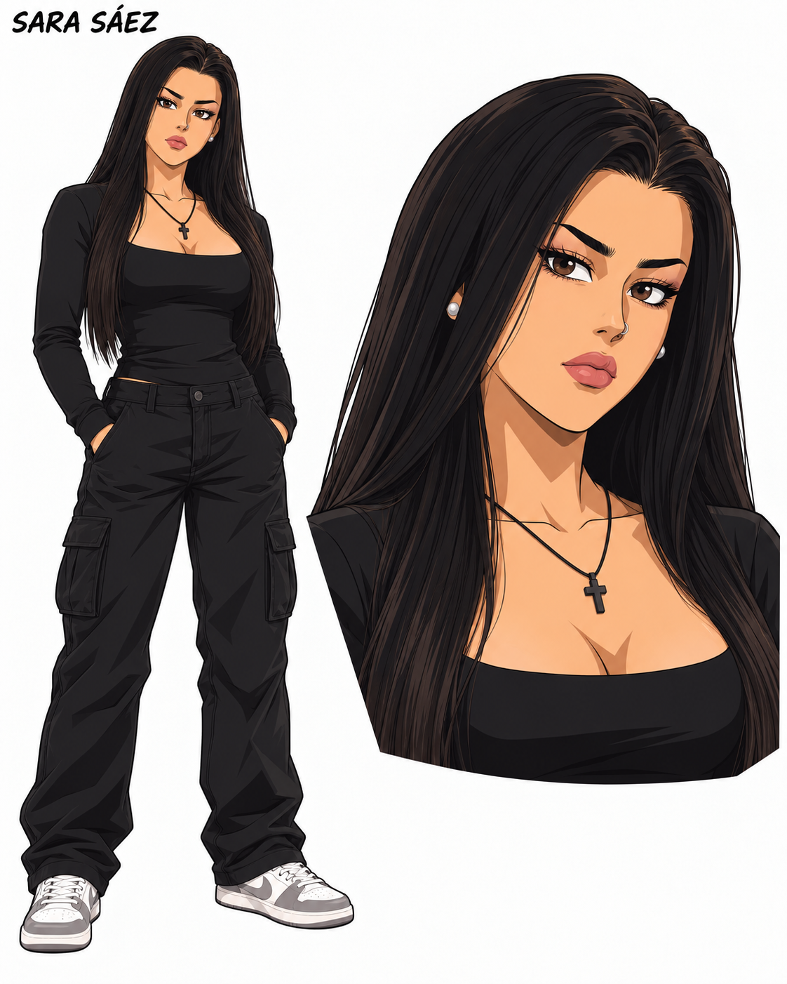
[picture p131: Avatares 2D/Sara-Saez/Sara-Saez-2D.png]
Sara Sáez
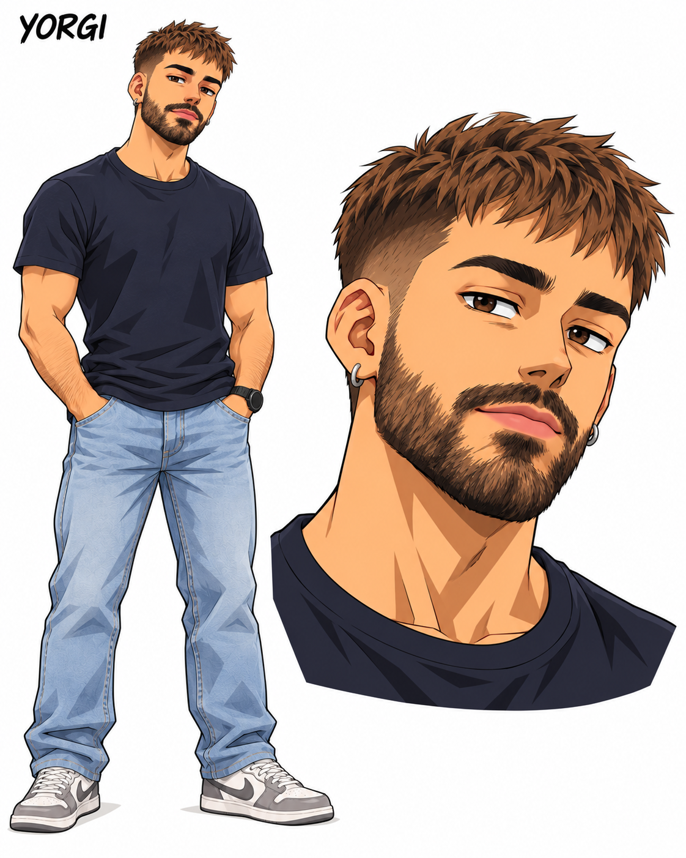
[picture p132: Avatares 2D/Yorgi/Yorgi-2D.png]
Yorgi
|  |  |

Los diseños son ilustraciones **PNG**, no SVG vectoriales ni animaciones terminadas. Cada carpeta conserva un `diseno.json` con el prompt de generación, las referencias y la revisión visual. Las imágenes se generaron con la herramienta integrada `image_gen`; los SVG originales permanecen en su carpeta.
