GuillermoAladro/Alcoholimetro/avatares SVG - Astra/README.md

# Avatares SVG · Astra

Colección de **14 avatares** vectorizados a partir de las hojas de `animaciones/`, con **fondo transparente** para la pantalla negra de la máquina. Cada avatar tiene su hoja completa y diez piezas sueltas (4 vistas de cuerpo entero y 6 expresiones): **154 SVG**. Todos llevan solo trazados y degradados vectoriales, sin imágenes incrustadas, scripts ni recursos externos.

**Estado actual:** [revisión y corrección del 30-10-2026](REVISION-TRANSPARENTE-2026-10-30.md) · [informe por archivo](revision-transparente-2026-10-30.json)

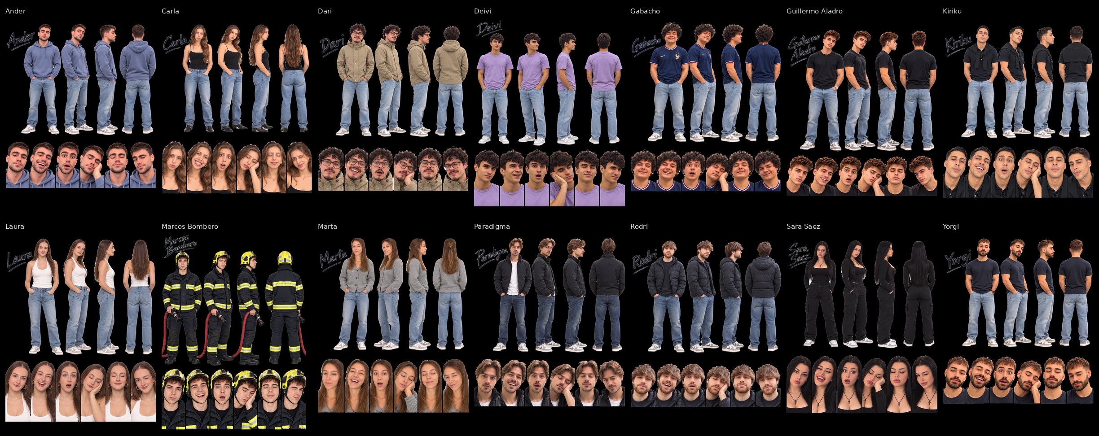
[picture p133: avatares SVG - Astra/Coleccion-preview.jpg]
Colección sobre negro


| Avatar | Hoja completa | Vista previa | Piezas |
|---|---|---|---|
| Ander | [SVG](Ander.svg) | [PNG](Ander-preview.png) | [10 piezas](Ander/) |
| Carla | [SVG](Carla.svg) | [PNG](Carla-preview.png) | [10 piezas](Carla/) |
| Dari | [SVG](Dari.svg) | [PNG](Dari-preview.png) | [10 piezas](Dari/) |
| Deivi | [SVG](Deivi.svg) | [PNG](Deivi-preview.png) | [10 piezas](Deivi/) |
| Gabacho | [SVG](Gabacho.svg) | [PNG](Gabacho-preview.png) | [10 piezas](Gabacho/) |
| Guillermo Aladro | [SVG](Guillermo-Aladro.svg) | [PNG](Guillermo-Aladro-preview.png) | [10 piezas + 2 escenas](Guillermo-Aladro/) |
| Kiriku | [SVG](Kiriku.svg) | [PNG](Kiriku-preview.png) | [10 piezas](Kiriku/) |
| Laura | [SVG](Laura.svg) | [PNG](Laura-preview.png) | [10 piezas](Laura/) |
| Marcos Bombero | [SVG](Marcos-Bombero.svg) | [PNG](Marcos-Bombero-preview.png) | [10 piezas](Marcos-Bombero/) |
| Marta | [SVG](Marta.svg) | [PNG](Marta-preview.png) | [10 piezas](Marta/) |
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
