GuillermoAladro/Alcoholimetro/Animaciones 2D/personajes/guillermo-aladro/piezas.png

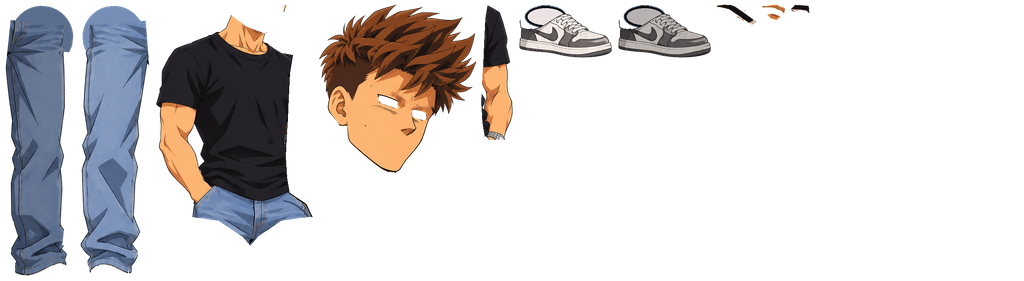
Animaciones 2D/personajes/guillermo-aladro/piezas.png
