GuillermoAladro/Alcoholimetro/Animaciones 2D/personajes/guillermo-aladro/piezas_extra.png

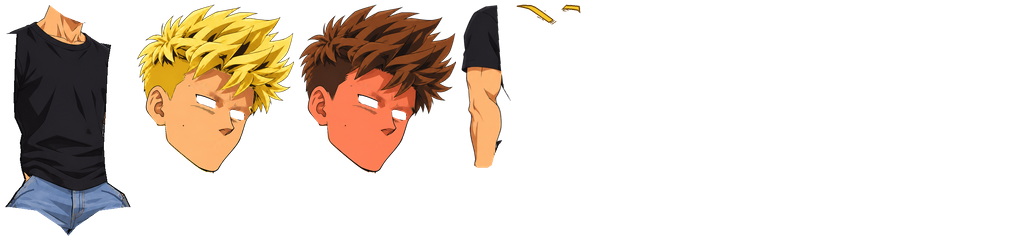
Animaciones 2D/personajes/guillermo-aladro/piezas_extra.png
