GuillermoAladro/Alcoholimetro/Animaciones 2D/personajes/yorgi/piezas.png

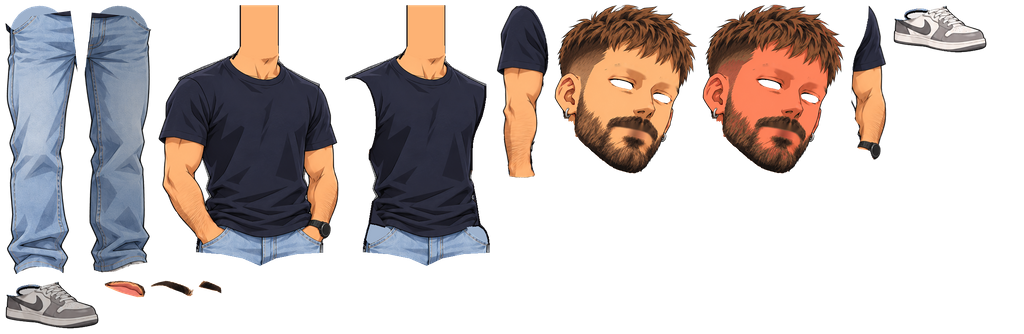
Animaciones 2D/personajes/yorgi/piezas.png
