GuillermoAladro/Alcoholimetro/auditorias/2026-10-21-auditor-6.1-s/esquema_corregido.png

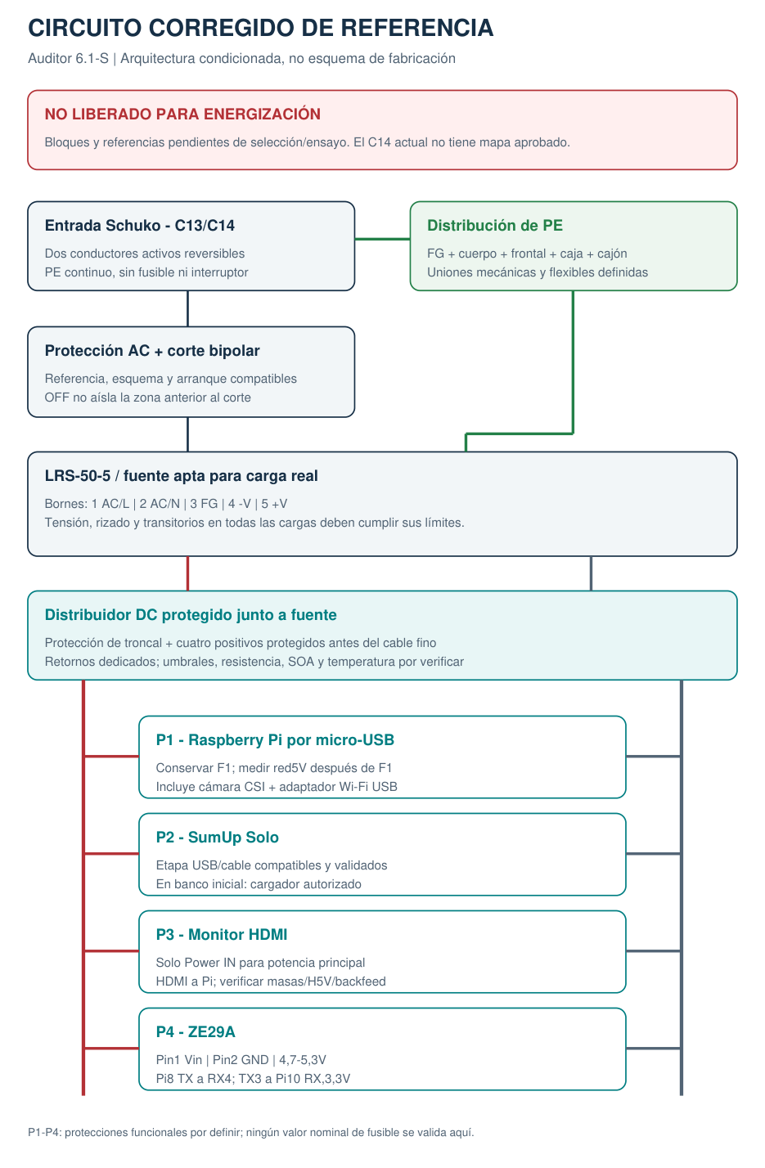
auditorias/2026-10-21-auditor-6.1-s/esquema_corregido.png
