GuillermoAladro/Alcoholimetro/carcasa/diseno-A/calculo-anclajes/figuras/fig7_paredes.png

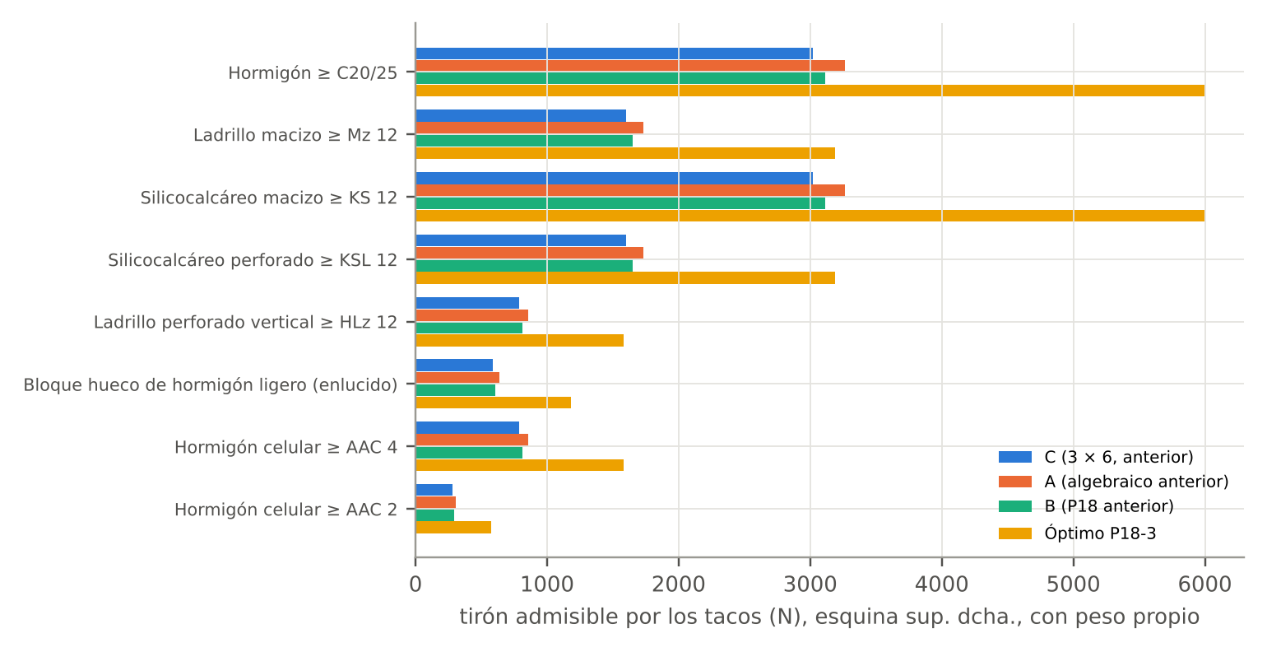
carcasa/diseno-A/calculo-anclajes/figuras/fig7_paredes.png
