GuillermoAladro/Alcoholimetro/carcasa/diseno-A/calculo-anclajes/figuras/fig8_convergencia.png

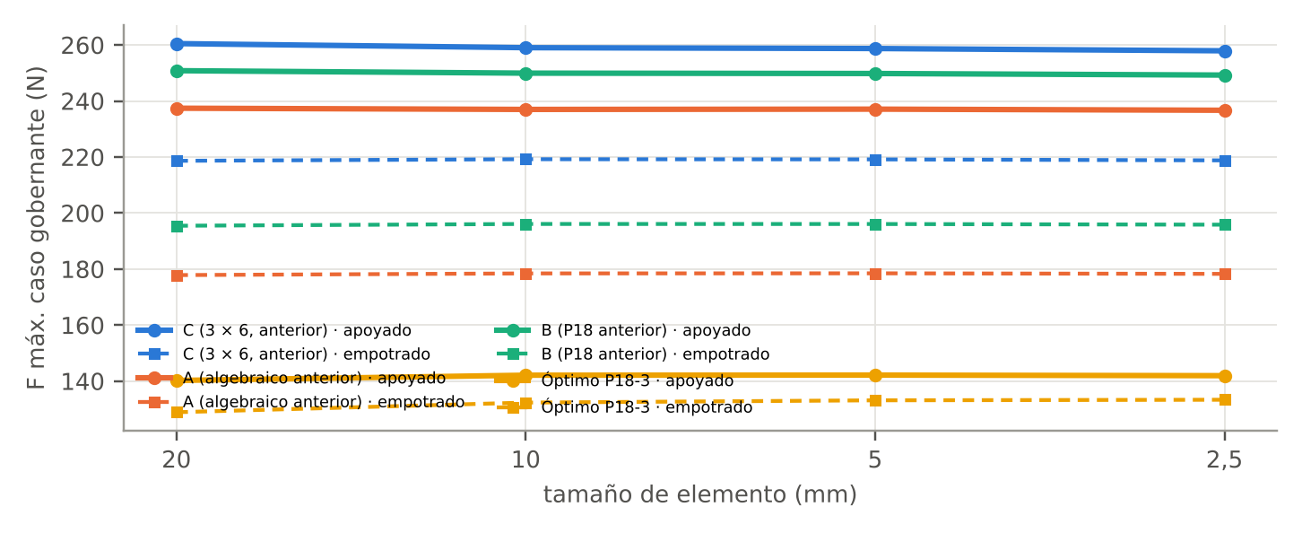
carcasa/diseno-A/calculo-anclajes/figuras/fig8_convergencia.png
