GuillermoAladro/Alcoholimetro/carcasa/diseno-A/calculo-anclajes/historico-2mm/figuras/fig6_perdidas.png

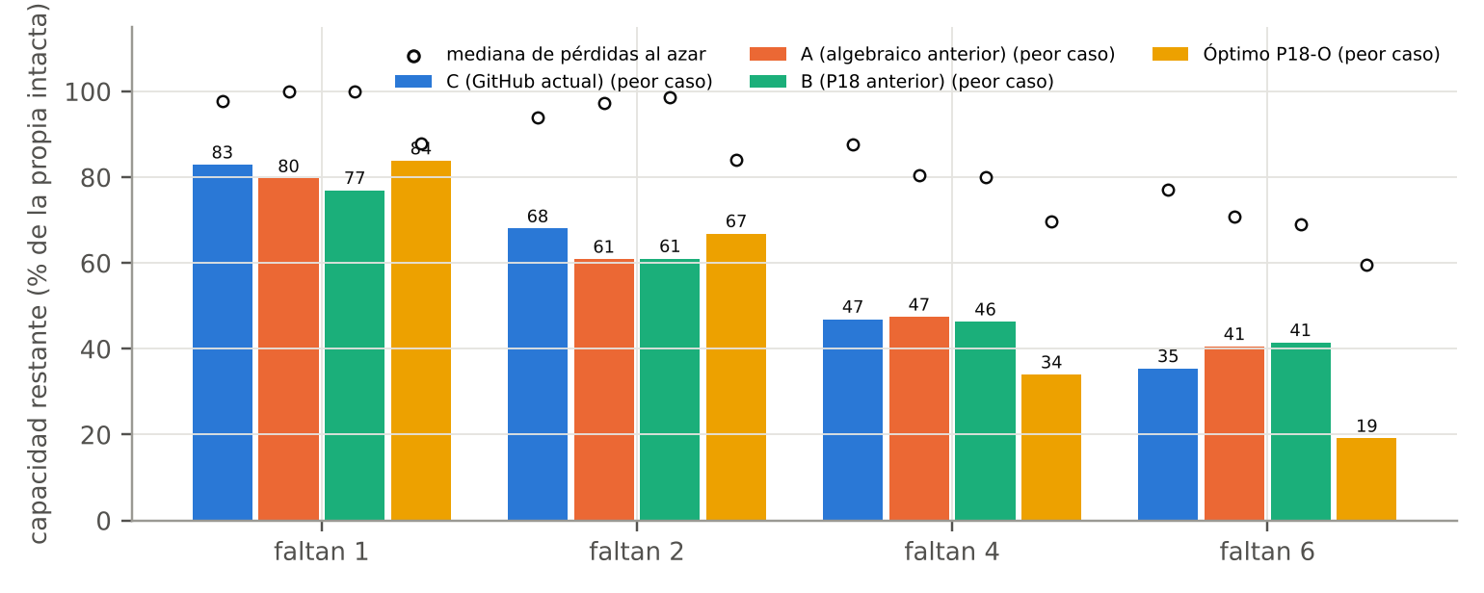
carcasa/diseno-A/calculo-anclajes/historico-2mm/figuras/fig6_perdidas.png
