GuillermoAladro/Alcoholimetro/carcasa/diseno-A/estudio-termico/figuras/f_fan.png

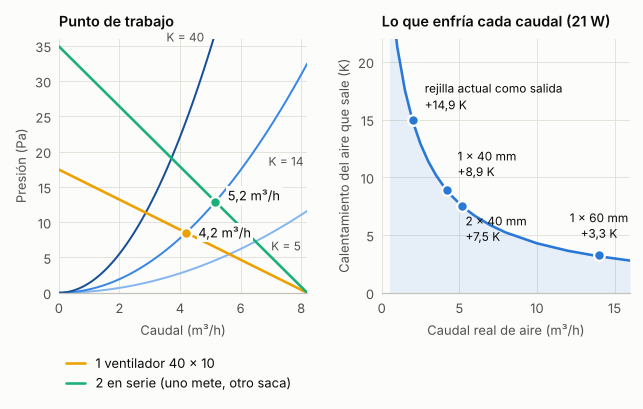
carcasa/diseno-A/estudio-termico/figuras/f_fan.png
