GuillermoAladro/Alcoholimetro/carcasa/diseno-A/estudio-termico/figuras/f_fuente.png

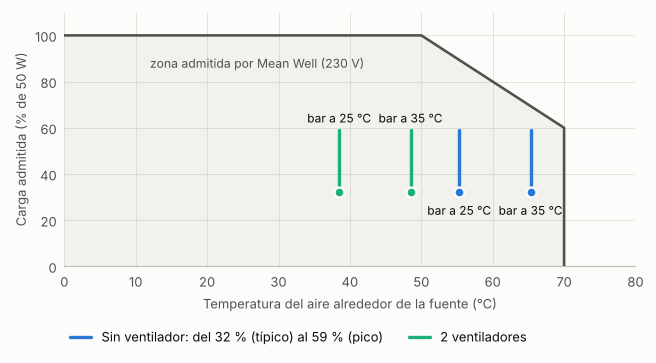
carcasa/diseno-A/estudio-termico/figuras/f_fuente.png
