GuillermoAladro/Alcoholimetro/carcasa/diseno-A/estudio-termico/figuras/f_limites.png

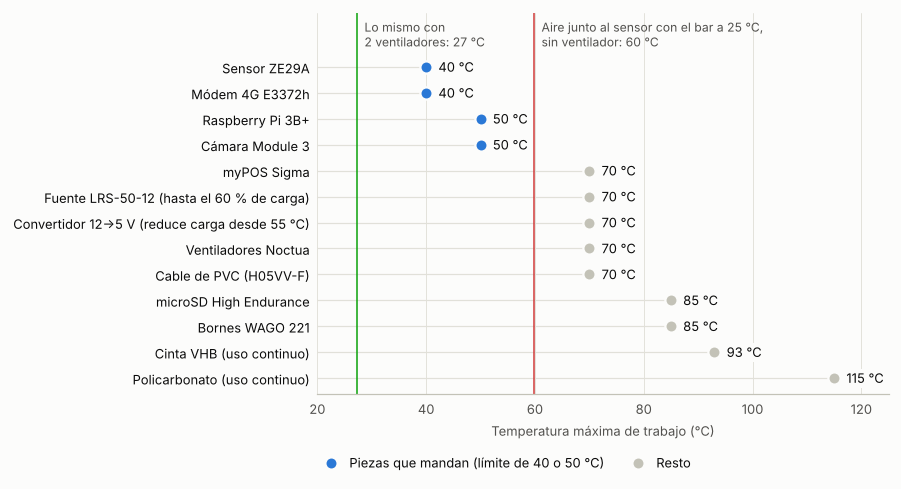
carcasa/diseno-A/estudio-termico/figuras/f_limites.png
