GuillermoAladro/Alcoholimetro/carcasa/diseno-A/estudio-termico/figuras/f_seccion.png

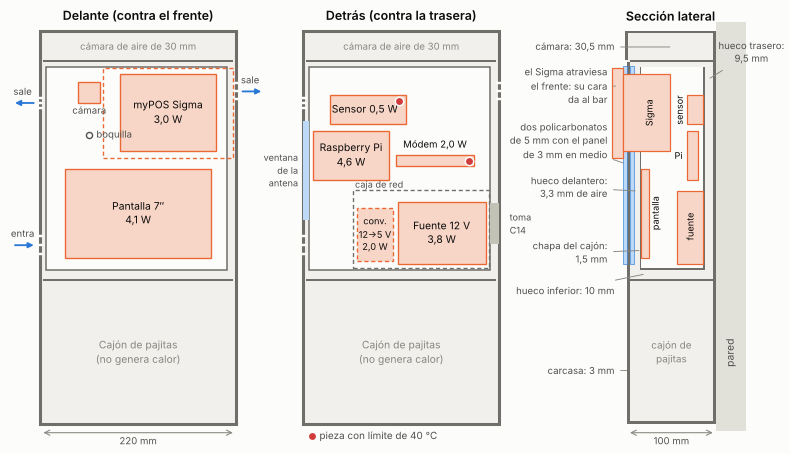
carcasa/diseno-A/estudio-termico/figuras/f_seccion.png
