GuillermoAladro/Alcoholimetro/carcasa/diseno-A/estudio-termico/figuras/f_trans.png

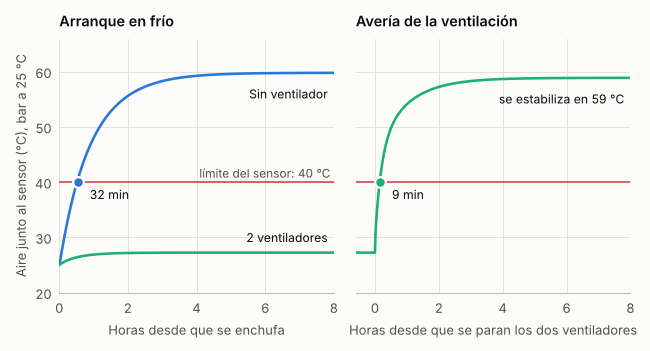
carcasa/diseno-A/estudio-termico/figuras/f_trans.png
