GuillermoAladro/Alcoholimetro/carcasa/diseno-A/FreeCAD/vista-interior.png

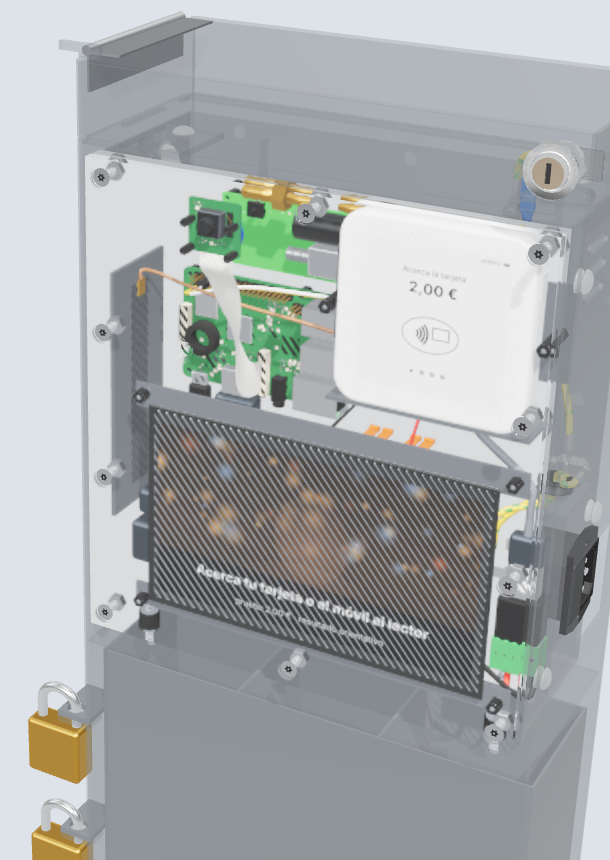
carcasa/diseno-A/FreeCAD/vista-interior.png
