GuillermoAladro/Alcoholimetro/componentes/filtro-ptfe-hidrofobo/README.md

# Filtro de jeringa de PTFE hidrófobo (dos)

Uno en cada toma de aire del ZE29A. Deja pasar el gas y para el líquido: es la última defensa del sensor si alguien vierte una copa en la boquilla o sopla con la boca llena. Añadidos el 13-11-2026 ([revisión](../REVISION-13-11-2026.md), apartado 3.2).

- **Compra:** sin anuncio elegido. PTFE hidrófobo, 25 mm, 0,45 µm, con conexiones para tubo. Precio estimado: 10 € el lote.
- **Ref. en el CAD:** E29 (sin dibujar todavía). Dos por máquina.

## Va junto con el recorrido del tubo

El filtro no sustituye a lo principal: el tubo de la boquilla al escape va **siempre cuesta abajo**, las dos T con la salida hacia el sensor mirando **hacia arriba**, y el sensor por encima del tubo. Así lo que entra sale por el escape.

## Sin validar

No se sabe si el módulo sigue detectando el soplido con el filtro en la toma de presión, ni si la lectura cambia con el filtro en la toma de alcohol. **Prueba D2:** misma lectura con y sin filtros, y un vaso de agua por la boquilla que salga por el escape. Si la lectura cambia, se quita el de la toma de alcohol y se confía en la pendiente.

## Pendiente

Ver cómo son las tomas del módulo real (racor, tubito o agujero) para elegir los racores.
