GuillermoAladro/Alcoholimetro/componentes/adhesivo-permabond-ta4204/README.md

# Adhesivo estructural transparente Permabond TA4204

**Estado:** Candidato seleccionado para fijar las ventanas transparentes al panel metálico del alcoholímetro; **pendiente de compra, pruebas y aprobación del montaje**. Añadido el 03-11-2026. No forma parte de los 32 componentes eléctricos iniciales.

## Para qué se propone

Unir por la cara interior de la carcasa metálica los protectores transparentes de **policarbonato compacto de 5 mm** o, si se cambia el diseño, de **metacrilato (PMMA)**, sin tornillos visibles por delante y **sin cinta adhesiva**.

El diseño A, descrito en [MONTAJE GENERAL, apartado 6.3](../../historico/MONTAJE-GENERAL.md), especifica dos huecos de ventana:
- Pantalla: **159 × 91 mm** (hueco). **179 × 111 mm** sería el corte preliminar con 10 mm de solape en los cuatro lados.
- Terminal de pago: **85 × 85 mm** (hueco). **105 × 105 mm** sería el corte preliminar con 10 mm de solape en los cuatro lados.

**No son cotas de fabricación aprobadas.** Verificar espacio interior, soporte real, posición de la pantalla/terminal, recubrimientos, radios, interferencias y holguras antes de pedir las piezas. El documento general también conserva un diseño anterior y todavía no establece cuál es el definitivo.

## Producto propuesto

| Campo | Información |
|---|---|
| Fabricante / referencia | **Permabond TA4204** |
| Tipo | Adhesivo acrílico estructural tenacificado, **dos componentes (A+B)** |
| Aspecto | **Transparente e incoloro una vez mezclado** |
| Mezcla | **1:1** |
| Presentación localizada | Cartucho **50 ml con boquilla mezcladora** |
| Referencia de la tienda | **LUB00000883** |
| Precio visto 03-11-2026 | **34,00 € por 50 ml** en Lijmenwinkel (precio anunciado; verificar IVA, envío y disponibilidad antes de pedir) |
| Accesorios | Pistola aplicadora compatible para cartuchos 50 ml 1:1, salvo alternativa de dispensación autorizada |
| Compra | [Lijmenwinkel, Permabond TA4204](https://www.lijmenwinkel.nl/de/permabond-ta-4204.html) |
| Ficha oficial (TDS) | [Permabond TA4204 PDF](https://www.permabond.com/wp-content/uploads/2022/09/TA4204_TDS.pdf) |
| Página de producto del fabricante | [Permabond TA4204, 50 ml](https://www.permabond.co.uk/product-page/ta4204-1-x-50ml-cartridge-with-mixing-nozzle) |

**No existe confirmación de pedido ni disponibilidad garantizada.** El producto es una propuesta de compra, no una compra realizada.

## Datos técnicos de la ficha oficial

- **Relleno máximo de holgura:** 3 mm.
- **Fijación inicial:** 1–2 minutos a 23 °C.
- **Tiempo de manipulación:** 5–10 minutos a 23 °C.
- **Resistencia de trabajo:** 20–25 minutos a 23 °C.
- **Curado completo:** 24 horas a 23 °C, condicionado por temperatura, geometría y sustratos.
- **Resistencia a cizallamiento, muestras normalizadas ISO 4587:** policarbonato (PC) 2–4 N/mm²; metacrilato (PMMA) 4–5 N/mm² (en PMMA se indica rotura del sustrato); acero 18–20 N/mm². **Son ensayos por material, NO valores certificados para la unión PC/acero o PMMA/acero de esta máquina.**
- **Almacenamiento:** 2–7 °C, conforme al TDS.

Fuente: ficha técnica oficial Permabond TA4204 (revisión global 9, 23-02-2018). Comprobar la revisión vigente antes de fabricación.

## Aplicación prevista (pendiente de validación)

1. Preparar probetas con **el mismo policarbonato de 5 mm** (incluido eventual recubrimiento antirrayado) y **la misma chapa y acabado superficial/pintura** que se usarán realmente.
2. Comprobar adhesión, grietas por tensión (`stress cracking`), opacidad, amarilleamiento, resistencia al impacto y cambios tras humedad, limpieza y ciclos térmicos. Consultar al proveedor si el PC lleva tratamiento superficial antiabrasión.
3. Limpiar, secar y desengrasar ambas caras conforme a las instrucciones del fabricante; confirmar que el limpiador no ataca el plástico ni su recubrimiento. Esperar **3–4 minutos** a que se evapore por completo cualquier disolvente de limpieza.
4. Si procede, preparar la zona metálica oculta de unión según la ficha y retirar pintura o recubrimientos mal adheridos; no lijar el área transparente visible ni revestimientos funcionales del PC.
5. Aplicar un cordón fino y continuo por el **perímetro de solape oculto**, con la proporción 1:1 y boquilla mezcladora compatible; evitar invadir el área óptica. Montar y sujetar las piezas antes del inicio de fijación.
6. Mantener inmovilizada la unión y no someterla a carga hasta completar al menos **24 horas de curado a 23 °C**. Revalidar tiempos en condiciones ambientales reales.
7. **Añadir un marco o reborde mecánico de retención por el interior**: el adhesivo no constituye por sí solo una garantía antivandálica ni una sujeción imposible de separar.

## Seguridad, limitaciones y decisiones pendientes

- El propio fabricante indica que el adhesivo **puede afectar a ciertos termoplásticos**: la compatibilidad con cada placa concreta, especialmente policarbonato recubierto, es **pendiente**.
- No es válido afirmar que la unión sea «imposible de separar». Se requiere validación mecánica en prototipo y retención secundaria en un equipo instalado en zonas accesibles al público.
- El adhesivo **no sustituye** por sí solo una junta de estanqueidad ni acredita grado IP; comprobar por separado entrada de agua, condensación y mantenimiento.
- Revisar antes de usar la **ficha de datos de seguridad (SDS) de ambos componentes**; trabajar con ventilación y EPI adecuados según SDS. Evitar contacto con piel/ojos.
- Faltan por definir geometría definitiva de las ventanas, aleación y pintura de la chapa, espesor útil de solape, tolerancias, método de sujeción, resistencia a impactos y procedimiento de reparación/sustitución.
- No incluir en el presupuesto eléctrico de 646,57 € ni marcar como comprado hasta confirmación.

## Referencias

- [TDS oficial de Permabond TA4204 (PDF)](https://www.permabond.com/wp-content/uploads/2022/09/TA4204_TDS.pdf)
- [Página del fabricante del cartucho 50 ml](https://www.permabond.co.uk/product-page/ta4204-1-x-50ml-cartridge-with-mixing-nozzle)
- [Oferta de Lijmenwinkel (precio y existencias variables)](https://www.lijmenwinkel.nl/de/permabond-ta-4204.html)
- [Diseño mecánico comparado del alcoholímetro](../../historico/MONTAJE-GENERAL.md#63-qué-cambia-con-el-diseño-a-diseno-cajon-amd-21-10-2026)
