GuillermoAladro/Alcoholimetro/componentes/cable-2x0-75-rojo-negro-10m/README.md

# Cable bipolar 2 × 0,75 mm² rojo/negro, 10 m

Cable de la distribución de 5 V. Hace de **troncal** (de la LRS-50-5 a las dos regletas WAGO 221-415, una para +5 V y otra para GND) y de **ramas** (de las WAGO a los bornes USB-A del Solo y de la pantalla). Va dentro de la misma caja que los 230 V.

- **Compra:** ASIN B0D12QPF4Y, 14,10 € por 10 m (precio de la hoja de componentes del 19-20-10-2026). Número 21 de la hoja.
- **Aviso:** Amazon bloquea el acceso a mi herramienta. **No he visto el anuncio.** No sé qué metal, qué construcción de hilos, qué tensión asignada, qué aislante ni qué norma declara este cable concreto. Mi búsqueda por el ASIN no devolvió nada útil. El precio y la referencia son los de tu hoja.

> Investigación hecha el 21-10-2026. Cada dato indica de dónde sale. Lo que no he podido comprobar está marcado como **sin verificar**. Los cálculos y las deducciones propias llevan la etiqueta "cálculo mío" o "conclusión mía". **Las normas IEC/EN son de pago y no he leído su texto** (EN 60335-1, EN 60204-1, IEC 60364-5-52, EN 50525-2-11, IEC 60228…): las cifras vienen de fabricantes y de webs técnicas que las resumen. Está marcado donde importa.

## Índice

1. [Resumen para el proyecto](#1-resumen-para-el-proyecto)
2. [Qué cable es y qué se puede asegurar sin ficha](#2-qué-cable-es-y-qué-se-puede-asegurar-sin-ficha)
3. [Especificaciones de referencia](#3-especificaciones-de-referencia)
4. [Documentos y normas](#4-documentos-y-normas)
5. [Sección y cobre real](#5-sección-y-cobre-real)
6. [Corriente admisible, calor y caída de tensión](#6-corriente-admisible-calor-y-caída-de-tensión)
7. [Aislamiento y separación de los 230 V](#7-aislamiento-y-separación-de-los-230-v)
8. [Llama, humos y normativa de producto](#8-llama-humos-y-normativa-de-producto)
9. [Fallos, bugs y problemas conocidos](#9-fallos-bugs-y-problemas-conocidos)
10. [Montaje: terminales, polaridad, fijación y curvatura](#10-montaje-terminales-polaridad-fijación-y-curvatura)
11. [Qué comprobar al recibirlo](#11-qué-comprobar-al-recibirlo)
12. [Alternativas](#12-alternativas)
13. [Recomendaciones para el alcoholímetro](#13-recomendaciones-para-el-alcoholímetro)
14. [Lo que no he podido verificar](#14-lo-que-no-he-podido-verificar)
15. [Fuentes](#15-fuentes)

---

## 1. Resumen para el proyecto
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
