GuillermoAladro/Alcoholimetro/componentes/meanwell-lrs-50-5/README.md

# Mean Well LRS-50-5 (fuente de alimentación 5 V, 10 A, 50 W)

Fuente única de la máquina. Convierte los 230 V de la red en 5 V y los reparte "en estrella" a la Raspberry Pi, el SumUp Solo, la pantalla y el sensor ZE29A. Va fija a la carcasa (tumbada sobre un separador), conectada a L, N y a tierra (borne FG) desde el módulo C14, y se ajusta a 5,20 V.

> **Corrección de Auditor 6.1-S, 21-10-2026:** esta ficha contenía asignaciones erróneas de los bornes, corregidas abajo contra el dibujo del fabricante (PDF local `MEAN_WELL_LRS-50_DATA_SHEET.pdf`, p. 4). La numeración correcta es **1 AC/L, 2 AC/N, 3 FG, 4 DC -V, 5 DC +V**. El ajuste a 5,20 V y el montaje completo siguen pendientes de validación; véase la [auditoría eléctrica](../../auditorias/2026-10-21-auditor-6.1-s/AUDITORIA.md).

- **Compra:** ASIN B06XWRCWZ9, 18,52 € (precio de la hoja de componentes del 19-20/10/2026).
- **Referencia exacta:** Mean Well LRS-50-5, carcasa nº 239A.
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
