GuillermoAladro/Alcoholimetro/carcasa/diseno-A/CAD_A_Compacta/STEP_piezas/A-S01.step

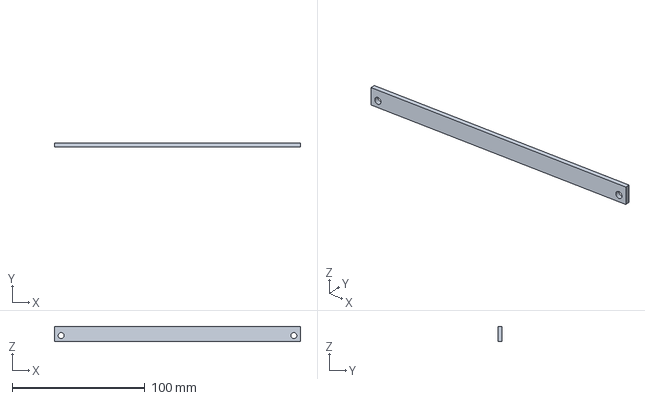
[picture p147: CAD file, 2026-11-13]
carcasa/diseno-A/CAD_A_Compacta/STEP_piezas/A-S01.step
185.0 x 3.00 x 11.5 mm
