GuillermoAladro/Alcoholimetro/carcasa/diseno-A/presupuesto/Carcasa_plegada/Conjunto_A.step

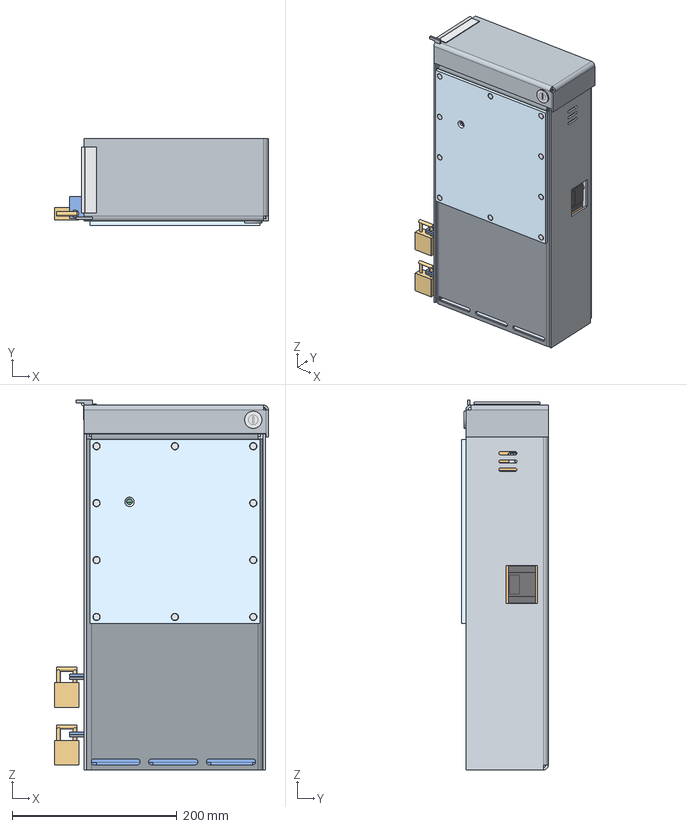
[picture p148: CAD file, 2026-11-13]
carcasa/diseno-A/presupuesto/Carcasa_plegada/Conjunto_A.step
259.5 x 105.0 x 448.5 mm
A-C01
A-V01
A-V02
A-H17_1
A-H12_1
A-H17_2
A-H12_2
A-H17_3
A-H12_3
A-H17_4
A-H12_4
A-H17_5
A-H12_5
A-H17_6
A-H12_6
A-H17_7
A-H12_7
A-H17_8
A-H12_8
A-H17_9
A-H12_9
A-H17_10
A-H12_10
A-V03
A-C02
A-C03
A-C04
A-H02_1
A-C05
A-H02_2
A-H07_1
A-H01_1
A-H01_2
A-H01_3
A-H01_4
A-T01
A-C06
A-T02
A-H04_1
A-H04_2
A-T03
A-H03_1
A-P01
A-P02
A-P03
A-P04
A-P05
A-P06
A-C07
A-P07
A-H18_1
A-C08
A-P08
A-H18_2
A-K01
A-K02
A-K03
A-K04
A-H02_3
A-K05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
