GuillermoAladro/Alcoholimetro/carcasa/diseno-A/presupuesto/Carcasa_plegada/DXF_desarrollos/A-C01_Panel_frontal.dxf

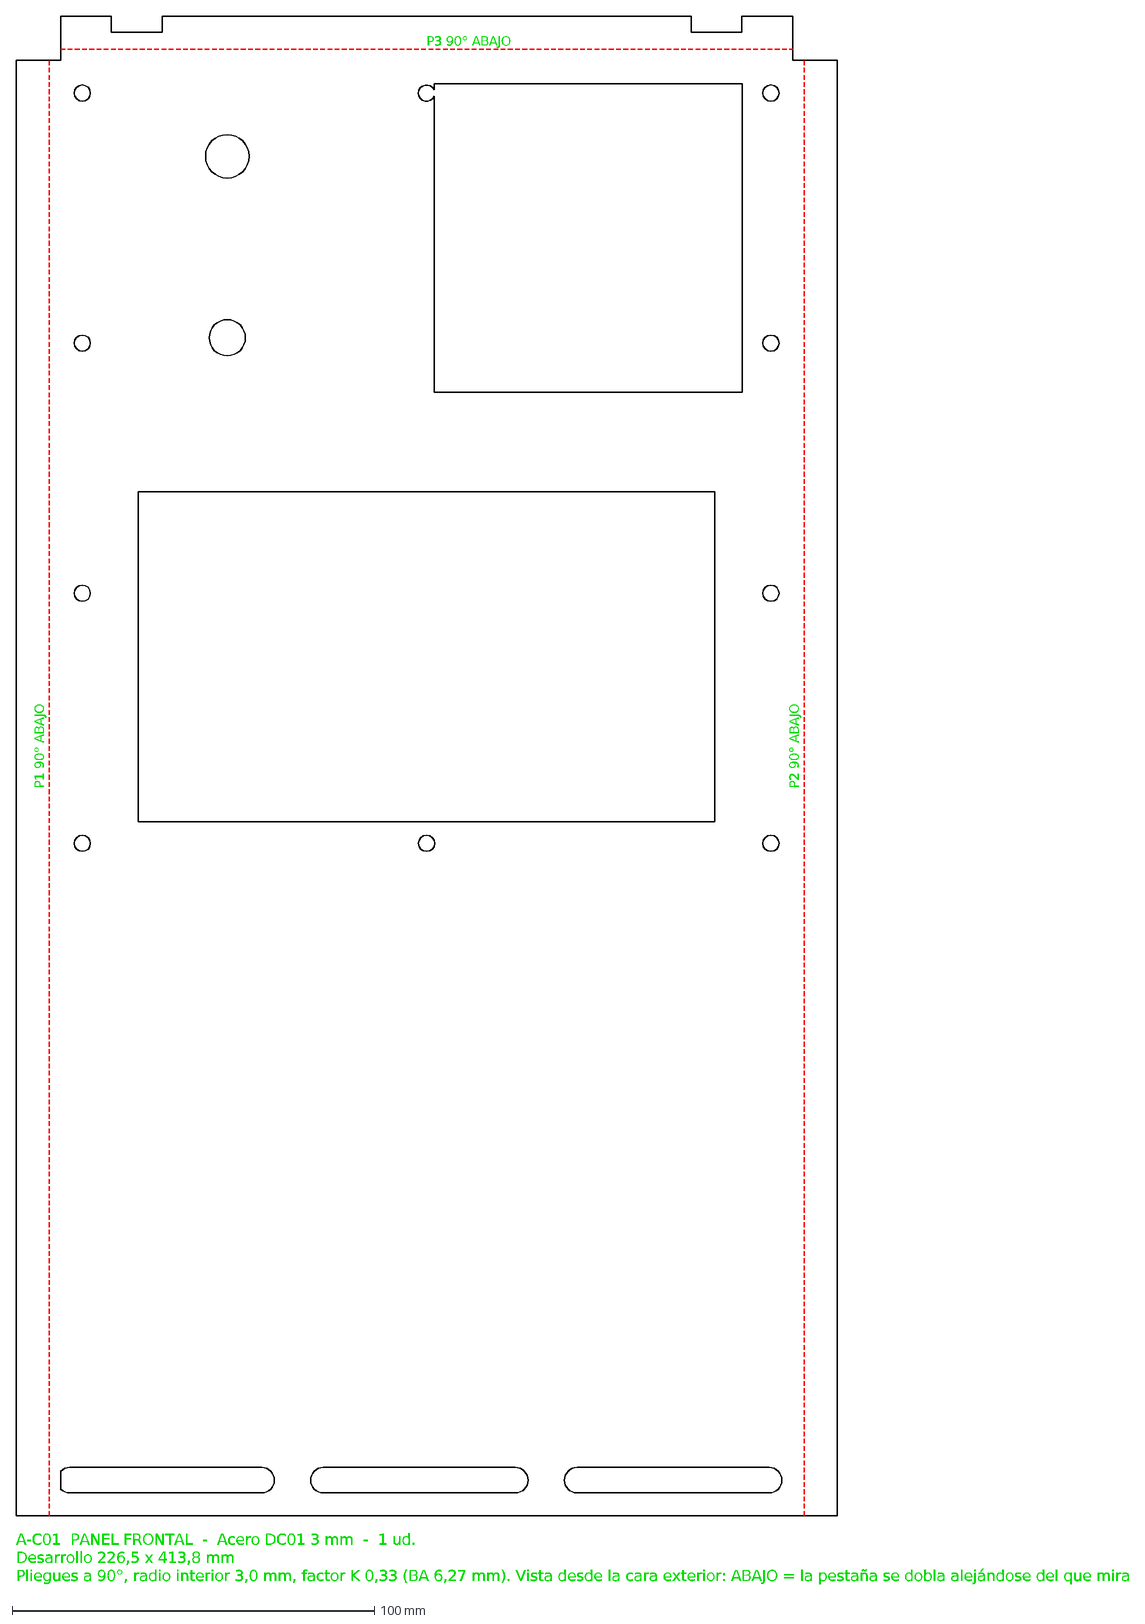
[picture p149: CAD file, 2026-11-13]
carcasa/diseno-A/presupuesto/Carcasa_plegada/DXF_desarrollos/A-C01_Panel_frontal.dxf
P1 90° ABAJO
P2 90° ABAJO
P3 90° ABAJO
A-C01 PANEL FRONTAL - Acero DC01 3 mm - 1 ud.
Desarrollo 226,5 x 413,8 mm
Pliegues a 90°, radio interior 3,0 mm, factor K 0,33 (BA 6,27 mm). Vista desde la cara exterior: ABAJO = la pestaña se dobla alejándose del que mira
