GuillermoAladro/Alcoholimetro/carcasa/diseno-A/CAD_A_Compacta/DXF_corte/A-V02.dxf

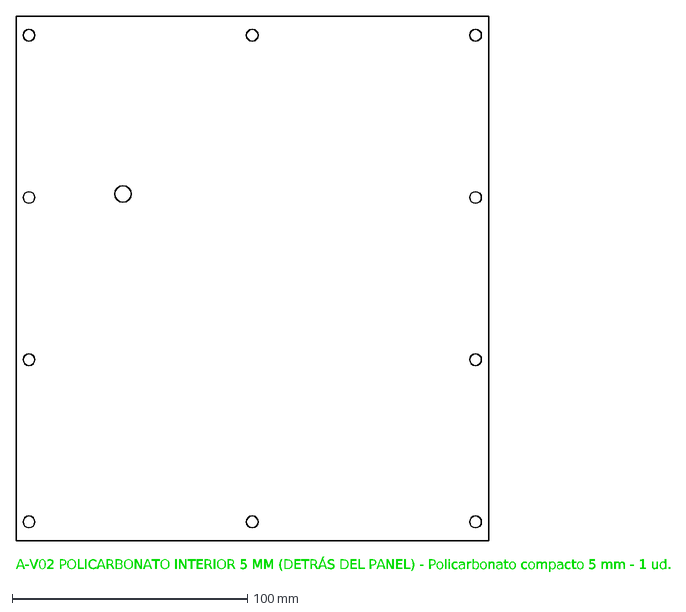
[picture p150: CAD file, 2026-11-13]
carcasa/diseno-A/CAD_A_Compacta/DXF_corte/A-V02.dxf
A-V02 POLICARBONATO INTERIOR 5 MM (DETRÁS DEL PANEL) - Policarbonato compacto 5 mm - 1 ud.
