GuillermoAladro/Alcoholimetro/carcasa/diseno-A/CAD_A_Compacta/STEP_piezas/A-P01.step

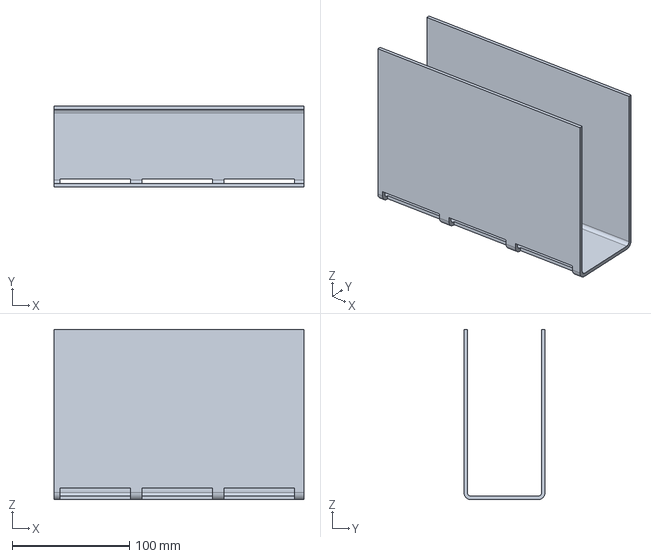
[picture p151: CAD file, 2026-11-13]
carcasa/diseno-A/CAD_A_Compacta/STEP_piezas/A-P01.step
213.0 x 69.0 x 145.2 mm
