GuillermoAladro/Alcoholimetro/carcasa/diseno-A/presupuesto/Carcasa_plegada/DXF_desarrollos/A-P02_Tabique_del_cajon_de_pajitas.dxf

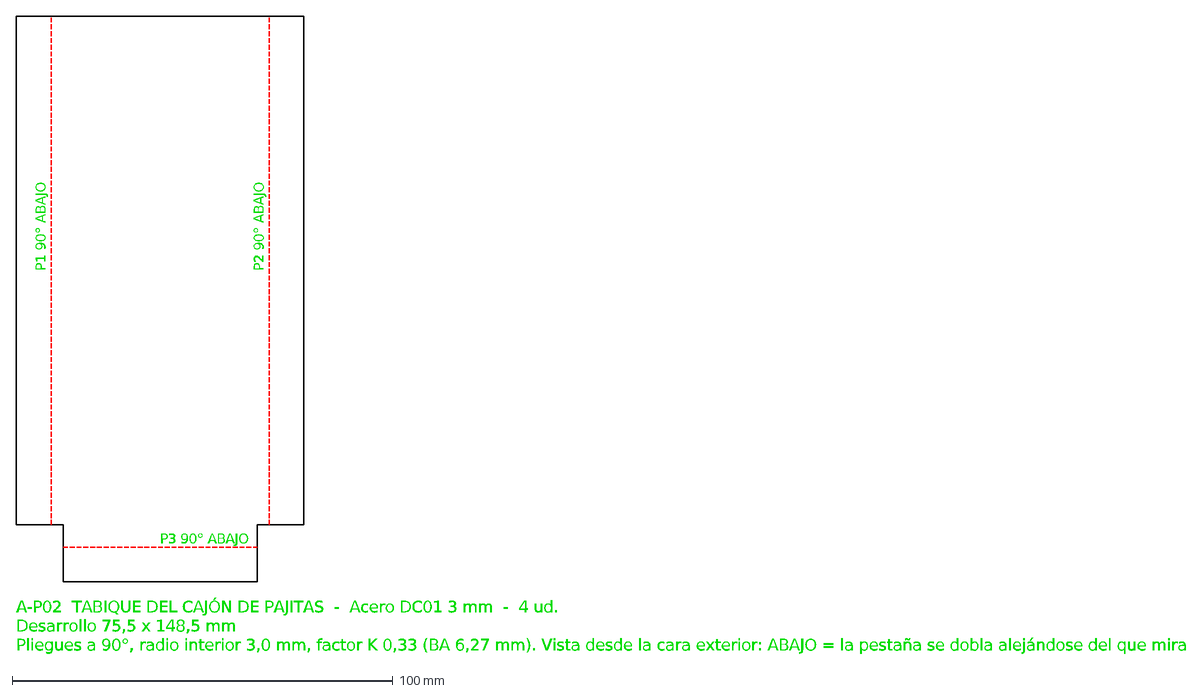
[picture p152: CAD file, 2026-11-13]
carcasa/diseno-A/presupuesto/Carcasa_plegada/DXF_desarrollos/A-P02_Tabique_del_cajon_de_pajitas.dxf
P1 90° ABAJO
P2 90° ABAJO
P3 90° ABAJO
A-P02 TABIQUE DEL CAJÓN DE PAJITAS - Acero DC01 3 mm - 4 ud.
Desarrollo 75,5 x 148,5 mm
Pliegues a 90°, radio interior 3,0 mm, factor K 0,33 (BA 6,27 mm). Vista desde la cara exterior: ABAJO = la pestaña se dobla alejándose del que mira
