GuillermoAladro/Alcoholimetro/carcasa/diseno-A/presupuesto/Carcasa_plegada/STEP_piezas/A-K04_Asidero_del_cajon_de_componentes.step

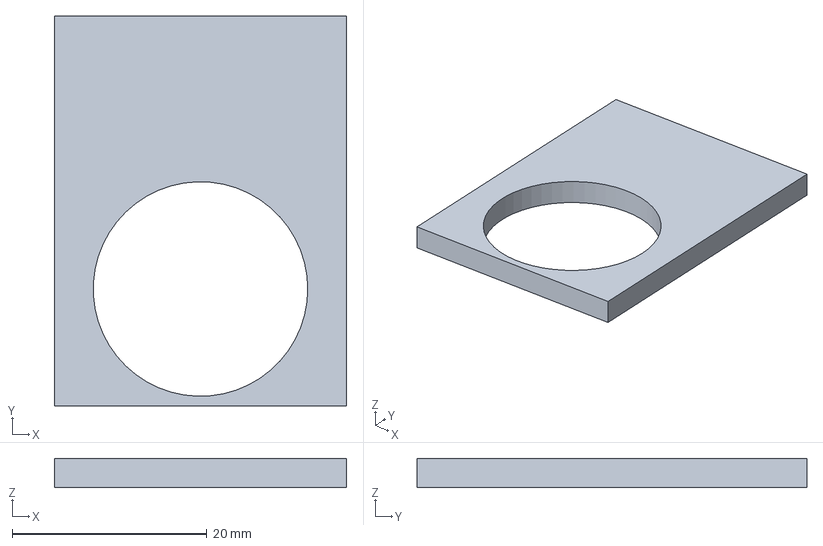
[picture p153: CAD file, 2026-11-13]
carcasa/diseno-A/presupuesto/Carcasa_plegada/STEP_piezas/A-K04_Asidero_del_cajon_de_componentes.step
30.0 x 40.0 x 3.00 mm
