GuillermoAladro/Alcoholimetro/carcasa/diseno-A/CAD_A_Compacta/DXF_corte/A-K04.dxf

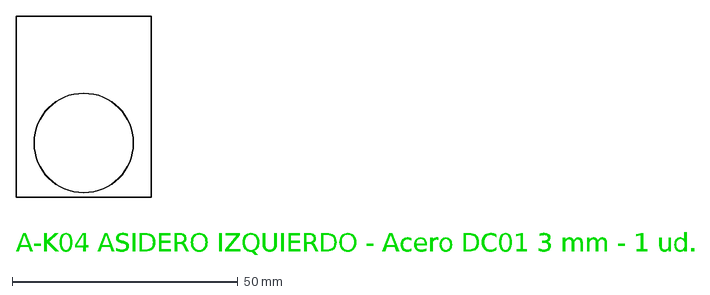
[picture p154: CAD file, 2026-11-13]
carcasa/diseno-A/CAD_A_Compacta/DXF_corte/A-K04.dxf
A-K04 ASIDERO IZQUIERDO - Acero DC01 3 mm - 1 ud.
