GuillermoAladro/Alcoholimetro/carcasa/diseno-A/CAD_A_Compacta/STEP_piezas/A-C05.step

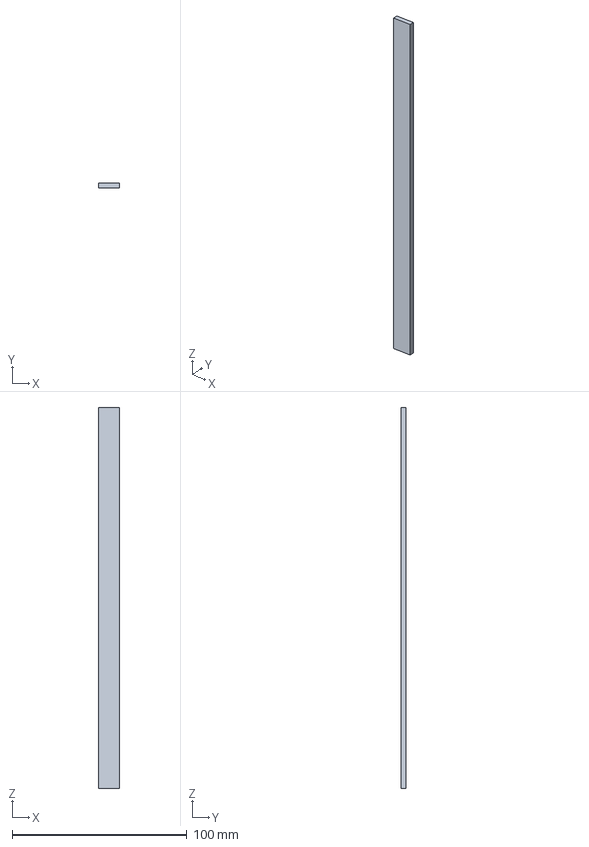
[picture p155: CAD file, 2026-11-13]
carcasa/diseno-A/CAD_A_Compacta/STEP_piezas/A-C05.step
12.0 x 3.00 x 218.0 mm
