GuillermoAladro/Alcoholimetro/carcasa/diseno-A/presupuesto/Carcasa_plegada/DXF_desarrollos/A-C07_Anilla_para_candado_en_el_lateral.dxf

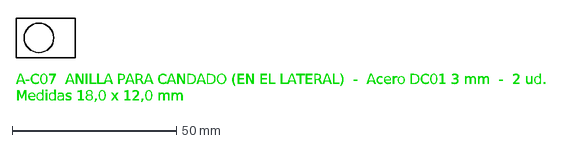
[picture p156: CAD file, 2026-11-13]
carcasa/diseno-A/presupuesto/Carcasa_plegada/DXF_desarrollos/A-C07_Anilla_para_candado_en_el_lateral.dxf
A-C07 ANILLA PARA CANDADO (EN EL LATERAL) - Acero DC01 3 mm - 2 ud.
Medidas 18,0 x 12,0 mm
