GuillermoAladro/Alcoholimetro/carcasa/diseno-A/presupuesto/Carcasa_plegada/STEP_piezas/A-P02_Tabique_del_cajon_de_pajitas.step

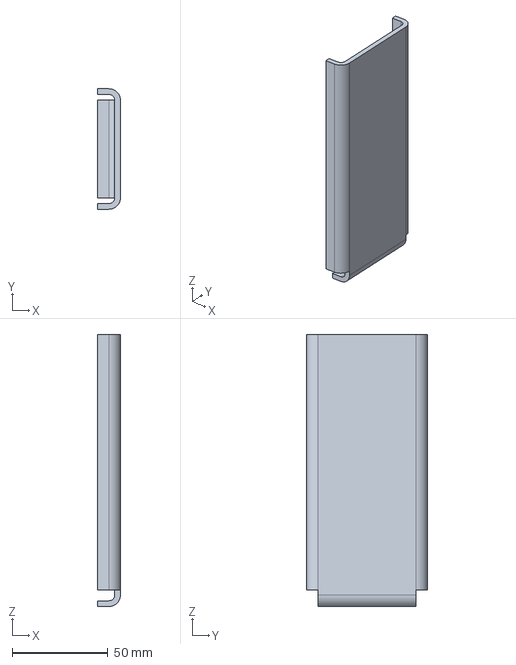
[picture p157: CAD file, 2026-11-13]
carcasa/diseno-A/presupuesto/Carcasa_plegada/STEP_piezas/A-P02_Tabique_del_cajon_de_pajitas.step
12.0 x 63.0 x 142.2 mm
