GuillermoAladro/Alcoholimetro/carcasa/diseno-A/CAD_A_Compacta/DXF_corte/A-C05.dxf

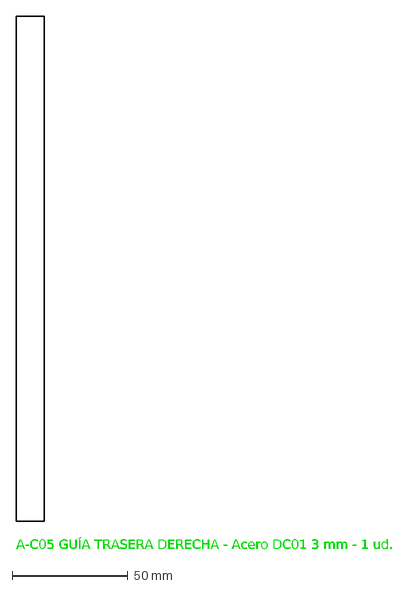
[picture p158: CAD file, 2026-11-13]
carcasa/diseno-A/CAD_A_Compacta/DXF_corte/A-C05.dxf
A-C05 GUÍA TRASERA DERECHA - Acero DC01 3 mm - 1 ud.
