GuillermoAladro/Alcoholimetro/carcasa/diseno-A/CAD_A_Compacta/STEP_piezas/A-S03.step

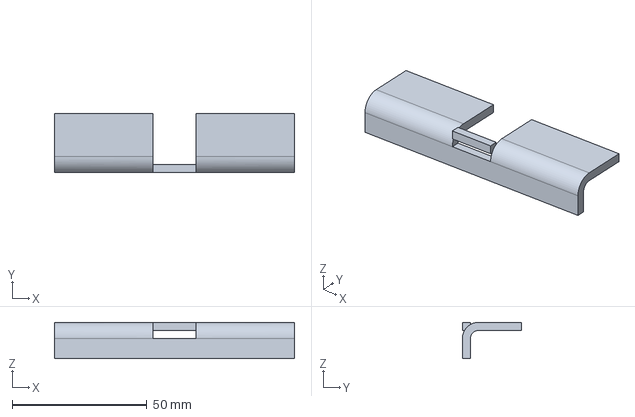
[picture p159: CAD file, 2026-11-13]
carcasa/diseno-A/CAD_A_Compacta/STEP_piezas/A-S03.step
89.2 x 22.0 x 13.5 mm
