GuillermoAladro/Alcoholimetro/carcasa/diseno-A/presupuesto/Carcasa_plegada/DXF_desarrollos/A-P07_Anilla_para_candado_en_la_tapa_del_cajon.dxf

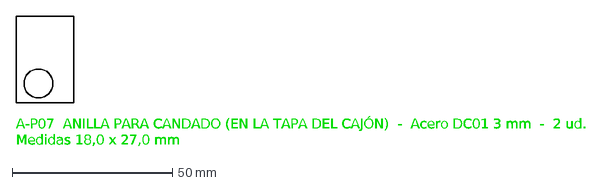
[picture p160: CAD file, 2026-11-13]
carcasa/diseno-A/presupuesto/Carcasa_plegada/DXF_desarrollos/A-P07_Anilla_para_candado_en_la_tapa_del_cajon.dxf
A-P07 ANILLA PARA CANDADO (EN LA TAPA DEL CAJÓN) - Acero DC01 3 mm - 2 ud.
Medidas 18,0 x 27,0 mm
