GuillermoAladro/Alcoholimetro/carcasa/diseno-A/CAD_A_Compacta/DXF_corte/A-P08.dxf

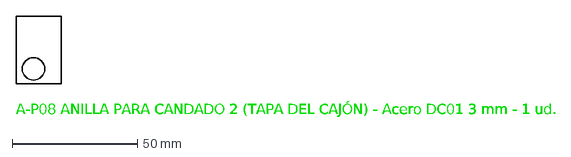
[picture p161: CAD file, 2026-11-13]
carcasa/diseno-A/CAD_A_Compacta/DXF_corte/A-P08.dxf
A-P08 ANILLA PARA CANDADO 2 (TAPA DEL CAJÓN) - Acero DC01 3 mm - 1 ud.
