GuillermoAladro/Alcoholimetro/carcasa/diseno-A/presupuesto/Carcasa_plegada/DXF_desarrollos/A-K04_Asidero_del_cajon_de_componentes.dxf

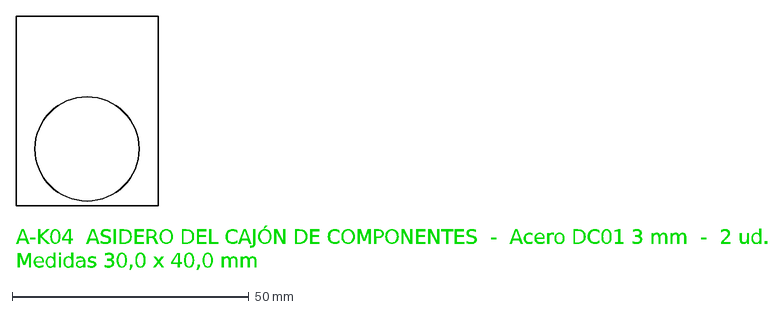
[picture p162: CAD file, 2026-11-13]
carcasa/diseno-A/presupuesto/Carcasa_plegada/DXF_desarrollos/A-K04_Asidero_del_cajon_de_componentes.dxf
A-K04 ASIDERO DEL CAJÓN DE COMPONENTES - Acero DC01 3 mm - 2 ud.
Medidas 30,0 x 40,0 mm
