GuillermoAladro/Alcoholimetro/carcasa/diseno-A/CAD_A_Compacta/DXF_corte/A-C08.dxf

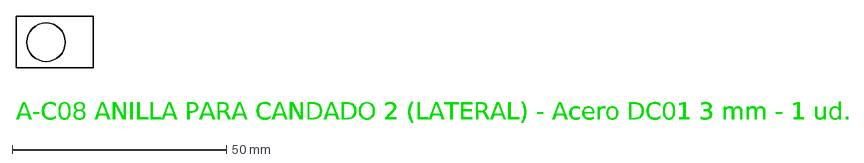
[picture p163: CAD file, 2026-11-13]
carcasa/diseno-A/CAD_A_Compacta/DXF_corte/A-C08.dxf
A-C08 ANILLA PARA CANDADO 2 (LATERAL) - Acero DC01 3 mm - 1 ud.
