GuillermoAladro/Alcoholimetro/carcasa/diseno-A/presupuesto/Carcasa_plegada/DXF_desarrollos/A-S04_Contraplaca_del_Solo.dxf

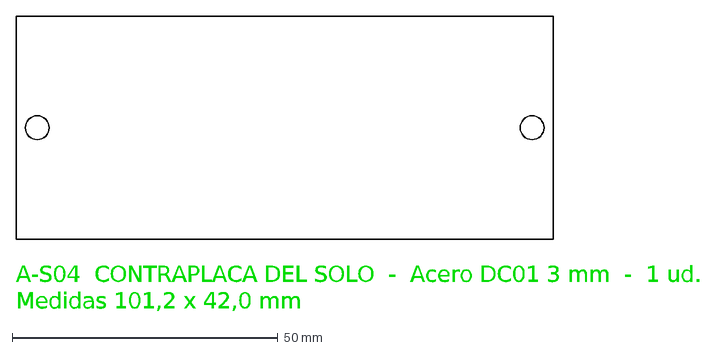
[picture p164: CAD file, 2026-11-13]
carcasa/diseno-A/presupuesto/Carcasa_plegada/DXF_desarrollos/A-S04_Contraplaca_del_Solo.dxf
A-S04 CONTRAPLACA DEL SOLO - Acero DC01 3 mm - 1 ud.
Medidas 101,2 x 42,0 mm
