GuillermoAladro/Alcoholimetro/carcasa/diseno-A/presupuesto/Carcasa_plegada/DXF_desarrollos/A-P01_Cuerpo_del_cajon_fondo_delantera_y_trasera.dxf

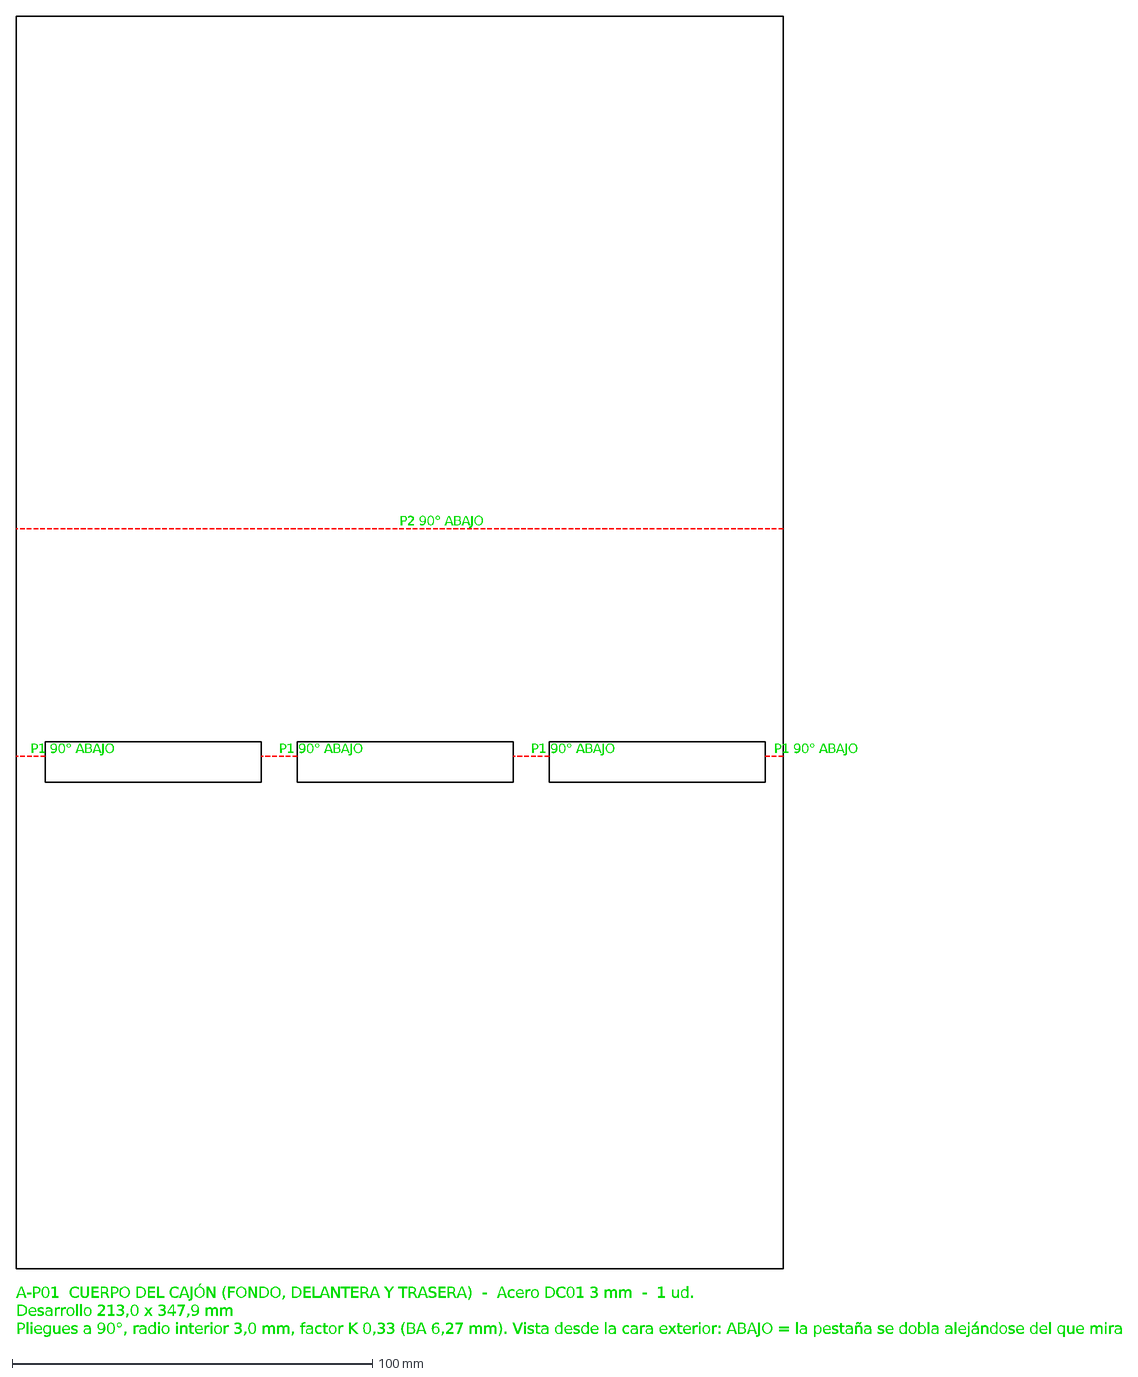
[picture p166: CAD file, 2026-11-13]
carcasa/diseno-A/presupuesto/Carcasa_plegada/DXF_desarrollos/A-P01_Cuerpo_del_cajon_fondo_delantera_y_trasera.dxf
P1 90° ABAJO
P2 90° ABAJO
A-P01 CUERPO DEL CAJÓN (FONDO, DELANTERA Y TRASERA) - Acero DC01 3 mm - 1 ud.
Desarrollo 213,0 x 347,9 mm
Pliegues a 90°, radio interior 3,0 mm, factor K 0,33 (BA 6,27 mm). Vista desde la cara exterior: ABAJO = la pestaña se dobla alejándose del que mira
