GuillermoAladro/Alcoholimetro/carcasa/diseno-A/CAD_A_Compacta/DXF_corte/A-P06.dxf

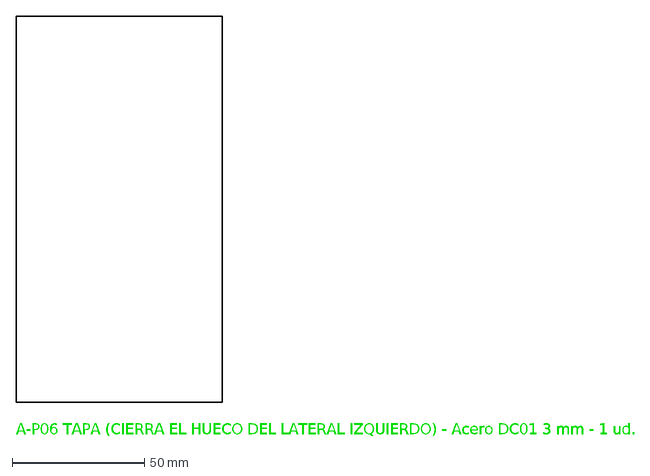
[picture p167: CAD file, 2026-11-13]
carcasa/diseno-A/CAD_A_Compacta/DXF_corte/A-P06.dxf
A-P06 TAPA (CIERRA EL HUECO DEL LATERAL IZQUIERDO) - Acero DC01 3 mm - 1 ud.
