GuillermoAladro/Alcoholimetro/carcasa/diseno-A/presupuesto/Carcasa_plegada/DXF_desarrollos/A-T03_Pestana_de_tope_de_apertura.dxf

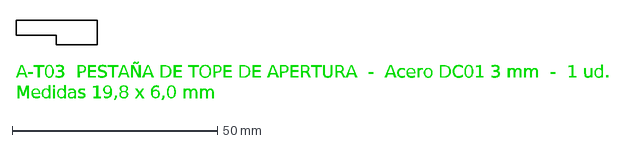
[picture p168: CAD file, 2026-11-13]
carcasa/diseno-A/presupuesto/Carcasa_plegada/DXF_desarrollos/A-T03_Pestana_de_tope_de_apertura.dxf
A-T03 PESTAÑA DE TOPE DE APERTURA - Acero DC01 3 mm - 1 ud.
Medidas 19,8 x 6,0 mm
