GuillermoAladro/Alcoholimetro/carcasa/diseno-A/CAD_A_Compacta/STEP_piezas/A-T02.step

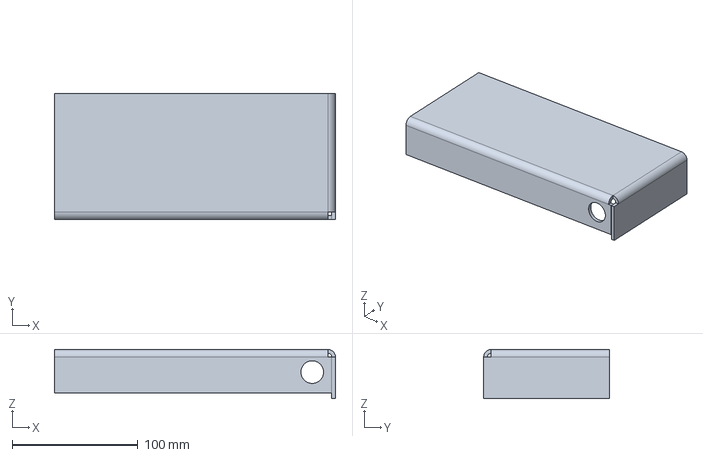
[picture p170: CAD file, 2026-11-13]
carcasa/diseno-A/CAD_A_Compacta/STEP_piezas/A-T02.step
223.5 x 100.0 x 39.0 mm
