GuillermoAladro/Alcoholimetro/carcasa/diseno-A/CAD_A_Compacta/DXF_corte/A-P07.dxf

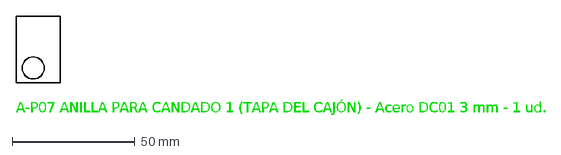
[picture p173: CAD file, 2026-11-13]
carcasa/diseno-A/CAD_A_Compacta/DXF_corte/A-P07.dxf
A-P07 ANILLA PARA CANDADO 1 (TAPA DEL CAJÓN) - Acero DC01 3 mm - 1 ud.
