GuillermoAladro/Alcoholimetro/carcasa/diseno-A/CAD_A_Compacta/DXF_corte/A-K06.dxf

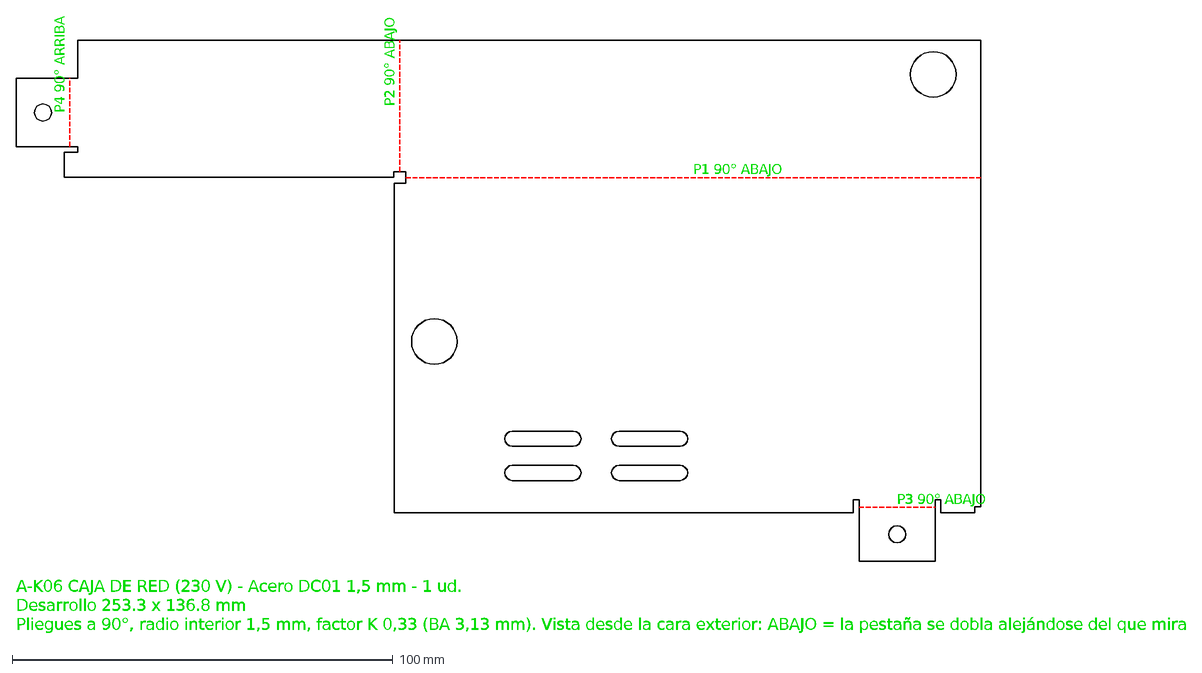
[picture p175: CAD file, 2026-11-13]
carcasa/diseno-A/CAD_A_Compacta/DXF_corte/A-K06.dxf
P1 90° ABAJO
P2 90° ABAJO
P3 90° ABAJO
P4 90° ARRIBA
A-K06 CAJA DE RED (230 V) - Acero DC01 1,5 mm - 1 ud.
Desarrollo 253.3 x 136.8 mm
Pliegues a 90°, radio interior 1,5 mm, factor K 0,33 (BA 3,13 mm). Vista desde la cara exterior: ABAJO = la pestaña se dobla alejándose del que mira
