GuillermoAladro/Alcoholimetro/carcasa/diseno-A/CAD_A_Compacta/DXF_corte/A-S03.dxf

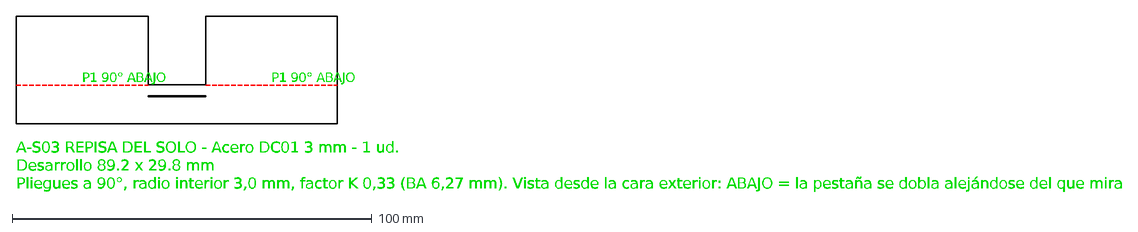
[picture p177: CAD file, 2026-11-13]
carcasa/diseno-A/CAD_A_Compacta/DXF_corte/A-S03.dxf
P1 90° ABAJO
A-S03 REPISA DEL SOLO - Acero DC01 3 mm - 1 ud.
Desarrollo 89.2 x 29.8 mm
Pliegues a 90°, radio interior 3,0 mm, factor K 0,33 (BA 6,27 mm). Vista desde la cara exterior: ABAJO = la pestaña se dobla alejándose del que mira
