GuillermoAladro/Alcoholimetro/(list of files, cad)

Other CAD files:
carcasa/diseno-A/presupuesto/Carcasa_plegada/STEP_piezas/A-S01_Pletina_de_la_pantalla.step
carcasa/diseno-A/presupuesto/Carcasa_plegada/STEP_piezas/A-S03_Repisa_del_Solo.step
carcasa/diseno-A/CAD_A_Compacta/STEP_piezas/A-P03.step
carcasa/diseno-A/CAD_A_Compacta/STEP_piezas/A-K05.step
carcasa/diseno-A/CAD_A_Compacta/STEP_piezas/A-S02.step
carcasa/diseno-A/CAD_A_Compacta/STEP_piezas/A-C04.step
carcasa/diseno-A/CAD_A_Compacta/STEP_piezas/A-P05.step
carcasa/diseno-A/CAD_A_Compacta/DXF_corte/A-V01.dxf
