GuillermoAladro/Alcoholimetro/montaje-general/1-alimentacion-y-tierra.png

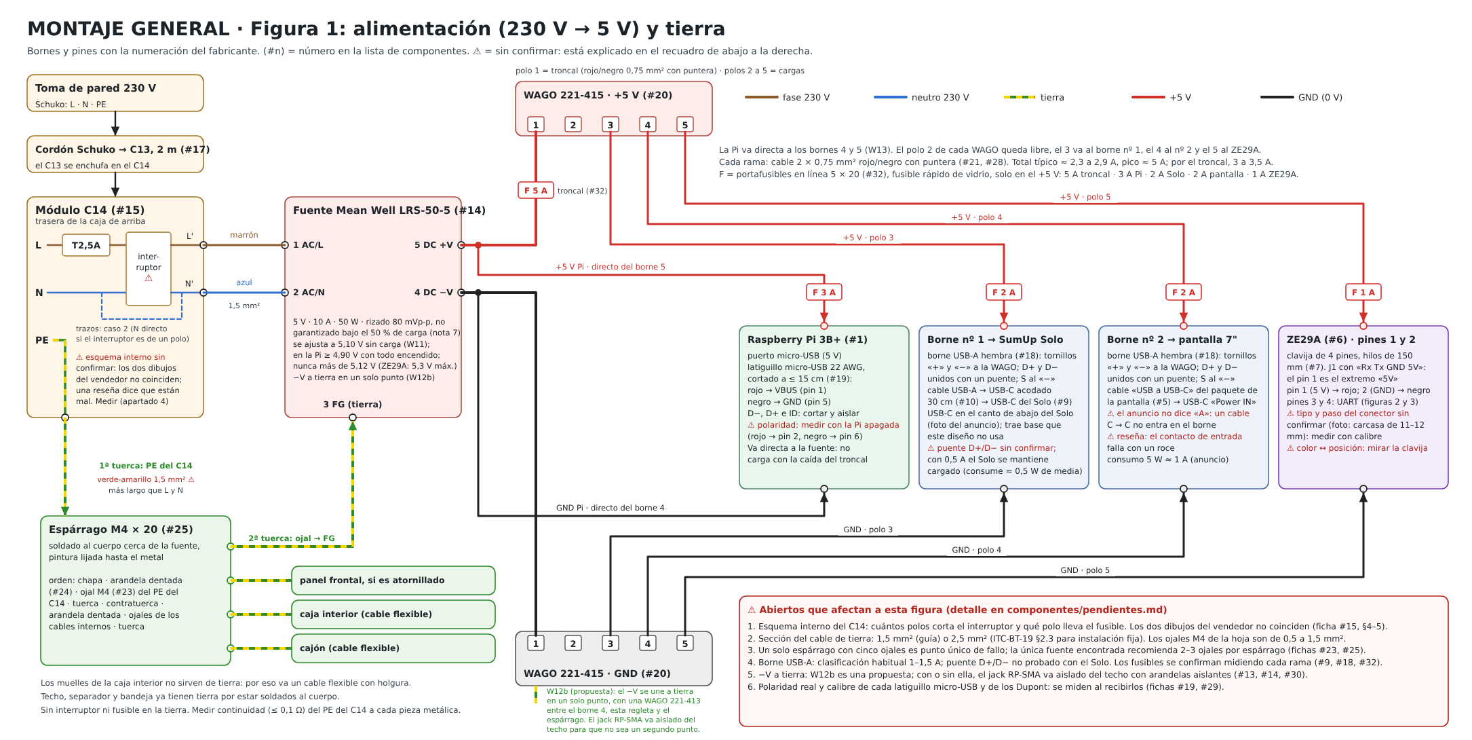
montaje-general/1-alimentacion-y-tierra.png
