GuillermoAladro/Alcoholimetro/montaje-general/2-pi-puertos-y-senales.png

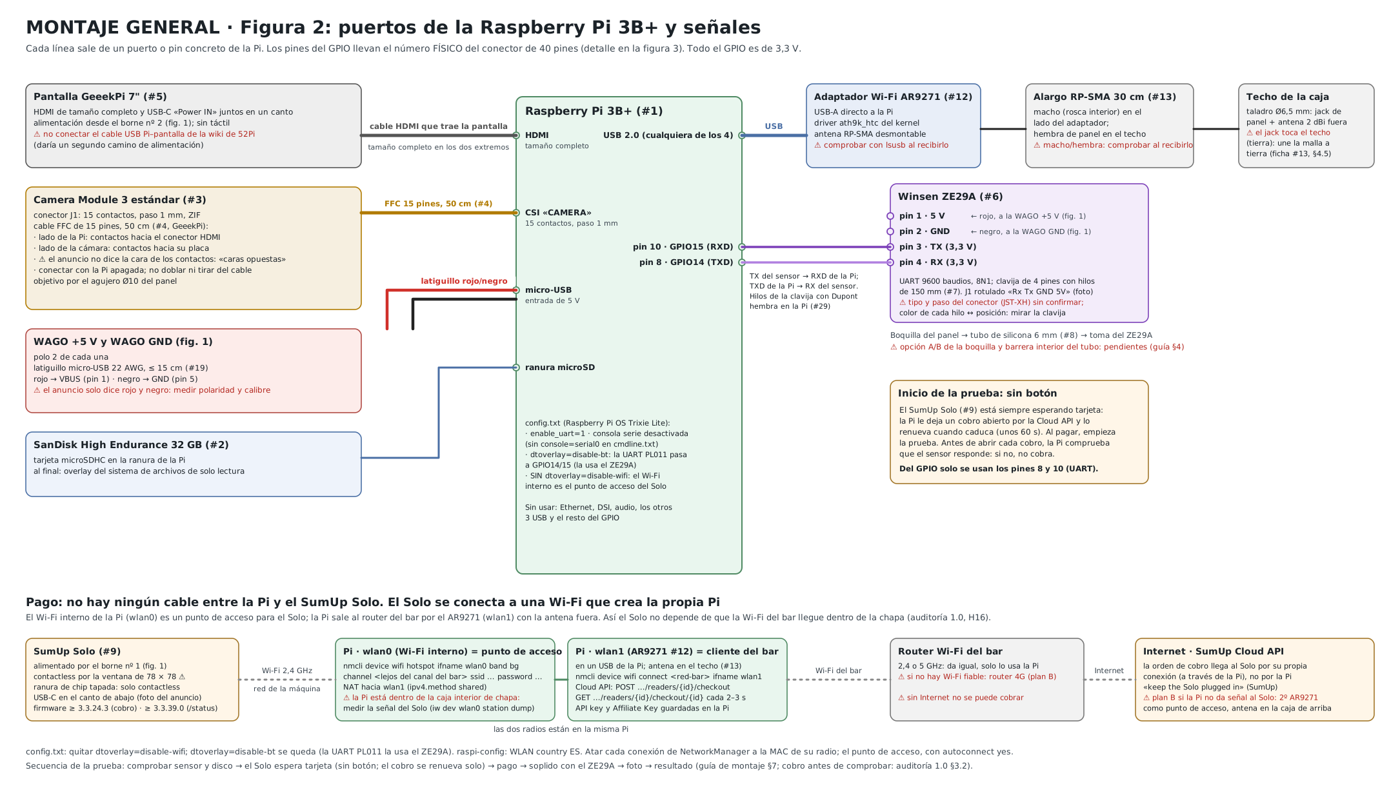
montaje-general/2-pi-puertos-y-senales.png
