GuillermoAladro/Alcoholimetro/montaje-general/3-gpio-40-pines.png

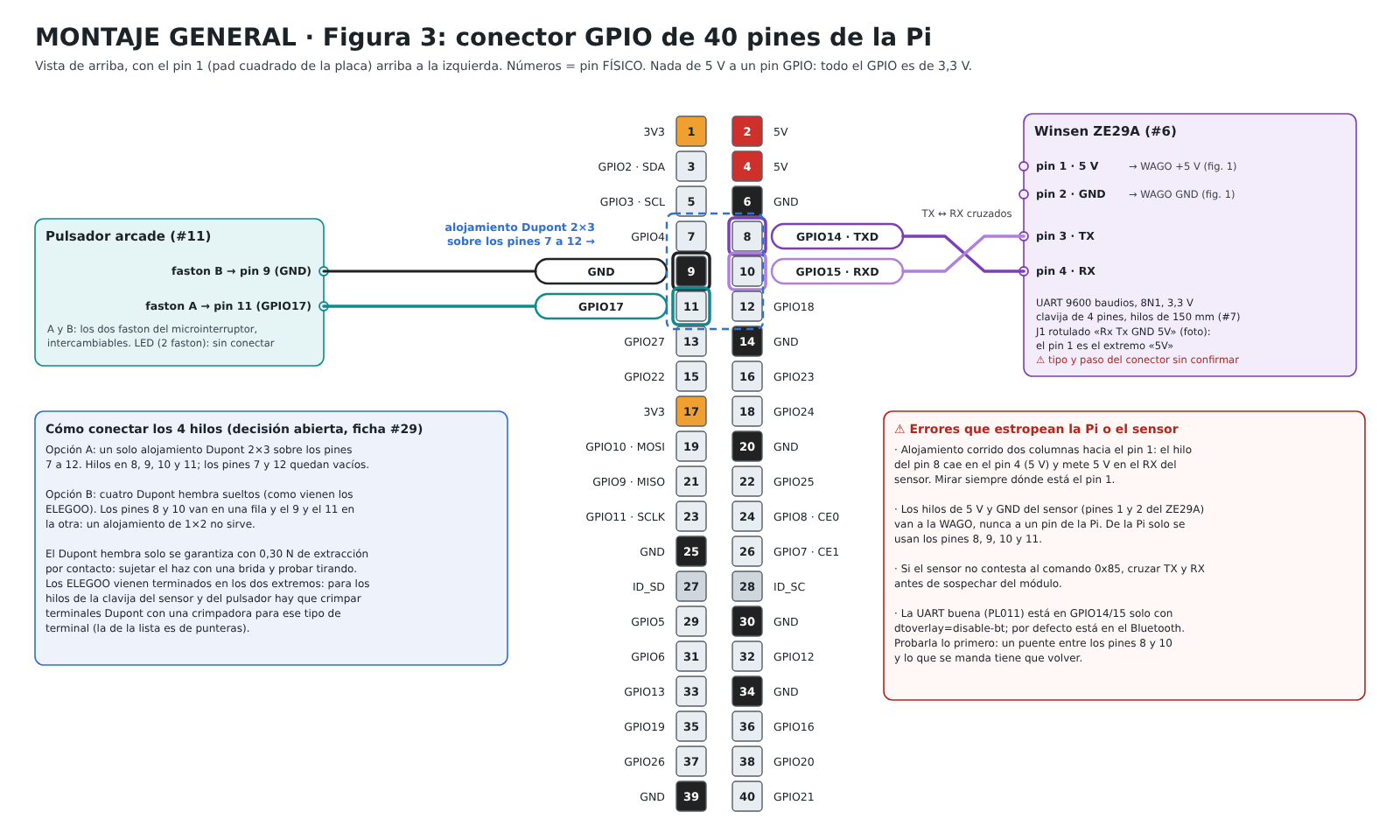
montaje-general/3-gpio-40-pines.png
