GuillermoAladro/Alcoholimetro/montaje-general/4-donde-va-cada-pieza.png

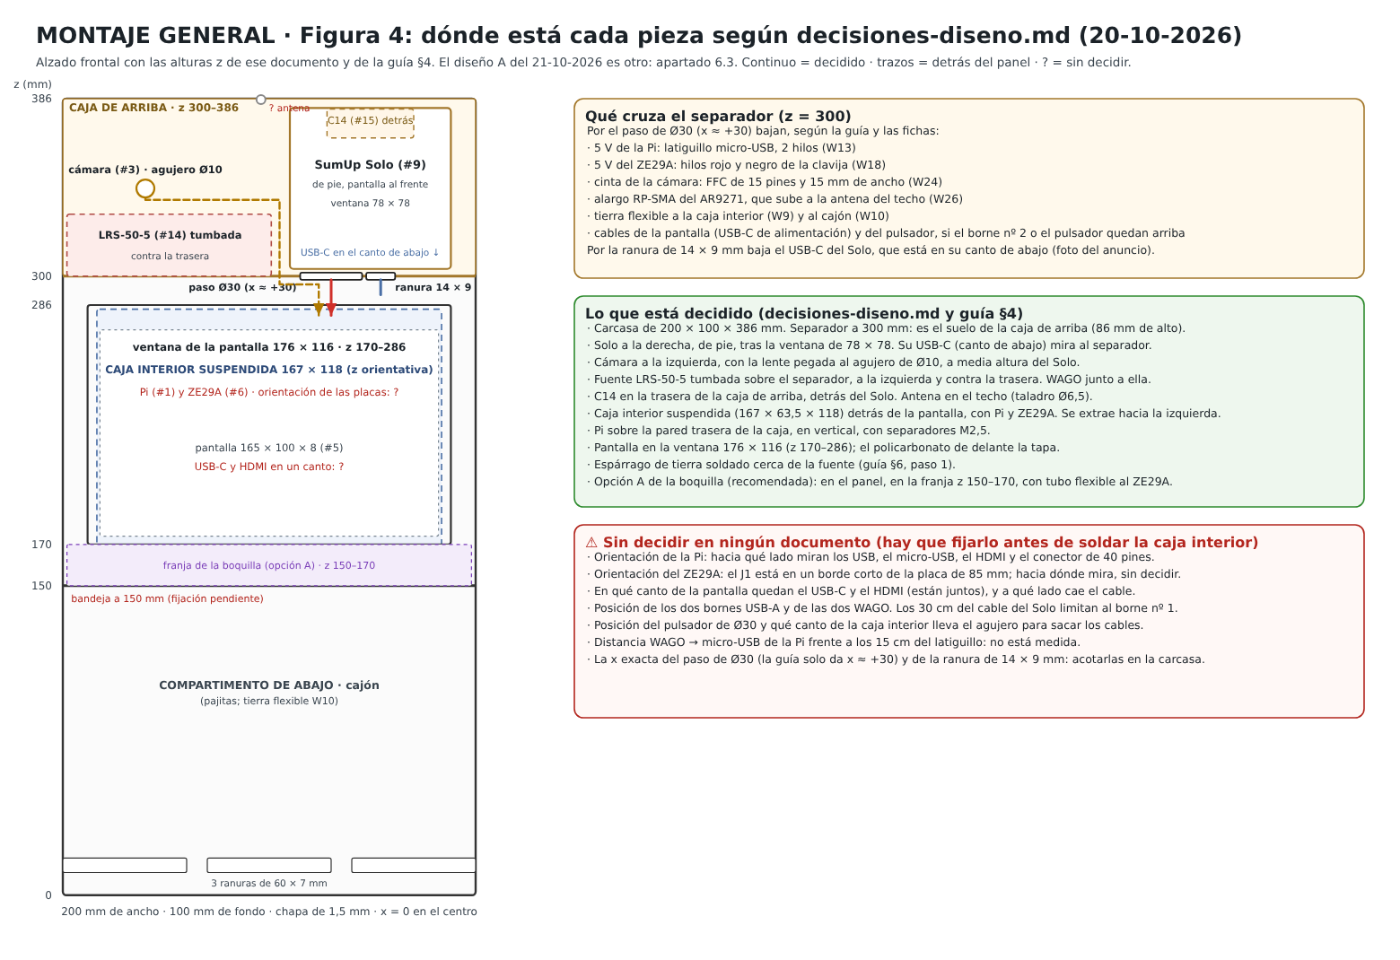
montaje-general/4-donde-va-cada-pieza.png
