GuillermoAladro/Alcoholimetro/Animaciones-Astra-no-verificadas/ver.html

Alcoholímetro · Nuevo banco

# Animaciones Astra

Guillermo Aladro · escenas de 1024 × 600

Cargando…

←→PausarRepetir Siguiente al terminar

0,00 / 0,00 s

Preparando escena

Las escenas se cargan desde lista.js.

500 ideas planificadas.
Ver lista completa
Ver comprobaciones

Banco separado para revisión. Avatares actuales conservados. Sin conexión a pagos, sensor ni ranking real.
