GuillermoAladro/Alcoholimetro/componentes/documentos-compartidos/normas/SOLiC-Test-Report-No-2013.pdf

Test Report 2013

Report No : Solic Model AF2.1

Test Report
IEC/EN 60335-1
Household and similar electrical appliances-Safety-Part 1: General Requirements
Report No | :
Tested by | :
Approved by :
Date | :
Test Specification
Standard : IEC 60335 - 1:2010 9 (Fifth Edition) EN 60335 - 1 : 2012
Test Item | :
Trade Mark | : Solic 200
Manufacturer | : Earthwise Products Ltd
Model / Type ref : Model AF 2.1
Ratings | : 205 – 260, 50 Hz, 3Kw
Testing Location : In House

List of Attachments
No attachments
Summary of Testing :
The Solic 200 unit was assessed for basic insulation between the mains circuitry and protective earth/accessible earthed metalwork.
Tests performed ( name of test and test clause)
General conditions for tests : | 5
Classification : | 6
Markings and Instructions : | 7
Protection against access to live parts : | 8
Power input and current : | 10
Heating : | 11
Leakage current and electric strength at operating temperature : | 13
Moisture resistance : | 15
Leakage current and electric strength : | 16
Overload protection and associated circuits : | 17
Endurance : | 18
Abnormal operation : | 19
Stability and mechanical hazards : | 20
Mechanical strength : | 21
Construction : | 22
Internal wiring : | 23
Components : | 24
Supply connections and external flexible cords : | 25
Terminals for external conductors : | 26
Provision for earthing : | 27
Screws and connections : | 28
Clearances, creepage distances and solid insulation : | 29
Resistance to heat and fire : | 30
Resistance to rusting : | 31
Radiation, toxicity and similar hazards : | 32

Summary of compliance with National Differences
List of countries addressed: Australia, Belgium, Denmark, France, Germany, Iceland, Ireland, Italy, Luxembourg, Netherlands, New Zealand, Norway, Portugal, Spain, Sweden, Switzerland, United Kingdom.
This product fulfils the requirements of IEC /EN 60335 – 1 & AS/NZS 60335 – 1

Marking plate used on the Solic 200

Test Item particulars
Classification of installation and use : Class 1
Supply connection | : Single - phase
Possible test case verdicts :
Test case does not apply to the test object : N/A Test item does meet the requirement : Pass
Test item does not meet the requirement : Fail
General product information :
The Solic 200 is an automatic power controller for heaters. It accurately tracks all available surplus power generated by photovoltaic, wind or water powered generators, ensuring all of the green energy produced is fully utilised.
Note : The maximum power/current is dependent on the rating of the external load, which is up to a maximum of 3 Kw. The recorded measurements in the appended table are for a unit with no load attached.

Only relevant clauses of IEC/EN 60335-1 shown

Clause | Requirement / Test | Remark | Verdict
5 | General Conditions for Tests | | Pass
| Test performed according to cl 5, eg nature of supply, sequence of testing etc. | | Pass
6 | Classification. | | Pass
6.1 | Protection against electric shock : | Class 1 | Pass
6.2 | Protection against harmful ingress of water. | IPXO | N/A
7 | Marking and Instructions | | Pass
7.1 | Rated voltage or voltage range (V) | 206 – 260 V | Pass
| Symbol for nature of supply. | | N/A
| Rated frequency (Hz). | 50Hz | Pass
| Rated power input. | 3Kw | Pass
| Rated current. | | N/A
| Manufacturer’s or responsible vendor’s name, trademark or identification mark. | Earthwise Products Ltd | Pass
| Model or type reference. | AF 2.1 | Pass
| IP number, other than IPXO. | IP 51 | Pass
7.3 | Range of rated values marked with the lower and upper limits separated by a hyphen. | | Pass
7.6 | Correct symbols used. | | Pass
| Units of physical quantities and their symbols according to international standardized system. | | Pass
7.8 | Except for type Z attachment, terminals for connection to the supply mains indicated as follows: | | Pass
| Marking of terminals exclusively for the neutral conductor (N). | | Pass
| Marking of protective earthing terminals (symbol IEC 60417 – 5019). | | Pass
| Marking not placed on removable parts. | | Pass
7.12 | Sufficient for safe use provided. | | Pass

Clause | Requirement / Test | Remark | Verdict
7.12 | The appliance is not to be used by persons ( including children) with reduced physical sesory or mental capabilities, or lack of experience and knowledge, unless they have been given supervision or instruction. | | Pass
| Children being supervised not to play with the appliance. | | Pass
7.12.1 | Sufficient details for installation supplied. | | Pass
| Stationary appliances not fitted with means for disconnection from the supply mains having a contact separation in all poles that provide full disconnection. | | Pass
7.12.7 | Instructions for fixed appliances stating how the appliance is to be fixed. | | Pass
7.13 | Instructions and other texts in an official language | English | Pass
7.14 | Marking clearly legible and durable | | Pass
7.15 | Marking on a main part | | Pass
| For fixed appliances, name, trademark or identification mark and model or type reference visible after installation. | | Pass
8 | Protection against Access to Live Parts | | Pass
8.1 | Adequate protection against accidental contact with live parts | | Pass
8.1.1 | Requirement applies for all positions, detachable parts removed | | Pass
| Use of test probe B of IEC 61032, with a force not exceeding 1 N, no contact with live parts | | Pass
| Use of test probe B of IEC 61032 through openings, with a force of 20 N, no contact with live parts. | | Pass

Clause | Requirement / Test | Remark | Verdict
10 | Power Input and Current | | Pass
10.1 | Power input at normal operating temperature, rated voltage and normal operation not deviating from rated power input by more than shown in Table 1 | | Pass
11 | Heating | | Pass
11.1 | No excessive temperatures in normal use | | Pass
11.2 | The appliance is held, placed or fixed in position as described | Wall mounted | Pass
11.3 | Temperature rises, other than windings, determined by thermocouples | | Pass
11.4 | Heating appliances operated under normal operation at 1.15 times rated power | 3.45 Kw | Pass
11.7 | Operation duration corresponding to the most unfavourable conditions of normal use | | Pass
11.8 | Temperature rises monitored continuously and not exceeding the values in Table 3 | | Pass
| Protective devices did not operate, except | See 24.1.4 | Pass
13 | Leakage Current and Electrical Strength at Operating Temperature | | Pass
13.1 | Leakage current not excessive and electric strength adaquate | | Pass
| Heating appliances operated at 1.15 times the rated power input (W) | 3.45 Kw | Pass
| Leakage current measurements | See appended table | Pass
| Electric strength tests according to Table 4 | See appended table | Pass
| Leakage current not excessive and electric strength adequate | | Pass
15 | Moisture Resistance | | Pass
15.1 | Enclosure provides the degree of moisture protection according to the classification of the appliance | | Pass

Clause | Requirement / Test | Remark | Verdict
15.3 | Appliances proof against humid conditions | | Pass
| Checked by test cabinet: Damp heat steady state in IEC 60068-2-78 | | Pass
| Humidity test for 48 hours in a humidity cabinet | | Pass
| The appliance withstands the tests of Clause 16 | | Pass
16 | Leakage Current and Electrical Strength | | Pass
16.1 | Leakage current not excessive and electric strength adequate | | Pass
| Tests carried out at room temperature and not connected to the supply | | Pass
16.2 | Single phase appliences test voltage 1.06 times rated voltage (V) | 254V | Pass
| Leakage current measurements | See appended table | Pass
16.3 | Electric strength tests according to Table 7 | See appended table | Pass
| No breakdown during tests | | Pass
19 | Abnormal Operation | | Pass
19.1 | The risk of fire, mechanical damage or electric shock under abnormal or careless operation obviated | | Pass
| Electronic circuits so designed and applied that a fault will not render the appliance unsafe | See appended table | Pass
| Appliances incorporating electronic circuits subjected to the tests of 19.11 and 19.12, as applicable | | Pass

Clause | Requirement / Test | Remark | Verdict
19.11 | Electronic circuits, compliance checked by evaluation of the fault conditions, specified in 19.12 for all circuits or parts of circuits, unless | | Pass
| They comply with the conditions specified in 19.11.1 | | Pass
| If the safety of the appliance under any of the fault conditions depends on the operation of a miniature fuse-link complying with IEC 60127, the test of 19.12 is carried out | | Pass
| During and after each test the following is checked | | Pass
| The appliance complies with the conditions specified in 19.13 | | Pass
19.11.1 | Before applying the fault conditions a) to f) in 19.11.2, it is checked if circuits or parts of the circuit meet both of the following conditions : | | Pass
19.11.2 | Fault conditions applied one at a time, the appliance operated under conditions specified in cl11, but supplied at rated voltage, the duration of the tests as specified | | Pass
| Short circuit of capacitors, unless | | Pass
| Short circuit of any two terminals of an electronic component, other than integrated circuits | | Pass

Clause | Requirement / Test | Remark | Verdict
19.11.4.8 | The appliance is supplied at rated voltage and operated under normal operation. After 60 s the power supply is reduced to a level such that the appliance ceases to respond or parts controlled by the programmable component cease to operate | | Pass
19.13 | During the test the appliance does not emit flames, molten metal, poisonous or ignitable gas in hazardous amounts | | Pass
Temperature rises not exceeding the values shown in Table 9 | See appended table | Pass
Compliance with clause 8 not impaired | | Pass
If the appliance can still be operated it complies with 20.2 | | Pass
Insulation, other than class 3 appliance, withstand the electric strength test of 16.3, the test voltage specified in Table 7 | | Pass
Basic insulation (V) | 1250V rms | Pass
After operation or interruption of a control, clearances and creepage distances across the functional insulation withstand the electric strength test of 16.3, the test voltage being twice the working voltage | | Pass

Clause | Requirement / Test | Remark | Verdict
| The appliance does not undergo a dangerous malfunction, and | | Pass
| No failure of protective electronic circuits, if the appliance is still operable | | Pass
20 | Stability and Mechanical Hazards | | Pass
20.1 | Appliances have adequate stability | Fixed equipment | Pass
20.2 | Moving parts adequately arranged or enclosed as to provide protection against personal injury | | Pass
21 | Mechanical Strength | | Pass
| Appliance has adequate mechanical strength and is constructed as to withstand rough handling | | Pass
| Checked by applying 3 blows to every point of the enclosure, likely to be weak, in accordance with test Ehb of IEC 60068-2-75, spring hammer test, with an impact energy of 0.5 J | | Pass
| The appliance shows no damage impairing compliance with this standard, and | | Pass
| Compliance with 8.1,15.1 and clause 29 not impaired | | Pass
22 | Construction | | Pass
22.1 | Appliance marked with the first numeral of the IP system, relevant requirements of IEC 60529 are fulfilled | | Pass

Clause | Requirement / Test | Remark | Verdict
22.2 | Stationary appliance: means to ensure all-pole disconnection from the supply being provided | | Pass
| A statement in the instruction sheet that a disconnection incorporated in the fixed wiring is to be provided
22.11 | Reliable fixing of non-detachable parts that provide the necessary degree of protection against electric shock,moisture or contact with moving parts | | Pass
| Test as described | | Pass
22.14 | No ragged or sharp edges creating a hazard for the user in normal use, or during user maintenance | | Pass
22.18 | Current- carrying parts and other metal parts resistant to corrosion under normal conditions of use | | Pass
22.31 | Neither clearences nor creepage distances between live parts and accessible parts reduced below values for supplementary insulation if wires,screws etc become loose | | Pass
22.32 | Supplementary and reinforced insulation constructed or protected against pollution so that clearences or creepage distances are not reduced below the values in clause 29 | | Pass

Clause | Requirement / Test | Remark | Verdict
22.41 | No components, other than lamps, containing mercury | | Pass
23 | Internal Wiring | | Pass
23.1 | Wireways smooth and free from sharp edges | | Pass
| Wires protected against contact with burrs, cooling fins etc | | Pass
| Wire holes in metal well rounded or provided with bushings | | Pass
| Wires effectively prevented from coming into contact with moving parts | | Pass
23.7 | The colour combination green/yellow only used for earthing conductors | | Pass
24 | Components | | Pass
24.1 | Components comply with safety requirements in relevant IEC standards | | Pass
| List of components | See appended table | Pass
24.1.1 | Capacitors likely to be permanently subjected to the supply voltage and used for radio interference suppression or for voltage dividing, complying with IEC 60384-14 | | Pass
| If capacitors have to be tested, they are tested according to Annex F | | Pass
24.2 | Appliances not fitted with devices causing the protection device in the fixed wiring to operate in the event of a fault in the appliance | | Pass

Clause | Requirement / Test | Remark | Verdict
25 | Supply connection and external flexible cords | | Pass
25.3 | Appliance intended to be permanently connected to fixed wiring provided with one of the following means for connection to the supply mains | | Pass
| A set of terminals for the connection of cables of fixed wiring, cross sectional areas specified in 26.6, and the appliance allows the connection of the supply conductors after the appliance has been fixed to its support | | Pass
| A set of terminals and cable entries, knock-outs or glands, allowing connection of appropriate types of cable or conduit, and the appliance allows the connection of the supply conductors after the appliance has been fixed to its support | | Pass
| For a fixed appliance, constructed so that parts can be removed to facilitate easy installation, this requirement is met if it is possible to connect the fixed wiring without difficultly after a part of the appliance has been fixed to its support | | Pass
26 | Terminals for external conductors | | Pass
26.8 | Terminal for the connection of fixed wiring, including the earthing terminal, located close to each other | | Pass

Clause | Requirement / Test | Remark | Verdict
26.9 | Terminals of the pillar type constructed and located as specified | | Pass
27 | Provision for earthing | | Pass
27.1 | Accessible metal parts of Class 01 and 1 appliances permanently and reliably connected to an earthing terminal or earthing contact of the appliance inlet | | Pass
| Earthing terminals and earthing contacts not connected to the neutral terminal | | Pass
27.2 | Clamping means of earthing terminals adequately secured against accidental loosening | | Pass
27.4 | No Risk of corrosion resulting from contact between parts of the earthing terminal and copper of the earthing conductor or other metal | | Pass
| Parts providing earthing continuity, other than parts of a metal frame or enclosure, have adequate resistance to corrosion | | Pass
27.5 | Low resistance of connection between earthing terminal and earthed metal parts | | Pass
28 | Screws and connections | | Pass
28.1 | Fixings, electrical connections and connections providing earthing continuity withstands mechanical stresses | | Pass

Clause | Requirement / Test | Remark | Verdict
| Screws not of soft metal liable to creep, such as zinc or aluminium | | Pass
| Screws used for electrical connections or connections providing earthing continuity screwed into metal | | Pass
28.2 | Electrical connections and connections providing earthing continuity constructed so that contact pressure is not transmitted through non-ceramic insulating material liable to shrink or distort , unless there is resiliency in the metallic parts to compensate for shrinkage or distortion of the insulating material | | Pass
29 | Clearances, creepage distances and solid insulation | | Pass
| Clearences, creepage distances and solid insulation withstand electrical stress | | Pass
29.1 | Clearances not less than the values specified in table 16, taking into account the rated impulse voltage for the overvoltage categories of Table 15, unless | See appended table | Pass
29.1.1 | Clearances of basic insulation withstand the overvoltages, taking into account the rated impulse voltage | | Pass
| The values of Table 16 or the impulse voltage test of clause 14 are applicable | See appended table | Pass

Clause | Requirement / Test | Remark | Verdict
29.1.3 | Clearances of reinforced insulation not less than those specified for basic insulation in Table 16, but using the next higher step or rated impulse voltage | See appended table | Pass
29.1.4 | Clearances for functional insulation are the largest values determined from Table 16 based on the rated impulse voltage | | Pass
29.2 | Creepage distances not less than those appriate for working voltage, taking into account the material group and the pollution degree | See appended table | Pass
| Pollution degree 2 applies, unless | | Pass
29.2.1 | Creepage distances of basic insulation not less than specified in Table 17 | | Pass
29.2.4 | Creepage distances of functional insulation not less than specified in Table 18 | See appended table | Pass
30 | Resistance to heat and fire | | Pass
| For base materials of printed circuit boards, 30.2.4 applies | | Pass
30.2.4 | Base material of printed circuit boards subjected to needle-flame test of Annex E | Test not required | Pass
| Test not applicable to condition as specified | See appended table | Pass

Clause | Requirement / Test | Remark | Verdict
31 | Resistance to rusting | | Pass
| Relevant ferrous parts adequately protected against rusting | Zinc plated screws | Pass
32 | Radiation, toxicity and similar hazards | | Pass
| Appliance does not emit harmful radiation or present a toxic or similar hazard due to their operation in normal use | | Pass
A | Routine tests | | Pass
| Description of routine tests carried out by manufacturer | See attached Safe System of Work | Pass
K | Annex K (Normative) Overvoltage categories | | Pass
| The information on overvoltage categories is extracted from IEC60664-1 | | Pass
| Overvoltage category is a numeral defining a transient overvoltage condition | | Pass
L | Annex L (Informative) Guidance for the measurement of clearances and creepage distances | | Pass
| Sequence for the determination of clearences and creepage distances
M | Annex M (Normative) Pollution Degree | | Pass
| The information on pollution degree is extracted from IEC 60664-1 | | Pass
| Pollution | | Pass
| The microenvironment determines the effect of pollution on the insulation, taking into account the microenvironment | | Pass

Clause | Requirement / Test | Remark | Verdict
| Degrees of pollution in the microenvironment | | Pass
| For evaluating creepage distances, the following degrees of pollution in the microenvironment are established | | Pass
| Pollution degree 2: only non-conductive pollution occurs, except that occasionallya temporary conductivity caused by condensation is to be expected | | Pass
O | Annex O (Informative) Selection and sequence of the tests of Clause 30 | | Pass
| Description of tests for determination of resistance to heat and fire | | Pass
Q | Annex Q (Informative) Sequence of tests for the evaluation of electronic circuits | | Pass
| Description of tests for appliances incorporating electronic circuits | | Pass

Clause | Requirement - Test | Result | Verdict
10.1 | Table 1: Power Input deviation | | Pass
Input Deviation of / at : | P rated (W) | P measured (W) | ∆P | Required ∆ P | Remark
220V 50Hz | 3Kw | 4.7 | - | +5% / -10% | See below
240V | 3Kw | 5.9 | - | +5% / -10% | See below

Supplementary Information: Power drawn from the unit off load. Total power is dependent on the external load up to a maximum of 3 Kw.

Clause | Requirement - Test | Result | Verdict
11.8 | Table 3: Heating test, thermocouple measurements | | Pass
| Test Voltage (V)
| Ambient (⁰C)
Thermocouple Locations | Max Temperature rise measured, ∆ T (K) | Max Temperature rise limit ∆ T (K)

Lower case, below Triac

Supplementary Information :

Clause | Requirement - Test | Result | Verdict
13.2 | Table 4 : Leakage current | | Pass
| Heating appliances : 1.15 x rated input | 254V
Leakage current between | | 1 (mA) | Max allowed 1 (1mA)
Live and earth | | 0.83 | 2.4
Neutral and earth | | 0.80 | 2.4

Supplementary Information :

Clause | Requirement - Test | Result | Verdict
13.3 | Electrical strength | | Pass
Test voltage applied between : | Test potential applied (V) | Breakdown/flashover (Yes/No)
Live /Neutral and earth | 1000 | No
Supplementary Information :

Clause | Requirement - Test | Result | Verdict
16.2 | Table 5: Leakage current | | Pass
| Single phase appliances : | 254
| Three phase appliances 1.06 x rated voltage divided by √3 | -
Leakage current between ; | 1 (mA) | Max allowed 1 (mA)
Live | Earth | 1.16 | 2.4
Neutral | Earth | 1.15 | 2.4

Supplementary Information :

Clause | Requirement - Test | Result | Verdict
16.3 | Table6: Electric strength | | Pass
Test voltage applied between : | Test potential applied (V) | Breakdown/flashover (Yes/No)
Live/Neutral and earth | 1250 | No

Supplementary Information :

Clause | Requirement - Test | Result | Verdict
17 | Table7:Overload protection | | Pass
Thermocouple Locations | Max Temperature rise measured, ∆ T (K) | Max Temperature rise limit ∆ T (K)
Outer casing 1 | 43.2 | 100
Outer casing 2 | 32.2 | 95

Supplementary Information :

Clause | Requirement - Test | Result | Verdict
19 | Table8: Abnormal operation conditions | | Pass
Operational characteristics | Yes / No | Operational conditions
Are there electronic circuits to control the appliance operation? | Yes | Manual or timed operation
Are there “off “or ”stand-by” position? | No
The unintended operation of the appliance results in dangerous malfunction? | No

Sub-clause | Operating conditions | Test result description | PEC description | Result
| 19.11.2 | Triac | Max temperature of 45.6 ⁰C on lower case | N/A | Pass

Supplementary Information :

29.1 | Table 9 : Clearances | | Pass
| Overvoltage category | | 2
| | Type of insulation :
Rated impulse voltage (V) | Min. cl (mm) | Basic (mm) | Supplementary (mm) | Reinforced (mm) | Functional (mm) | Verdict / Remark
2500 V | 1.5 | 2.5 | | | | Primary to earth
2500 V | 1.5 | 2.5 | | | | Live & Neutral

Supplementary Information :

Clause | Requirement - Test | Result | Verdict
29.2 Table10 : Creepage distances,basic,supplementary and | reinforced insulation | | Pass
Working voltage (V) | Creepage distance in mm Pollution degree
| 1 | 2 | 3 | Type of insulation
| | Material group | Material group
| | 1 | 2 | 3a/3b | 1 | 2 | 3a/3b | B | S | R | Result
230 | | | | 2.65 | | | | 1 | | | Pass
230 | | | | 3.71 | | | | 2 | | | Pass
Supplementary Information :
1, Measured from mains circuitry to earth across PCB
2, Measured between Live and Neutral on PCB before fuse
