GuillermoAladro/Alcoholimetro/Animaciones-Astra-no-verificadas/LISTA-500.md

# 500 ideas · Animaciones Astra

Banco nuevo: `Animaciones-Astra-no-verificadas`. IDs propios del banco, de `00000` a `00499`.

Todas las escenas incluyen a Guillermo Aladro, solo o acompañado de los avatares actuales. Los personajes conservan cara, ropa y proporciones; no se rediseñan. El lienzo es de 1024 × 600, el formato es JavaScript Canvas y cada escena empieza y acaba en negro completo. Duración objetivo: 8–12 segundos. Los mecanismos fantásticos se presentan como utilería o maquetas para que su funcionamiento sea legible.

Cada idea define una acción y un desenlace. Esta lista es un plan: no afirma que las 500 escenas estén implementadas ni verificadas. Las escenas creadas se incorporan a `lista.js`; las pruebas y capturas se guardan por separado.

Revisión prevista por escena: trayectorias continuas; apoyos y agarres coherentes; escala y profundidad estables; orden de oclusión; conservación de objetos; texto legible; Guillermo visible; negro exacto al inicio y al final; ausencia de errores JavaScript. Las capturas y el pase visual complementan las comprobaciones automáticas y no constituyen una garantía absoluta de ausencia de fallos.

## Barra y objetos con vida

- **00000 Posavasos en órbita** — Guillermo observa un posavasos que orbita a su alrededor; aterriza bajo un vaso justo antes de que toque la mesa.
- **00001 El ascensor de la tapa** — Una plataforma eleva a Guillermo hasta una tapa diminuta; baja de nuevo y la tapa desciende en su propio ascensor.
- **00002 El hielo equilibrista** — Tres cubitos se apilan delante de Guillermo; el último resbala y los tres terminan ordenados dentro del vaso.
- **00003 La servilleta acordeón** — Una servilleta se despliega como un acordeón junto a Guillermo; su último pliegue revela una aceituna escondida.
- **00004 El tapón satélite** — Un tapón sale de una botella y describe un arco sobre Guillermo; vuelve exactamente al cuello cuando la botella se inclina.
- **00005 La campana impaciente** — Una campana de barra salta sola frente a Guillermo; una segunda campana pequeña le contesta desde debajo del mostrador.
- **00006 La pajita periscopio** — Una pajita telescópica busca a Guillermo detrás de un vaso; se retrae cuando él reaparece al otro lado.
- **00007 La gota puntual** — Una gota recorre el borde de una jarra ante Guillermo; cae en un posavasos que llega deslizándose en el último instante.
- **00008 El mantel viajero** — El mantel se recoge por sí solo mientras Guillermo observa; cada plato avanza por una cinta y vuelve a su sitio.
- **00009 La aceitera semáforo** — Tres gotas de aceite esperan frente a Guillermo; una luz verde las deja caer en fila sobre la misma tostada.
- **00010 El vaso tímido** — Un vaso se esconde tras un servilletero cuando se enciende el foco de Guillermo; termina saliendo bajo un foco diminuto.
- **00011 La bandeja niveladora** — La bandeja junto a Guillermo se inclina con cada vaso; sus patas se ajustan hasta dejar todos los líquidos horizontales.
- **00012 La cucharilla brújula** — Una cucharilla gira frente a Guillermo como una brújula; apunta a una taza que aparece detrás de una cortina.
- **00013 El azucarillo escapista** — Un azucarillo recorre un laberinto sobre la mesa de Guillermo; la salida desemboca directamente en una taza.
- **00014 El limón con cremallera** — Un limón mecánico se abre en gajos ante Guillermo; una cremallera dibujada lo cierra cuando rueda fuera del plato.
- **00015 El posavasos trampolín** — Una gota rebota en un posavasos elástico junto a Guillermo; cae dentro del vaso sin salpicar.
- **00016 La botella metrónomo** — Una botella vacía oscila sobre su base redonda frente a Guillermo; una cucharilla acompasa el último golpe.
- **00017 El platillo aparcacoches** — Un plato gira para recibir varias tapas junto a Guillermo; deja una plaza exacta para la última aceituna.
- **00018 La máquina de burbujas** — Un grifo de refresco produce burbujas cuadradas ante Guillermo; pasan por un aro y salen redondas.
- **00019 El hielo con escalera** — Un cubito sube escalones hacia el vaso de Guillermo; el último escalón se convierte en un tobogán.
- **00020 El menú desplegable** — El menú se abre por capas frente a Guillermo; la última página es una puerta por la que sale una tapa real.
- **00021 La taza sobre raíles** — Una taza llega hasta Guillermo por un raíl de barra; un desvío devuelve la cucharilla olvidada.
- **00022 El soporte perezoso** — Un soporte de servilletas bosteza abriendo su tapa junto a Guillermo; una servilleta lo arropa y la tapa baja.
- **00023 La sombra del vaso** — La sombra de un vaso crece mientras Guillermo mira; se revela una luz acercándose, sin cambiar el tamaño del vaso.
- **00024 El brindis de cristal** — Dos vasos se acercan entre Guillermo y Laura; tintinean sin derramar nada y sus reflejos repiten el gesto con retraso.

## Tapas y cocina de juguete

- **00025 La croqueta funambulista** — Una croqueta cruza una cuerda entre platos frente a Guillermo; aterriza sobre una servilleta que se abre como colchoneta.
- **00026 El pincho telescópico** — Un pincho se alarga encima de la mesa de Guillermo; recoge tres ingredientes y se contrae formando una tapa.
- **00027 La patata lunar** — Una patata salta lentamente entre cráteres de un plato ante Guillermo; una gota de salsa marca su aterrizaje.
- **00028 El queso dominó** — Fichas de queso caen en cadena junto a Guillermo; la última sostiene una galleta antes de que llegue al suelo.
- **00029 La aceituna submarina** — Una aceituna se sumerge en un vaso transparente ante Guillermo; reaparece en un pequeño ascensor de burbujas.
- **00030 La tortilla brújula** — Una porción de tortilla gira sobre el plato de Guillermo; se alinea con el hueco exacto de la tortilla completa.
- **00031 El pan acordeón** — Un panecillo se estira en rebanadas frente a Guillermo; las rebanadas vuelven a juntarse alrededor de un relleno.
- **00032 La tapa con paraguas** — Una tapa abre un paraguas ante una lluvia de salsa junto a Guillermo; lo cierra para recibir una sola gota.
- **00033 El tomate rodante** — Un tomate recorre una rampa delante de Guillermo; una hoja lo frena exactamente en el centro del plato.
- **00034 La galleta ascensor** — Dos galletas suben por guías junto a Guillermo; se encuentran con una capa de crema y bajan convertidas en sándwich.
- **00035 El churro flexible** — Un churro de juguete se enrolla como un muelle frente a Guillermo; se estira para cruzar un cuenco de chocolate.
- **00036 La pizza giratoria** — Una pizza gira sobre un expositor junto a Guillermo y Marta; una porción viaja por una pasarela y completa el círculo.
- **00037 La sopa planetaria** — Tres picatostes orbitan en un cuenco ante Guillermo; la corriente se detiene y forman una pequeña constelación.
- **00038 El cacahuete portero** — Un cacahuete cierra una puerta a otros dos frente a Guillermo; abre de nuevo cuando llega el cuenco correcto.
- **00039 La empanadilla almohada** — Una empanadilla baja sobre un cojín frente a Guillermo; el cojín se desinfla y la deposita suavemente en el plato.
- **00040 La tostada reversible** — Una tostada gira en un soporte frente a Guillermo; ambas caras muestran dibujos distintos hechos con ingredientes.
- **00041 El pepinillo resorte** — Un pepinillo sale de un bote de juguete junto a Guillermo; el muelle lo devuelve sin cambiar su orientación.
- **00042 El cometa de palomitas** — Una palomita deja una estela de migas ante Guillermo; las migas se recogen en el mismo cuenco al aterrizar.
- **00043 La fuente de chocolate** — Una fuente eleva una gota delante de Guillermo; la gota se divide sobre tres fresas colocadas a distintas alturas.
- **00044 El tenedor jardinero** — Un tenedor mecánico alinea hojas de ensalada frente a Guillermo; la última hoja hace de bandera del pequeño jardín.
- **00045 La cebolla matrioska** — Aros de cebolla se separan delante de Guillermo; vuelven a encajar por tamaño sin atravesarse.
- **00046 El sándwich ascendente** — Capas de un sándwich suben por turnos frente a Guillermo; una campana transparente baja y las reúne.
- **00047 El plato magnético** — Ingredientes de juguete se ordenan alrededor de un plato junto a Guillermo; el imán se apaga y quedan bien colocados.
- **00048 La aceituna del tesoro** — Tres tapas de cuencos se levantan ante Guillermo y Rodri; la aceituna estaba sobre la tapa central desde el principio.
- **00049 La última miga** — Una miga recorre toda la mesa de Guillermo; termina en un plato enorme con un cartel de reservado.

## Equilibrio y mecanismos de feria

- **00050 La canica paciente** — Una canica espera en la cima de una pista junto a Guillermo; el último tramo se coloca y llega a una campana.
- **00051 El balancín educado** — Guillermo y Yorgi están sobre plataformas de un balancín; contrapesos visibles las dejan a la misma altura.
- **00052 La torre con ascensor** — Bloques suben alrededor de Guillermo por un elevador; el último completa un arco que deja libre su cara.
- **00053 El aro que vuelve** — Un aro rueda por una pista frente a Guillermo; una curva lo devuelve a su soporte inicial.
- **00054 La peonza camarera** — Una peonza lleva una bandeja junto a Guillermo; se detiene sobre una base que mantiene los vasos verticales.
- **00055 El puente plegable** — Un puente se despliega bajo la plataforma de Guillermo; se recoge detrás conforme la plataforma cruza.
- **00056 La pelota indecisa** — Una pelota oscila entre dos rampas frente a Guillermo; una tercera salida la conduce a una cesta.
- **00057 El trampolín del sombrero** — Un sombrero de utilería rebota junto a Guillermo; aterriza en un perchero separado sin tocar su avatar.
- **00058 La escalera musical** — Una bola baja por escalones frente a Guillermo; cada peldaño enciende una nota y el último ilumina el conjunto.
- **00059 El cubo imposible** — Un cubo transparente gira ante Guillermo; una bola dentro llega a la salida siguiendo canales visibles.
- **00060 El aro de precisión** — Una ficha atraviesa tres aros alineados junto a Guillermo; el último se convierte en su soporte.
- **00061 La noria de tapas** — Una noria pequeña gira frente a Guillermo; sus cestas permanecen verticales y una entrega una tapa.
- **00062 La rampa de terciopelo** — Una bola baja demasiado despacio frente a Guillermo; un tramo de terciopelo se enrolla y deja libre la pista.
- **00063 El peso pluma** — Una balanza junto a Guillermo compara una pluma con un bloque; se revela que el bloque es hueco.
- **00064 El dado obediente** — Un dado rueda por una guía ante Guillermo; sus caras son flechas y acaba señalando el vaso correcto.
- **00065 La cuerda transportadora** — Una cuerda tira de un carrito frente a Guillermo; vuelve a enrollarse dejando el carrito en su plaza.
- **00066 El puente de posavasos** — Posavasos forman un puente junto a Guillermo; una canica lo cruza y las piezas vuelven a apilarse.
- **00067 El resorte con timbre** — Un resorte comprimido frente a Guillermo impulsa una bola; la bola toca un timbre y cae en una red.
- **00068 La cesta fugitiva** — Una cesta se mueve para recibir una pelota junto a Guillermo; la pelota se detiene y la cesta vuelve debajo.
- **00069 El cilindro bailarín** — Un cilindro rueda sobre una superficie cóncava ante Guillermo; queda de pie al entrar en un hueco circular.
- **00070 El plato sobre rieles** — Tres platos pasan por cruces junto a Guillermo y Carla; cambian de vía sin tocarse y se alinean.
- **00071 La ruleta de colores** — Una rueda de colores gira ante Guillermo; el indicador cae en un color que ilumina todo el marco del escenario.
- **00072 El rodillo estampador** — Un rodillo deja huellas de estrellas en una cinta frente a Guillermo; la última huella es un punto final.
- **00073 La esfera encajada** — Dos medias cúpulas esperan junto a Guillermo; una esfera baja y las cúpulas se cierran alrededor de su soporte.
- **00074 El muelle cortés** — Un muelle levanta una pequeña bandera frente a Guillermo; espera a que pase un carrito y vuelve a esconderse.

## Música sin canciones reconocibles

- **00075 El piano de vasos** — Vasos afinados se iluminan en secuencia junto a Guillermo; una gota toca el último como tecla final.
- **00076 La batería de cucharas** — Cucharas mecánicas golpean cuencos ante Guillermo; una cucharilla pequeña termina con un solo inesperado.
- **00077 El altavoz de pompas** — Un altavoz emite pompas visibles frente a Guillermo; la última contiene una nota y estalla en silencio.
- **00078 La nota viajera** — Una nota de papel recorre un pentagrama junto a Guillermo; cae en un atril y se convierte en punto final.
- **00079 El metrónomo despistado** — Un metrónomo pierde el ritmo ante Guillermo; otro más pequeño lo acompaña y ambos se sincronizan.
- **00080 La alfombra de teclas** — La plataforma de Guillermo recorre teclas luminosas; cada apoyo ilumina una y la salida apaga todas en orden.
- **00081 El trombón telescópico** — Un trombón de utilería se alarga junto a Guillermo; su campana alcanza una flor que se abre con la vibración.
- **00082 La maraca transparente** — Una maraca muestra sus semillas ante Guillermo; las semillas se ordenan durante una pausa y vuelven a sonar.
- **00083 El platillo con eco** — Un platillo vibra junto a Guillermo; círculos de luz viajan hasta otro platillo que responde.
- **00084 La caja de ritmo** — Una caja se abre delante de Guillermo; cuatro pequeños pistones dibujan un ritmo y cierran la tapa al terminar.
- **00085 El xilófono deslizante** — Láminas de xilófono cambian de altura ante Guillermo; una bola las recorre y las deja ordenadas por tamaño.
- **00086 La partitura enrollable** — Una partitura rueda frente a Guillermo; las notas saltan al atril y el papel vacío se recoge.
- **00087 El concierto de campanas** — Tres campanas giran frente a Guillermo y Laura; cada una se detiene después de iluminar su nota.
- **00088 El bombo discreto** — Un bombo pequeño vibra frente a Guillermo; su última pulsación levanta una nube mínima de confeti.
- **00089 La clave de espuma** — Burbujas forman una clave musical junto a Guillermo; se deshace empezando por la cola y acaba en una burbuja.
- **00090 El atril inquieto** — Un atril ajusta su altura delante de Guillermo; la partitura llega después en un minúsculo ascensor.
- **00091 La cuerda luminosa** — Una cuerda de instrumento vibra junto a Guillermo; la vibración recorre otras cuerdas hasta dibujar una onda.
- **00092 El coro de tazas** — Tazas con aberturas distintas giran frente a Guillermo; sus ondas luminosas se juntan en un acorde visual.
- **00093 La baqueta boomerán** — Una baqueta unida a un brazo giratorio golpea un tambor ante Guillermo; vuelve al soporte siguiendo el mismo círculo.
- **00094 El disco de agua** — Surcos luminosos giran sobre una superficie de agua junto a Guillermo; la última onda llega a la orilla.
- **00095 La escalera del volumen** — Barras de volumen suben frente a Guillermo; una escalera lateral recoge la barra que se quedó arriba.
- **00096 El triángulo tímido** — Un triángulo musical permanece oscuro ante Guillermo; su diminuto golpe enciende un foco enorme alrededor.
- **00097 El director invisible** — Una batuta suspendida marca el ritmo junto a Guillermo; al caer el telón se revela su pequeño mecanismo.
- **00098 La pausa perfecta** — Instrumentos mecánicos se detienen frente a Guillermo y Marta; una única nota sigue flotando hasta entrar en su caja.
- **00099 El aplauso de guantes** — Dos guantes de utilería aplauden junto a Guillermo; se saludan con una reverencia y se guardan en un cajón.

## Luz, sombras y óptica

- **00100 El foco perseguidor** — Un foco sigue una pelota alrededor de Guillermo; al detenerse la pelota, otro foco ilumina al protagonista.
- **00101 La sombra puntual** — La sombra de una silla llega tarde junto a Guillermo; una lámpara móvil revela la causa y restablece la coincidencia.
- **00102 El prisma camarero** — Un prisma divide un rayo junto a Guillermo; cada color ilumina una tapa distinta y después se recombinan.
- **00103 La lupa de migas** — Una lupa pasa delante de una miga junto a Guillermo; la agranda solo dentro del cristal y sigue su camino.
- **00104 El túnel de espejos** — Dos espejos muestran reflejos sucesivos de Guillermo; una cortina tapa uno y desaparecen en orden.
- **00105 El neón enredado** — Un tubo de luz se desenrolla detrás de Guillermo; forma un marco sin cruzar su silueta y se apaga desde un extremo.
- **00106 La linterna de lunares** — Una linterna proyecta puntos alrededor de Guillermo; al girar su disco los puntos forman una estrella.
- **00107 El arcoíris de vasos** — Vasos transparentes descomponen una franja de luz junto a Guillermo; el último devuelve una franja blanca.
- **00108 La silueta sorpresa** — Una lámpara proyecta una sombra grande frente a Guillermo; se revela que procede de un pequeño tenedor.
- **00109 La estrella apagada** — Una estrella de escenario se queda oscura sobre Guillermo; una pequeña chispa recorre el cable y la enciende.
- **00110 El reflector curioso** — Un reflector gira alrededor de Guillermo y Carla; se detiene entre ambos y abre un círculo de luz compartido.
- **00111 La persiana de colores** — Una persiana proyecta franjas sobre el suelo de Guillermo; al abrirse las franjas se unen en una superficie clara.
- **00112 El faro de sobremesa** — Un faro pequeño gira junto a Guillermo; ilumina un barquito oculto detrás de un vaso.
- **00113 El espejo empañado** — Un espejo junto a Guillermo se empaña desde los bordes; una resistencia dibujada lo aclara y devuelve su reflejo.
- **00114 El rayo con desvío** — Espejos orientables conducen un rayo alrededor de Guillermo; llega a una campana luminosa sin atravesar objetos opacos.
- **00115 La bombilla ascensor** — Una bombilla baja por su cable junto a Guillermo; enciende tres pisos de una maqueta y vuelve a subir.
- **00116 La ventana nocturna** — Una ventana de utilería se ilumina detrás de Guillermo; una luna de papel cruza por fuera y vuelve la oscuridad.
- **00117 El semáforo de sombras** — Tres luces generan tres sombras de una pelota junto a Guillermo; se apagan una a una hasta quedar la real.
- **00118 La espiral luminosa** — Una tira de luz gira alrededor de la peana de Guillermo; termina enrollada en una lámpara lateral.
- **00119 El cristal de lluvia** — Gotas sobre un cristal deforman las luces detrás de Guillermo; una escobilla despeja una ventana y revela el escenario.
- **00120 La luz del cajón** — Un cajón se abre junto a Guillermo y emite luz; dentro hay una lámpara diminuta que también abre un cajón.
- **00121 El sol regulable** — Un sol de teatro sube detrás de Guillermo; una rueda visible baja su brillo hasta convertirlo en luna.
- **00122 La sombra con escalera** — Una bola sube peldaños junto a Guillermo; su sombra cambia con cada altura y se reúne con ella al bajar.
- **00123 El farol de bolsillo** — Un farol pequeño ilumina a Guillermo y Marta desde un pedestal; su pantalla se abre y amplía el círculo de luz.
- **00124 La última luciérnaga** — Puntos de luz se reúnen en una lámpara junto a Guillermo; uno se retrasa y entra justo antes del apagado.

## Clima de escenario

- **00125 La nube de sobremesa** — Una nube pequeña llueve sobre una maceta junto a Guillermo; se desplaza cuando la maceta queda regada.
- **00126 El paraguas semáforo** — Paraguas de utilería se abren por turnos alrededor de Guillermo; el último recoge una gota que quedó suspendida.
- **00127 La ventisca ordenada** — Copos rodean a Guillermo sin taparle la cara; al cesar el viento forman una fila sobre una barandilla.
- **00128 El charco espejo** — Un charco refleja a Guillermo y un farol; una gota altera el reflejo y las ondas se disipan antes del cierre.
- **00129 La brisa de servilletas** — Un ventilador mueve servilletas junto a Guillermo; cada una vuelve a su pinza cuando el ventilador se frena.
- **00130 El arcoíris portátil** — Una lluvia fina atraviesa un foco junto a Guillermo; aparece un arcoíris que desaparece al cerrarse la luz.
- **00131 La nube con cremallera** — Una nube de teatro se abre delante de Guillermo; deja caer confeti azul y vuelve a cerrarse vacía.
- **00132 El relámpago educado** — Una tormenta de utilería espera a que Guillermo quede bajo una marquesina; un destello ilumina solo el cielo.
- **00133 La nieve en espiral** — Copos bajan por una corriente helicoidal alrededor de la peana de Guillermo; se posan fuera de sus pies.
- **00134 El termómetro tímido** — Un termómetro de juguete sube junto a Guillermo; un pequeño abanico lo enfría y aparece una flor en la base.
- **00135 La lluvia de corchos** — Corchos ligeros caen sobre una red junto a Guillermo; la red los agrupa en una caja sin golpearle.
- **00136 El viento con flechas** — Flechas muestran la corriente que rodea a Guillermo; un molino pequeño gira siguiendo esa misma dirección.
- **00137 La nube aparcada** — Varias nubes avanzan sobre Guillermo y Rodri; una encuentra su hueco y apaga el intermitente de juguete.
- **00138 El granizo de algodón** — Bolas de algodón rebotan en un toldo delante de Guillermo; ruedan juntas hasta una cesta.
- **00139 El sol entre cortinas** — Dos cortinas ocultan un sol de teatro tras Guillermo; se separan y una nube pequeña cruza el hueco.
- **00140 El copo arquitecto** — Copos se unen en una casita junto a Guillermo; el último se coloca como tejado y la casa se ilumina.
- **00141 La gotera musical** — Gotas caen en tres cubos frente a Guillermo; un toldo inclinado las conduce finalmente a uno solo.
- **00142 El abanico gigante** — Un abanico se abre detrás de Guillermo; el aire mueve una cometa situada delante sin alterar su avatar.
- **00143 La nube exprimida** — Dos rodillos de juguete comprimen una nube junto a Guillermo; el agua baja a un depósito y el vapor vuelve arriba.
- **00144 El pronóstico giratorio** — Un panel meteorológico cambia detrás de Guillermo; cada símbolo corresponde al efecto que aparece en la maqueta lateral.
- **00145 El remolino de hojas** — Hojas giran dentro de un cilindro transparente junto a Guillermo; el motor se detiene y caen en una pila.
- **00146 La sombrilla puntual** — Una sombrilla abre su sombra sobre Guillermo; el sol de escenario recorre un arco y la sombra lo acompaña.
- **00147 El rocío de cristal** — Gotas aparecen en una hoja grande junto a Guillermo; se unen y caen sobre una flor que se abre.
- **00148 La ráfaga con retorno** — Una ráfaga empuja una veleta junto a Guillermo; un resorte visible la devuelve suavemente a su posición.
- **00149 El cielo plegable** — Un decorado de cielo se pliega detrás de Guillermo y Laura; el último panel muestra una estrella antes de cerrarse.

## Laboratorio de juguete

- **00150 El imán selectivo** — Un imán atrae arandelas junto a Guillermo; deja inmóvil una pieza de madera y ordena el resto en una torre.
- **00151 La polea generosa** — Una polea eleva una caja delante de Guillermo; el contrapeso baja y abre un cajón con una sola aceituna.
- **00152 El engranaje tardío** — Un engranaje espera fuera del mecanismo junto a Guillermo; se acopla y activa una pequeña bandera final.
- **00153 La bomba de burbujas** — Una bomba manual de juguete llena un tubo junto a Guillermo; las burbujas elevan una bola hasta su salida.
- **00154 El circuito luminoso** — Una bola conductora cierra una pista delante de Guillermo; se enciende una luz que señala el recorrido completado.
- **00155 El pistón dormilón** — Tres pistones trabajan junto a Guillermo; el cuarto arranca tarde y termina empujando suavemente el cartel final.
- **00156 La báscula de aire** — Un globo tira de una balanza delante de Guillermo; pequeños pesos visibles compensan su ascenso.
- **00157 El péndulo curioso** — Un péndulo oscila frente a Guillermo; cada pasada abre una ventanita distinta hasta completar una sonrisa de luces.
- **00158 La lupa mecánica** — Una lupa recorre piezas sobre una cinta junto a Guillermo; encuentra una estrella diminuta y la proyecta en un panel.
- **00159 El tornillo infinito** — Un tornillo sin fin mueve una plataforma de Guillermo; una flecha muestra el giro y el trayecto acaba en una parada.
- **00160 La cinta clasificadora** — Bolas de distintos tamaños pasan frente a Guillermo; agujeros calibrados las separan en tres cajas.
- **00161 El tubo transparente** — Una pelota viaja por un tubo junto a Guillermo; válvulas visibles abren el camino y evitan que retroceda.
- **00162 La batería de limones** — Limones de maqueta alimentan una bombilla frente a Guillermo; una ficha señala el circuito completo al encenderse.
- **00163 El brazo servicial** — Un brazo robótico de juguete coloca una servilleta junto a Guillermo; se repliega dejando el vaso centrado.
- **00164 La mesa antigravedad** — Un electroimán de utilería sostiene una esfera frente a Guillermo; una bandeja sube para recibirla antes de apagarlo.
- **00165 El contador de gotas** — Gotas pasan por un sensor luminoso junto a Guillermo; el contador llega a diez y cierra la llave.
- **00166 La probeta arcoíris** — Capas de líquidos de colores se apilan en una probeta ante Guillermo; una luz lateral destaca sus límites.
- **00167 El resorte calibrado** — Un resorte lanza fichas a distintas marcas frente a Guillermo; la última llega justo a la señal central.
- **00168 El ventilador inverso** — Un ventilador reversible mueve una bola dentro de un tubo junto a Guillermo; la devuelve al punto de partida.
- **00169 La lente enfocada** — Una lente enfoca una estrella de papel en un panel junto a Guillermo; el panel se ilumina al quedar nítida.
- **00170 El mecanismo escondido** — Una tapa transparente deja ver un mecanismo junto a Guillermo; un solo giro termina desplegando un saludo.
- **00171 El termostato de flores** — Un termostato de juguete regula una lámpara junto a Guillermo; las flores se abren al encenderse y se cierran al bajar.
- **00172 La brújula obstinada** — Un imán mueve una brújula frente a Guillermo; al retirarlo la aguja vuelve suavemente a su dirección inicial.
- **00173 La rueda hidráulica** — Agua circula por una rueda delante de Guillermo; una bomba visible la devuelve arriba y completa el circuito.
- **00174 La máquina de puntos** — Un mecanismo estampa puntos junto a Guillermo y Paradigma; al terminar forman una flecha que señala a ambos.

## Ilusionismo de escenario

- **00175 La caja con doble fondo** — Una caja transparente se abre junto a Guillermo; una bandeja interior revela la flor escondida sin atravesar paredes.
- **00176 El pañuelo interminable** — Un rodillo saca un pañuelo largo delante de Guillermo; al final aparece el carrete que explica su longitud.
- **00177 El aro de humo** — Un aro de vapor se expande frente a Guillermo; atraviesa un marco vacío y se disuelve detrás.
- **00178 La escalera del conejo** — Un conejo de juguete sale de una caja junto a Guillermo; usa una escalera visible y se esconde en la siguiente.
- **00179 El espejo giratorio** — Un espejo gira delante de Guillermo y Yorgi; al quedar de canto deja ver la lámpara que parecía desaparecer.
- **00180 La carta transparente** — Una carta de utilería se vuelve hacia Guillermo; una ventana recortada deja ver el mismo fondo sin cambiarlo.
- **00181 El baúl de luces** — Un baúl junto a Guillermo libera esferas luminosas; cada una vuelve por una abertura antes de cerrar la tapa.
- **00182 El cubo plegado** — Un cubo se despliega en seis caras frente a Guillermo; una bola sale por el centro y el cubo vuelve a cerrarse.
- **00183 La varita mecánica** — Una varita en un soporte mueve una cortina junto a Guillermo; detrás hay otra varita aún más pequeña.
- **00184 La flor retráctil** — Una flor de papel crece desde un tubo frente a Guillermo; su tallo telescópico se recoge después del saludo.
- **00185 El sombrero con escalera** — Una escalera sale de un sombrero de utilería junto a Guillermo; por ella baja una aceituna con ruedecitas.
- **00186 La mesa que flota** — Una mesa se eleva al lado de Guillermo; se enciende la luz inferior y revela un pequeño elevador transparente.
- **00187 El telón diminuto** — Un telón se abre dentro de un marco junto a Guillermo; una segunda cortina aún menor repite el movimiento.
- **00188 La cuerda que dibuja** — Una cuerda guiada por poleas dibuja una estrella delante de Guillermo; las poleas invierten el giro y la recogen.
- **00189 El espejo sin susto** — Una pelota aparece duplicada en un espejo junto a Guillermo; al girar el espejo se ve claramente cuál era el reflejo.
- **00190 La caja de confeti** — Una caja libera una columna de confeti ante Guillermo; un embudo lateral lo recoge sin que vuelva mágicamente al origen.
- **00191 El globo encajable** — Un globo pasa por un aro que se abre junto a Guillermo; el aro se cierra después y revela el truco.
- **00192 El cajón de pañuelos** — Tres cajones se abren ante Guillermo y Carla; un pañuelo continuo conecta los tres por conductos visibles.
- **00193 La estrella plegadiza** — Una estrella de papel se pliega frente a Guillermo; entra en una caja y se abre cuando la tapa se levanta.
- **00194 El pedestal secreto** — Un pedestal cambia de altura junto a Guillermo; una ventana muestra el tornillo que lo mueve.
- **00195 La moneda de teatro** — Una ficha grande rueda frente a Guillermo; cae de canto en una ranura y reaparece en una bandeja inferior.
- **00196 El marco sin cuadro** — Un marco vacío gira junto a Guillermo; luces traseras dibujan una imagen únicamente sobre su pantalla retráctil.
- **00197 La cortina de pompas** — Pompas forman una cortina delante de una mesa junto a Guillermo; se disuelven y dejan visible el mismo objeto.
- **00198 El nudo obediente** — Una cinta forma un lazo ante Guillermo; sus extremos se separan siguiendo el recorrido inverso y deshacen el nudo.
- **00199 El final dentro del final** — Un telón cierra el escenario de Guillermo; una ventanita se abre en él, muestra una estrella y vuelve a cerrar.

## Espacio y planetarios de juguete

- **00200 La luna en un vaso** — Una luna de maqueta desciende sobre el vaso junto a Guillermo; su reflejo queda dentro mientras la luna vuelve arriba.
- **00201 El planeta de corcho** — Un planeta de corcho gira detrás de Guillermo; un anillo de posavasos se coloca alrededor sin tocarlo.
- **00202 El cometa con bufanda** — Un cometa de papel cruza el planetario de Guillermo; la cola pasa completa antes de desaparecer por el borde.
- **00203 La estación de aceitunas** — Pequeñas cápsulas llegan a una estación junto a Guillermo; descargan aceitunas y se alejan por vías distintas.
- **00204 La órbita aparcada** — Una esfera completa una órbita alrededor de Guillermo; desacelera y queda en una base tangente al recorrido.
- **00205 El eclipse de sobremesa** — Dos discos cruzan un foco junto a Guillermo; la sombra recorre la mesa y se retira al separarse.
- **00206 El cohete de confeti** — Un cohete de juguete despega en una vitrina junto a Guillermo; abre un paracaídas y vuelve a su plataforma.
- **00207 La constelación pendiente** — Estrellas se iluminan detrás de Guillermo; una tarda en llegar y completa el último segmento de la figura.
- **00208 El meteorito esponja** — Una esponja con forma de meteorito cae sobre una colchoneta ante Guillermo; rebota y aterriza en su caja.
- **00209 La luna giratoria** — Una luna de maqueta muestra fases al girar su lámpara junto a Guillermo; termina con el disco oscuro.
- **00210 El ascensor orbital** — Una cápsula sube por un cable detrás de Guillermo; llega a una estación y deja caer una bandera pequeña.
- **00211 El satélite camarero** — Un satélite de utilería lleva una taza por un raíl junto a Guillermo; la deposita en una estación marcada.
- **00212 El jardín marciano** — Flores de papel brotan en un planeta rojo junto a Guillermo; un pequeño regador automático pasa entre ellas.
- **00213 La lluvia de estrellas lentas** — Estrellas de papel descienden con paracaídas alrededor de Guillermo; todas aterrizan fuera de su peana.
- **00214 El planeta transparente** — Un globo transparente gira frente a Guillermo; una pequeña luz interior explica sus reflejos y su sombra.
- **00215 La sonda curiosa** — Una sonda de juguete examina una croqueta junto a Guillermo; proyecta su contorno y levanta una bandera de aprobado.
- **00216 El anillo descentrado** — Un anillo oscila alrededor de un planeta junto a Guillermo; dos guías visibles lo centran progresivamente.
- **00217 El túnel estelar** — Anillos de luz se encienden detrás de Guillermo; se apagan del fondo hacia delante sin mover al protagonista.
- **00218 La cuenta atrás distraída** — Un panel cuenta atrás junto a Guillermo; al llegar a cero despega un cohete minúsculo en lugar del grande.
- **00219 El reloj de planetas** — Planetas recorren círculos frente a Guillermo; uno completa su vuelta y acciona una campana de estrella.
- **00220 El cometa recogemigas** — Un cometa mecánico cruza la mesa de Guillermo; recoge migas con una red y las deposita en un cuenco.
- **00221 La luna con ascensor** — Una luna se abre como un decorado junto a Guillermo; una plataforma saca una estrella y se vuelve a cerrar.
- **00222 El aparcamiento espacial** — Cápsulas se alinean entre Guillermo y Paradigma; cada una ocupa un hueco sin invadir el de la siguiente.
- **00223 El planeta de pompas** — Pompas rodean una esfera junto a Guillermo; una se desprende, completa una vuelta y estalla lejos de su cara.
- **00224 La última estrella del bar** — El planetario se apaga detrás de Guillermo; queda una estrella encima de la salida y también se apaga.

## Escalas y miniaturas

- **00225 La taza rascacielos** — Guillermo aparece junto a una maqueta de taza gigante; un ascensor exterior lleva una galleta hasta el borde.
- **00226 El puente de cucharilla** — Una cucharilla forma un puente frente a Guillermo; un carrito diminuto cruza por encima y aparca al final.
- **00227 La ciudad de cubitos** — Cubitos construyen edificios en una bandeja junto a Guillermo; una luz se enciende en cada ventana dibujada.
- **00228 El tren de migas** — Un tren diminuto pasa delante de Guillermo; sus vagones llevan migas y el último una servilleta doblada.
- **00229 La escalera del vaso** — Una escalera rodea un vaso en la maqueta de Guillermo; una pelota sube por ella hasta una pequeña plataforma.
- **00230 La biblioteca de menús** — Menús diminutos se ordenan en una estantería junto a Guillermo; el mayor se abre como puerta de la biblioteca.
- **00231 El puerto de tapones** — Tapones hacen de barcos en un puerto de maqueta junto a Guillermo; una compuerta sube para dejarlos pasar.
- **00232 La maleta minúscula** — Una maleta pequeña se abre sobre un pedestal junto a Guillermo; dentro sale una mesa todavía más pequeña.
- **00233 El bosque de palillos** — Palillos con copas de papel forman un bosque frente a Guillermo; una luz recorre un camino entre los troncos.
- **00234 La fábrica de dados** — Dados de juguete avanzan por una fábrica junto a Guillermo; un rodillo les imprime puntos en las caras visibles.
- **00235 El castillo de azúcar** — Terrones forman un castillo ante Guillermo; un puente levadizo baja para una gota de chocolate.
- **00236 La grúa de bolsillo** — Una grúa diminuta levanta una aceituna junto a Guillermo; el contrapeso visible evita que la base vuelque.
- **00237 La rueda microscópica** — Una rueda diminuta aparece ampliada en un monitor junto a Guillermo; su giro mueve una enorme flecha de utilería.
- **00238 El mapa plegado** — Un mapa se despliega sobre la mesa de Guillermo; edificios de papel se levantan siguiendo sus pliegues.
- **00239 La lupa del bar** — Una lupa recorre una maqueta de barra junto a Guillermo; muestra a escala cada objeto sin cambiar lo que queda fuera.
- **00240 El ascensor de bolsillo** — Un ascensor pequeño sube por una botella junto a Guillermo; entrega un tapón en la planta superior.
- **00241 La pista en una caja** — Una caja se abre delante de Guillermo; una pista de canicas se despliega y devuelve la bola al inicio.
- **00242 El puente de galletas** — Galletas levantan un puente de maqueta junto a Guillermo; una cucharilla pasa por debajo sin rozarlas.
- **00243 La playa del plato** — Un plato contiene una playa de juguete ante Guillermo; una ola de gel transparente llega y se retira.
- **00244 La noria en una taza** — Una noria diminuta gira dentro de una taza junto a Guillermo; la cámara encuadra ambos para conservar la escala.
- **00245 El elevador de migas** — Una cinta recoge migas en la mesa de Guillermo; las eleva y las deja en un contenedor minúsculo.
- **00246 La plaza de posavasos** — Posavasos forman una plaza de maqueta junto a Guillermo; farolas pequeñas se encienden alrededor.
- **00247 El faro de dedal** — Un dedal hace de faro ante Guillermo; una luz interior gira y guía un barco de papel.
- **00248 La caja dentro de la caja** — Guillermo observa tres cajas encajadas; la última se abre y contiene una sola estrella de papel.
- **00249 La gran inauguración pequeña** — Una cinta se corta mediante tijeras mecánicas en la maqueta de Guillermo; se inaugura una puerta diminuta con confeti.

## Jardín y animales de juguete

- **00250 La flor con timbre** — Una flor de papel abre sus pétalos junto a Guillermo; una abeja de juguete toca un timbre y entra al centro.
- **00251 El caracol mensajero** — Un caracol de juguete cruza la mesa de Guillermo; entrega un cartel y se retira siguiendo su huella.
- **00252 La maceta elevadora** — Una maceta sube desde debajo del escenario junto a Guillermo; una flor abre justo al llegar al tope.
- **00253 El pájaro equilibrista** — Un pájaro de juguete se posa en una rama junto a Guillermo; la rama oscila y vuelve al equilibrio.
- **00254 La mariposa de servilleta** — Una servilleta plegada mueve sus alas frente a Guillermo; sigue un hilo visible hasta posarse en una flor.
- **00255 El cactus educado** — Un cactus de goma se aparta mediante su base giratoria cuando pasa el vaso de Guillermo; vuelve después a su posición.
- **00256 La regadera precisa** — Una regadera automática riega tres macetas junto a Guillermo; deja de verter antes de moverse entre ellas.
- **00257 El pez de cristal** — Un pez de juguete nada dentro de una pecera junto a Guillermo; sus burbujas suben y estallan en la superficie.
- **00258 La hormiga de cuerda** — Una hormiga mecánica empuja una miga frente a Guillermo; otra abre la puerta del pequeño hormiguero.
- **00259 El girasol de foco** — Un girasol de papel sigue una lámpara junto a Guillermo; se detiene cuando el foco ilumina al protagonista.
- **00260 La tortuga ascensor** — Una tortuga de juguete llega a una escalera junto a Guillermo; un elevador lateral la sube sin hacerla saltar.
- **00261 La enredadera de luces** — Una enredadera luminosa asciende por un enrejado detrás de Guillermo; se detiene antes de tapar su silueta.
- **00262 El pato de charco** — Un pato de goma cruza un charco de maqueta ante Guillermo; una compuerta lo devuelve por otro canal.
- **00263 El nido de corcho** — Corchos forman un nido junto a Guillermo; un pájaro de juguete coloca una última ramita en el borde.
- **00264 La seta paraguas** — Una seta de papel se abre junto a Guillermo; protege una flor pequeña de unas gotas de escenario.
- **00265 El grillo director** — Un grillo mecánico mueve una batuta ante Guillermo; las hojas del fondo responden con un movimiento sincronizado.
- **00266 El conejo jardinero** — Un conejo de juguete lleva semillas por una cinta junto a Guillermo; pequeños brotes aparecen detrás siguiendo el recorrido.
- **00267 La flor nocturna** — Una flor permanece cerrada junto a Guillermo; al apagarse el sol de decorado se abre bajo la luna.
- **00268 El estanque de estrellas** — Estrellas de luz se reflejan en un estanque junto a Guillermo; un pez de juguete crea ondas que luego se disipan.
- **00269 El árbol de cucharas** — Un árbol de utilería tiene cucharas por hojas junto a Guillermo; el viento las hace tintinear sin desprenderlas.
- **00270 La abeja aparcada** — Una abeja de juguete busca hueco entre flores frente a Guillermo; aterriza en la que acaba de abrirse.
- **00271 La hoja viajera** — Una hoja cae desde un árbol de decorado junto a Guillermo; termina en un libro abierto sobre una mesa.
- **00272 El pájaro y el eco** — Un pájaro mecánico abre el pico junto a Guillermo; un pájaro menor responde desde otra rama con luz.
- **00273 El jardín de sombras** — Plantas de papel proyectan sombras detrás de Guillermo y Laura; al bajar la lámpara las sombras crecen de forma coherente.
- **00274 La semilla puntual** — Una semilla cae en una maceta junto a Guillermo; un mecanismo eleva lentamente una flor desde el mismo punto.

## Agua y playa de maqueta

- **00275 La ola en una bandeja** — Una ola de utilería cruza una bandeja frente a Guillermo; se retira dejando una concha en la orilla.
- **00276 El barquito indeciso** — Un barco de papel llega a una bifurcación junto a Guillermo; una compuerta abre el canal marcado con una estrella.
- **00277 La boya con campana** — Una boya oscila en una maqueta junto a Guillermo; cada ola mueve su campana y la calma la detiene.
- **00278 El faro bajo el vaso** — Un vaso invertido cubre un faro diminuto ante Guillermo; el cristal deja ver el giro de la luz.
- **00279 La cascada escalonada** — Agua de escenario baja por tres cuencos junto a Guillermo; una bomba visible devuelve el caudal al primero.
- **00280 El flotador aparcado** — Un flotador recorre un canal delante de Guillermo; se engancha suavemente en un poste de su tamaño.
- **00281 La concha desplegable** — Una concha de utilería se abre junto a Guillermo; muestra una perla de luz y se cierra al apagarse.
- **00282 El puente del charco** — Un puente sube frente a Guillermo para dejar pasar un barco de papel; baja antes de que cruce un carrito.
- **00283 La fuente con paraguas** — Una fuente lanza un arco de agua junto a Guillermo; un paraguas mecánico lo desvía hacia el depósito.
- **00284 El cubo con ventanas** — Un cubo transparente se llena frente a Guillermo; el nivel sube de forma continua y levanta un pequeño flotador.
- **00285 La medusa de papel** — Una medusa de papel baja por un hilo junto a Guillermo; sus cintas se balancean y se recogen al subir.
- **00286 El velero de servilleta** — Un velero usa una servilleta como vela ante Guillermo; un ventilador lo conduce hasta un muelle.
- **00287 La ola que saluda** — Una ola de cartón se eleva detrás de Guillermo; una mano de espuma de utilería aparece y vuelve a ocultarse.
- **00288 El ancla pequeña** — Un ancla de juguete baja junto al barco de maqueta de Guillermo; toca el fondo antes de tensar su cuerda.
- **00289 La cascada de canicas** — Canicas azules imitan una cascada frente a Guillermo; caen por canales cerrados y se acumulan en un cuenco.
- **00290 El submarino de corcho** — Un submarino de juguete desciende en una pecera junto a Guillermo; sus burbujas muestran el camino de vuelta.
- **00291 La playa plegable** — Una maqueta de playa se despliega delante de Guillermo; una sombrilla se abre al quedar horizontal.
- **00292 El salvavidas mensajero** — Un salvavidas de juguete lleva una nota por un canal junto a Guillermo; la entrega en un muelle y sigue vacío.
- **00293 El molino de agua pequeño** — Una corriente mueve un molino frente a Guillermo; una rueda dentada eleva una bandera en la orilla.
- **00294 La perla rodante** — Una perla sale de una concha ante Guillermo; rueda por una rampa y encaja en otra concha abierta.
- **00295 El pato submarino** — Un pato de goma desaparece detrás de una ola opaca junto a Guillermo; reaparece por el mismo canal con continuidad.
- **00296 La burbuja ascensor** — Una burbuja de utilería lleva una estrella de papel junto a Guillermo; sube por una guía y se abre arriba.
- **00297 El túnel acuático** — Un barco atraviesa un túnel transparente frente a Guillermo; se ve todo su recorrido hasta salir al otro lado.
- **00298 La isla del vaso** — Una isla de maqueta emerge dentro de un vaso ancho junto a Guillermo; una palmera se abre al terminar de subir.
- **00299 La marea de despedida** — La marea se retira en la maqueta junto a Guillermo y Rodri; deja escrito hasta luego con pequeñas piedras.

## Taller, reparto y construcción

- **00300 El paquete ascensor** — Un paquete sube por un elevador junto a Guillermo; al abrirse contiene el botón que faltaba en el panel.
- **00301 La cinta con saludo** — Una cinta transportadora pasa delante de Guillermo; cada caja abre una solapa hasta formar un saludo completo.
- **00302 El tornillo bailarín** — Un tornillo gira en su tuerca frente a Guillermo; avanza hasta fijar una pequeña bandera al soporte.
- **00303 La carretilla diminuta** — Una carretilla de juguete llega junto a Guillermo; descarga una miga y vuelve por el mismo pasillo.
- **00304 El puente de cajas** — Cajas forman un arco junto a Guillermo; una plataforma lo atraviesa y las cajas se recogen desde los extremos.
- **00305 La grúa de la servilleta** — Una grúa deposita una servilleta frente a Guillermo; abre la pinza antes de elevarse y deja el objeto quieto.
- **00306 El rodillo de estrellas** — Un rodillo pinta estrellas en una pared de utilería junto a Guillermo; termina en una franja limpia y se recoge.
- **00307 El cajón clasificador** — Un cajón recibe piezas ante Guillermo; separadores móviles las ordenan sin que ninguna atraviese otra.
- **00308 La escalera plegada** — Una escalera se despliega detrás de Guillermo; una luz asciende peldaño a peldaño y la escalera vuelve a plegarse.
- **00309 El sello saltarín** — Un sello mecánico marca cajas delante de Guillermo; la última marca es una sonrisa en una caja diminuta.
- **00310 El carrete puntual** — Un carrete desenrolla una cinta junto a Guillermo; se detiene justo cuando alcanza una marca del suelo.
- **00311 La polea de regalos** — Una polea entrega una caja a la peana de Guillermo; la caja abre un lazo de papel y revela una estrella.
- **00312 El camión de corchos** — Un camión de juguete descarga corchos ante Guillermo; la rampa baja antes de que rueden y sube después.
- **00313 La puerta enrollable** — Una puerta de taller se abre detrás de Guillermo; sale un robot de juguete que lleva una flor.
- **00314 El martillo de goma** — Un martillo mecánico encaja tacos frente a Guillermo; el último taco acciona una campana de celebración.
- **00315 La caja con ruedas** — Una caja monta sus ruedas mediante soportes visibles junto a Guillermo; avanza por un raíl hasta su plaza.
- **00316 El nivel satisfecho** — Un nivel sobre una mesa de utilería junto a Guillermo centra su burbuja cuando las patas terminan de ajustarse.
- **00317 La viga giratoria** — Una grúa gira una viga por encima de una maqueta junto a Guillermo; la baja únicamente al quedar alineada.
- **00318 El transportador de luz** — Una cinta lleva bombillas apagadas delante de Guillermo; una estación las enciende y otra las coloca en un cartel.
- **00319 El taladro de papel** — Una perforadora de utilería hace círculos en una cinta junto a Guillermo; los recortes caen formando confeti.
- **00320 La llave del cajón** — Una llave grande gira en una cerradura de maqueta ante Guillermo; abre un cajón donde está una llave diminuta.
- **00321 El elevador sincronizado** — Dos elevadores entre Guillermo y Marta suben cajas alternadamente; terminan al mismo nivel con una pasarela común.
- **00322 La estantería plegable** — Una estantería se abre junto a Guillermo; sus baldas reciben objetos en orden de abajo arriba.
- **00323 El robot barrendero** — Un robot de juguete recoge confeti alrededor de la peana de Guillermo; deja una estrella sin recoger como remate.
- **00324 El cartel recién pintado** — Un rodillo termina un cartel detrás de Guillermo; una luz lateral revela el brillo húmedo antes del apagado.

## Fotografía y arte

- **00325 El marco viajero** — Un marco se desliza delante de Guillermo; se detiene sin taparle la cara y enciende un contorno de luz.
- **00326 La foto con persiana** — Una persiana revela por franjas un retrato original de Guillermo; todas las franjas se alinean antes de volver a cerrarse.
- **00327 El caballete giratorio** — Un caballete gira junto a Guillermo; muestra primero el reverso y después una composición de objetos de la escena.
- **00328 La cámara de cartón** — Una cámara de utilería frente a Guillermo abre su fuelle; una tarjeta sale por debajo mostrando el mismo encuadre.
- **00329 El pincel de estrellas** — Un pincel mecánico dibuja estrellas en un lienzo junto a Guillermo; vuelve al bote dejando una estrella mayor al final.
- **00330 La galería ascensor** — Cuadros suben por guías alrededor de Guillermo; el marco central queda vacío para encuadrarlo a él.
- **00331 El retrato con luz** — Un foco recorre un retrato original de Guillermo en una galería; al llegar al centro ilumina también al avatar del escenario.
- **00332 La polaroid en la cuerda** — Una foto original de Guillermo llega por una pinza sobre un cable; se detiene junto a otras fotos de objetos del bar.
- **00333 El lienzo desplegable** — Un lienzo se despliega detrás de Guillermo; formas geométricas completan un paisaje antes de que se vuelva a enrollar.
- **00334 La paleta giratoria** — Una paleta gira junto a Guillermo; tres pinceles automáticos trazan círculos que no se superponen sobre su figura.
- **00335 El mosaico de tapas** — Tapas de colores forman un mosaico frente a Guillermo; una última pieza llena el hueco del centro.
- **00336 La cámara con acordeón** — El fuelle de una cámara se estira ante Guillermo; enfoca una maqueta y se recoge después del destello.
- **00337 El expositor de recuerdos** — Tarjetas con objetos del escenario giran junto a Guillermo; se detienen en la que muestra la escena actual.
- **00338 La firma luminosa** — Un trazador escribe Guillermo Aladro detrás del avatar; sigue un recorrido continuo y apaga la punta al terminar.
- **00339 El marco que respira** — Un marco mecánico amplía sus lados alrededor de Guillermo; mantiene las esquinas unidas y vuelve a su tamaño inicial.
- **00340 La escultura de cucharas** — Cucharas se colocan en un soporte junto a Guillermo; forman una flor metálica y reflejan el foco al girar.
- **00341 El carrete de recuerdos** — Una película de utilería avanza ante Guillermo; sus fotogramas muestran acciones ya vistas de la misma escena.
- **00342 La postal plegada** — Una postal se abre junto a Guillermo; levanta un paisaje de papel y lo pliega en orden al cerrarse.
- **00343 El foco del retrato** — Tres focos iluminan sucesivamente a Guillermo; cada luz cambia la sombra del suelo sin modificar el avatar.
- **00344 La imprenta diminuta** — Una imprenta de juguete produce carteles junto a Guillermo; el último lleva el título de la animación.
- **00345 El dibujo de arena** — Un dosificador dibuja una estrella en una bandeja frente a Guillermo; una escobilla la borra con un barrido continuo.
- **00346 La vitrina inesperada** — Una vitrina se ilumina junto a Guillermo; contiene una aceituna presentada como si fuera una escultura monumental.
- **00347 El tríptico giratorio** — Tres paneles rodean a Guillermo sin ocultarlo; al alinearse forman un único paisaje de fondo.
- **00348 La fotografía compartida** — Un marco encuadra a Guillermo y Laura; una cuenta atrás culmina en un destello y una copia del mismo encuadre.
- **00349 El museo cierra** — Luces de una galería se apagan detrás de Guillermo; la última ilumina un cartel de hasta pronto y se extingue.

## Tiempo y gravedad de escenario

- **00350 El reloj de posavasos** — Posavasos forman un reloj alrededor de Guillermo; una aguja da una vuelta y todos regresan a su pila.
- **00351 La arena ascendente** — Un reloj de arena de utilería se invierte junto a Guillermo; los granos vuelven a caer hacia abajo en su nueva posición.
- **00352 El péndulo de la tapa** — Un péndulo transporta una tapa frente a Guillermo; un soporte la recibe cuando el péndulo pasa por el centro.
- **00353 El minuto elástico** — Un contador parece avanzar despacio junto a Guillermo; se revela una rueda dentada grande moviendo la aguja pequeña.
- **00354 La pausa del confeti** — Confeti unido a hilos se detiene alrededor de Guillermo; los hilos se aflojan y las piezas siguen descendiendo.
- **00355 El reloj con ventanas** — Un reloj abre ventanitas frente a Guillermo; cada una muestra un objeto distinto y la última un pequeño sol.
- **00356 La canica reversible** — Una canica baja por una pista junto a Guillermo; la pista se inclina al revés y la canica regresa por gravedad.
- **00357 El ascensor del tiempo** — La plataforma de Guillermo sube junto a números de un reloj; se detiene en doce y baja hasta el inicio.
- **00358 La sombra acelerada** — Una lámpara recorre rápidamente un arco sobre Guillermo; su sombra cambia de posición siguiendo la fuente de luz.
- **00359 El segundo perdido** — Un engranaje de reloj salta una muesca junto a Guillermo; una leva visible lo recoloca y recupera el ritmo.
- **00360 La pelota en cámara lenta** — Una pelota suspendida baja despacio junto a Guillermo; el cable visible la lleva hasta una cesta acolchada.
- **00361 El despertador de flores** — Un despertador mecánico abre una flor junto a Guillermo; sus pétalos se cierran cuando termina la vibración.
- **00362 La cuenta atrás de tapas** — Cinco tapas numeradas pasan frente a Guillermo; al llegar a cero se abre una campana con una tapa diminuta.
- **00363 El reloj girado** — Un reloj gira sobre su soporte junto a Guillermo; la esfera se mantiene legible mediante un contrapeso visible.
- **00364 La hora de la burbuja** — Una burbuja recorre una espiral frente a Guillermo; al llegar al centro acciona el cambio de una cifra.
- **00365 El péndulo doble** — Dos péndulos oscilan entre Guillermo y Yorgi; terminan sincronizados después de acoplarse mediante un resorte.
- **00366 La escalera descendente** — Peldaños mecánicos bajan bajo la plataforma de Guillermo; la plataforma permanece horizontal durante todo el trayecto.
- **00367 La rueda de estaciones** — Un disco de decorados gira detrás de Guillermo; primavera, verano, otoño e invierno pasan sin cambiar su ropa.
- **00368 El reloj de gotas** — Gotas llenan un pequeño depósito junto a Guillermo; al alcanzar una marca el depósito bascula y reinicia el ciclo.
- **00369 El muelle con paciencia** — Un muelle tarda en extenderse frente a Guillermo; al llegar al final abre un cartel que dice ya era hora.
- **00370 La piedra ligera** — Una piedra de utilería sube junto a Guillermo; un contrapeso y una polea visibles explican el movimiento.
- **00371 El día en un marco** — Un marco detrás de Guillermo muestra el sol y después la luna mediante discos móviles; ambos siguen el mismo arco.
- **00372 La última vuelta** — Una rueda pierde velocidad frente a Guillermo; su última vuelta deja una estrella alineada con un indicador.
- **00373 El reloj de la barra** — Un reloj de juguete abre una puerta junto a Guillermo; sale una taza en vez de un pájaro y vuelve a entrar.
- **00374 El tiempo en una caja** — Una caja transparente junto a Guillermo contiene varios relojes; se paran uno a uno hasta quedar completamente oscura.

## Escenas de compañía

- **00375 Las plataformas corteses** — Las plataformas de Guillermo y Marta se cruzan a distinta profundidad; las sombras y la escala dejan claro quién pasa delante.
- **00376 El puente compartido** — Guillermo y Rodri están en extremos de un puente; dos tramos se extienden hasta unirse en el centro.
- **00377 La foto descentrada** — Un marco intenta encuadrar a Guillermo y Carla; se ensancha hasta incluirlos sin recortar sus cabezas.
- **00378 El ascensor doble** — Guillermo y Laura suben en plataformas paralelas; una llega antes y espera a la otra para abrir el telón.
- **00379 La mesa repartidora** — Una mesa gira entre Guillermo y Yorgi; entrega a cada lado un vaso idéntico y se detiene centrada.
- **00380 Las luces coordinadas** — Focos separados siguen a Guillermo y Paradigma; sus haces convergen sobre una estrella situada entre ambos.
- **00381 El paquete compartido** — Un paquete llega entre Guillermo y Gabacho; sus dos tapas se abren y muestran dos recuerdos iguales.
- **00382 La cinta del encuentro** — Dos cintas llevan las plataformas de Guillermo y Sara hacia el centro; frenan antes de juntarse y encienden un marco.
- **00383 El puzzle de dos lados** — Piezas llegan desde ambos lados entre Guillermo y Marta; completan un dibujo de una barra sin solaparse.
- **00384 La campana de relevo** — Una bola toca una campana junto a Guillermo; viaja por un tubo y toca otra junto a Rodri.
- **00385 Las ventanas vecinas** — Dos ventanas se abren detrás de Guillermo y Laura; una guirnalda se despliega entre ellas.
- **00386 El regalo equilibrado** — Una balanza entre Guillermo y Carla sostiene dos cajas; cada caja abre una flor del mismo tamaño.
- **00387 El farol compartido** — Un farol se sitúa entre Guillermo y Yorgi; amplía su pantalla hasta iluminar a ambos por igual.
- **00388 Los caminos de papel** — Dos caminos se despliegan bajo las plataformas de Guillermo y Paradigma; se unen en una plaza central.
- **00389 La rueda de saludos** — Un decorado giratorio reúne a Guillermo, Marta y Laura; cada sección se ilumina por turno y después todas juntas.
- **00390 El tren de los amigos** — Guillermo y Rodri aparecen sobre dos vagones de escenario; los vagones se acoplan suavemente antes de avanzar.
- **00391 El arco entre plataformas** — Piezas de un arco se elevan entre Guillermo y Gabacho; la pieza central cierra la estructura sin ocultarlos.
- **00392 La lluvia bien repartida** — Paraguas de utilería protegen a Guillermo y Sara; una canaleta lleva el agua hasta una maceta central.
- **00393 Los cuadros gemelos** — Marcos móviles encuadran a Guillermo y Carla; una foto conjunta final muestra exactamente sus posiciones.
- **00394 La mesa desplegable** — Una mesa se extiende entre Guillermo y Laura; las patas se abren antes de que una bandeja aterrice encima.
- **00395 La estrella de relevo** — Una estrella luminosa viaja por una guía entre Guillermo y Marta; hace una pausa junto a cada uno y vuelve al centro.
- **00396 El laberinto compartido** — Dos compuertas entre Guillermo y Rodri abren turnos a una canica; la conducen hasta la salida central.
- **00397 Los ascensores cruzados** — Plataformas de Guillermo y Yorgi intercambian alturas por carriles separados; se mantienen visibles y sin colisiones.
- **00398 El telón de tres** — Tres hojas de telón revelan a Guillermo, Laura y Marta; se recogen dejando un único escenario compartido.
- **00399 La despedida en luces** — Guillermo y el grupo permanecen reconocibles mientras sus focos se apagan por turnos; el último foco es el de Guillermo.

## Viajes en decorados

- **00400 La estación de maletas** — Una maleta viaja por una cinta frente a Guillermo; se abre y despliega un mapa de papel.
- **00401 El tren de sobremesa** — Un tren de juguete cruza un decorado junto a Guillermo; el último vagón lleva el cartel de estación final.
- **00402 La montaña plegable** — Montañas de papel se despliegan detrás de Guillermo; un pequeño teleférico cruza entre dos cimas por su cable.
- **00403 El globo de escenario** — La plataforma de Guillermo se eleva bajo un globo de utilería; cuerdas tensas y sombras mantienen la relación entre ambos.
- **00404 El faro del muelle** — Guillermo aparece en una peana con forma de muelle; un faro guía un barco de juguete hasta el extremo.
- **00405 La escalera del hotel** — Una maqueta de hotel se ilumina junto a Guillermo; una maleta sube por su ascensor y llega a una puerta.
- **00406 El mapa con caminos** — Líneas de luz recorren un mapa delante de Guillermo; convergen en un pequeño dibujo de la máquina.
- **00407 La ventanilla del paisaje** — Una ventana junto a Guillermo muestra un paisaje que pasa; los elementos cercanos se desplazan más rápido que los lejanos.
- **00408 El teleférico de tapas** — Una cabina de juguete cruza por encima de una maqueta junto a Guillermo; descarga una tapa en la estación.
- **00409 La isla desplegable** — Una maleta se abre frente a Guillermo; una isla de papel sube y una palmera se despliega al final.
- **00410 El túnel de equipajes** — Maletas pequeñas entran en un túnel transparente junto a Guillermo; salen en el mismo orden por una curva visible.
- **00411 La postal de la montaña** — Una postal junto a Guillermo muestra montañas en capas; un foco lateral revela su profundidad sin mover el avatar.
- **00412 El puente del viaje** — Un puente de maqueta gira delante de Guillermo; se alinea con dos vías antes de permitir que pase un tren.
- **00413 La estación de estrellas** — Un pequeño tren llega entre Guillermo y Laura; sus pasajeros son estrellas de papel que bajan por una rampa.
- **00414 La brújula del camino** — Una brújula de escenario gira junto a Guillermo; una flecha luminosa indica la salida correcta del decorado.
- **00415 El puerto de maletas** — Maletas hacen de edificios en una maqueta junto a Guillermo; un barco de papel atraca entre dos de ellas.
- **00416 La cinta de recuerdos** — Objetos de viaje pasan por una cinta ante Guillermo; cada uno se detiene brevemente bajo un foco.
- **00417 El mirador giratorio** — La peana de Guillermo gira sin deformarlo; el paisaje del fondo permanece fijo y una barandilla pasa por delante.
- **00418 El billete plegable** — Un billete genérico se abre junto a Guillermo; se convierte en una maqueta de tren sin mostrar marcas reales.
- **00419 La estación lluviosa** — Un toldo de estación protege a Guillermo; gotas bajan por el canalón hasta una maceta lateral.
- **00420 El funicular preciso** — Un funicular de juguete sube una pendiente junto a Guillermo; el vagón se mantiene nivelado al cambiar la inclinación.
- **00421 El camino de linternas** — Linternas se encienden en profundidad detrás de Guillermo; la más lejana se apaga primero al terminar.
- **00422 La maleta con ascensor** — Una maleta frente a Guillermo abre un ascensor interior; sube una pequeña cámara de juguete y vuelve a bajar.
- **00423 La parada inesperada** — Un tren diminuto se detiene delante de Guillermo; baja una sola aceituna por una rampa de equipaje.
- **00424 El regreso a la barra** — Un decorado de viaje se recoge detrás de Guillermo; queda una pequeña barra que se ilumina antes del negro.

## Deportes de juguete y precisión

- **00425 La canasta de posavasos** — Una pelota de espuma sigue un arco junto a Guillermo; entra en una canasta y cae a una bandeja inferior.
- **00426 El penalti mecánico** — Un pie de juguete impulsa un balón delante de Guillermo; un portero de cartón se aparta por una guía visible.
- **00427 La pista de curling** — Una ficha se desliza por una pista frente a Guillermo; roza otra y ambas quedan dentro del círculo central.
- **00428 El salto del resorte** — Un muelle lanza una pelota por encima de una barra junto a Guillermo; aterriza en una colchoneta detrás.
- **00429 La bolera diminuta** — Una bola recorre una pista delante de Guillermo; derriba bolos de juguete que caen hacia el fondo.
- **00430 El aro del rugby** — Un balón ovalado gira en un soporte junto a Guillermo; un brazo mecánico lo lanza entre dos postes de maqueta.
- **00431 La mesa de ping pong** — Dos palas mecánicas intercambian una pelota delante de Guillermo; la última queda en una pequeña cesta central.
- **00432 El circuito de chapas** — Chapas avanzan por una pista junto a Guillermo; una curva peraltada las mantiene dentro hasta la meta.
- **00433 El trampolín de espuma** — Una pelota rebota en una superficie elástica frente a Guillermo; pierde altura en cada bote y queda quieta.
- **00434 La red recogepelotas** — Una red recibe pelotas junto a Guillermo; las guía por un canal hasta un único cajón.
- **00435 El relevo de la canica** — Una canica pasa de una cinta a otra delante de Guillermo; conserva su velocidad al cruzar la unión.
- **00436 El marcador giratorio** — Un marcador deportivo cambia junto a Guillermo; cada punto corresponde a una bola que entra en una cesta visible.
- **00437 La pista inclinable** — Una pista se inclina delante de Guillermo; una pelota rueda hasta el aro y se frena con una banda de goma.
- **00438 El podium ascendente** — La plataforma central de Guillermo sube entre dos peanas vacías; una guirnalda se despliega por detrás.
- **00439 La portería telescópica** — Una portería se extiende junto a Guillermo; un balón de juguete cruza solo después de quedar abierta.
- **00440 El disco deslizante** — Un disco recorre una pista delante de Guillermo; rebota en topes visibles antes de caer en la ranura final.
- **00441 La pelota con túnel** — Una pelota pasa por un túnel transparente junto a Guillermo; sale alineada con una pequeña portería.
- **00442 El circuito de obstáculos** — Un carrito deportivo de juguete cruza rampas ante Guillermo; cada puente baja antes de que llegue.
- **00443 La raqueta automática** — Una raqueta en un soporte golpea una pelota junto a Guillermo; la pelota vuelve tras rebotar en una pared de maqueta.
- **00444 El salto de la ficha** — Una ficha atraviesa un aro frente a Guillermo; gira una vuelta completa y aterriza con la misma cara hacia arriba.
- **00445 La meta paciente** — Una cinta de meta espera a un caracol de juguete junto a Guillermo; se abre solo cuando el caracol llega.
- **00446 El balancín de pelotas** — Pelotas de distintos tamaños equilibran una balanza ante Guillermo; la última se coloca en el brazo más largo.
- **00447 El pase por la rampa** — Un balón baja por una rampa entre Guillermo y Rodri; una curva lo conduce hasta una cesta al otro lado.
- **00448 El trofeo ascensor** — Un trofeo sube desde una caja junto a Guillermo; se ilumina al llegar al tope y vuelve a guardarse.
- **00449 La vuelta de honor pequeña** — Un carrito con una estrella completa una pista ante Guillermo; se detiene en la misma marca desde la que salió.

## Letras, señales y cifras

- **00450 Las letras en el ascensor** — Las letras de HOLA suben por guías junto a Guillermo; se alinean y bajan en orden inverso.
- **00451 El punto fugitivo** — El punto de un signo de exclamación rueda frente a Guillermo; una rampa lo devuelve a su posición.
- **00452 La flecha telescópica** — Una flecha se extiende hacia Guillermo; se retrae para señalar una estrella que aparece a su lado.
- **00453 El cartel reversible** — Un cartel gira detrás de Guillermo; cada lado muestra una palabra distinta sin letras reflejadas.
- **00454 El alfabeto de fichas** — Fichas con letras se ordenan frente a Guillermo; forman su nombre y se recogen una a una.
- **00455 La cifra con ascensor** — Segmentos de un número suben por guías junto a Guillermo; forman una cuenta atrás antes de apagarse.
- **00456 El bocadillo vacío** — Un bocadillo aparece al lado de Guillermo; letras llegan por una cinta y completan un saludo breve.
- **00457 La señal despistada** — Una señal gira varias veces junto a Guillermo; un tope la deja apuntando hacia una puerta iluminada.
- **00458 El interrogante curioso** — Un interrogante de utilería se despliega frente a Guillermo; su punto se enciende al aparecer la respuesta en un panel.
- **00459 El texto en persiana** — Una persiana revela el título de la escena junto a Guillermo; todas las líneas conservan su posición al abrirse.
- **00460 Las vocales rodantes** — Vocales de juguete ruedan por una pista ante Guillermo; terminan en huecos con sus formas correspondientes.
- **00461 El cartel de bolsillo** — Un cartel enorme se pliega junto a Guillermo; se guarda en una caja pequeña mediante bisagras visibles.
- **00462 El número de burbujas** — Burbujas forman un número junto a Guillermo; se rompen en orden y queda un punto luminoso.
- **00463 La palabra puente** — Letras grandes forman un puente de maqueta frente a Guillermo; una pelota cruza por la línea superior.
- **00464 El sello del saludo** — Un sello imprime HOLA delante de Guillermo; una cinta transporta el papel hasta un pequeño expositor.
- **00465 La flecha en órbita** — Una flecha luminosa recorre un círculo alrededor de Guillermo; se detiene apuntando al título de la escena.
- **00466 La letra que faltaba** — Una palabra queda incompleta junto a Guillermo; la letra ausente llega en un ascensor y ocupa el hueco exacto.
- **00467 El cartel de neón pequeño** — Un cartel enciende letra a letra junto a Guillermo; un cable luminoso muestra cómo llega la corriente.
- **00468 Los puntos en fila** — Puntos de colores se ordenan delante de Guillermo; forman una línea discontinua que lleva hasta una estrella.
- **00469 La señal de pausa** — Dos barras se elevan junto a Guillermo; el mecanismo se detiene y vuelve a moverse al bajar las barras.
- **00470 El texto de sombra** — Letras físicas proyectan una palabra detrás de Guillermo; al girar el foco se comprueba que sigue siendo su sombra.
- **00471 La ventana del número** — Un panel abre una ventana junto a Guillermo; detrás gira una rueda numérica hasta el ID de la animación.
- **00472 La firma en fichas** — Fichas llegan frente a Guillermo; forman ALADRO y una pequeña luz recorre la palabra completa.
- **00473 El título plegado** — Un título se despliega como una tira de papel junto a Guillermo; sus letras no cambian de orientación al quedar plano.
- **00474 El punto final luminoso** — Un texto corto aparece detrás de Guillermo; un punto llega rodando y apaga las letras al colocarse.

## Remates y cierres de escenario

- **00475 El telón que duda** — Un telón baja delante del escenario de Guillermo; se detiene, vuelve a abrirse para una estrella y finalmente se cierra.
- **00476 La caja de la última luz** — Una caja junto a Guillermo recoge pequeñas luces; la última entra y la tapa cierra sobre el resplandor.
- **00477 El barrido de confeti** — Un cepillo mecánico recoge el confeti alrededor de Guillermo; deja el escenario limpio antes del fundido.
- **00478 La puerta de despedida** — Una puerta de utilería se ilumina junto a Guillermo; un cartel de hasta pronto baja y la puerta se cierra.
- **00479 La lámpara con sueño** — Una lámpara articulada inclina su pantalla junto a Guillermo; el haz se hace pequeño hasta apagarse en su base.
- **00480 El aplauso de estrellas** — Estrellas de luz parpadean alrededor de Guillermo; terminan formando un marco que se apaga desde las esquinas.
- **00481 La servilleta final** — Una servilleta cubre una mesa de maqueta junto a Guillermo; el último pliegue deja visible una estrella antes del negro.
- **00482 El cajón del escenario** — Un escenario de juguete se recoge junto a Guillermo; sus decorados bajan por turnos a un cajón inferior.
- **00483 El último pasajero** — Un tren de luces pasa junto a Guillermo; una estrella rezagada sube al último vagón antes de salir.
- **00484 La campana de cierre** — Una campana suena visualmente junto a Guillermo; cada onda apaga una lámpara hasta que queda solo su foco.
- **00485 El foco en miniatura** — El foco de Guillermo se reduce de forma gradual; una lámpara diminuta permanece encendida al lado y cierra el remate.
- **00486 La guirnalda recogida** — Una guirnalda se enrolla detrás de Guillermo; las bombillas se apagan al entrar en el carrete.
- **00487 El pedestal escondido** — La plataforma de Guillermo baja lentamente entre dos paneles; un telón la oculta antes de quedar fuera de cuadro.
- **00488 La caja de ecos** — Anillos de luz vuelven a una caja junto a Guillermo; cada anillo es menor y el último permite cerrar la tapa.
- **00489 La estrella bajo la mesa** — Una estrella cae bajo una mesa junto a Guillermo; un cajón inferior la recoge y se ilumina brevemente.
- **00490 El interruptor tardío** — Las luces se apagan alrededor de Guillermo; una lámpara tarda y un pequeño mecanismo termina pulsando su interruptor.
- **00491 El remate del espejo** — Un espejo muestra el escenario de Guillermo; una cortina tapa el espejo primero y después el escenario real.
- **00492 La última burbuja** — Una burbuja asciende al lado de Guillermo; refleja las luces, llega a un aro y estalla antes del apagado.
- **00493 El arco de despedida** — Un arco luminoso se enciende sobre Guillermo; sus segmentos se recogen hacia los lados y dejan el centro negro.
- **00494 La escalera de luces** — Luces bajan peldaño a peldaño junto a Guillermo; la última ilumina una pequeña puerta que se cierra.
- **00495 El cartel dormido** — Un cartel de utilería junto a Guillermo se pliega sobre su soporte; la luz del suelo baja hasta desaparecer.
- **00496 La cinta del final** — Una cinta recorre el marco del escenario de Guillermo; al completar la vuelta cierra una persiana negra.
- **00497 El adiós de los objetos** — Vaso, servilleta y posavasos se guardan junto a Guillermo; el último objeto es una pequeña estrella con luz.
- **00498 La segunda despedida** — El escenario de Guillermo se apaga; vuelve un foco breve para mostrar una campana diminuta y regresa el negro.
- **00499 La estrella del siguiente pase** — Guillermo queda bajo un foco mientras una estrella señala la siguiente escena; la estrella y el foco se apagan por completo.
