GuillermoAladro/Alcoholimetro/Animaciones-Astra-no-verificadas/revision/00000.jpg

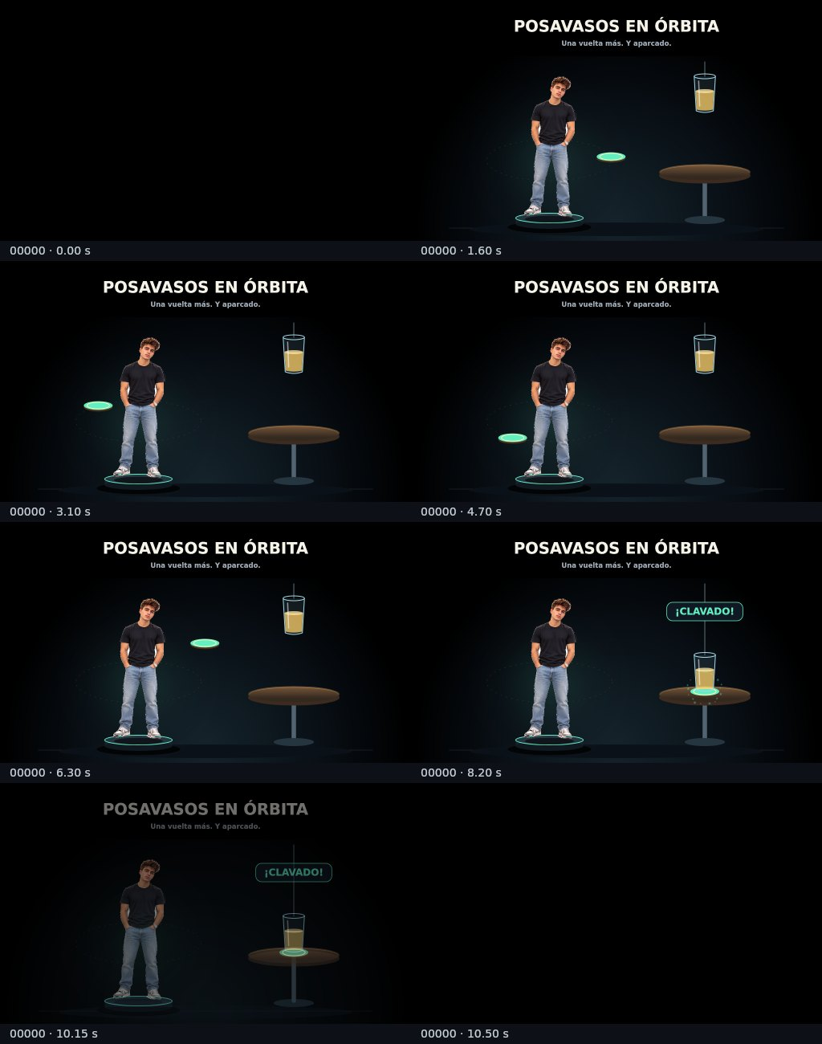
Animaciones-Astra-no-verificadas/revision/00000.jpg
