GuillermoAladro/Alcoholimetro/Animaciones-Astra-no-verificadas/revision/00002.jpg

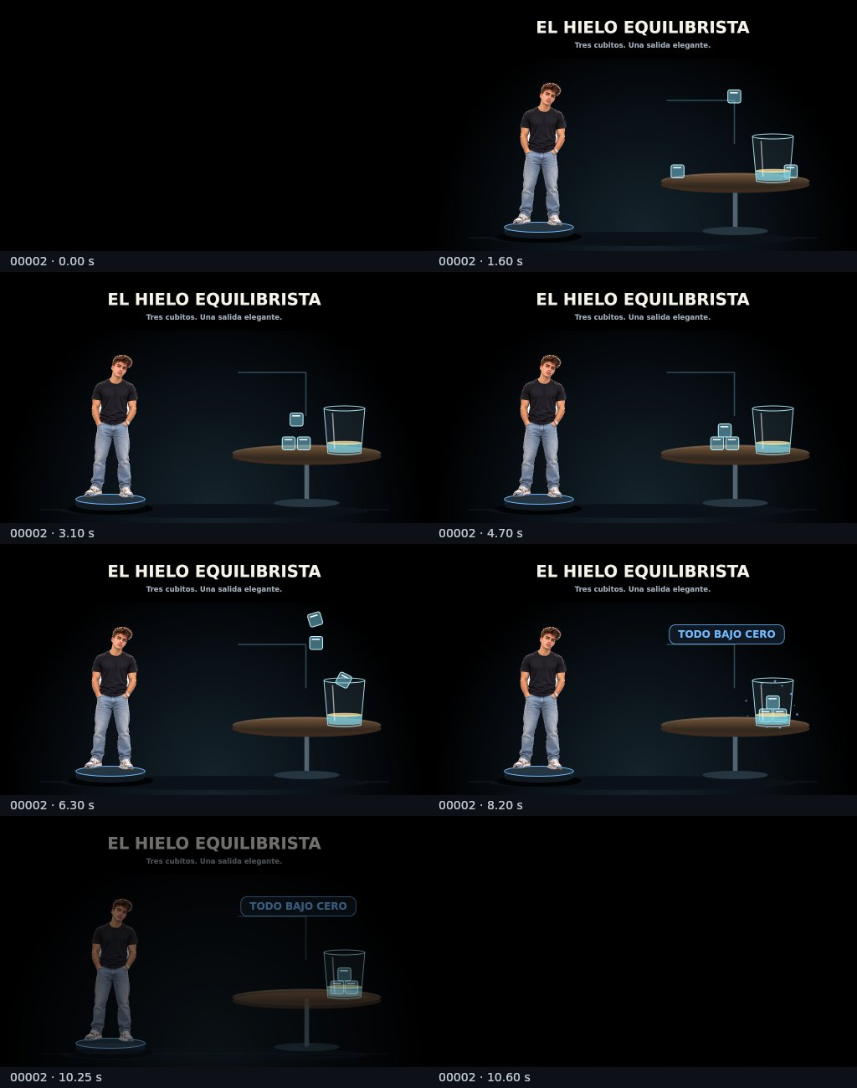
Animaciones-Astra-no-verificadas/revision/00002.jpg
