GuillermoAladro/Alcoholimetro/Animaciones-Astra-no-verificadas/revision/00004.jpg

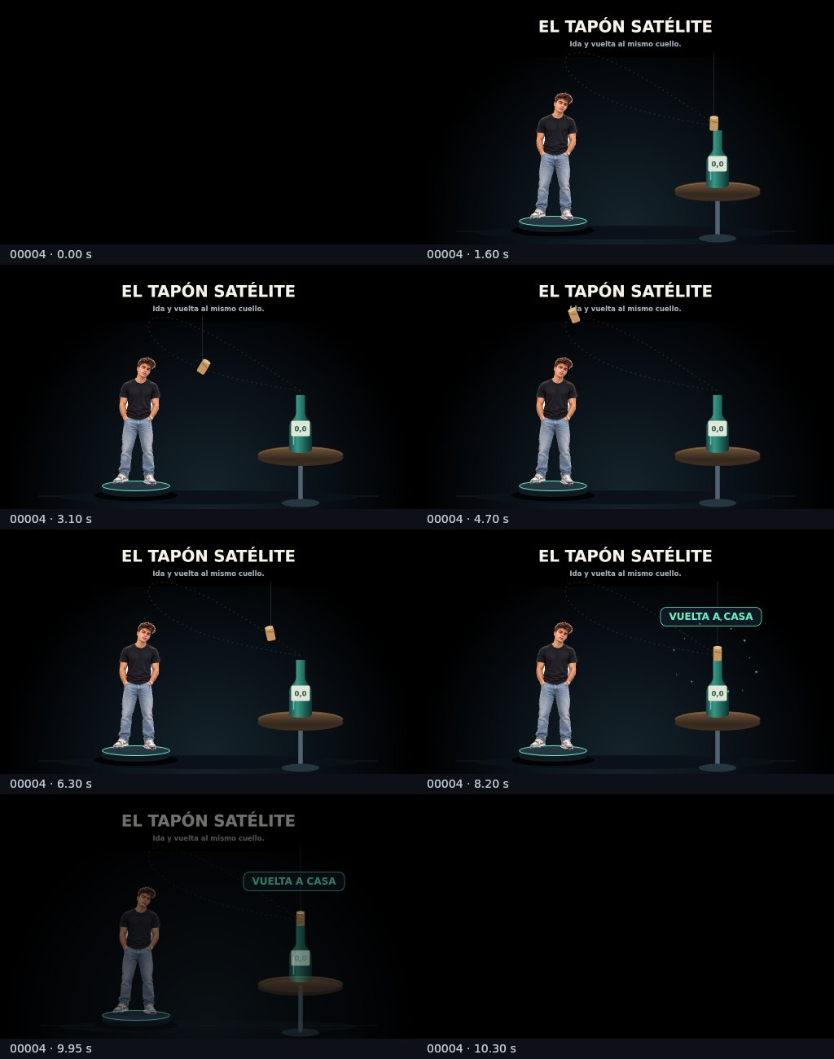
Animaciones-Astra-no-verificadas/revision/00004.jpg
