GuillermoAladro/Alcoholimetro/Animaciones-Astra-no-verificadas/revision/00006.jpg

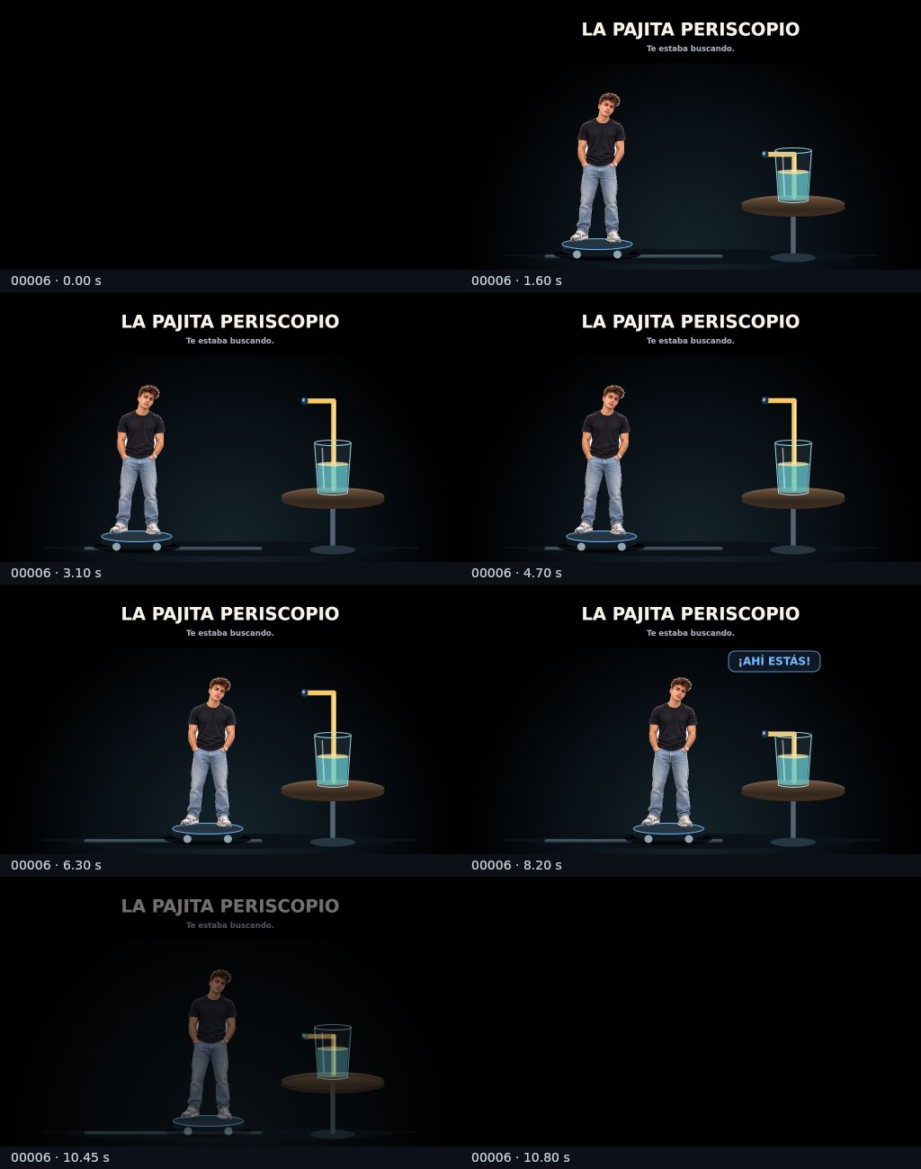
Animaciones-Astra-no-verificadas/revision/00006.jpg
