GuillermoAladro/Alcoholimetro/Animaciones-Astra-no-verificadas/revision/00007.jpg

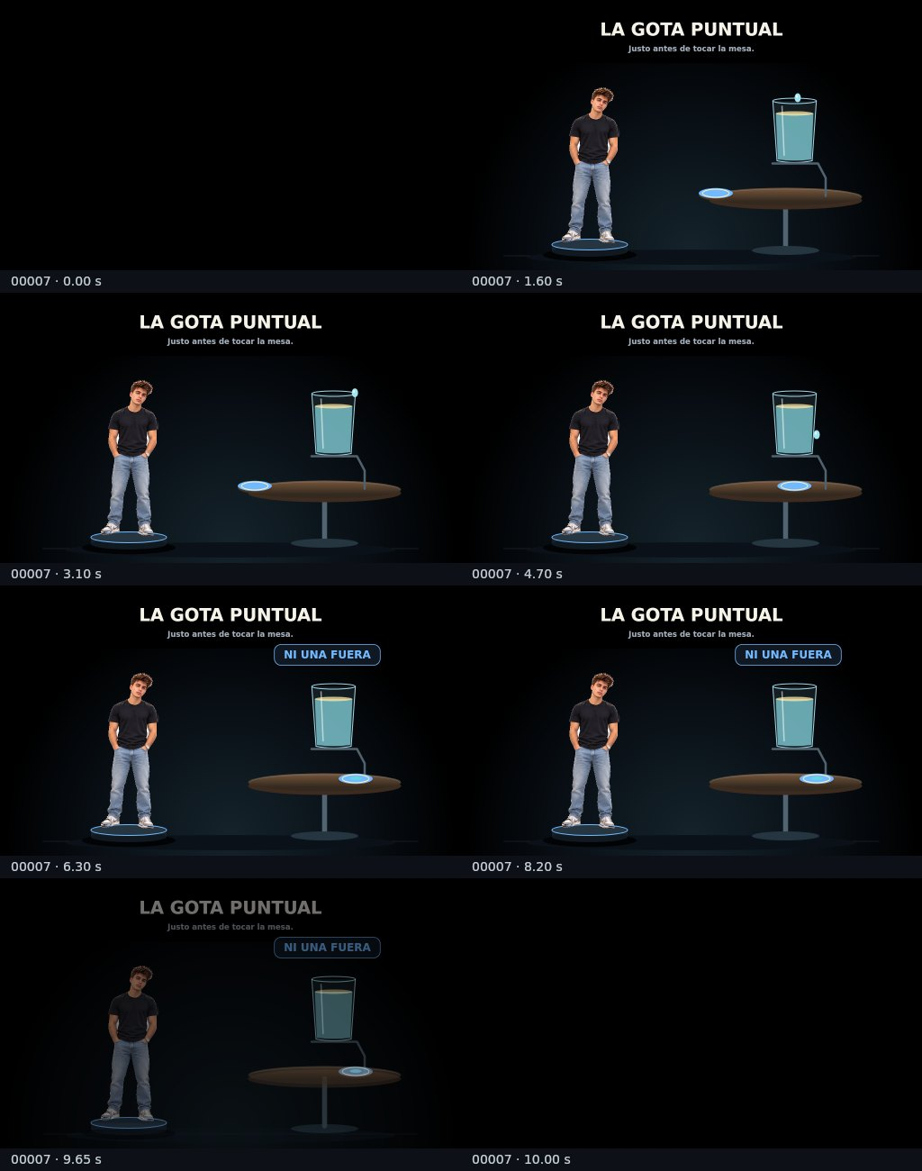
Animaciones-Astra-no-verificadas/revision/00007.jpg
