GuillermoAladro/Alcoholimetro/Animaciones-Astra-no-verificadas/revision/00008.jpg

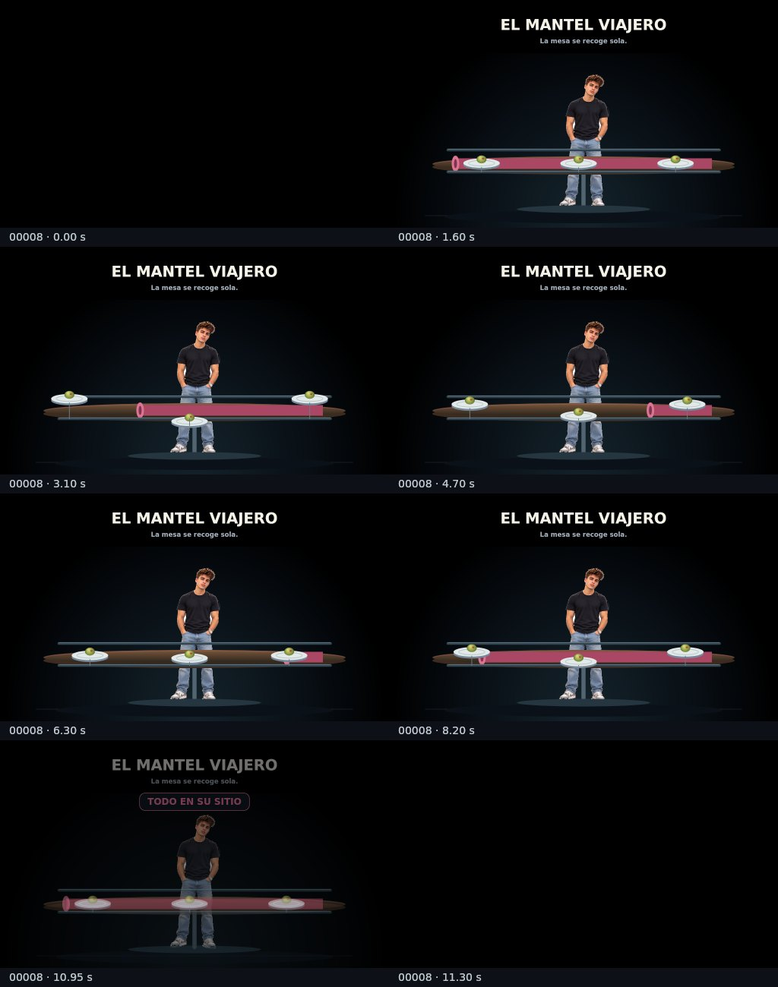
Animaciones-Astra-no-verificadas/revision/00008.jpg
