GuillermoAladro/Alcoholimetro/Animaciones-Astra-no-verificadas/revision/00010.jpg

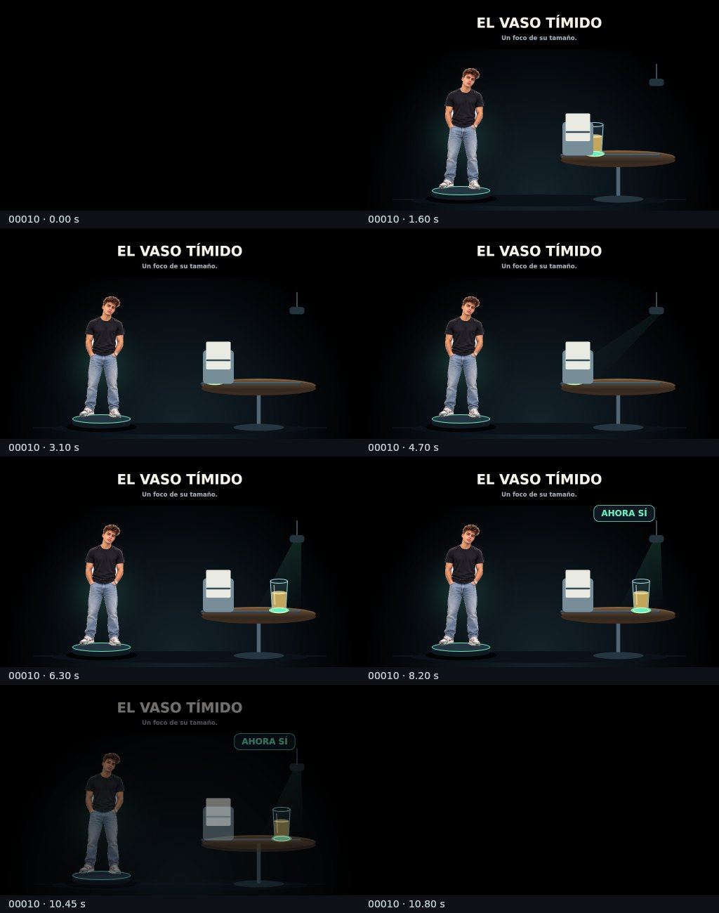
Animaciones-Astra-no-verificadas/revision/00010.jpg
