GuillermoAladro/Alcoholimetro/Animaciones-Astra-no-verificadas/revision/00011.jpg

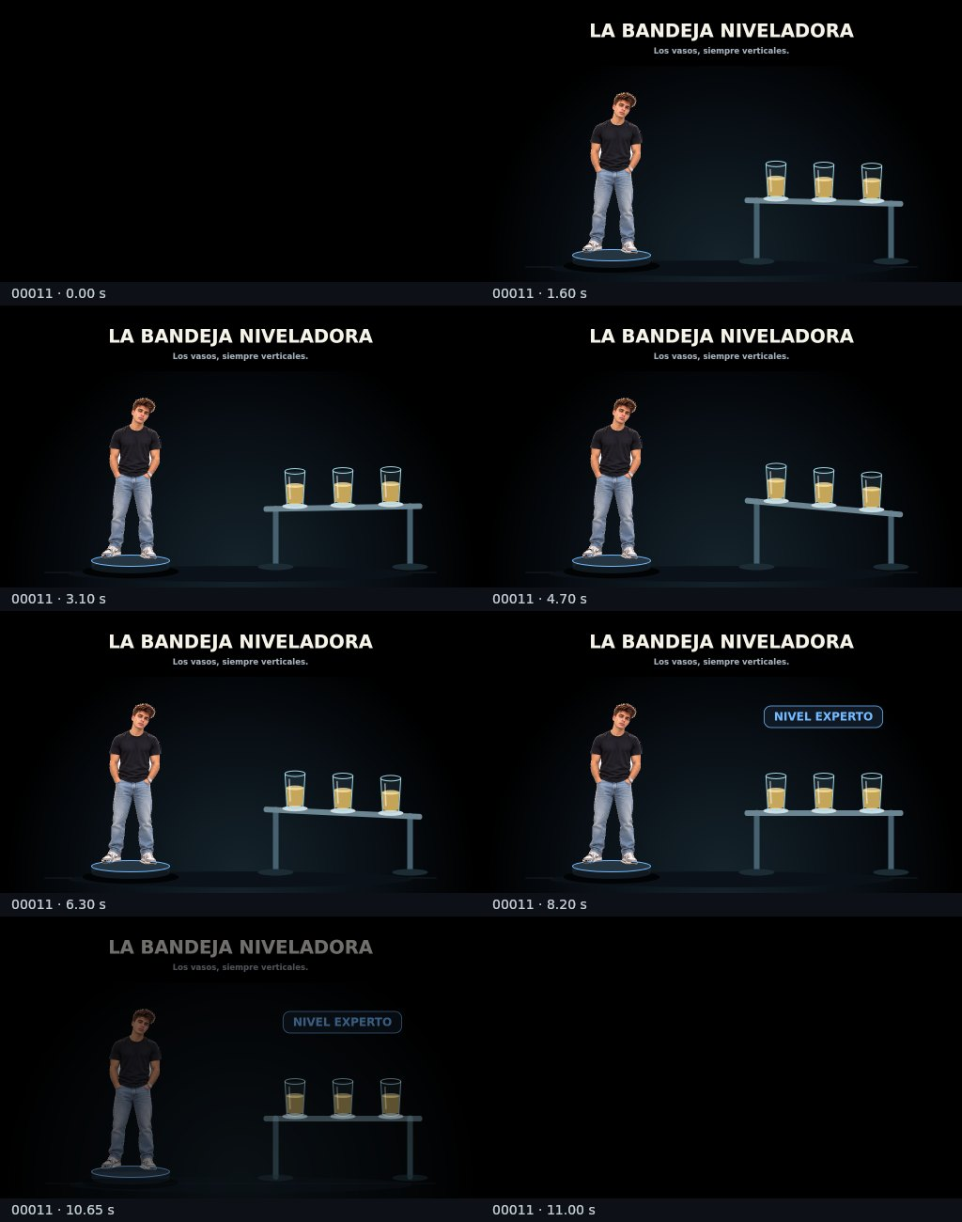
Animaciones-Astra-no-verificadas/revision/00011.jpg
