GuillermoAladro/Alcoholimetro/Animaciones-Astra-no-verificadas/revision/00024.jpg

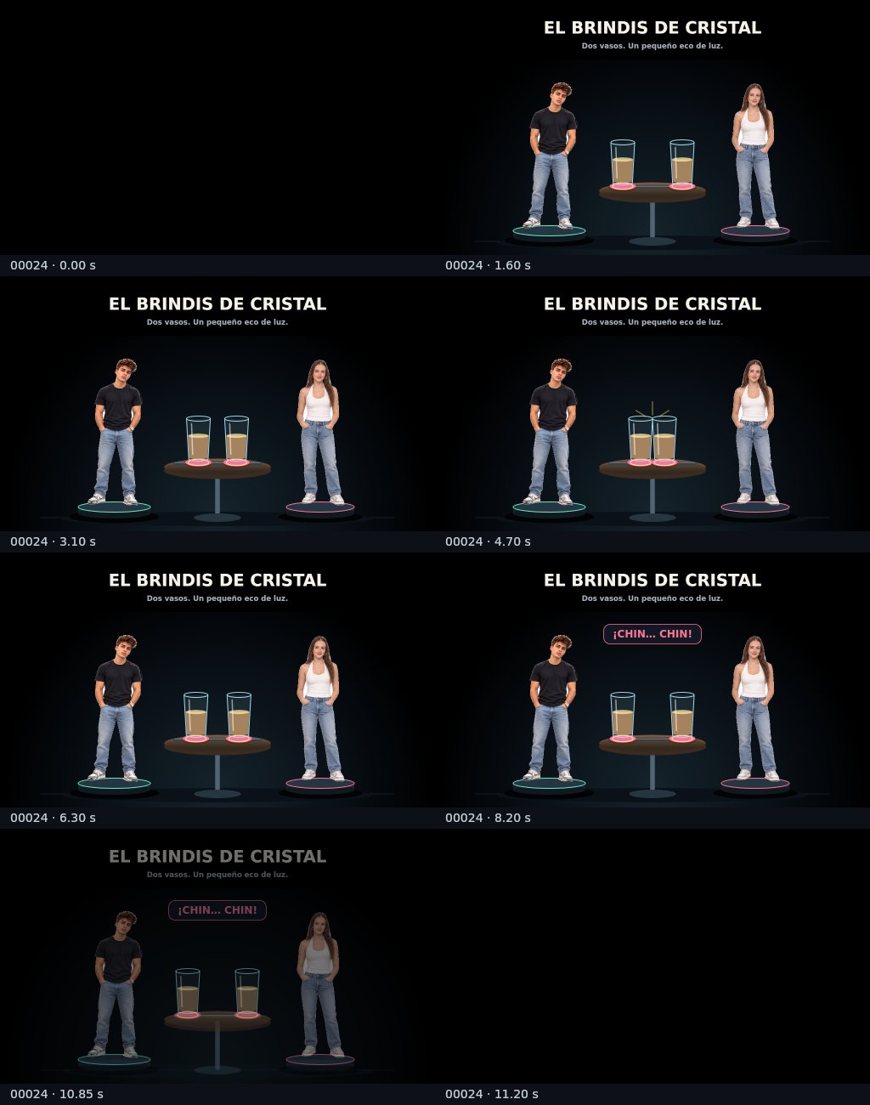
Animaciones-Astra-no-verificadas/revision/00024.jpg
