GuillermoAladro/Alcoholimetro/Animaciones-Astra-no-verificadas/revision/00027.jpg

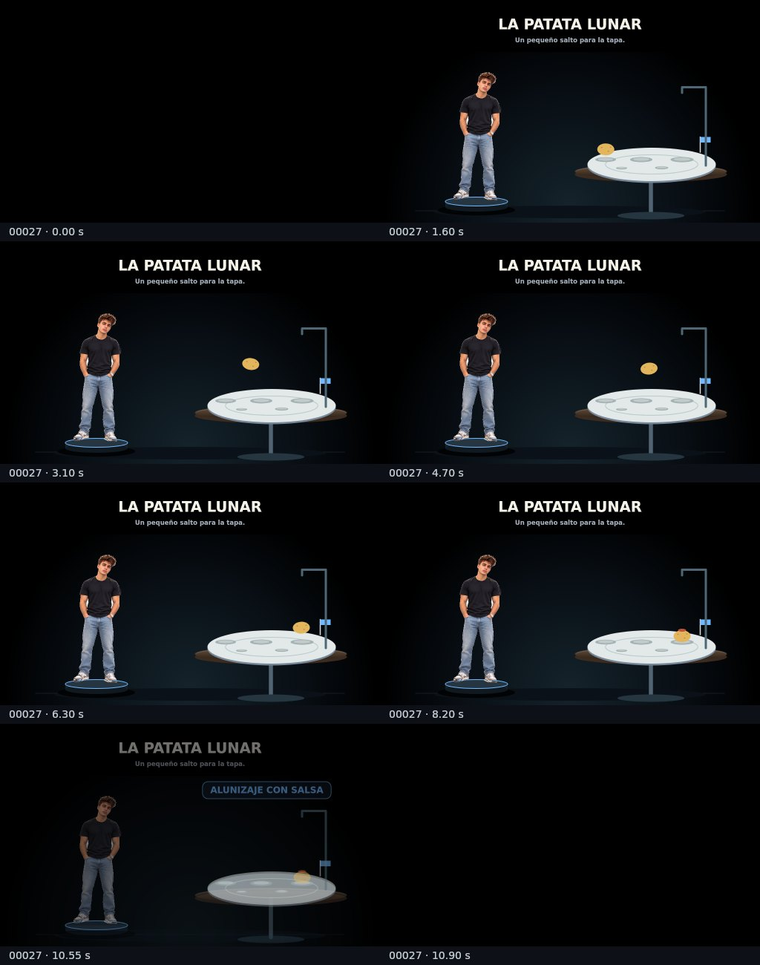
Animaciones-Astra-no-verificadas/revision/00027.jpg
