GuillermoAladro/Alcoholimetro/Animaciones-Astra-no-verificadas/revision/00028.jpg

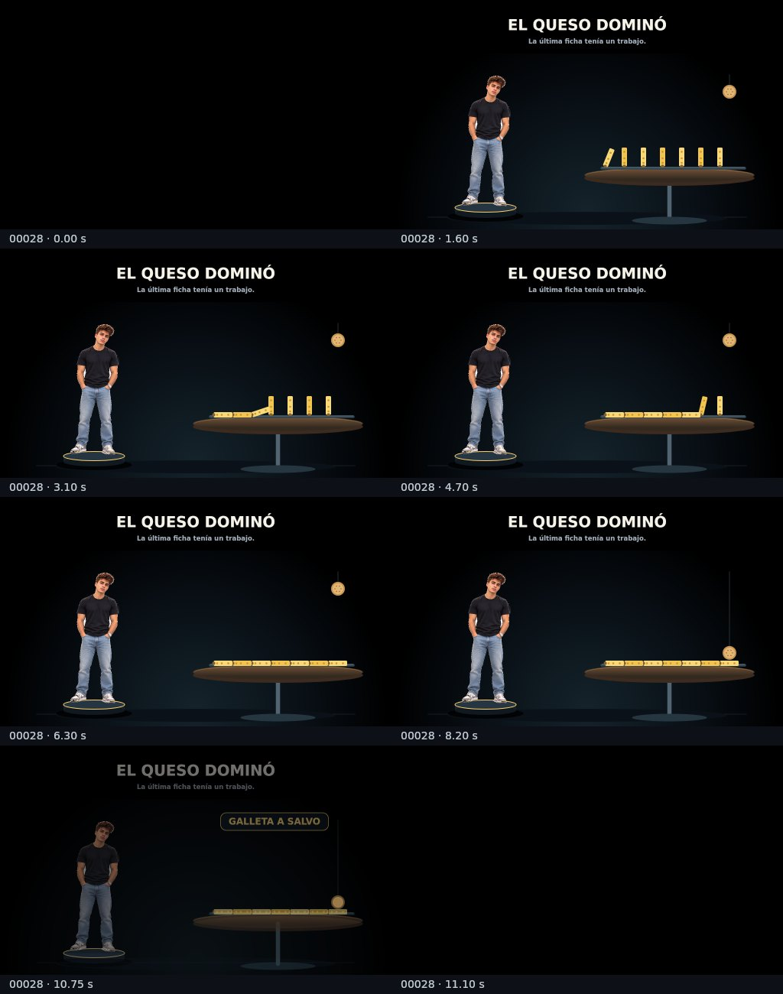
Animaciones-Astra-no-verificadas/revision/00028.jpg
