GuillermoAladro/Alcoholimetro/Animaciones-Astra-no-verificadas/revision/00030.jpg

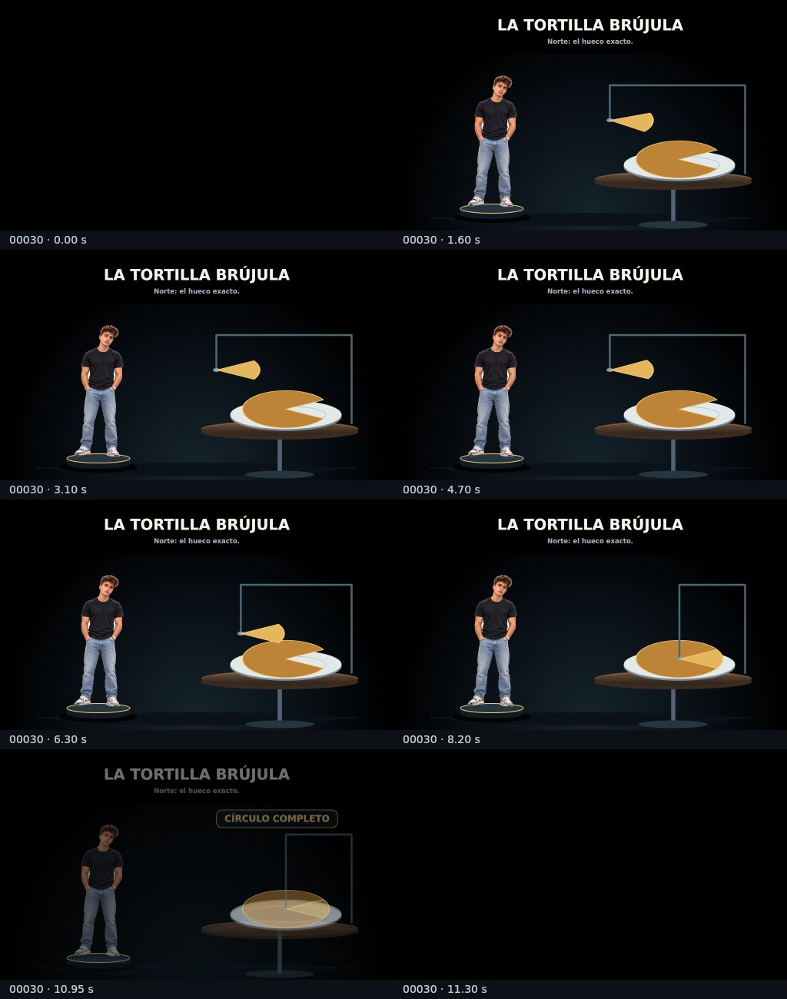
Animaciones-Astra-no-verificadas/revision/00030.jpg
