GuillermoAladro/Alcoholimetro/(commit log)

2026-10-21 Añade README con la descripción del proyecto
    Claude-Session: https://claude.ai/code/session_016isLGSnHz91zou8ob2MNAP
2026-10-21 Añade apartado componentes con la ficha de la Raspberry Pi 3B+
    Incluye datasheets (enlaces oficiales y script de descarga), aviso de cambio Rev 1.4,
    certificaciones, fallos conocidos y recomendaciones para el proyecto.
    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
2026-10-21 Añade los datasheets y certificaciones de la Raspberry Pi 3B+
    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
2026-10-21 Añade la ficha de la SanDisk High Endurance 32 GB en componentes
    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
2026-10-21 Añade datasheets y enlaces de la SanDisk High Endurance 32 GB
    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
2026-10-21 Añade la ficha de la Camera Module 3 en componentes
    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
2026-10-21 Añade la ficha del cable USB-A a USB-C acodado 90° (#10)
    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
2026-10-21 Añade la ficha de los cables JST-XH de 4 pines (#7)
    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
2026-10-21 Añade la ficha del tubo de silicona de 6 mm (#8)
    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
2026-10-21 Añade la ficha del sensor Winsen ZE29A (#6)
    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
2026-10-21 Añade la ficha de la pantalla GeeekPi 7" (#5)
    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
2026-10-21 Añade la ficha del cable FFC de 50 cm para la cámara (#4)
    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
2026-10-21 Añade la ficha del cable de red Schuko-C13 (#17)
    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
2026-10-21 Añade la ficha de la fuente Mean Well LRS-50-5 (#14) y aclara el texto de otras fichas
    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
2026-10-21 Añade la ficha del adaptador Wi-Fi AR9271 (#12)
    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
2026-10-21 Añade la ficha del SumUp Solo (#9)
    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
2026-10-21 Fichas de componentes #18 a #20: borne USB-A, latiguillo micro-USB y WAGO 221
    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
2026-10-21 Fichas de componentes #23 y #24: terminales de ojal M4 y arandelas dentadas M4
    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
2026-10-21 Fichas de componentes #21 y #22: cable 2x0,75 rojo/negro y manguera H05VV-F 3G1,5
    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
2026-10-21 Ficha de componente #30: separadores de nailon M2,5
    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
2026-10-21 Fichas de componentes #26 y #27: tornillería inox M3-M6 y kit faston aislados
    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
2026-10-21 Fichas de componentes #25, #28 y #29: espárragos M4, crimpadora y punteras, cables Dupont
    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
2026-10-21 Ficha de componente #31: pasacables de goma
    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
2026-10-21 Revisión final de fichas: enlaces.md de la Pi, notas cruzadas (ITC-BT-19, L=3.0 de la LRS, agujeros de la Pi) y README raíz
    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
2026-10-21 Añade pendientes.md con decisiones, medidas y documentos pendientes de las 31 fichas
    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
2026-10-21 Sube los documentos descargados a las fichas (1/5): componentes eléctricos de red y protección
    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
2026-10-21 Sube los documentos descargados a las fichas (3/5): Pi, cámara, pantalla, SumUp y sensor
    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
2026-10-21 Sube los documentos descargados a las fichas (4/5): conectividad, cables de señal, pulsador y tubo
    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
2026-10-21 Etiquetas de copia local en la ficha de cables JST-XH
    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
2026-10-21 Añade MONTAJE GENERAL: esquema de conexión de todos los componentes (alimentación y tierra, puertos de la Pi, GPIO)
    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
2026-10-21 MONTAJE GENERAL: marca como sin verificar la posición del USB-C del Solo y la base de carga
    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
2026-10-21 MONTAJE GENERAL: conexiones exactas con los anuncios de Amazon.es, figura 4 y enlaces de compra
    - Lee los anuncios de diez piezas (borne USB-A, pulsador, pantalla, ZE29A, JST-XH, FFC,
    latiguillo, cable acodado, SumUp Solo, C14) y deja cada dato con su origen en
    montaje-general/anuncios-amazon-21-10-2026.md.
    - Reescribe los cables W2 a W5 (caso 1 y caso 2 del interruptor del C14), W13 a W22 y W24.
    - Añade la figura 4 (dónde va cada pieza), la columna de enlaces de compra, el protocolo de
    medidas, lo confirmado y lo no confirmado, y el apartado 6 de colocación.
    - El apartado 6.3 recoge que diseno-cajon-A.md (21-10-2026) cambia pulsador, fusibles por
    rama, Wi-Fi y posición de la fue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
2026-10-21 Añade LISTA-DE-COMPRA.md: los 31 componentes con enlace de Amazon.es, precio y ficha
    Sale de la guía de montaje eléctrico v2 (20-10-2026), con los precios vistos el 19 y 20-10-2026.
    Cada ASIN está comprobado contra la tabla de MONTAJE-GENERAL.md y la ficha contra componentes/README.md.
    Incluye el plan B de conexión y las notas que corrigen los anuncios leídos el 21-10-2026.
    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
2026-10-21 Auditor 6.1-S: audita el circuito y corrige bornes de la fuente
    Incluye auditoría en PDF y Markdown, reconstrucción W1-W29, esquema de referencia, inventario completo, pruebas digitales DC/AC/UART y resultados. Dictamen no liberado para energización; sin pruebas físicas.
2026-10-21 MONTAJE GENERAL: revisión contra las dos auditorías y las hojas de datos
    - Fuente a 5,10 V (H13) con la regla de ≥ 4,90 V medidos en la Pi; justificación con
    rizado y regulación de la LRS-50-5.
    - Fusible rápido por rama de 5 V (H04): pieza nueva #32 (portafusibles en línea 5x20 +
    fusibles), 3 / 2 / 2 / 1 A, en W13, W14, W16 y W18. Ficha corta y fila en la lista.
    - El Solo se conecta a una Wi-Fi que crea la Pi (wlan0 punto de acceso) y la Pi sale por
    el AR9271 (H16): W29, W30 y figura 2; se quita disable-wifi.
    - Pantalla 1 A (5 W); pico total 5,5 A.
    - W28: el tubo de soplido lleva toma de presión, barrera y toma de alcohol, en ese orden,
    como exige el manual del ZE29A.
    - W12b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
2026-10-21 MONTAJE GENERAL: incorpora las cuatro auditorías del repositorio y una revisión independiente
    - C14: si corta un polo o su esquema no coincide con uno de fabricante, se sustituye por una
    entrada bipolar documentada; se retira la opción de «aceptar el riesgo».
    - Fusible de troncal F 8 A además de los de rama; empalmes 16/22 AWG con WAGO 221-412.
    - Ajuste 5,10 V de partida y tope 5,12 V; notas 2 y 7 de la hoja de la LRS (rizado no
    garantizado bajo el 50 % de carga); envolvente con línea, carga y temperatura.
    - W12/W12b: el −V pasa por una 221-413 (un conductor por polo) y se une a tierra en un solo
    punto; el jack RP-SMA va aislado del techo para que no sea un segundo punto.
    - Pu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
2026-10-21 Añade MONTAJE PASO A PASO y alimenta la Pi directamente desde la fuente
    - MONTAJE-PASO-A-PASO.md: diez fases (recepción sin tensión, Pi sola, periféricos, 230 V en
    banco, reparto de 5 V con cargas ficticias, cargas reales una a una, neumática, carcasa y
    tierra, máquina cerrada), con piezas, pasos, pruebas numeradas con criterio y registro.
    - Corrección: el cálculo de tensión en la Pi olvidaba la caída del troncal (4,88 V típicos y
    4,62 V de pico colgando de la regleta). La Pi pasa a ir directa a los bornes 4 y 5 de la
    fuente con su F 3 A (4,96 / 4,78 V); el troncal queda con F 5 A.
    - Figura 1, ficha #32, lista de compra y README actualizados.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
2026-10-21 MONTAJE PASO A PASO: correcciones de la revisión independiente
    - P3.7: el Button de gpiozero se guarda en una variable (si no, se cierra y no cuenta).
    - Punto de acceso con autoconnect y atado por MAC; sin renombrar interfaces con .link.
    - P5.7 (corto en rama con cargas ficticias) pasa a obligatoria antes de la fase 6.
    - P6.13 solo con las resistencias de 1 kΩ en la UART.
    - Regla 1 precisa qué se puede tocar con la fuente enchufada; chapa del C14 a PE en banco.
    - Empalme del troncal con una 221-412 (son 5 en total); cinco arranques antes de ajustar.
    - Polaridad de la clavija del ZE29A medida suelta; ciclos completos en P7.3 y P7.4;
    56 kΩ medidos con adaptador USB-C; lámpara del C14 so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
2026-10-22 Sin botón en todo el proyecto y diseño A actualizado (tapa interior deslizante)
    - DECISIONES.md: registro de decisiones. 22-10-2026: el proyecto no lleva
    botón (arranca al detectar a alguien con la cámara) y manda el diseño A.
    - Avisos en LISTA DE COMPRA (el #11 no se compra; totales sin él),
    MONTAJE GENERAL, MONTAJE PASO A PASO, índice de componentes, ficha del
    pulsador y pendientes (#7, #12, #18, #19).
    - carcasa/diseno-A/: CAD del diseño A con la tapa interior que entra
    deslizando por una ranura del lateral derecho, faldón derecho en la tapa,
    antena hacia abajo; visor 3D, STEP, DXF, lista de piezas y scripts.
    Claud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
2026-10-25 Sin botón: el Solo espera tarjeta siempre; el pulsador fuera de todo el repositorio
    - DECISIONES.md: entrada del 25-10-2026. La prueba empieza al pagar: la Pi
    deja un cobro abierto en el Solo y lo renueva al caducar; no cobra si el
    sensor no responde.
    - Fuera el pulsador (#11) de la lista de compra (31 componentes, 635,69 €),
    del índice, de las fichas (Dupont: solo pines 8 y 10; faston: solo 230 V;
    crimpadora, C14, pasacables, pantalla) y de los pendientes.
    - MONTAJE GENERAL: sin W21/W22, ni Ø30 del panel ni pull-up; punto 10 del
    apartado 4 = cobro continuo. Figuras 2, 3 y 4 rehechas (SVG y PNG).
    - MONTAJE PASO A PASO: sin P1.11 ni fase 3.3 (renumerado); nueva P6.14.
    - Borrada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
2026-10-25 CAD: la cerradura de la tapa se dibuja con bombín y ranura de llave
    La cara de la cerradura de leva era un disco liso y se confundía con un
    botón. Ahora lleva el bombín de latón y la ranura de la llave.
    Claude-Session: https://claude.ai/code/session_01MDyCaz223X6sxbbMPeRyMY
2026-10-25 Toma C14 sin interruptor: fuera el interruptor rojo que se veía en el lateral
    - CAD: la toma C14 con interruptor (B08Z6FCR5Z) pasa a una con
    portafusibles y sin interruptor (B07CQ54BY4). Recorte del cajón, taladros
    M3 a 36 mm, ventana de la carcasa 38 × 46 y topes; 0 choques y recorridos
    sin roces.
    - Lista de compra (#15, total 636,02 €), MONTAJE GENERAL (W2 y W3 directos
    a la fuente, sin W4/W5; protocolo del apartado 4.1; figura 1), PASO A
    PASO (P1.1, P4.1, P4.3, P4.4), pendientes, índice, aviso en la ficha #15
    y fichas que cableaban el interruptor.
    - DECISIONES: la máquina se apaga desenchufándola; el fusible en un solo
    polo sigue abierto.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
2026-10-26 Componentes a tamaño real en el visor y nueva vista de conexiones
    - Visor_3D.html: cada pieza comprada con su forma real según su ficha
    (Pi, cámara, pantalla, Solo, fuente, C14, WAGO, portafusibles, bornes,
    ZE29A, AR9271, T y reductores), sin logotipos; chapa sin pintar o por
    grupos.
    - Conexiones_3D.html: las piezas sobre una mesa con las 38 conexiones,
    terminales y verificación (0 errores, 19 avisos).
    - specs.py: colocación corregida al modelar a tamaño real (celda del
    ZE29A, hueco de faston entre C14 y fuente, entradas de las WAGO, bornas
    de los USB). 0 choques, barridos limpios, cables sin atravesar piezas.
    - DECISIONES 26-10: cambios y puntos abiertos.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
2026-10-26 Programa v2 de la Raspberry Pi: ranking, cobro continuo, soplido, foto y resultado
    - programa/: Node 20 sin dependencias + Chromium en modo kiosco. En espera pasa el
    top 10 con foto; el Solo pide tarjeta siempre; al pagar: precalentar, sopla con
    barra, cuenta atrás de 5 s y foto, resultado con puesto y top %, y celebración.
    Fotos del top 10 para siempre, las demás 24 h; el valor queda en el ranking.
    - Robustez: diario de cobros con fsync y reconciliación tras apagón, pago lento
    (PIN) nunca caducado, búsqueda por foreign_transaction_id, reembolsos con
    reintentos, perro guardián monotónico, reinicio si una fase no avanza.
    - Dos revisiones independientes (12 + 11 fallos correg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
2026-10-26 Monigote presentador basado en Guillermo en todas las pantallas
    - nucleo/monigote.js: chico cachas sin camiseta dibujado con el lienzo (tupé,
    cejas gruesas, barba de tres días, lunar, cadena y anillo). 16 posturas con
    cinemática inversa en los brazos y 9 caras; coreografías con bocadillos.
    - Espera: saluda, señala el lector, bíceps, pulgar y selfie con bocadillos.
    Pago, preparando (estira), sopla (mofletes), soplando (anima), cortado,
    cuenta atrás (selfie), resultado (reacciona al puesto), avisos y siesta.
    - Para la Pi: torso y cabeza guardados por tamaño, copias a píxel entero,
    contornos con rellenos (sin trazos gruesos ni recortes) y animación a
    15 cuadros por segundo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
2026-10-26 Avatar de Guillermo para las animaciones de la máquina
    Ilustración elegida como base del monigote presentador (camisa negra,
    pantalón gris, brazos cruzados). El programa la trocea en piezas (cabeza,
    cuerpo, brazos, manos) para animarlo en la pantalla.
    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
2026-10-27 Monigote a partir del avatar de Guillermo (animaciones/Avatar GuillermoAladro.jpg)
    La ilustración elegida se trocea en piezas y se anima: cabeza con nueve
    caras (ojos y boca retocados), torso (lo que tapaban los brazos cruzados
    se rellena con camisa), cuello de la camisa aparte, manga entera que gira
    en el hombro con el antebrazo doblado de 10 en 10 grados (el puño
    remangado tapa el codo) y manos (abierta, puño, pulgar, móvil).
    nucleo/monigote.js admite dibujos con o sin piezas de hombro.
    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
2026-10-27 Monigote: manos y brazos revisados
    - Manos de la foto con el tono de piel de la ilustración, contorno a línea
    y, en la abierta, los dedos juntos (mano relajada); la muñeca se funde
    bajo el antebrazo.
    - Manga más estrecha y antebrazo algo más grueso (en la ilustración los
    brazos cruzados están en escorzo); la base del antebrazo queda bajo el
    puño y el brillo del hombro de la manga se atenúa.
    - Encogerse de hombros con las manos a la altura del pecho.
    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
2026-10-27 Avatar 3D (animaciones/avatar-3d): malla glTF y visor
    El avatar convertido en una malla 3D a partir del dibujo: cada pieza se
    triangula y se "hincha" según su distancia al borde, con relieve extra en
    la cara. Esqueleto con cuello, hombros, codos y muñecas; las mismas
    posturas que en la pantalla, nueve caras y cuatro manos por lado.
    avatar.glb (estándar) y visor.html (three.js incrustado, sin conexión).
    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
2026-10-27 Avatar nuevo: hoja de personaje estilo Bitmoji 3D
    animaciones/Avatar GuillermoAladro.jpg pasa a ser la hoja de personaje
    nueva (frente, 3/4, perfil, espalda y seis caras), referencia para
    generar las animaciones con IA de vídeo.
    Se retiran la ilustración anterior y su versión 3D (animaciones/avatar-3d);
    siguen en el historial. El programa de la pantalla no cambia: aún anima la
    ilustración anterior troceada (nucleo/monigote_fotos.js).
2026-10-27 Carcasa a 100 mm de fondo (antes 103)
    - Hueco detrás del cajón de componentes de 14 a 11 mm; el cajón y su interior no cambian.
    - Espárrago de tierra de la carcasa cortado a 8 mm (con 10 quedaba a 1 mm del cajón).
    - Puente de tierra W10 recolocado; asidero derecho referido a la trasera del cajón.
    - Regenerados STEP, DXF, visor 3D, conexiones y lista de piezas.
    - 0 choques, barridos limpios, mismos avisos de cables que con 103 mm.
    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
2026-10-27 Diseño A completo en un STEP para FreeCAD
    - modelo/exportar_freecad.py: la máquina entera (chapas, electrónica, tornillería y 38 cables/tubos)
    en un solo STEP AP214, agrupada en 9 conjuntos, con nombre y color en cada pieza.
    - FreeCAD/Alcoholimetro_A_completo.step (286 piezas, 0 sólidos inválidos), LEEME y dos vistas.
    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
2026-10-28 Añadir Avatar Laura: hoja de personaje cartoon
    Cuatro vistas de cuerpo entero (frente, 3/4, perfil y espalda) y seis
    expresiones de cara (sonrisa, risa con guiño, sorpresa, achispada,
    ojos cerrados y guiño) para las animaciones de la pantalla.
    Claude-Session: https://claude.ai/code/session_01EkRiGYvUWzXCLEozdpzYfh
2026-10-28 Avatar Laura: sustituye la hoja cartoon por la nueva hoja de personaje 3D
    Deja una sola versión de Laura en animaciones/Avatar Laura.jpg.
    Claude-Session: https://claude.ai/code/session_01EkRiGYvndT2ta5TKvrnmuM
2026-10-28 Banco de animaciones generales (por confirmar): 7 animaciones del Stand By
    Una animación por archivo (El borracho, Modo leyenda, La tienda 24H, Monumentos
    de latas, El eructo, Cohete de espuma, El reto), el motor común, las pantallas
    fijas (BEBE, TOP 10 en llamas, Puesto del 10 al 1), la baraja que las elige al
    azar y ver.html para probarlas. Todas empiezan y acaban en negro.
    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
2026-10-28 Banco de animaciones: 100 animaciones nuevas del avatar (IDs 00000–00099)
    Cada animación tiene su ID de 5 cifras y su archivo «IIIII Nombre.js»; las 7
    anteriores pasan a 00100–00106. Todas empiezan y acaban en negro, duran entre
    7,5 y 12,5 s y se apuntan solas con registrar(). ver.html las carga desde
    lista.js y tiene un selector para verlas una a una. Incluye GUIA.md con los
    criterios y herramientas/probar.py para comprobarlas.
    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
2026-10-28 Banco de animaciones: 50 animaciones de Guillermo y Rodrigo juntos (IDs 00107–00156)
    - Avatar de Rodrigo (motor/avatar-rodrigo.js): piezas, 6 caras y pelo dorado.
    - motor/base.js admite varios avatares (registrarAvatar, avatar(), quien en la pose).
    Las 107 anteriores siguen igual.
    - 50 animaciones nuevas en 5 tandas: duelos, amigos, bromas, el bar y la máquina, aventuras.
    - README (157 animaciones, ~26 min), GUIA (sección Rodrigo), lista.js, ver.html y probar.py.
    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
2026-10-28 Banco de animaciones: 50 animaciones de Guillermo y Marcos juntos (IDs 00157–00206)
    - Avatar de Marcos (motor/avatar-marcos.js): piezas, 6 caras y pelo dorado.
    Lleva manga corta: brazos separados del cuerpo por color de piel.
    - motor/base.js: el círculo del codo puede llevar color y tamaño propios
    (colorCodo, radioCodo). Guillermo y Rodrigo siguen igual.
    - 50 animaciones nuevas en 5 tandas: retos, colegas, detrás de la barra, fantasía, aire libre.
    - README (207 animaciones, ~34 min), GUIA (Marcos y trucos), lista.js, ver.html y probar.py.
    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
2026-10-28 Banco de animaciones: 50 animaciones de Guillermo con Marcos de bombero (IDs 00207–00256)
    - Marcos de bombero (motor/avatar-marcos-bombero.js): variante de Marcos con chaquetón y
    pantalón azul marino con bandas reflectantes, botas y casco rojo. Se usa con quien: "bombero".
    - motor/base.js: registrarVariante (reutiliza las caras de otro avatar) y casco de bombero
    de diseño propio (casco: true / false, cascoColor).
    - 50 animaciones nuevas en 5 tandas: rescates, parque de bomberos, el bar, fantasía, fiesta.
    Marcos de uniforme solo bebe agua o refresco; nadie conduce después de beber.
    - herramientas/probar.py: ya no confunde los IDs al probar archivos que no van en orden.
    - README (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
2026-10-29 Remove temporary Sara avatar transfer material
2026-10-29 Avatares nuevos: 9 hojas de personaje y fuera las anteriores
    Nuevas en animaciones/: Carla, Rodri, Laura, Marta, Paradigma, Sara Saez, Gabacho,
    Guillermo Aladro y Yorgi. Se retiran las hojas anteriores (Gabacho, Laura, Marcos,
    Rodrigo, Sara y Yorgi); siguen en el historial de git. Las animaciones del banco no
    cambian: llevan sus recortes dentro de motor/.
    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
2026-10-29 Avatar de Guillermo nuevo: Avatar Guillermo Aladro.png
    Sustituye a Avatar GuillermoAladro.jpg (retirada; sigue en el historial de git).
    README y DECISIONES apuntan a la hoja nueva.
    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
2026-10-29 Añadir plan de 500 animaciones Astra con identidad de avatares y continuidad
2026-10-29 Añadir primeras 8 animaciones Astra, visor y revisión de 2525 fotogramas
2026-10-29 Añadir animaciones Astra 00008–00015 y revisión acumulada de 5113 cuadros
2026-10-29 Añade escenas Astra 00016–00024 y referencia original de Laura
2026-10-29 Añadir avatares de Dari, Deivi, Kiriku y Ander
    Hojas de personaje (1122 × 1402) con cuatro vistas de cuerpo entero
    y seis expresiones, en el mismo formato que el resto de avatares.
    Claude-Session: https://claude.ai/code/session_01EkRiGbtneqtgXGuBfxh7oz
2026-10-29 Añade animaciones Astra 00025–00032: tapas y mecanismos
2026-10-29 Avatares: nueva hoja de Carla y se añade Marcos Bombero
    Carla pasa a la hoja con vestido negro y tacones (sustituye a la de vaqueros,
    que sigue en el historial de git). Se añade la hoja de Marcos de bombero, que
    faltaba desde que se retiró la anterior de Marcos.
    Claude-Session: https://claude.ai/code/session_01EkRiGcgqLhzLpdCWHHaPjD
2026-10-29 Avatar Carla: hoja final (vaqueros y botines negros)
    Sustituye a la del vestido negro, que sigue en el historial de git.
    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
2026-10-29 Añadir avatares SVG: Guillermo Aladro vectorizado
    Nueva carpeta "avatares SVG" con la versión vectorial de la hoja de
    Guillermo Aladro (fondo transparente, 1122 × 1402, mismas posiciones
    que el PNG):
    - Avatar Guillermo Aladro.svg: hoja completa con grupos por vista,
    expresión y firma; cada grupo lleva data-caja con su contorno.
    - Guillermo Aladro/: un SVG por vista (4) y por expresión (6).
    - herramientas/: script de vectorización reproducible, configuración
    de svgo y separador de piezas, para repetirlo con los demás avatares.
    - revision/: comparación con el original e informe de cajas y ajustes.
    Fidelidad frente al PNG: SSIM 0,942 y error medio de color 4,1/255
    en la hoja comp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
2026-10-29 Avatar Marcos Bombero: hoja final
    Sustituye la hoja anterior por la versión final (1071 × 1469): casco
    amarillo con visera, traje azul marino con bandas reflectantes y
    manguera roja; cuatro vistas y seis expresiones.
    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
2026-10-29 Preparar publicación de avatares SVG Astra verificados
2026-10-29 Añadir vista frontal SVG detallada de Guillermo Aladro (Astra)
2026-10-29 Retirar el publicador temporal tras verificar los SVG Astra
2026-10-29 Añadir versión frontal de Guillermo Aladro bebiendo cerveza
2026-10-29 Preparar publicación secuencial de avatares SVG individuales
2026-10-30 Añadir extracción exacta y revisión individual de cada avatar SVG
2026-10-30 Revisar los 156 SVG y corregir coherencia de las escenas
    Revisa individualmente las 14 hojas y sus 140 vistas y expresiones contra las referencias actuales. Registra comprobaciones y observaciones por archivo.
    Corrige referencias SVG 1.1/2 y recortes de brazo en las dos escenas de Guillermo. Cierra la unión del hombro y elimina tres restos blancos en la frontal; actualiza los generadores, el vídeo, la vista previa y los informes.
    Validación: 156 SVG válidos; 154 renders estáticos nuevos; escenas contrastadas en Chromium, Inkscape y CairoSVG; 106 muestras de contacto vaso-labios por escena; vídeo frontal de 288 fotogramas decodificado sin errores.
2026-10-30 Crear Avatares 2D con Guillermo 03 elegido y cinco versiones de Ander
    Añade diez propuestas de Guillermo Aladro y registra la elección del diseño 03, Dragon Ball clásico, como estilo de la colección. Añade cinco variantes de Ander basadas en sus propios SVG y en ese estilo.
    Incluye PNG originales de 1122 x 1402, comparativas PDF, galerías, prompts completos, referencias SVG y revisión visual por diseño. Los 15 PNG y las 10 páginas de comparativas se comprobaron antes de publicar.
2026-10-30 Avatares SVG Astra: documentación, informe y herramientas de la versión transparente
    - README de la colección reescrito: fondo transparente, nombres comunes,
    uso en la Pi y estado de las escenas de Guillermo.
    - REVISION-TRANSPARENTE-2026-10-30.md e informe por archivo (154 SVG).
    - Colección de vistas previas sobre negro.
    - Herramientas reproducibles: rehacer_transparentes.py (idempotente),
    verificar_transparentes.py, generar_mascaras.py, siluetas.py,
    preparar_anteriores.py y las máscaras usadas.
    - README principal: la carpeta ya no es de fondo blanco.
    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
2026-10-30 Conservar un único avatar 2D por persona y añadir Carla
    Conserva Guillermo 03 y Ander 04 como diseños elegidos con nombres únicos. Retira las alternativas y comparativas de opciones de Avatares 2D a petición del usuario. Añade el diseño de Carla y sus referencias; el resto de la colección continúa en preparación. Los SVG originales no cambian.
2026-10-30 Añadir avatares 2D finales de Dari, Deivi y Gabacho
2026-10-30 Añadir avatares 2D finales de Kiriku, Laura y Marcos Bombero
2026-10-30 Añadir avatares 2D finales de Marta, Paradigma y Rodri
2026-10-30 Completar colección 2D: un avatar final para cada una de las 14 personas
2026-10-30 Animaciones 2D: carpeta nueva y animación 00001 «Guillermo y la jarra»
    - Guillermo hecho con piezas de su avatar 2D (Guillermo-Aladro-2D.png): cabeza del retrato,
    cejas, boca, torso, brazo, vaqueros y zapatillas; preparar_piezas.py las saca del PNG.
    - Entra andando por la izquierda, se bebe la jarra entera en el centro, eructa, mira a
    cámara (brindis y guiño) y sale por la derecha. Empieza y acaba en negro absoluto, sin
    textos, calculada por tiempo (60 fps sin saltos).
    - Motor común (base2d.js, recortes.js), visor ver.html con modo kiosco, herramientas para
    comprobar las reglas y grabar, y vista previa en MP4 a 60 fps.
    Cl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
2026-10-30 Animaciones 2D: ignorar cachés de Python
    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
2026-10-30 Revisar 00001 y guardar 00001.2: contacto, brazo, líquido y encuadre
    Conserva la escena original y añade MP4, fotogramas y comprobaciones reproducibles de la revisión.
2026-10-30 Animaciones 2D: 00002 «Guillermo se transforma» y 00003 «Guillermo y el globo»
    - 00002: se bebe una copa, carga gradual (chispas, piedras, grietas, destellos dorados) y
    estallido con grito: camiseta rota y torso musculado, pelo rubio, ojos azules, aura con
    rayos; sale volando por arriba. Empieza y acaba en negro.
    - 00003: saca un globo rojo del bolsillo y lo hincha en cuatro soplidos; «Alcohol Tester» y la
    lectura en g/cl3 crecen y se curvan con el globo, la lectura pasa de verde a rojo, la cara se
    enrojece; el globo le explota en la cara y mira a cámara enfadado.
    - Piezas nuevas del avatar en piezas_extra.png (brazo libre, torso sin manos, pelo dorado, cara
    roja); piezas.pn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
2026-10-30 Animaciones 2D: 00004 «Guillermo contra la máquina» de puñetazos
    Guillermo enciende con una moneda una máquina de puñetazos (dibujada en el mismo estilo),
    calienta, amaga mirando a cámara y suelta el golpe: el marcador sube a 999 entre chispas y
    humo; al acercarse a leerlo, el saco que seguía girando le da un coscorrón, se parte el brazo y
    la bola sale botando. Se tambalea con estrellitas y chichón, cae sentado con los ojos en
    espiral y levanta el pulgar. Empieza y acaba en negro; el único texto son los números del
    marcador.
    El muñeco gana pulgar arriba, ojos en espiral y chichón; 00001, 00001.2, 00002 y 00003 siguen
    idénticas píxel a píxel.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
2026-10-30 Revisar 00002 y guardar 00002.2: copa, brazos, encuadre y determinismo
    16 comprobaciones superadas, vídeo a 60 fps y original conservada. Integra las adiciones simultáneas de 00004.
2026-10-30 Animaciones 2D: capas de escena sobre la cara y el torso de Guillermo
    Ganchos opcionales p.capaCabeza y p.capaTronco para que cada escena dibuje encima
    sin tocar el montaje. Las escenas que no los usan no cambian.
    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
2026-10-30 Animaciones 2D: 00010 «Guillermo en la discoteca»
    Bola de espejos, pista de luces a 120 ppm, paso de Fiebre del sábado noche y salida
    en moonwalk. Empieza y acaba en negro, sin saltos.
    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
2026-10-30 Guardar 00002.3: la camiseta estalla completa y los hombros quedan unidos
    Retira cuello y mangas, dibuja torso y brazos descubiertos y dispersa toda la prenda. 18 comprobaciones y 175 fotogramas de regresión superados.
2026-10-30 Animaciones 2D: 00006 «Guillermo y el hipo»
    Hipidos con pompas, aguanta la respiración hasta ponerse morado y un hipido gigante
    lo levanta del suelo. Empieza y acaba en negro, sin saltos.
    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
2026-10-30 Animaciones 2D: 00007 «Guillermo y el champán»
    Agita la botella, el corcho no sale, mira por el cuello y el chorro de espuma lo
    saca volando de la escena. Empieza y acaba en negro, sin saltos.
    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
2026-10-30 Animaciones 2D: rodajas en cuña para rodillas y codos muy doblados
    Opción p.tirasLimpias: cada rodaja de pierna o brazo se alarga y se recorta por las
    bisectrices de sus juntas, así el pliegue no deja dientes de sierra ni huecos. Las
    escenas que no la activan se dibujan igual que antes.
    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
2026-10-30 Animaciones 2D: 00005 chupito de fuego, 00008 cacahuetes y 00009 línea recta
    Completa la tanda de seis (00005–00010). Las seis activan p.tirasLimpias y las ya
    subidas (00006, 00007, 00010) se vuelven a grabar con las rodillas y codos limpios.
    Todas empiezan y acaban en negro y pasan comprobar.py sin saltos.
    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
2026-10-30 Revisar 00004 como 00004.2: continuidad de moneda, golpes, encuadre y caída
2026-10-30 Animaciones 2D: muñeco de Laura y montaje común para el resto de personas
    personajes/comun: recortador (preparar.py), visor de hoja con rejilla (ver_hoja.py) y
    Personaje2D.crear (personaje.js) con la misma postura que Guillermo. Laura sale de su
    avatar 2D: melena que se balancea, aros que se mecen, manos con dedos y espejo para mirar
    a la izquierda. En Guillermo, p.espejo y mano.dedos son opcionales: sus escenas no cambian.
    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
2026-10-30 Animaciones 2D: README de Laura y del montaje común
    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
2026-10-30 Animaciones 2D: muñeco de Marcos Bombero
    Sale de su avatar 2D con el recortador común: casco, chaquetón con bandas reflectantes y
    botas. La manguera, la lanza y el chorro de agua van aparte para que cada escena los use.
    El montaje común gana opciones (limpieza previa de la hoja, manos en reposo) sin cambiar a
    Laura ni a Guillermo.
    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
2026-10-30 Animaciones 2D: rodajas en cuña de Guillermo con recorte ajustado
    Con p.tirasLimpias el recorte de cada rodaja usa un semiplano del ancho de la pieza (como
    Laura y Marcos) en vez de uno enorme: brazos y piernas mucho más baratos en la Raspberry.
    Las escenas que lo usan cambian en menos del 0,4 % de los píxeles, sin diferencia visible.
    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
2026-10-30 Revisar 00010 como 00010.2: brazos continuos y giro de manos delante del pecho
2026-10-30 Animaciones 2D: muñeco de Ander
    Sale de su avatar 2D con el recortador común: sudadera azul con capucha, barba y
    vaqueros. Nueva opción del recortador (ventana de la mandíbula) sin cambiar a los demás.
    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
2026-10-30 Animaciones 2D: 00016 «Guillermo y Laura · El truco de magia»
    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
2026-10-30 Animaciones 2D: recorte en cuña solo en las juntas que se doblan
    Las rodajas de tramos rectos ya encajan sin recortar; recortar solo codos, rodillas y
    melena ahorra un 25–35 % del tiempo por fotograma en las escenas con dos personajes.
    Diferencias de píxeles sueltos en los bordes, sin cambio visible.
    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
2026-10-30 Animaciones 2D: 00020 «Guillermo y Laura · Piedra, papel o tijera»
    Completa las diez escenas con Laura (00011–00020).
    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
2026-10-30 Animaciones 2D: muñeco de Carla
    Sale de su avatar 2D con el recortador común: melena ondulada que se balancea, top negro
    de tirantes, botines de tacón, y aros y collar que se mecen.
    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
2026-10-30 Animaciones 2D: 00022 «Guillermo y Marcos · El gato en la farola»
    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
2026-10-30 Animaciones 2D: 00023 «Guillermo y Marcos · La barra de bomberos»
    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
2026-10-30 Animaciones 2D: muñeco de Dari
    Sale de su avatar 2D con el recortador común: pelo rizado, bigote y perilla, parka beige
    y gafas dibujadas aparte para que los ojos se muevan debajo. El recortador gana opciones
    para borrar la montura sin cambiar a los demás.
    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
2026-10-30 Animaciones 2D: muñeco de Deivi
    Sale de su avatar 2D con el recortador común: pelo ondulado, camiseta lila de manga corta,
    vaqueros y zapatillas.
    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
2026-10-30 Animaciones 2D: 00030 «Guillermo y Marcos · La lona de salto»
    Completa las diez escenas con Marcos Bombero (00021–00030).
    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
2026-10-30 Animaciones 2D: 00033 «Guillermo y Ander · El duelo de miradas»
    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
2026-10-30 Animaciones 2D: muñeco de Gabacho
    Sale de su avatar 2D con el recortador común: pelo muy rizado, camiseta de fútbol azul
    marino tal cual del avatar, vaqueros y zapatillas. El recortador gana zonas de fondo
    blanco (huecos entre rizos) sin cambiar a los demás.
    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
2026-10-30 Animaciones 2D: 00037 «Guillermo y Ander · El abrazo de oso»
    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
2026-10-30 Animaciones 2D: muñeco de Kiriku
    Sale de su avatar 2D con el recortador común: polo negro con el jersey sobre los hombros
    y las gafas colgadas tal cual del avatar, vaqueros y zapatillas.
    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
2026-10-30 Revisar 00020 como 00020.2: apoyos, palmaditas y continuidad de la tarjeta
2026-10-30 Animaciones 2D: 00039 «Guillermo y Ander · El gol»
    Completa las diez escenas con Ander (00031–00040).
    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
2026-10-30 Revisar 00021 como 00021.2: brazos, vaso de leche y barrido de la manguera
2026-10-30 Revisar 00022 como 00022.2: rescate, apoyos y agarres de la escalera
2026-10-30 Animaciones 2D: muñeco de Marta
    Sale de su avatar 2D con el recortador común (la hoja se refleja porque mira a la
    izquierda): melena larga que se balancea, pinza de carey, chaqueta de punto gris,
    vaqueros y zapatillas. El recortador gana opciones (espejar, copiar, mosaico de punto)
    sin cambiar a los demás.
    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
2026-10-30 Animaciones 2D: muñeco de Paradigma
    Sale de su avatar 2D con el recortador común: pelo ondulado, bigote y perilla, cazadora
    negra abierta con camiseta blanca, vaqueros y zapatillas.
    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
2026-10-30 Animaciones 2D: 00050 «Guillermo y Carla · Las gafas de sol»
    Completa las diez escenas con Carla (00041–00050).
    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
2026-10-30 Animaciones 2D: muñeco de Rodri
    Sale de su avatar 2D con el recortador común: pelo alborotado, barba poblada, plumífero
    negro abierto, vaqueros y zapatillas.
    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
2026-10-30 Animaciones 2D: 00053 «Guillermo y Dari · El cubo de Rubik»
    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
2026-10-30 Animaciones 2D: fase de un tramo de longitud cero sin NaN
    M2.fase(t, a, a) daba NaN justo en t = a y ese fotograma salía roto; ahora es un
    escalón. No cambia ningún fotograma que antes se dibujara bien.
    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
2026-10-30 Animaciones 2D: muñeco de Sara Sáez
    Sale de su avatar 2D con el recortador común: melena larga negra que se balancea, top
    negro, cargo negro, pendientes de perla, aro en la nariz y collar con cruz que se mece.
    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
2026-10-30 Animaciones 2D: muñeco de Yorgi
    Sale de su avatar 2D con el recortador común: pelo corto con flequillo, barba, aros,
    camiseta marino de manga corta, reloj, vaqueros y zapatillas. Con él están ya todas las
    personas de la colección.
    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
2026-10-30 Animaciones 2D: 00057 «Guillermo y Dari · El dominó»
    Completa las diez escenas con Dari (00051–00060).
    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
2026-10-30 Animaciones 2D: 00064 «Guillermo y Deivi · El castillo de naipes»
    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
2026-10-30 Animaciones 2D: 00066 «Guillermo y Deivi · El globo de helio»
    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
2026-10-30 Animaciones 2D: 00067 «Guillermo y Deivi · La guerra de almohadas»
    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
2026-11-01 Antena 4G por dentro: ya no sobresale nada (los candados se quedan)
    - Fuera el AR9271, el alargo RP-SMA con su pasamuros y el agujero Ø6,5 del lateral derecho.
    - Módem 4G USB Huawei E3372h-320 (HiLink) en el USB de abajo de la Pi, con SIM de datos.
    - Antena plana FPC pegada dentro del cajón (lateral izquierdo) sobre policarbonato de 2 mm (A-S05);
    ventanas alineadas en carcasa (36 × 112, tapada por dentro con A-V03) y cajón (32 × 108).
    - Coaxial W26 todo dentro del cajón (latiguillo CRC9 → SMA): al sacar el cajón no se suelta nada.
    - Los dos topes de abajo a la izquierda pasan a la carcasa (en el cajón rozarían la ventana).
    - Regenerados STEP, DXF, FreeCAD, visor 3D, conexiones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
2026-11-01 Planos de la carcasa para pedir presupuesto (zip)
    44 piezas de acero (DXF de corte y STEP), conjunto, lista de piezas y nota en español e inglés.
    Se enlaza desde los correos de petición de presupuesto.
    Claude-Session: https://claude.ai/code/session_01EkRiGYFJpoSJoJNNCN7qgT
2026-11-02 Animaciones 2D: 00081 «Guillermo y Kiriku · Las gafas de sol»
    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
2026-11-02 Animaciones 2D: 00085 «Guillermo y Kiriku · La cata de vino»
    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
2026-11-02 Animaciones 2D: 00087 «Guillermo y Kiriku · El baile de salón»
    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
2026-11-02 Animaciones 2D: 00090 «Guillermo y Kiriku · La foto de grupo»
    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
2026-11-02 Animaciones 2D: 00097 «Guillermo y Marta · Bajo la lluvia»
    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
2026-11-02 Animaciones 2D: 00099 «Guillermo y Marta · El muñeco de nieve»
    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
2026-11-02 Animaciones 2D: 00100 «Guillermo y Marta · El baile en la cocina»
    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
2026-11-02 Animaciones 2D: 00108 «Guillermo y Paradigma · La partida de cartas»
    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
2026-11-02 Animaciones 2D: 00112 «Guillermo y Rodri · Las sillas de bar»
    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
2026-11-02 Animaciones 2D: 00109 «Guillermo y Paradigma · Los globos de agua»
    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
2026-11-02 Animaciones 2D: 00110 «Guillermo y Paradigma · La puesta de sol»
    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
2026-11-02 Animaciones 2D: 00113 «Guillermo y Rodri · El concurso de eructos»
    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
2026-11-02 Animaciones 2D: 00111 «Guillermo y Rodri · La guerra de pulgares»
    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
2026-11-02 Animaciones 2D: 00127 «Guillermo y Sara · El monopatín de noche»
    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
2026-11-02 Animaciones 2D: 00131 «Guillermo y Yorgi · El batido de proteínas»
    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
2026-11-02 Revisa 00024 individualmente: continuidad de manguera, agarres y reproducción; añade .2
2026-11-03 Carcasa de chapa plegada: 29 piezas de acero en vez de 44, con desarrollos y planos
    - chapa.py: chapa plegada (caras + pliegues de 90°, radio 1,5): sólido plegado, desarrollo, líneas de pliegue y DXF
    - Cuerpo en cruz (trasera, laterales y suelo), panel con pestañas, bandeja, apoyo y guías en ángulo
    - Tapa con sus faldones en una chapa; cajones en U con tabiques/frente/trasera con pestañas; caja de red en una chapa
    - planos_chapa.py: PDF con una hoja por pieza, DXF de desarrollos, STEP plegados y lista
    - presupuesto/Carcasa_plegada y Carcasa_alcoholimetro_plegada.zip (el zip de 44 chapas planas no se toca)
    - 0 choques, barridos limpios; antena 5 mm atrás, Solo 1,5 mm a la izquierda
    C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
2026-11-03 Documentar adhesivo transparente Permabond TA4204 para ventanas de carcasa
2026-11-03 Añadir Permabond TA4204 al índice de componentes de carcasa
2026-11-03 Revisión .2: separar tabique derecho de pajitas en los planos de plegado
2026-11-03 Documentar revisión Carcasa_plegada.2 y corrección del sentido de los tabiques
2026-11-03 Tabiques del cajón de pajitas simétricos: 4 piezas iguales de verdad
    La auditoría vio que el tabique derecho era el espejo de los otros tres
    y el plano los daba como iguales. La pestaña trasera empieza ahora a la
    misma altura que la delantera, así que el derecho es otro girado 180°.
    planos_chapa.py comprueba que las piezas que comparten código son la
    misma pieza girada (no espejo) y se para si no. Fuera planos_chapa.2.py
    y Carcasa_plegada.2. Paquete, zip, lista, visores y STEP regenerados.
    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
2026-11-03 Carcasa: toda la chapa de 1,5 mm pasa a 2 mm
    - Espesor y radio interior de 2 mm en todas las piezas que eran de 1,5; las de 3 mm siguen igual
    - Medidas exteriores iguales (220 × 100 × 442,5 mm); faldón de la tapa 1 mm más bajo
    - Cajón de componentes con los mismos 71 mm de fondo útil: holgura delantera 11,5 mm y trasera 9,5 mm
    - Solo 2 mm a la izquierda, Pi 2 mm a la derecha, fuente y caja de red 2,5 mm a la derecha y fuente 1,5 mm más arriba
    - Planos, DXF, STEP, zip para talleres, lista de piezas, visor 3D y STEP de FreeCAD regenerados
    - 0 choques, barridos limpios, cables con los 5 avisos de siempre y conexiones con 0 errores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
2026-11-03 Carcasa A: actualizar anclaje a SX Plus 8x65 y tirafondos 6x80
    Actualizar especificación H14/H16, profundidades de taladro, notas CAD/BOM, decisión de diseño y guía de instalación; conservar patrón de 18 orificios. Invalidar ASINs/precios antiguos hasta verificar nuevos productos.
2026-11-03 Carcasa A: informe de cálculo del patrón de anclaje a pared
    Nueva carpeta carcasa/diseno-A/calculo-anclajes con el informe de metodología
    (README.md), el informe técnico en PDF, las coordenadas del patrón propuesto
    Óptimo P18-O (CSV), las figuras, el código Python y los resultados para
    reproducir el cálculo. No se modifica ningún archivo existente: el patrón
    vigente de diseno.py y de los DXF sigue igual.
    Claude-Session: https://claude.ai/code/session_01EkRiGcVcA7LkahYGmGYpWA
2026-11-04 Carcasa A: chapa de 3 mm (cajón y tapa interior de 1,5) y patrón de anclaje P18-3
    - Carcasa, tapa, bandeja, cajón de pajitas y soportes en DC01 de 3 mm;
    cajón de componentes (K01, K02, K03, K06) y tapa interior (T01) en 1,5 mm.
    Medidas por fuera iguales (220 x 100 x 442,5 mm).
    - Cambios para poder plegar con 3 mm: guías traseras y apoyo de la tapa
    interior pasan a pletinas planas, pestaña de arriba del panel de 12 mm con
    muescas, tabiques del cajón de pajitas con pestañas de 12, repisa del Solo
    con pliegue a tramos, ranura de la leva más larga, policarbonato interior
    más estrecho, cables retocados.
    - Regenerados STEP, DXF, planos, lista de piezas, visor 3D, STEP de Free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
2026-11-04 Revisar 00030.2 · Guillermo y Marcos - la lona de salto
2026-11-04 Revisar 00031.2 · Guillermo y Ander - el futbolin
2026-11-04 Revisar 00032.2 · Guillermo y Ander - la guindilla
2026-11-04 Revisar 00033.2 · Guillermo y Ander - el duelo de miradas
2026-11-04 Revisar 00034.2 · Guillermo y Ander - el bigote
2026-11-04 Revisar 00035.2 · Guillermo y Ander - el billar
2026-11-04 Revisar 00036.2 · Guillermo y Ander - la maquina del gancho
2026-11-04 Revisar 00081.2 · Guillermo y Kiriku - las gafas de sol
2026-11-04 Revisar 00037.2 · Guillermo y Ander - el abrazo de oso
2026-11-04 Revisar 00038.2 · Guillermo y Ander - el beer pong
2026-11-04 Revisar 00082.2 · Guillermo y Kiriku - el selfie de postureo
2026-11-04 Revisar 00039.2 · Guillermo y Ander - el gol
2026-11-04 Revisar 00083.2 · Guillermo y Kiriku - el yate
2026-11-04 Revisar 00040.2 · Guillermo y Ander - la guitarra
2026-11-04 Revisar 00084.2 · Guillermo y Kiriku - el jersey
2026-11-04 Revisar 00085.2 · Guillermo y Kiriku - la cata de vino
2026-11-04 Revisar 00041.2 · Guillermo y Carla - la pasarela
2026-11-04 Revisar 00086.2 · Guillermo y Kiriku - el peine
2026-11-04 Revisar 00087.2 · Guillermo y Kiriku - el baile de salon
2026-11-04 Verificar el visor 2D en Chromium y corregir la carga de avatares y del peine
2026-11-04 Revisar 00088.2 · Guillermo y Kiriku - el reloj caro
2026-11-04 Revisar 00089.2 · Guillermo y Kiriku - el descapotable
2026-11-04 Revisar 00090.2 · Guillermo y Kiriku - la foto de grupo
2026-11-04 Revisar 00091.2 · Guillermo y Marta - el cafe con arte
2026-11-04 Revisar 00092.2 · Guillermo y Marta - la bufanda
2026-11-04 Revisar 00093.2 · Guillermo y Marta - el libro
2026-11-04 Revisar 00094.2 · Guillermo y Marta - la pinza del pelo
2026-11-04 Revisar 00095.2 · Guillermo y Marta - el gato
2026-11-04 Revisar 00096.2 · Guillermo y Marta - las palomitas de maiz
2026-11-04 Revisar 00097.2 · Guillermo y Marta - el paraguas compartido
2026-11-04 Revisar 00098.2 · Guillermo y Marta - el puzle
2026-11-04 Revisar 00099.2 · Guillermo y Marta - el muneco de nieve
2026-11-04 Revisar 00100.2 · Guillermo y Marta - el baile en la cocina
2026-11-04 Revisar 00101.2: acompasar batería, lámpara y caída de Paradigma
2026-11-04 Revisar 00102.2: dar continuidad al salto, las ruedas y los agarres de la moto
2026-11-04 Revisar 00103.2: encuadrar los vuelcos y sincronizar la mosca, el halo y el globo
2026-11-04 Revisar 00104.2: completar la vuelta de la peluca y mantener los dos vuelos en plano
2026-11-04 Revisar 00105.2: sincronizar los cuatro rebotes del vinilo y la aguja del tocadiscos
2026-11-04 Revisar 00106.2: coordinar las cinco vueltas, la entrega de las pinzas y el bocado
2026-11-04 Revisar 00107.2: sincronizar el falso espejo y despejar el travesaño al cruzar
2026-11-04 Revisar 00108.2: enlazar las cartas, igualar la apuesta y apoyar la cara en el tapete
2026-11-04 Revisar 00109.2: enlazar los globos, el paso junto al pelo y el agua que vuelve
2026-11-04 Revisar 00110.2: vuelo ante el sol y traspaso de las patatas
2026-11-04 Revisar 00111.2: los tres choques, la trampa y el golpe en la frente
2026-11-04 Revisar 00112.2: agarres, apoyos y continuidad de la salida del taburete
2026-11-04 Revisar 00113.2: continuidad de los botellines, expresiones y caída del cuadro
2026-11-04 Revisar 00114.2: agarre del cubo, contacto en la puerta y llegada del agua
2026-11-04 Revisar 00115.2: enlazar el pino, las manos y el vuelco de la caña
2026-11-04 Revisar 00116.2: enlazar la aceituna, los palillos y el plumón
2026-11-04 Revisar 00117.2: coordinar pelotas, latas y el peluche en la feria
2026-11-04 Revisar 00118.2: enlazar el balanceo, la bajada y el empujón
2026-11-04 Revisar 00119.2: enlazar el paquete, el globo y la careta de chicle
2026-11-04 Revisar 00120.2: contacto de las jarras, caída de espuma y parpadeos
2026-11-04 Revisar 00121.2: trazos del tatuaje, manga y contactos de la bandeja
2026-11-04 Revisar 00122.2: pasos, latigazo y corrección del gesto en el concierto
2026-11-04 Revisar 00123.2: delineado, reflejos y apoyos en el camerino
2026-11-04 Revisar 00124.2: pestillo, manta y captura en la tormenta
2026-11-04 Revisar 00125.2: apoyo en el cojín, palmadas y gota en la mejilla
2026-11-04 Revisar 00128.2: gota picante, mordiscos y contacto con el cartón de leche
2026-11-04 Revisar 00129.2: ajustar el taconazo, el humo y el rescate por el tupé
2026-11-04 Revisar 00130.2: conservar el cable de los auriculares y ajustar la devolución
2026-11-04 Revisar 00131.2: corregir el trago, los lanzamientos y los contactos del batido
2026-11-04 Revisar 00132.2: ajustar los apoyos, la caída y las flexiones a caballito
2026-11-04 Revisar 00133.2: fijar el reloj a la correa y completar los contactos de Llegas tarde
2026-11-04 Revisar 00135.2: enlazar los aros, el vuelo, el clip y su reflejo
2026-11-04 Revisar 00136.2: tensar el cordón, apoyar la barbilla y sincronizar la puerta del bar
2026-11-04 Revisar 00137.2: sujetar el abrazo, pulsar la luz y apagar las cinco velas al contacto
2026-11-04 Revisar 00138.2: completar los giros y ajustar agarres, apoyo y compresión de la mancuerna
2026-11-04 Revisar 00139.2: sostener las gafas y la servilleta, asentar las tumbonas y sincronizar las pompas
2026-11-04 Revisar 00140.2: fijar el aterrizaje, el disparador y la caída de la manga en el selfie
2026-11-04 Revisar 00042.2: coordinar los dos sorbos, el peine y la entrega de la margarita
2026-11-04 Revisar 00043.2: completar el paso bajo el limbo, el giro y los apoyos del listón
2026-11-13 Ordenar la raíz: montajes del 20-10 a historico/ y zips de auditorías a auditorias/zips/
    Paso 0 del encargo del 13-11-2026. Cambio mecánico, sin tocar contenido:
    - MONTAJE-GENERAL.md y MONTAJE-PASO-A-PASO.md pasan a historico/. Siguen el
    diseño del 20-10-2026; el cableado vigente llega en el commit siguiente.
    - Los ocho zips de auditorías de la raíz pasan a auditorias/zips/.
    - 92 enlaces relativos reescritos en 8 archivos para que sigan apuntando a
    su destino. Comprobado antes y después: 2689 enlaces relativos, 0 rotos.
    Claude-Session: https://claude.ai/code/session_01EkRiGaEyHbu59RJgwqvHcL
2026-11-13 Bloque 1: componentes eléctricos revisados, cableado único y lista de compra única
    Revisión de todos los componentes del diseño A (componentes/REVISION-13-11-2026.md,
    con sus cuentas en componentes/cuentas.py). Es papel y cálculo: nada medido.
    Documentos que pasan a mandar:
    - CABLEADO.md: única tabla de cableado, valores únicos y cuentas.
    - LISTA-DE-COMPRA.md: única lista de compra (la del 20-10 pasa a historico/).
    - DECISIONES.md: entradas del 13-11-2026 (rama única y componentes).
    - README.md general reescrito; historico/ con aviso en cada documento.
    Cambios de diseño:
    - La Pi se alimenta por una placa de bornes atornillada al GPIO (59 mΩ en la
    rama en vez de 115; 4,98 V en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
2026-11-13 DECISIONES: anotar la rama paso-0-fusion entre las que hay que borrar
    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
2026-11-13 Estudio térmico del diseño A: informe, modelo y resultados
    Carpeta nueva carcasa/diseno-A/estudio-termico/. No toca ningún archivo
    existente.
    - Informe en PDF (31 páginas): calentamiento interior, temperatura que
    aguanta cada pieza, ventilación forzada, averías, sol, funda, frío,
    cambios recomendados y plan de ensayo.
    - Modelo de 57 nodos en codigo/termico.py y scripts que generan los
    resultados, las figuras y el PDF.
    - Resultado: el diseño actual deja el aire junto al SumUp Solo a +31 K
    sobre el bar (límite 40 °C); con dos ventiladores de 40 mm, a +2 K.
    - Todo es cálculo: nada medido ni aplicado todavía al CAD.
    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
2026-11-13 Estudio térmico, revisión 2: con el myPOS Sigma y fuente de 12 V
    Rehace el estudio de carcasa/diseno-A/estudio-termico/ cambiando el
    SumUp Solo por el myPOS Sigma (opción 3 del estudio de cobro) en un
    hueco del frente, con una LRS-50-12 y un convertidor de 12 a 5 V.
    No toca ningún archivo fuera de esa carpeta.
    - termico.py: nodo nuevo para el terminal (sigma=True); con sigma=False
    es el modelo de la revisión 1 y da sus mismos números.
    - analisis_conf.py: cargas y configuraciones con el Sigma, cuatro formas
    de dar los 12 V y la versión del Solo para comparar.
    - Informe nuevo (35 páginas), figuras y resultados regenerados.
    - historico-solo/: el PDF de la revisión 1.
    Resultado: e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
